18871379330/mydexhand/图片/yesplus.jpg

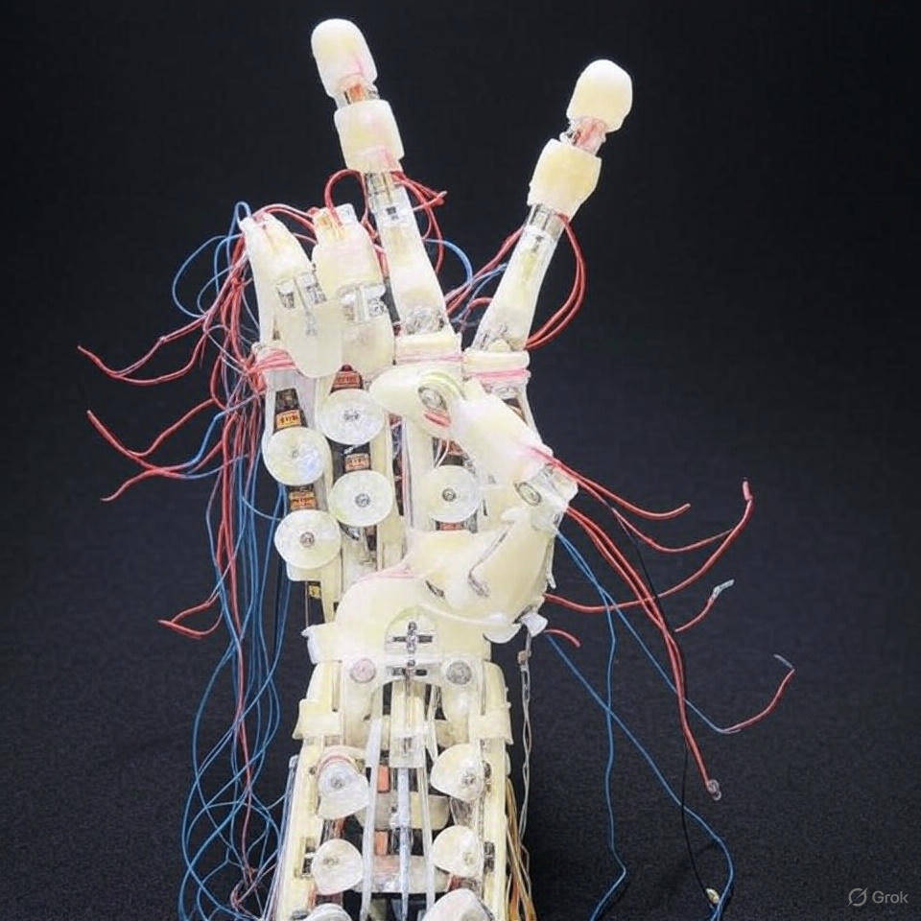
图片/yesplus.jpg
