18871379330/mydexhand/报销/毕设/1.24_螺母.pdf

# 电子发票（普通发票） 发票号码： 开票日期：

购
买
方
信
息

统一社会信用代码/纳税人识别号：

销
售
方
信
息

统一社会信用代码/纳税人识别号：

名称： | 名称：
项目名称 | 规格型号 | 单 位 | 数 量 | 单 价 | 金 额 | 税率/征收率 | 税 额
合 | 计
价税合计（大写） | 壹圆贰角肆分 ¥1.24 （小写）
备 注 | 4303056963364002740

开票人：

25322000000188732096

2025年04月26日

东南大学

12100000466006770Q

兴化市茂通金属制品有限公司

## 91321281MAE7RX1B27

¥1.23 | ¥0.01

陈怡彤

*金属制品*不锈钢螺母 M10对边
16mm【10
粒】304材质
件 | 1 | 1.23 | 1.23 | 1% | 0.01
