18871379330/mydexhand/报销/毕设/11.96_电线.pdf

# 电子发票（普通发票） 发票号码： 开票日期：

购
买
方
信
息

统一社会信用代码/纳税人识别号：

销
售
方
信
息

统一社会信用代码/纳税人识别号：

名称： | 名称：
项目名称 | 规格型号 | 单 位 | 数 量 | 单 价 | 金 额 | 税率/征收率 | 税 额
合 | 计
价税合计（大写） | 壹拾壹圆玖角陆分 ¥11.96 （小写）
备 注 | 收款人:黄晓如; 复核人:侯铠涛;

开票人：

25952000000064161759

2025年04月05日

东南大学

12100000466006770Q

深圳市福田区康威芯电子商行

## 92440300MA5ERA0T06

¥11.84 | ¥0.12

黄晓如

*电子元件*电子元件 20AWG 硅胶连
接线
件 | 2 5.9207920792079 | 11.84 | 1% | 0.12
