18871379330/mydexhand/报销/毕设/29_游标卡尺.pdf

# 电子发票（普通发票） 发票号码： 开票日期：

购
买
方
信
息

统一社会信用代码/纳税人识别号：

销
售
方
信
息

统一社会信用代码/纳税人识别号：

名称： | 名称：
项目名称 | 规格型号 | 单 位 | 数 量 | 单 价 | 金 额 | 税率/征收率 | 税 额
合 | 计
价税合计（大写） | 贰拾玖圆整 ¥29.00 （小写）

备 注

开票人：

25332000000143532861

2025年04月10日

东南大学

12100000466006770Q

义乌茂丰网络科技有限公 司

## 91330782MADURCG855

¥28.71 | ¥0.29

张静静

*金属制品 *五金工具 【省电保护
款】-不锈钢数
显卡尺0-150mm,
超速芯片）
套 | 1 28.7128712871287 | 28.71 | 1% | 0.29
