18871379330/mydexhand/报销/毕设/34.09_双面胶.pdf

# 电子发票（普通发票） 发票号码： 开票日期：

购
买
方
信
息

统一社会信用代码/纳税人识别号：

销
售
方
信
息

统一社会信用代码/纳税人识别号：

名称： | 名称：
项目名称 | 规格型号 | 单 位 | 数 量 | 单 价 | 金 额 | 税率/征收率 | 税 额
合 | 计
价税合计（大写） | 叁拾肆圆零玖分 ¥34.09 （小写）

备 注

开票人：

25312000000136466476

2025年05月06日

东南大学

12100000466006770Q

上海网涵电子科技有限公司

91310114342024109Y

¥30.17 | ¥3.92

丁敏兰

*密封用填料*双面胶 | 50MM*100MM | 片 | 10 3.016814159292 | 30.17 | 13% | 3.92
