18871379330/mydexhand/专利修改/专利图片.pptx

1-5

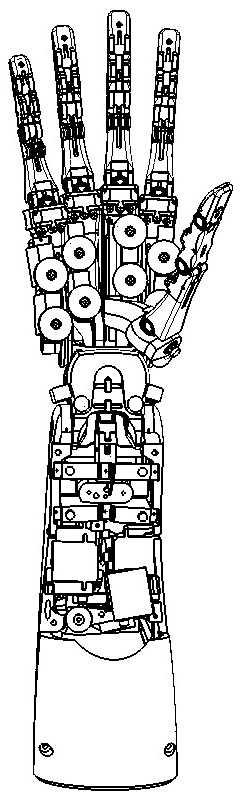
[picture p52: figure]
卡通人物 AI 生成的内容可能不正确。

1

2

3

5

4

## Slide 2

6-15

11

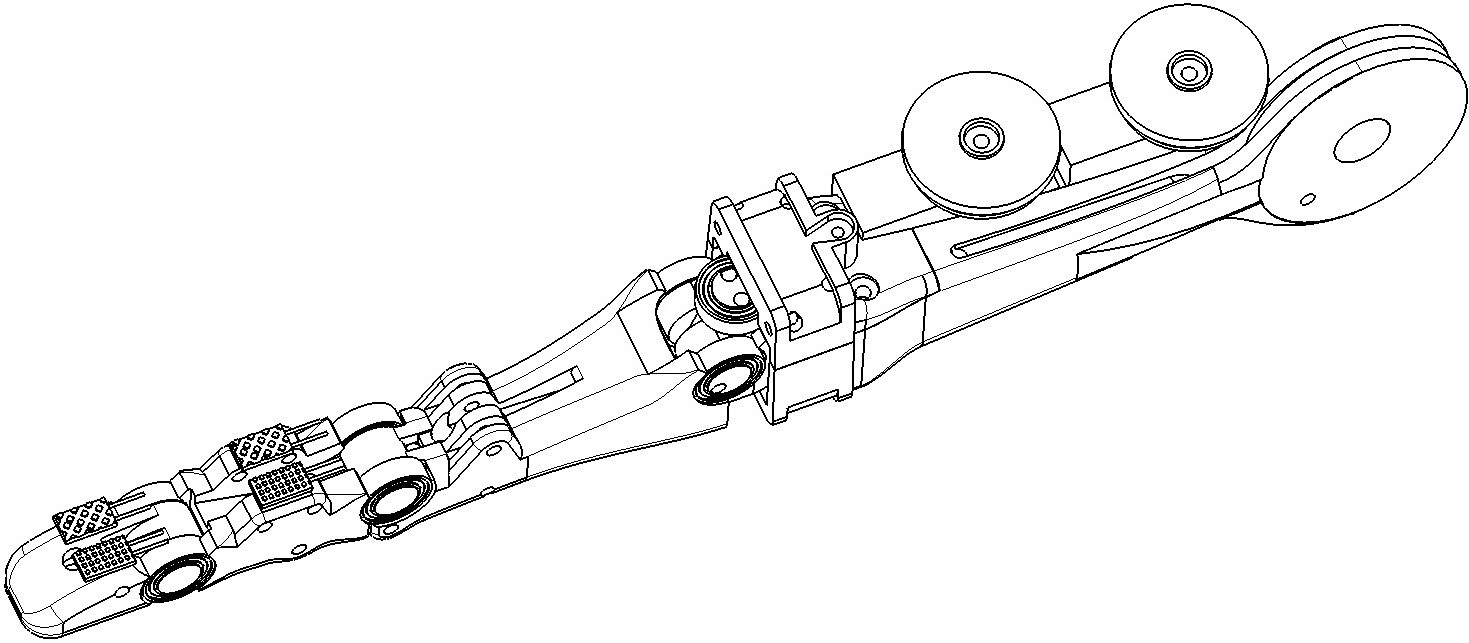
[picture p53: figure]
图示, 工程绘图 AI 生成的内容可能不正确。

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
## Slide 3

16-18

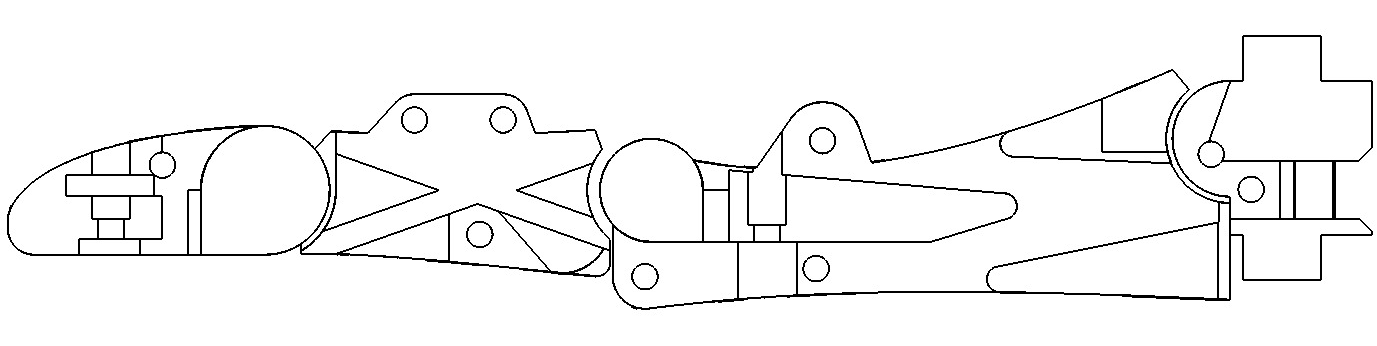
[picture p54: figure]
图示, 工程绘图 AI 生成的内容可能不正确。

16

17

18

## Slide 4

16

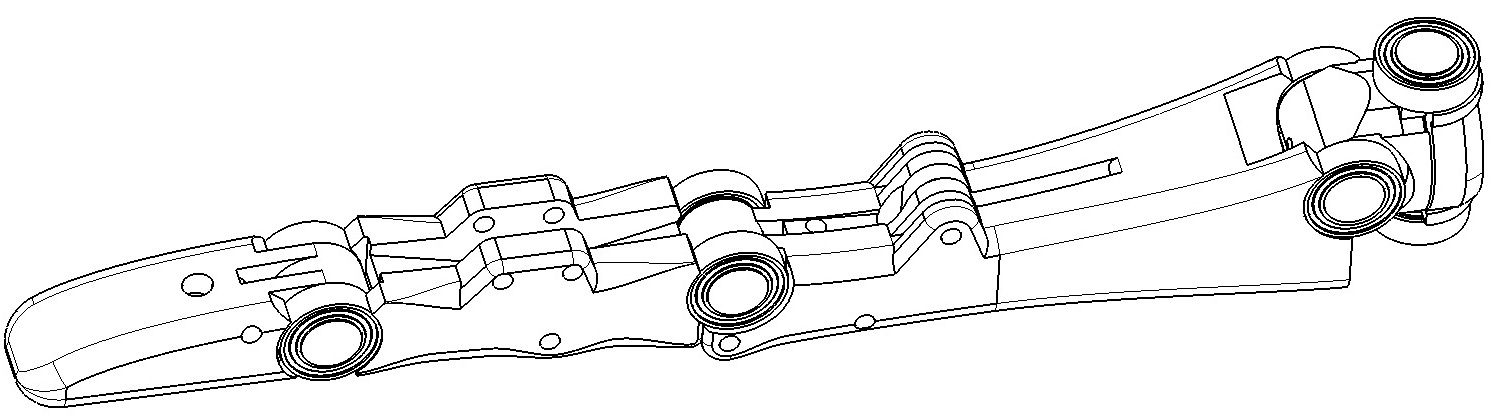
[picture p55: figure]
图示 AI 生成的内容可能不正确。

8

19

6

7

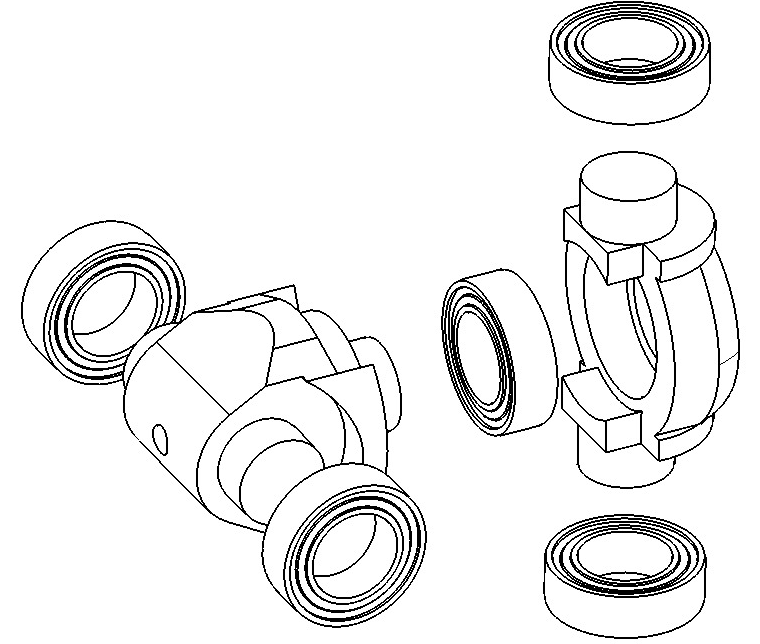
[picture p56: figure]
卡通人物 AI 生成的内容可能不正确。

20

21

## Slide 5

17

9

22

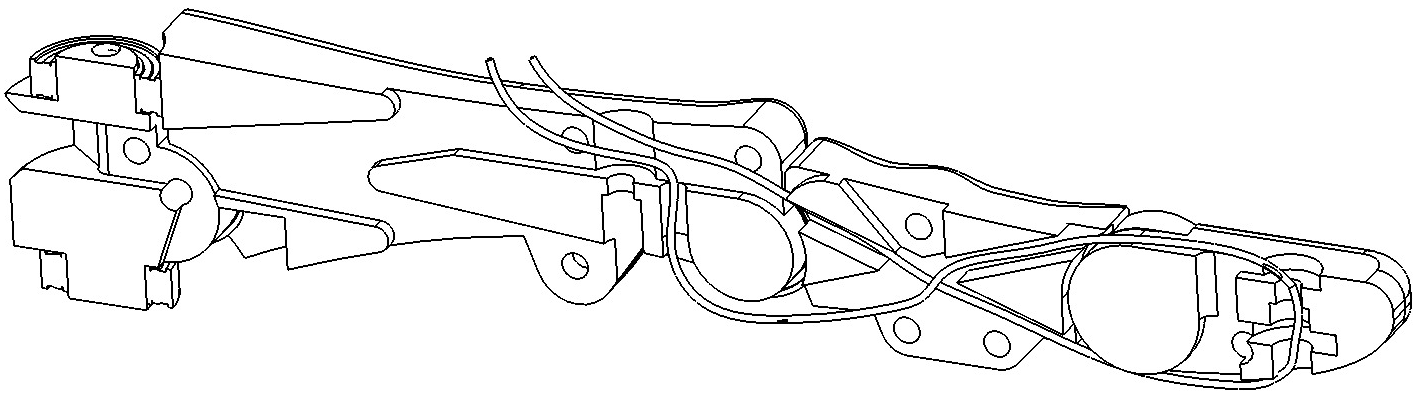
[picture p57: figure]
图示, 示意图 AI 生成的内容可能不正确。

8

7

6

八字绳固定处

## Slide 6

18-20

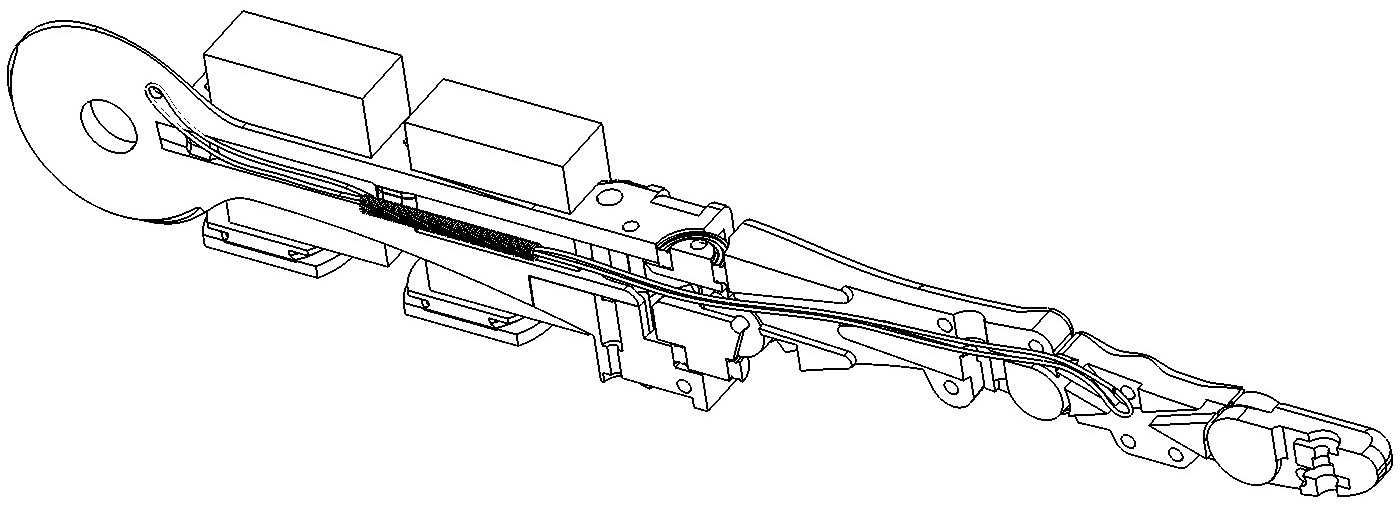
[picture p58: figure]
图示 AI 生成的内容可能不正确。

25

24

23

## Slide 7

21

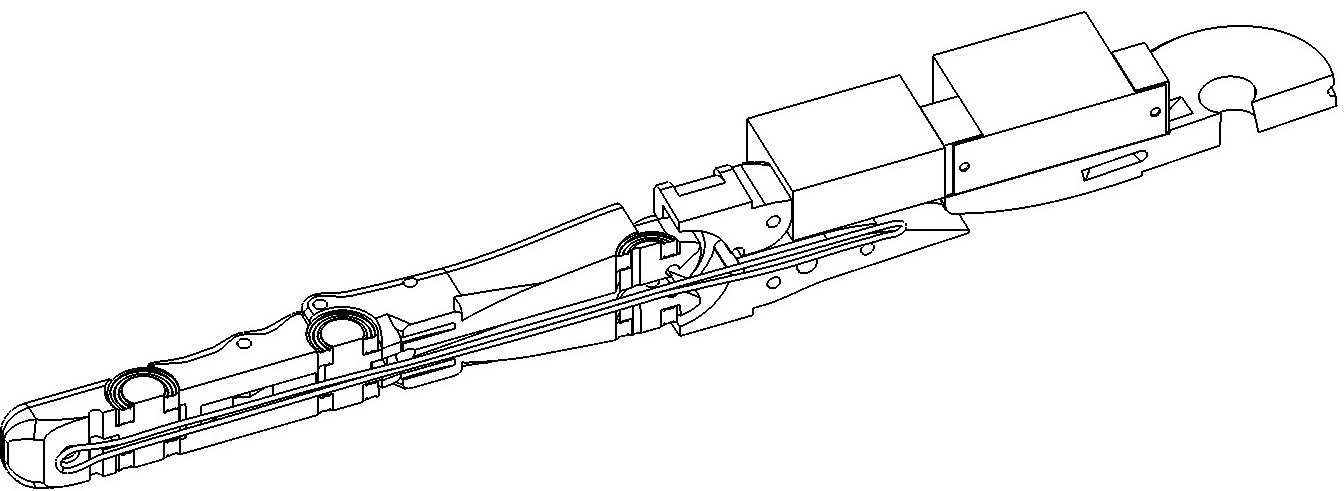
[picture p59: figure]
图示, 工程绘图 AI 生成的内容可能不正确。

26

舵机牵引

## Slide 8

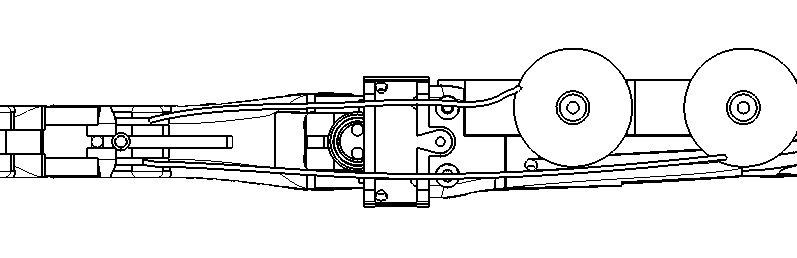
[picture p60: figure]
图示, 工程绘图 AI 生成的内容可能不正确。

27

## Slide 9

22-25

29

30

31

28

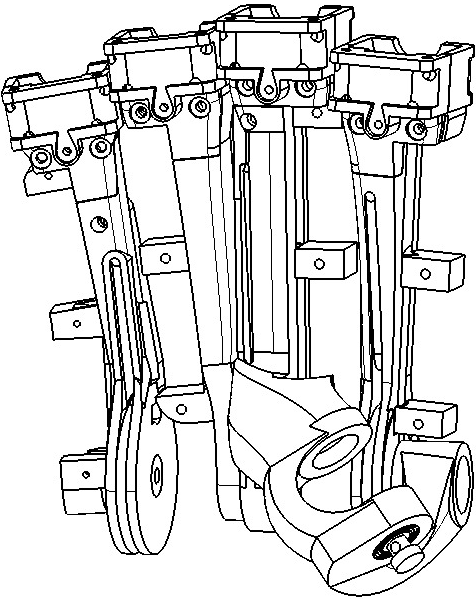
[picture p61: figure]
图示 AI 生成的内容可能不正确。

## Slide 10

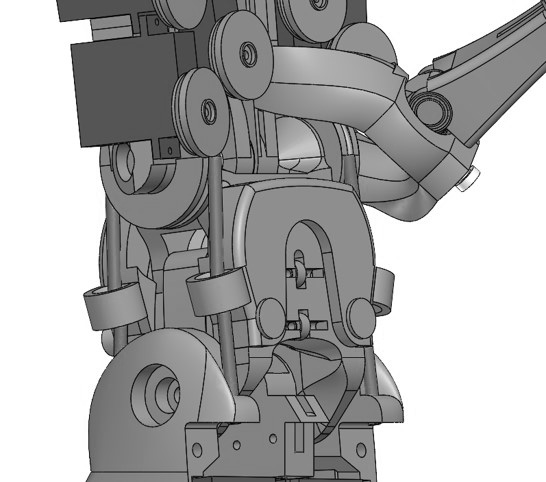
[picture p62: figure]
卡通人物 AI 生成的内容可能不正确。

32

## Slide 11

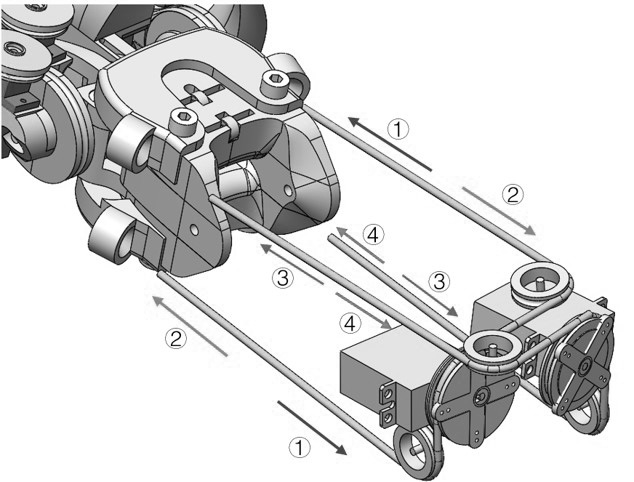
[picture p63: figure]
图示, 工程绘图 AI 生成的内容可能不正确。

32

## Slide 12

33

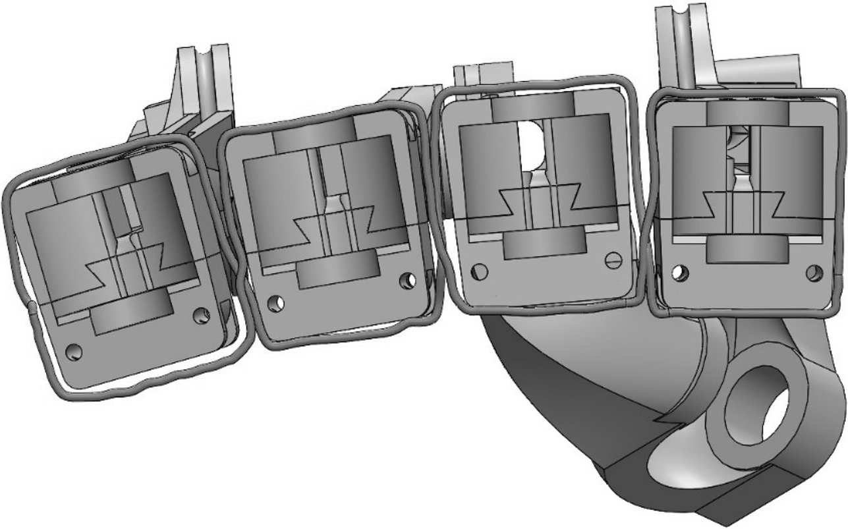
[picture p64: figure]
图片包含 游戏机, 棒球, 体育 AI 生成的内容可能不正确。

## Slide 13

26

34

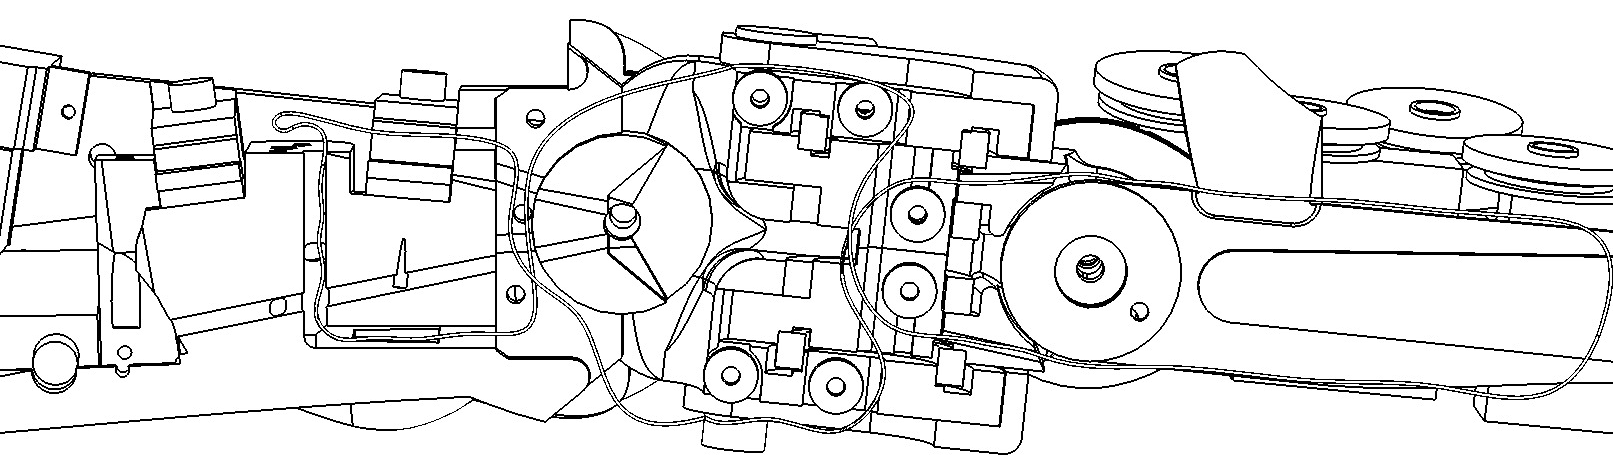
[picture p65: figure]
图示 AI 生成的内容可能不正确。

5

4

2

## Slide 14

27-29

35

35

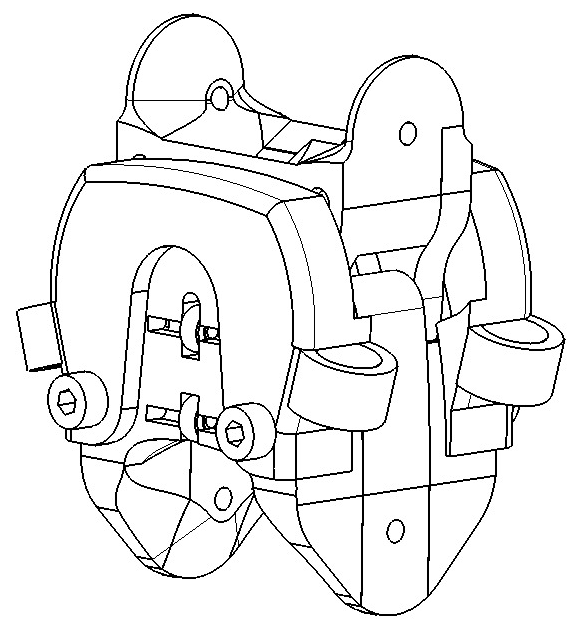
[picture p66: figure]
卡通人物 AI 生成的内容可能不正确。
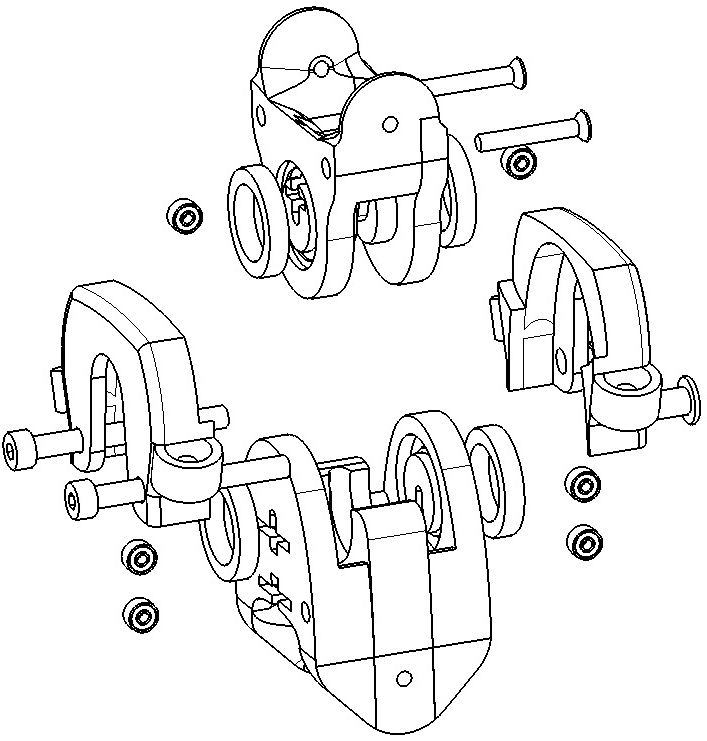
[picture p67: figure]
图示 AI 生成的内容可能不正确。

37

37

36

36

## Slide 15

30-32

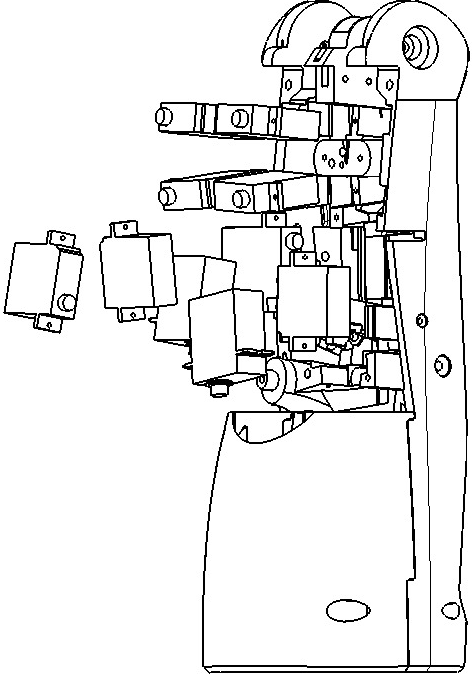
[picture p68: figure]
图示, 工程绘图 AI 生成的内容可能不正确。

38

39

40

## Slide 16

## Slide 17

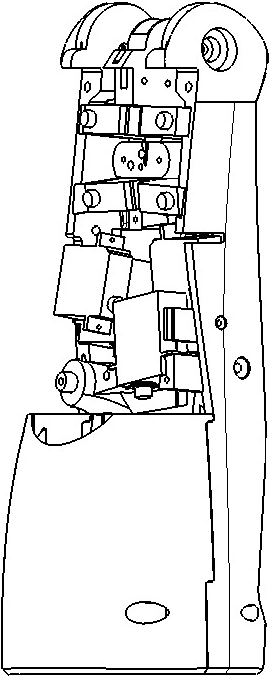
[picture p69: figure]
图示, 工程绘图 AI 生成的内容可能不正确。

## Slide 18

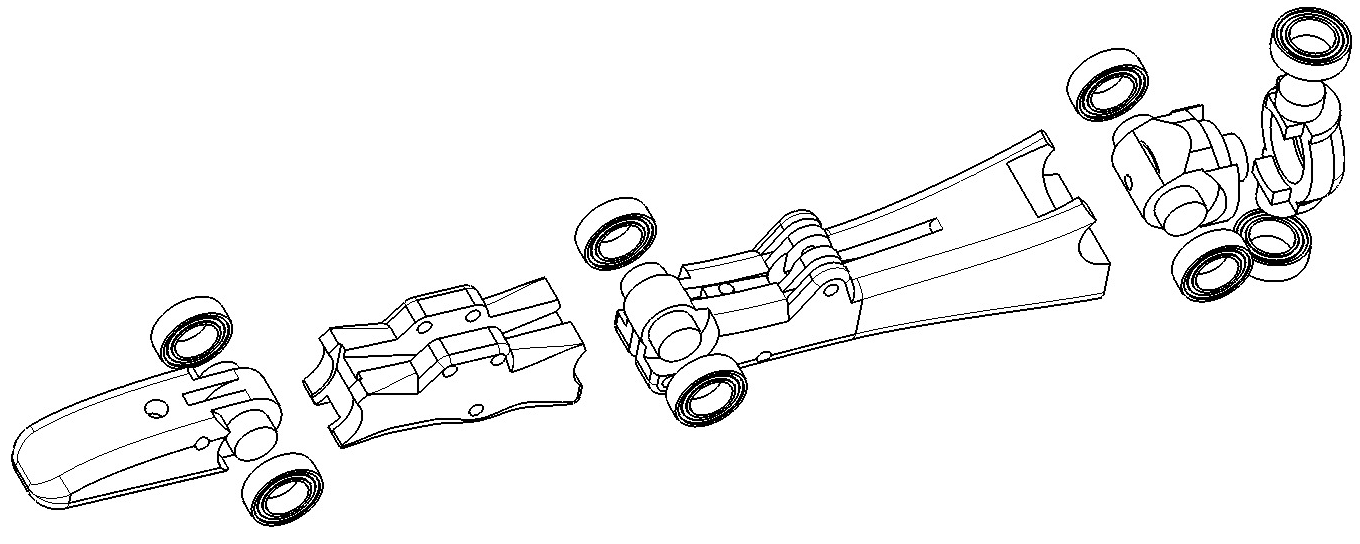
[picture p70: figure]
图示 AI 生成的内容可能不正确。

## Slide 19

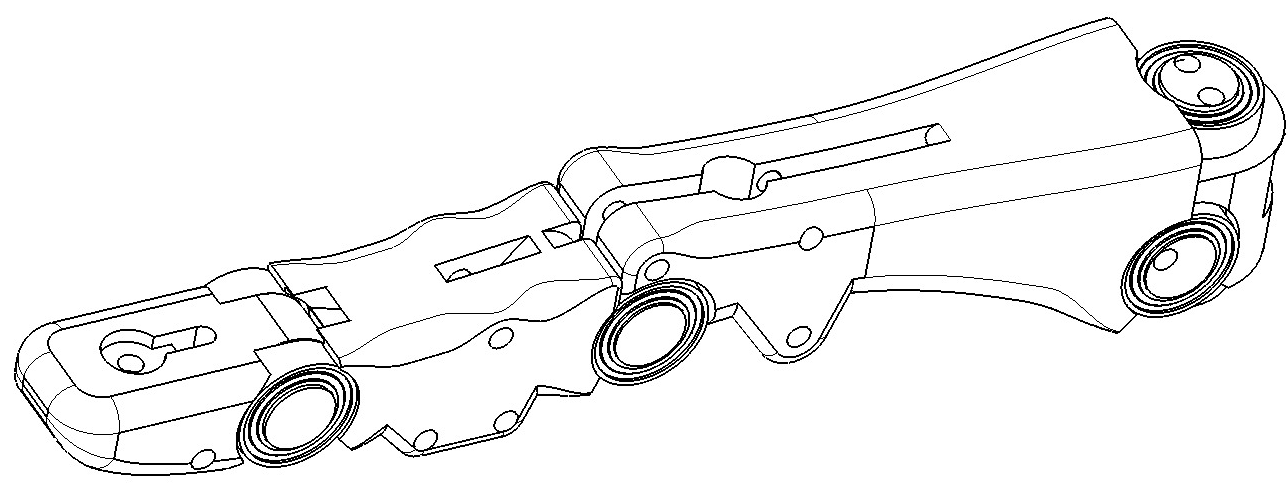
[picture p71: figure]
图片包含 链, 游戏机, 项链, 画 AI 生成的内容可能不正确。

## Slide 20

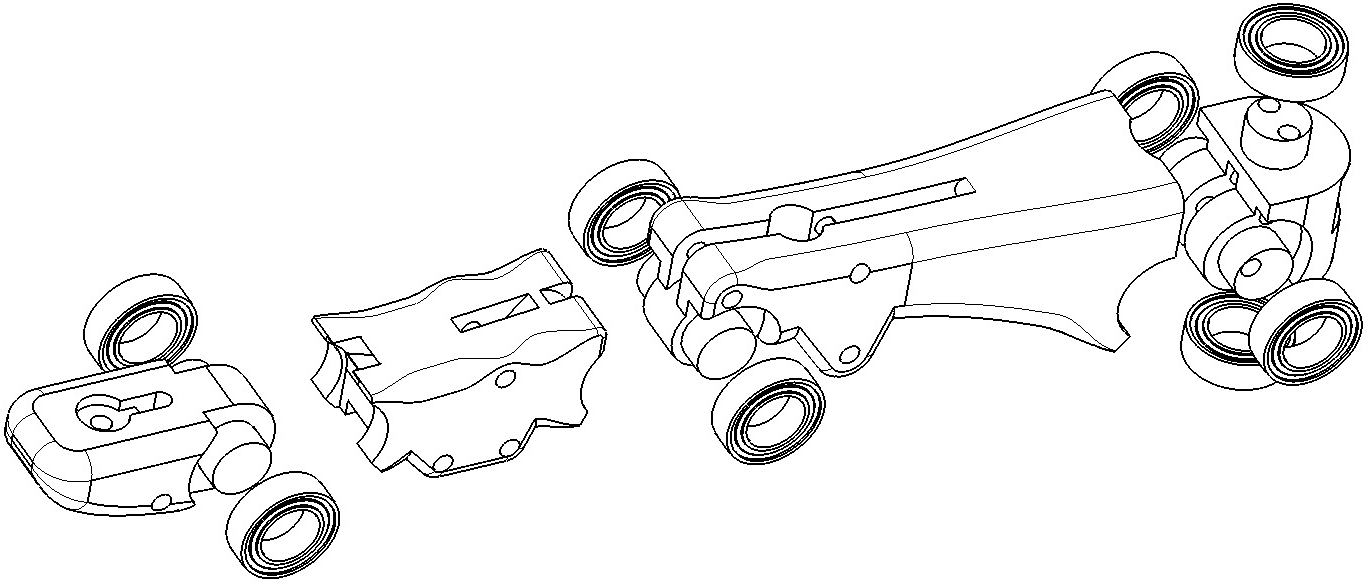
[picture p72: figure]
图示 AI 生成的内容可能不正确。

## Slide 21

## Slide 22

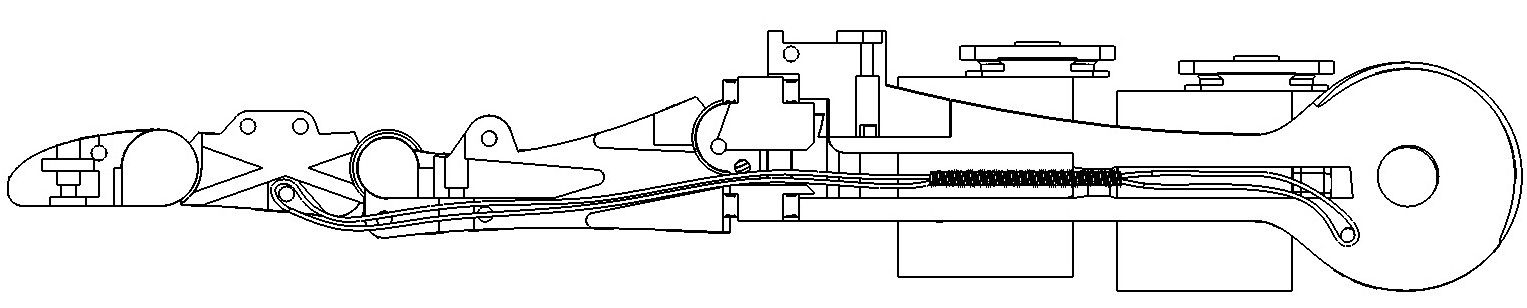
[picture p73: figure]
图示, 工程绘图 AI 生成的内容可能不正确。

18

19

20

## Slide 23

10

13

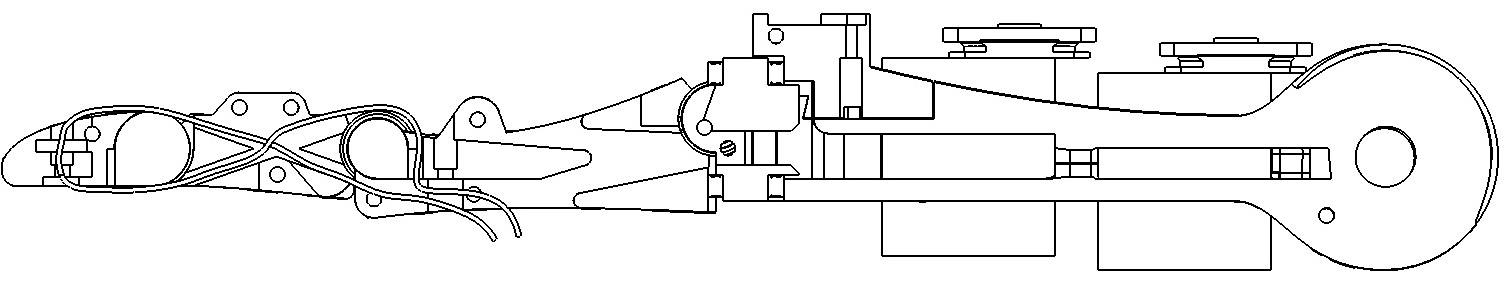
[picture p74: figure]
图示 AI 生成的内容可能不正确。

6

7

8

9

17

11
