18871379330/mydexhand/精雕杯/附件2：毕业设计案例参考格式.docx

毕业设计大赛案例参考格式

页面设置标准A4纸，页边距上下各4cm，左右各3cm，所有数字及英文用Times New Roman字体。文中表题用小5号黑体居中排列，表格内容用小5号宋体，图题用小5号体居中排列，其它标注小5号宋体。其余格式参照下页模板。

作品名称 （段前空1行，左对齐，3号方正小标宋_GBK，字符间距加宽1磅）

作者姓名 （小5号方正仿宋_GBK，段前空1行）

单位 专业 （小5号方正仿宋_GBK）

1. 设计目的 （首行缩进2个字符，段前段后0.25行，13号方正黑体_GBK）

正文*****（首行空2个字符 ，5号宋体）

2. 基本原理及方法

正文****

3. 主要设计过程或试验过程

正文****

1）分层注射模具的设计与分析 （首行缩进2个字符，5号方正楷体_GBK加粗）

4. 结论

5. 创新点

6. 设计图或作品实物图

高校指导教师： 企业指导教师：*** （段前空2行，5号方正楷体_GBK）

参考案例：

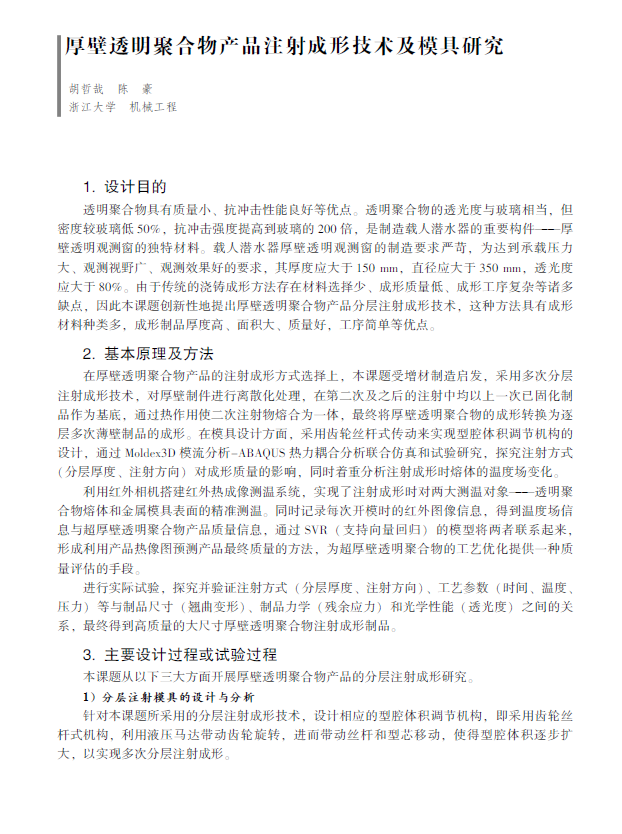
[picture p76: figure]
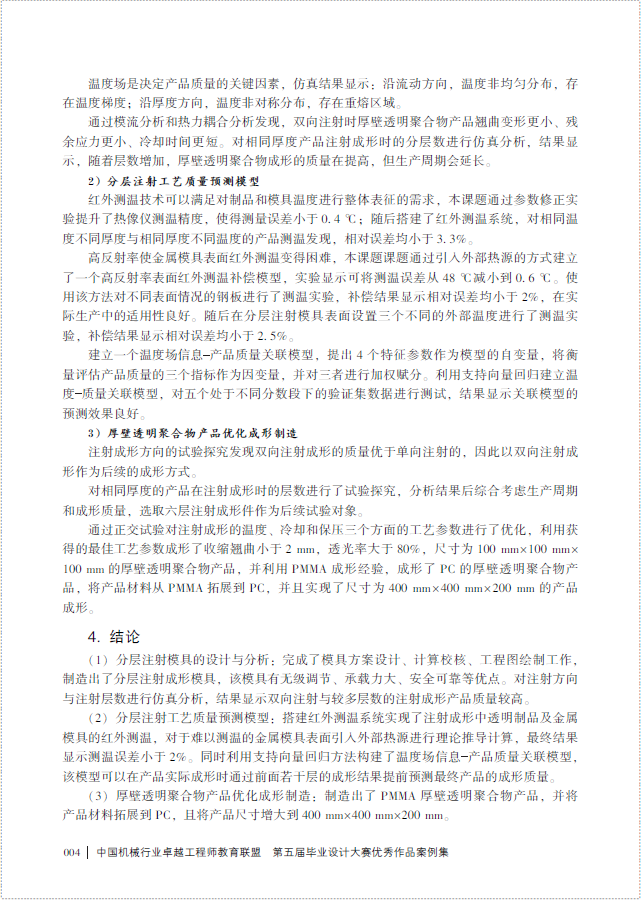
[picture p77: figure]
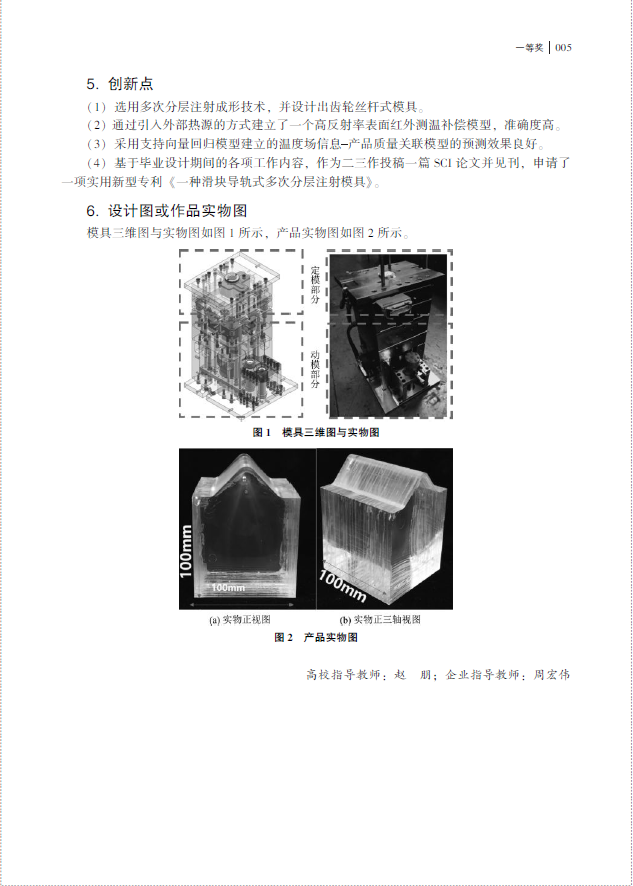
[picture p78: figure]
