18871379330/mydexhand/图片/PPT图片/PPT图片.pptx

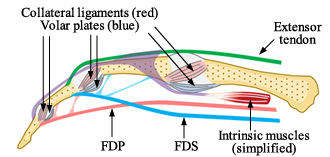
[picture p79: figure]
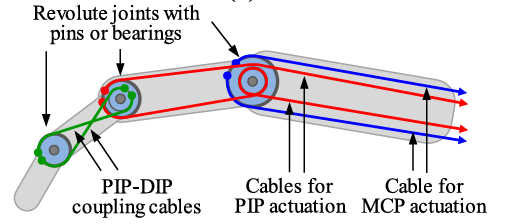
[picture p80: figure]

## Slide 2

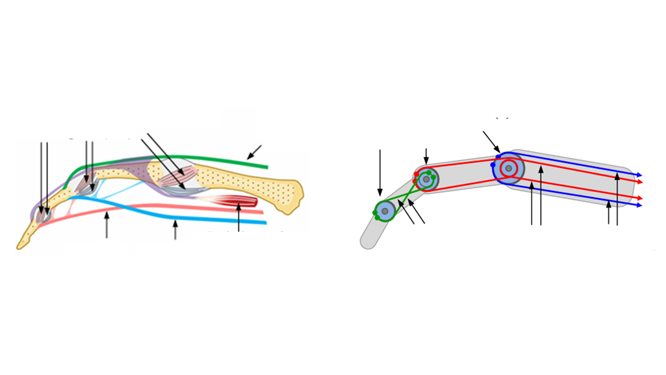
[picture p81: figure]
图示 AI 生成的内容可能不正确。

副韧带（红色）
掌板（蓝色）

深指屈肌腱

浅指屈肌腱

内在肌

## Slide 3

紧固处

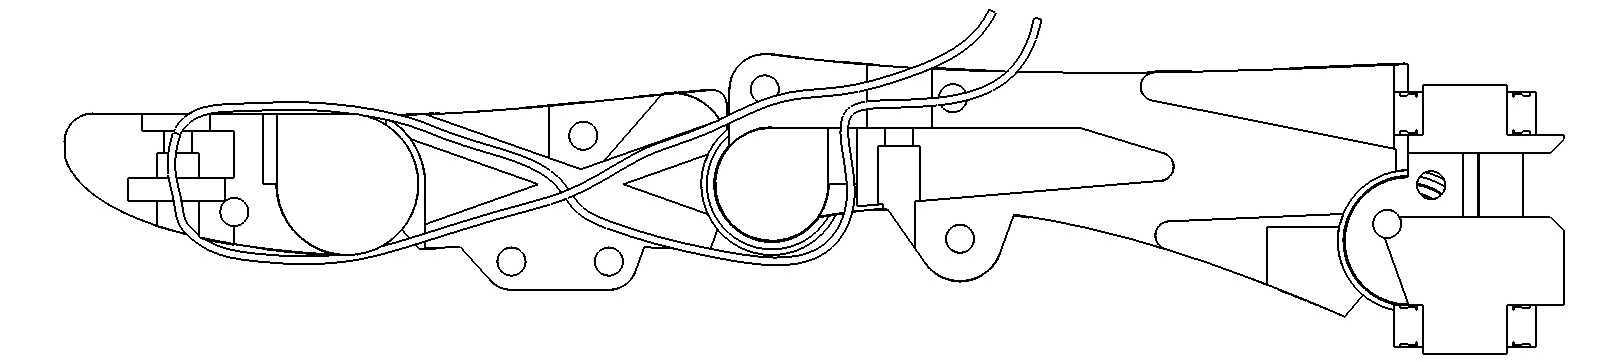
[picture p82: figure]
图示, 示意图 AI 生成的内容可能不正确。

八字绳结构

## Slide 4

回弹牵引绳

回复弹簧

弹簧固定绳

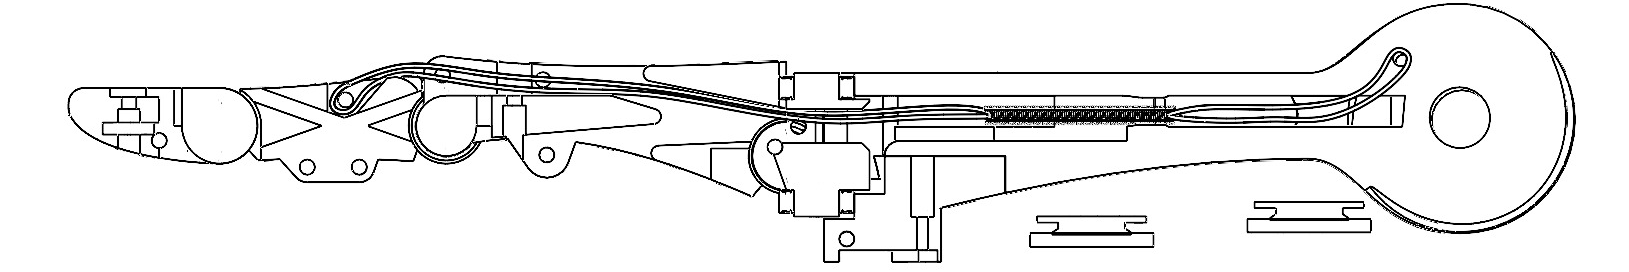
[picture p83: figure]
图示 AI 生成的内容可能不正确。

## Slide 5

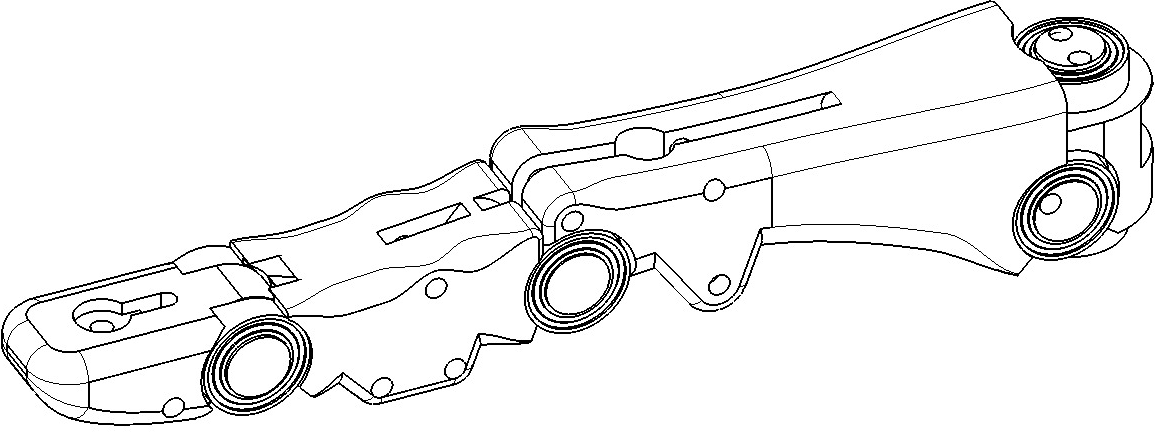
[picture p84: figure]
地图上有字 AI 生成的内容可能不正确。
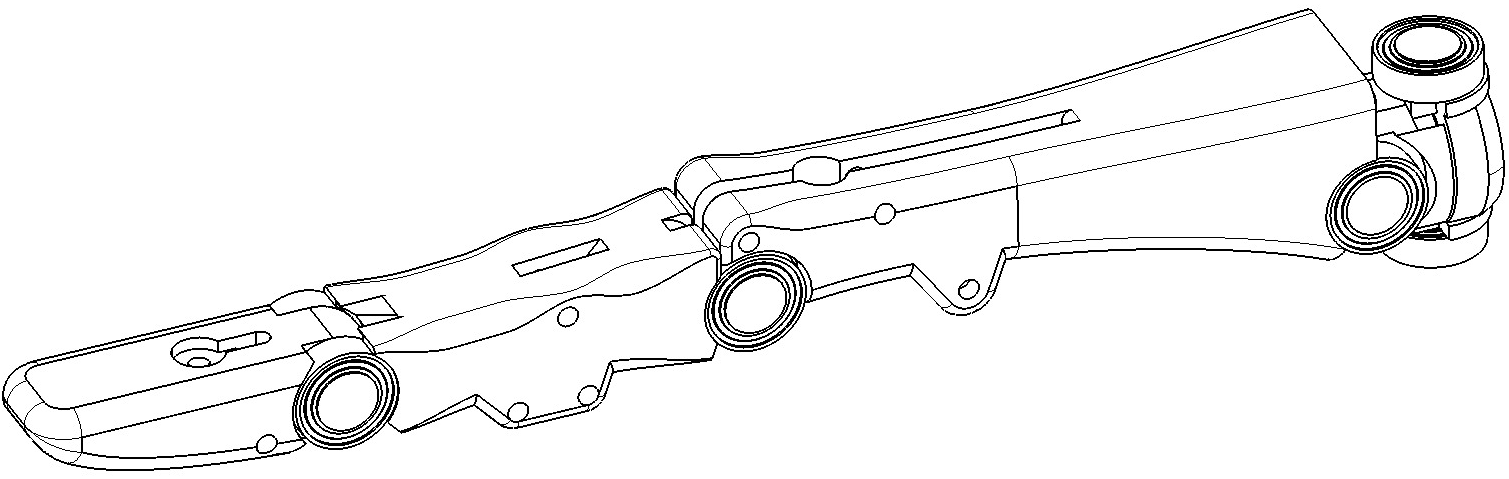
[picture p85: figure]
图片包含 游戏机, 画, 项链 AI 生成的内容可能不正确。
