18871379330/mydexhand/报销/毕设/23_控制板.pdf

# 电子发票（普通发票） 发票号码： 开票日期：

购
买
方
信
息

统一社会信用代码/纳税人识别号：

销
售
方
信
息

统一社会信用代码/纳税人识别号：

名称： | 名称：
项目名称 | 规格型号 | 单 位 | 数 量 | 单 价 | 金 额 | 税率/征收率 | 税 额
合 | 计
价税合计（大写） | 贰拾叁圆整 ¥23.00 （小写）

备 注

开票人：

25332000000243384010

2025年06月09日

东南大学

12100000466006770Q

杭州海灵智电科技有限公司

91330108341871453L

¥22.77 | ¥0.23

王彬

*电子元件*转接板 | ZJB | 个 | 1 22.7722772277228 | 22.77 | 1% | 0.23
