18871379330/mydexhand/报销/毕设/39.93_u盘.pdf

# 电子发票（普通发票） 发票号码： 开票日期：

购
买
方
信
息

统一社会信用代码/纳税人识别号：

销
售
方
信
息

统一社会信用代码/纳税人识别号：

名称： | 名称：
项目名称 | 规格型号 | 单 位 | 数 量 | 单 价 | 金 额 | 税率/征收率 | 税 额
合 | 计
价税合计（大写） | 叁拾玖圆玖角叁分 ¥39.93 （小写）

备 注

开票人：

25952000000113492015

2025年06月07日

东南大学

12100000466006770Q

深圳市诚品源电子科技有限公司

91440300311865044G

¥35.34 | ¥4.59

彭鸿旋

*计算机外部设备*U盘 | 个 | 1 35.3362831858407 | 35.34 | 13% | 4.59
