18871379330/mydexhand/报销/毕设/78_舵机控制.pdf

# 电子发票（普通发票） 发票号码： 开票日期：

购
买
方
信
息

统一社会信用代码/纳税人识别号：

销
售
方
信
息

统一社会信用代码/纳税人识别号：

名称： | 名称：
项目名称 | 规格型号 | 单 位 | 数 量 | 单 价 | 金 额 | 税率/征收率 | 税 额
合 | 计
价税合计（大写） | 柒拾捌圆整 ¥78.00 （小写）
备 注 | 销售方地址:杭州市余杭区荆长路100号西溪玫瑰园庄诺丁苑3-3号; 电话:18668125390; 销方开户银行:杭州联合农村商业银行股份有限公司长河支行; 银行账号:201000138156963;

开票人：

25332000000237649868

2025年06月05日

东南大学

12100000466006770Q

杭州众灵科技有限公司

91330108341826521E

¥77.23 | ¥0.77

邹立伟

*其他机械设备*机器人控
制器
16路舵机控制器 | 件 | 1 77.2277227722772 | 77.23 | 1% | 0.77
