18871379330/mydexhand/毕业材料/自查文件/答辩小组意见表.pdf

## 东南大学本科毕业设计（论文）答辩小组意见表

学号 | 02021105 | 姓名 | 陈化扬 | 学院 | 机械工 程学院 | 专业 | 机 械 工 程
课题 | 电机驱动的多自由度五指灵巧手设计与开发

1、 总体评价

陈化扬同学的“电机驱动的多自由度五指灵巧手设计与开发”毕设论文，较好地完成了

任务书规定的要求，论文与软硬件的质量良好，论文内容的讲述较清晰，回答问题较

正确。

2、主要创新点（如无创新点，本项可不填）

3、答辩小组教师评分

84

4、是否通过答辩 √ 通过 | □未通过
答辩小组负责人签名： | , | ,

,

2025 年 6 月 5 日
