18871379330/mydexhand/毕业材料/自查文件/陈化扬_02021105_毕业论文（设计）开题报告.pdf

# 本科毕业设计（论文）开题报告

指导教师意见：
该毕业设计课题背景调研充分，研究内容和方案详实，逻辑合理，切实可行。同意开题。
签名： | 2025 年 2 月 23 日
开题审查小组意见：
针对五指灵巧手开展研究，报告结构基本完整，文献综述全面，框架合理，目标明确，具 备可行性。
签名： | , | , | 2025 年 3 月 3 日
