18871379330/mydexhand/报销/毕设/1.66_铆钉螺丝.pdf

# 电子发票（普通发票） 发票号码： 开票日期：

购
买
方
信
息

统一社会信用代码/纳税人识别号：

销
售
方
信
息

统一社会信用代码/纳税人识别号：

名称： | 名称：
项目名称 | 规格型号 | 单 位 | 数 量 | 单 价 | 金 额 | 税率/征收率 | 税 额
合 | 计
价税合计（大写） | 壹圆陆角陆分 ¥1.66 （小写）
备 注 | 4254452245846002740

开票人：

25322000000114858443

2025年03月16日

东南大学

12100000466006770Q

东台贝永金属制品经营部（个体工商户）

## 92320981MAD8GCC041

¥1.64 | ¥0.02

陈怡彤

*金属制品*螺丝 | Φ5*4-20套 | 件 | 1 | 1.64 | 1.64 | 1% | 0.02
