18871379330/mydexhand/报销/毕设/108.48_应变片.pdf

# 电子发票（普通发票） 发票号码： 开票日期：

购
买
方
信
息

统一社会信用代码/纳税人识别号：

销
售
方
信
息

统一社会信用代码/纳税人识别号：

名称： | 名称：
项目名称 | 规格型号 | 单 位 | 数 量 | 单 价 | 金 额 | 税率/征收率 | 税 额
合 | 计
价税合计（大写） | 壹佰零捌圆肆角捌分 ¥108.48 （小写）

备 注

开票人：

25952000000083296380

2025年04月29日

东南大学

12100000466006770Q

深圳市零度电子科技有限 公司

914403003598372375

¥107.41 | ¥1.07

苏东洪

*电子元 件*传感器 | 120-3AA-D100带
引线应变片
个 | 20 5.370297029703 | 107.41 | 1% | 1.07
