18871379330/mydexhand/报销/毕设/10_管子.pdf

# 电子发票（普通发票） 发票号码： 开票日期：

购
买
方
信
息

统一社会信用代码/纳税人识别号：

销
售
方
信
息

统一社会信用代码/纳税人识别号：

名称： | 名称：
项目名称 | 规格型号 | 单 位 | 数 量 | 单 价 | 金 额 | 税率/征收率 | 税 额
合 | 计
价税合计（大写） | 壹拾圆整 ¥10.00 （小写）

备 注

开票人：

25322000000163580520

2025年04月12日

东南大学

12100000466006770Q

兴化市上减减压阀经营部

## 92321281MACB7YGCXP

¥9.90 | ¥0.10

陈明忠

*塑料制品*管子 | 米 | 5 1.980198019802 | 9.90 | 1% | 0.10
