18871379330/mydexhand/报销/毕设/11_弹簧.pdf

# 电子发票（普通发票） 发票号码： 开票日期：

购
买
方
信
息

统一社会信用代码/纳税人识别号：

销
售
方
信
息

统一社会信用代码/纳税人识别号：

名称： | 名称：
项目名称 | 规格型号 | 单 位 | 数 量 | 单 价 | 金 额 | 税率/征收率 | 税 额
合 | 计
价税合计（大写） | 壹 拾壹 圆整 ¥11.00 （小写）

备 注

开票人：

25952000000068024767

2025年04月 10日

东南大学

12100000466006770Q

深圳市宝安区沙井鼎力泰五金经营部

92440300L49380473B

¥10.89 | ¥0.11

张曼勇

*金属制品*小 弹簧现货拉
簧带钩定制强 力拉伸平板
车不锈钢烤 箱拖把镀锌拉
簧簧
0.4*2*300钢2个 | 个 | 2 | 5.44554455 | 10.89 | 1% | 0.11
