18871379330/mydexhand/报销/毕设/11_轴承.pdf

# 电子发票（普通发票） 发票号码： 开票日期：

购
买
方
信
息

统一社会信用代码/纳税人识别号：

销
售
方
信
息

统一社会信用代码/纳税人识别号：

名称： | 名称：
项目名称 | 规格型号 | 单 位 | 数 量 | 单 价 | 金 额 | 税率/征收率 | 税 额
合 | 计
价税合计（大写） | 壹拾壹圆整 ¥11.00 （小写）

备 注

开票人：

25312000000070194433

2025年03月08日

东南大学

12100000466006770Q

上海琰轴精工轴承有限公司

## 91310120MADWXYPF4K

¥10.89 | ¥0.11

闫诗多

*轴承*轴承 | 6*10*3=10只 | 件 | 1 | 10.89 | 10.89 | 1% | 0.11
