18871379330/mydexhand/报销/毕设/13.5_打胶器.pdf

销
售
方
信
息

统一社会信用代码/纳税人识别号：

购 名称：
买
方
信
息

统一社会信用代码/纳税人识别号：

名称：

25322000000207497516

2025年05月08日

东南大学

12100000466006770Q

苏州市领跑者新材料科技有限公司

## 91320508MA1NP9KQ07

项目名称 | 规格型号 | 单 位 | 数 量 | 单 价 | 金 额 | 税率/征收率 | 税 | 额
*密封用填料*胶水 | 玻璃胶枪 | 支 | 1 11.9469026548673 | 11.95 | 13% | 1.55
价税合计（大写） | 壹拾叁圆伍角整 （小写） ¥13.50
备 注 | 4318701878861002740
合 | 计

开票人：

常佳雯

¥11.95 | ¥1.55
