18871379330/mydexhand/报销/毕设/133.0_3D打印.pdf

# 电⼦发票（普通发票）

项目名称 | 规格型号 | 单 位 | 数 量 | 单 价 | 金 额 | 税率/征收率 | 税 额

发票号码：

开票日期：

购
买
方
信
息 | 统一社会信用代码/纳税人识别号：
名称： | 销
售
方
信
息 统一社会信用代码/纳税人识别号：

名称：

下载次数：1

合 | 计
价税合计（大写） | 壹佰叁拾叁圆整 ¥ 133.00 （小写）
备 注 | 94541781

开票人：

国家税务总局 全 国 统一发 票 监 制章

深 圳市税务局

¥117.70 | ¥15.30

王佳楠

25952000000043704409

2025年03月10日

东南大学 | 深圳市未来工场科技有限公司
12100000466006770Q | 914403003194126805 共1页 第1页
*塑料制品*3D打印产品 | 件 | 15 7.8466076725664 | 117.70 | 13% | 15.30
