18871379330/mydexhand/报销/毕设/15.5_镊子.pdf

# 电子发票（普通发票） 发票号码： 开票日期：

购
买
方
信
息

统一社会信用代码/纳税人识别号：

销
售
方
信
息

统一社会信用代码/纳税人识别号：

名称： | 名称：
项目名称 | 规格型号 | 单 位 | 数 量 | 单 价 | 金 额 | 税率/征收率 | 税 额
合 | 计
价税合计（大写） | 壹拾伍圆伍角整 ¥15.50 （小写）

备 注

开票人：

25932000000030958531

2025年04月13日

东南大学

12100000466006770Q

宁波市定业电子商务有限公司

## 91330205MA2AGLG22F

¥13.72 | ¥1.78

黄娜

*金属制品*镊子 | 个 | 1 | 13.72 | 13.72 | 13% | 1.78
