18871379330/mydexhand/报销/毕设/15.84_保鲜膜.pdf

# 电子发票（普通发票） 发票号码： 开票日期：

购
买
方
信
息

统一社会信用代码/纳税人识别号：

销
售
方
信
息

统一社会信用代码/纳税人识别号：

名称： | 名称：
项目名称 | 规格型号 | 单 位 | 数 量 | 单 价 | 金 额 | 税率/征收率 | 税 额
合 | 计
价税合计（大写） | 壹拾伍圆捌角肆分 ¥15.84 （小写）

备 注

开票人：

25442000000248300263

2025年04月30日

东南大学

12100000466006770Q

东莞市大岭山九久贸易商行（个体工商户）

## 92441900MAE94BDQ8H

¥15.68 | ¥0.16

谭保凯

*塑料制品*保鲜膜 | 10*10 | 卷 | 1 15.6831683168317 | 15.68 | 1% | 0.16
