18871379330/mydexhand/报销/毕设/16.5_手捻钻.pdf

# 电子发票（普通发票） 发票号码： 开票日期：

购
买
方
信
息

统一社会信用代码/纳税人识别号：

销
售
方
信
息

统一社会信用代码/纳税人识别号：

名称： | 名称：
项目名称 | 规格型号 | 单 位 | 数 量 | 单 价 | 金 额 | 税率/征收率 | 税 额
合 | 计
价税合计（大写） | 壹拾陆圆伍角整 ¥16.50 （小写）

备 注

开票人：

25232000000025012716

2025年05月04日

东南大学

12100000466006770Q

尚志市龙晟百货网店

## 92230183MA7BTJY65W

¥16.34 | ¥0.16

杨鹏坤

*日用杂品*其他日用杂
品 | 手捻钻
件 | 1 16.3366336633663 | 16.34 | 1% | 0.16
