18871379330/mydexhand/报销/毕设/16_.pdf

# 电子发票（普通发票） 发票号码： 开票日期：

购
买
方
信
息

统一社会信用代码/纳税人识别号：

销
售
方
信
息

统一社会信用代码/纳税人识别号：

名称： | 名称：
项目名称 | 规格型号 | 单 位 | 数 量 | 单 价 | 金 额 | 税率/征收率 | 税 额
合 | 计
价税合计（大写） | 壹拾陆圆整 ¥16.00 （小写）
备 注 | 收款人:杜方超; 复核人:何杰;

开票人：

25422000000063632646

2025年04月10日

东南大学

12100000466006770Q

利川市鑫溢五金工具店

## 92422802MA7MDA075T

¥15.84 | ¥0.16

唐铭泽

*金属制品*批头 | 4mm六角 | 卷 | 8 1.980198019802 | 15.84 | 1% | 0.16
