18871379330/mydexhand/报销/毕设/188_电脑系统安装.pdf

销
售
方
信
息

统一社会信用代码/纳税人识别号：

购 名称：
买
方
信
息

统一社会信用代码/纳税人识别号：

名称：

25442000000080043788

2025年02月14日

东南大学

12100000466006770Q

广州羽佳文化传媒有限公司

## 91440112MAE9JW3270

项目名称 | 规格型号 | 单 位 | 数 量 | 单 价 | 金 额 | 税率/征收率 | 税 | 额
*软件*windos | 1 186.138613861386 | 186.14 | 1% | 1.86
价税合计（大写） | 壹佰捌拾捌圆整 （小写） ¥188.00

备 注

合 | 计

开票人：

郭晨杰

¥186.14 | ¥1.86
