18871379330/mydexhand/报销/毕设/20.3_labview书.pdf

# 电子发票（普通发票） 发票号码： 开票日期：

购
买
方
信
息

统一社会信用代码/纳税人识别号：

销
售
方
信
息

统一社会信用代码/纳税人识别号：

名称： | 名称：
项目名称 | 规格型号 | 单 位 | 数 量 | 单 价 | 金 额 | 税率/征收率 | 税 额
合 | 计
价税合计（大写） | 贰拾圆叁角整 ¥20.30 （小写）

备 注

开票人：

25432000000058645419

2025年05月07日

东南大学

12100000466006770Q

湖南小谷吖科技有限公司

## 91430104MA4Q4Q8X1E

¥20.30 | ***

邓秀佩

*印刷品*图书 | 中文版
LabVIEW2020从
入门到精通(实
战案例版
本 | 1 | 20.3 | 20.30 | 免税 | ***
