18871379330/mydexhand/报销/毕设/20.6_工具包.pdf

购
买
方
信
息

统一社会信用代码/纳税人识别号：

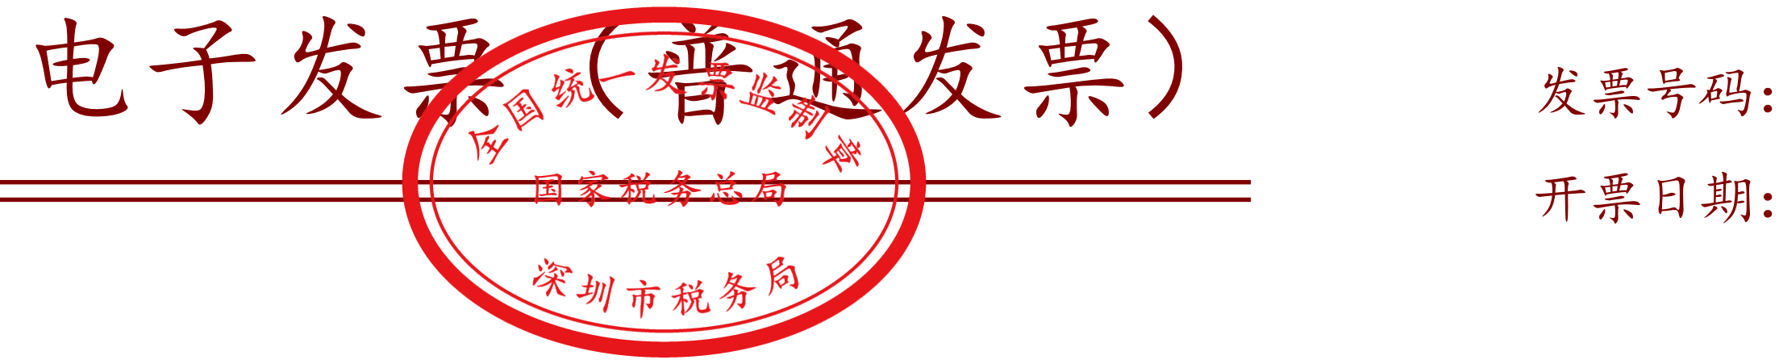
[picture p88: figure]
电子发票（普通发票）; 发票号码：; 开票日期：

销
售
方
信
息

统一社会信用代码/纳税人识别号：

名称： | 名称：
项目名称 | 规格型号 | 单 位 | 数 量 | 单 价 | 金 额 | 税率/征收率 | 税 额
合 | 计
价税合计（大写） | 贰拾圆陆角整 （小写） ¥20.60
备 注 | 订单：4285255538731002740

开票人：

下
载
次
数：1

25952000000068326723

2025年04月11日

东南大学

12100000466006770Q

深圳市光正五金总汇有限公司

91440300334930064G

*金属制品*工具包 | 18寸 | 个 | 1 | 18.23 | 18.23 | 13% | 2.37
¥18.23 | ¥2.37

吴思祯
