18871379330/mydexhand/报销/毕设/230_3D打印.pdf

# 电⼦发票（普通发票）

项目名称 | 规格型号 | 单 位 | 数 量 | 单 价 | 金 额 | 税率/征收率 | 税 额

发票号码：

开票日期：

购
买
方
信
息 | 统一社会信用代码/纳税人识别号：
名称： | 销
售
方
信
息 统一社会信用代码/纳税人识别号：

名称：

下载次数：1

合 | 计
价税合计（大写） | 贰佰叁拾圆整 ¥ 230.00 （小写）
备 注 | 94703656

开票人：

国家税务总局 全 国 统一发 票 监 制章

深 圳市税务局

¥203.54 | ¥26.46

王佳楠

25952000000079011143

2025年04月24日

东南大学 | 深圳市未来工场科技有限公司
12100000466006770Q | 914403003194126805
*塑料制品*3D打印产品 | 件 | 101.769911504425 | 203.54 | 13% | 26.46
