18871379330/mydexhand/报销/毕设/266_手腕PWM舵机.pdf

# 电子发票（普通发票） 发票号码： 开票日期：

购
买
方
信
息

统一社会信用代码/纳税人识别号：

销
售
方
信
息

统一社会信用代码/纳税人识别号：

名称： | 名称：
项目名称 | 规格型号 | 单 位 | 数 量 | 单 价 | 金 额 | 税率/征收率 | 税 额
合 | 计
价税合计（大写） | 贰佰陆拾陆圆整 ¥266.00 （小写）

备 注

开票人：

25442000000281512193

2025年05月16日

东南大学

12100000466006770Q

佛山市云驱者科技有限公司

## 91440606MACDM4AA7U

¥263.37 | ¥2.63

凡忠华

*发动机*舵机 | FT2331 | 个 | 2 131.683168316832 | 263.37 | 1% | 2.63
