18871379330/mydexhand/报销/毕设/27.10_运动球.pdf

# 电子发票（普通发票） 发票号码： 开票日期：

购
买
方
信
息

统一社会信用代码/纳税人识别号：

销
售
方
信
息

统一社会信用代码/纳税人识别号：

名称： | 名称：
项目名称 | 规格型号 | 单 位 | 数 量 | 单 价 | 金 额 | 税率/征收率 | 税 额
合 | 计
价税合计（大写） | 贰拾柒圆壹角整 ¥27.10 （小写）

备 注

开票人：

25132000000094803000

2025年06月04日

东南大学

12100000466006770Q

河北太初体育用品有限公司

## 91131028MA0F74HN6C

¥26.83 | ¥0.27

杨少全

*体育用品*保健球 | 对 | 1 26.8316831683168 | 26.83 | 1% | 0.27
