18871379330/mydexhand/报销/毕设/27_硅胶.pdf

# 电子发票（普通发票） 发票号码： 开票日期：

购
买
方
信
息

统一社会信用代码/纳税人识别号：

销
售
方
信
息

统一社会信用代码/纳税人识别号：

名称： | 名称：
项目名称 | 规格型号 | 单 位 | 数 量 | 单 价 | 金 额 | 税率/征收率 | 税 额
合 | 计
价税合计（大写） | 贰拾柒圆整 ¥27.00 （小写）

备 注

开票人：

25444000000003133262

2025年05月07日

东南大学

12100000466006770Q

东莞市大朗华创化工材料贸易行

## 92441900MA52F1AD2M

¥26.73 | ¥0.27

肖福隆

*化学合成材料*硅胶 | 千克(公 | 1%
斤)
0.2 133.663366336634 | 26.73 | 0.27
