18871379330/mydexhand/报销/毕设/29.00_答辩正装腰带.pdf

# 电子发票（普通发票） 发票号码： 开票日期：

购
买
方
信
息

统一社会信用代码/纳税人识别号：

销
售
方
信
息

统一社会信用代码/纳税人识别号：

名称： | 名称：
项目名称 | 规格型号 | 单 位 | 数 量 | 单 价 | 金 额 | 税率/征收率 | 税 额
合 | 计
价税合计（大写） | 贰拾玖圆整 ¥29.00 （小写）

备 注

开票人：

25322000000254317873

2025年06月03日

东南大学

12100000466006770Q

南京东伦电子商务有限公司

## 91320115MA1X94N72X

¥25.66 | ¥3.34

卢水红

*皮革毛皮制品*皮带 | 个 | 1 | 25.66 | 25.66 | 13% | 3.34
