18871379330/mydexhand/报销/毕设/29.6_胶枪.pdf

# 电子发票（普通发票） 发票号码： 开票日期：

购
买
方
信
息

统一社会信用代码/纳税人识别号：

销
售
方
信
息

统一社会信用代码/纳税人识别号：

名称： | 名称：
项目名称 | 规格型号 | 单 位 | 数 量 | 单 价 | 金 额 | 税率/征收率 | 税 额
合 | 计
价税合计（大写） | 贰拾玖圆陆角整 ¥29.60 （小写）
备 注 | 收款人:胡雨睿; 复核人:惠紫薇;

开票人：

25322000000246397279

2025年05月29日

东南大学

12100000466006770Q

高新区狮山春满林贸易商行

## 92320505MA1P6MG65A

¥29.31 | ¥0.29

朱嘉

*塑料制品*胶枪 | 个 | 1 29.3069306930693 | 29.31 | 1% | 0.29
