18871379330/mydexhand/报销/毕设/29.9_耳机.pdf

# 电子发票（普通发票） 发票号码： 开票日期：

购
买
方
信
息

统一社会信用代码/纳税人识别号：

销
售
方
信
息

统一社会信用代码/纳税人识别号：

名称： | 名称：
项目名称 | 规格型号 | 单 位 | 数 量 | 单 价 | 金 额 | 税率/征收率 | 税 额
合 | 计
价税合计（大写） | 贰拾玖圆玖角整 ¥29.90 （小写）

备 注

开票人：

25442000000324964910

2025年06月04日

东南大学

12100000466006770Q

广州荣联电子有限公司

## 91440113MAC8UNUX3H

¥26.46 | ¥3.44

曾波祥

*电子元件*蓝牙耳机 | 个 | 1 26.4601769911504 | 26.46 | 13% | 3.44
