18871379330/mydexhand/报销/毕设/30_剥线钳.pdf

# 电子发票（普通发票） 发票号码： 开票日期：

购
买
方
信
息

统一社会信用代码/纳税人识别号：

销
售
方
信
息

统一社会信用代码/纳税人识别号：

名称： | 名称：
项目名称 | 规格型号 | 单 位 | 数 量 | 单 价 | 金 额 | 税率/征收率 | 税 额
合 | 计
价税合计（大写） | 叁拾圆整 ¥30.00 （小写）

备 注

开票人：

25322000000256527866

2025年06月05日

东南大学

12100000466006770Q

昆山市木稳电子科技有限公司

## 91320583MACULGU64E

¥29.70 | ¥0.30

杨稳君

*金属制品*专用手工具 | 把 | 1 29.7029702970297 | 29.70 | 1% | 0.30
