18871379330/mydexhand/报销/毕设/32.4_固化硅胶.pdf

# 电子发票（普通发票） 发票号码： 开票日期：

购
买
方
信
息

统一社会信用代码/纳税人识别号：

销
售
方
信
息

统一社会信用代码/纳税人识别号：

名称： | 名称：
项目名称 | 规格型号 | 单 位 | 数 量 | 单 价 | 金 额 | 税率/征收率 | 税 额
合 | 计
价税合计（大写） | 叁拾贰圆肆角整 ¥32.40 （小写）
备 注 | 收款人:俞小妹; 复核人:李菊英;

开票人：

25312000000131184404

2025年04月29日

东南大学

1 2 1 0 0 0 0 0 4 6 6 0 0 6 7 7 0 Q

上海青汰新材料科技有限公司

## 9131 0 1 2 0 MA1HW3TJ7F

¥32.08 | ¥0.32

李宁

*化学合成材料*粘合剂 | PT-799 | 支 | 1 32.0792079207921 | 32.08 | 1% | 0.32
