18871379330/mydexhand/报销/毕设/344.8_PWM舵机.pdf

# 电子发票（普通发票） 发票号码： 开票日期：

购
买
方
信
息

统一社会信用代码/纳税人识别号：

销
售
方
信
息

统一社会信用代码/纳税人识别号：

名称： | 名称：
项目名称 | 规格型号 | 单 位 | 数 量 | 单 价 | 金 额 | 税率/征收率 | 税 额
合 | 计
价税合计（大写） | 叁佰肆拾肆圆捌角整 ¥344.80 （小写）

备 注

开票人：

25942000000023755851

2025年06月04日

东南大学

12100000466006770Q

厦门市陆空科技有限公司

91350206303003938N

¥305.13 | ¥39.67

杨珊芳

*电动机*舵机 | 个 | 6 50.8554572271387 | 305.13 | 13% | 39.67
