18871379330/mydexhand/报销/毕设/39.62_金士顿u盘.pdf

# 电子发票（普通发票） 发票号码： 开票日期：

购
买
方
信
息

统一社会信用代码/纳税人识别号：

销
售
方
信
息

统一社会信用代码/纳税人识别号：

名称： | 名称：
项目名称 | 规格型号 | 单 位 | 数 量 | 单 价 | 金 额 | 税率/征收率 | 税 额
合 | 计
价税合计（大写） | 叁拾玖圆玖角整 ¥39.90 （小写）
备 注 | 收款人:王国全; 复核人:赵梓涛;

开票人：

25952000000042865435

2025年03月08日

东南大学

12100000466006770Q

深圳市弘鑫达数码有限公司

## 91440300MA5G43Q30R

¥35.31 | ¥4.59

周晓鹏

*计算机外部设备*存储U
盘
个 | 1 35.3097345132743 | 35.31 | 13% | 4.59
