18871379330/mydexhand/报销/毕设/4.32_螺丝.pdf

# 电子发票（普通发票） 发票号码： 开票日期：

购
买
方
信
息

统一社会信用代码/纳税人识别号：

销
售
方
信
息

统一社会信用代码/纳税人识别号：

名称： | 名称：
项目名称 | 规格型号 | 单 位 | 数 量 | 单 价 | 金 额 | 税率/征收率 | 税 额
合 | 计
价税合计（大写） | 肆圆叁角贰分 ¥4.32 （小写）
备 注 | 4303056963365002740

开票人：

25322000000254573032

2025年06月04日

东南大学

12100000466006770Q

兴化市兴卓金属制品有限公司

## 91321281MACRCRKBXH

¥4.28 | ¥0.04

范苏云

*金属制品*不锈钢螺丝 | M10*35【5个】 | 件 | 1 | 4.28 | 4.28 | 1% | 0.04
