18871379330/mydexhand/报销/毕设/4.39_老虎钳.pdf

# 电子发票（普通发票） 发票号码： 开票日期：

购
买
方
信
息

统一社会信用代码/纳税人识别号：

销
售
方
信
息

统一社会信用代码/纳税人识别号：

名称： | 名称：
项目名称 | 规格型号 | 单 位 | 数 量 | 单 价 | 金 额 | 税率/征收率 | 税 额
合 | 计
价税合计（大写） | 肆圆叁角玖分 ¥4.39 （小写）

备 注

开票人：

25922000000019911066

2025年04月05日

东南大学

12100000466006770Q

城阳区强茂购五金店

## 92370214MA3R2A9P7K

¥4.35 | ¥0.04

曲菲菲

*金属制品*尖嘴钳 | 件 | 1 | 4.35 | 4.35 | 1% | 0.04
