18871379330/mydexhand/报销/毕设/4.5_平头十字螺钉.pdf

# 电子发票（普通发票） 发票号码： 开票日期：

购
买
方
信
息

统一社会信用代码/纳税人识别号：

销
售
方
信
息

统一社会信用代码/纳税人识别号：

名称： | 名称：
项目名称 | 规格型号 | 单 位 | 数 量 | 单 价 | 金 额 | 税率/征收率 | 税 额
合 | 计
价税合计（大写） | 肆圆伍角整 ¥4.50 （小写）
备 注 | 订单:4244700060927002740 店铺:固万基旗舰店-天猫; 收款人:杨娜各; 复核人:姜绪坤;

开票人：

25342000000038171741

2025年03月08日

东南大学

12100000466006770Q

安庆市固基五金有限公司

## 91340803MA8QXG3D4E

¥3.98 | ¥0.52

廖思维

*金属制品*304十字沉头
机丝 KM3x12 头5.2
M4*22[50只] | 份 | 1 3.9823008849558 | 3.98 | 13% | 0.52
