18871379330/mydexhand/报销/毕设/4.6_静电袋子.pdf

# 电子发票（普通发票） 发票号码： 开票日期：

购
买
方
信
息

统一社会信用代码/纳税人识别号：

销
售
方
信
息

统一社会信用代码/纳税人识别号：

名称： | 名称：
项目名称 | 规格型号 | 单 位 | 数 量 | 单 价 | 金 额 | 税率/征收率 | 税 额
合 | 计
价税合计（大写） | 肆圆陆角整 ¥4.60 （小写）

备 注

开票人：

25442000000201742318

2025年04月11日

东南大学

12100000466006770Q

东莞市金禾田新材料有限公司

## 91441900MABTRN5809

¥4.55 | ¥0.05

刘倩

*塑料制品*包装袋*防静
电袋
批 | 1 4.5544554455446 | 4.55 | 1% | 0.05
