18871379330/mydexhand/专利修改/a.JPG

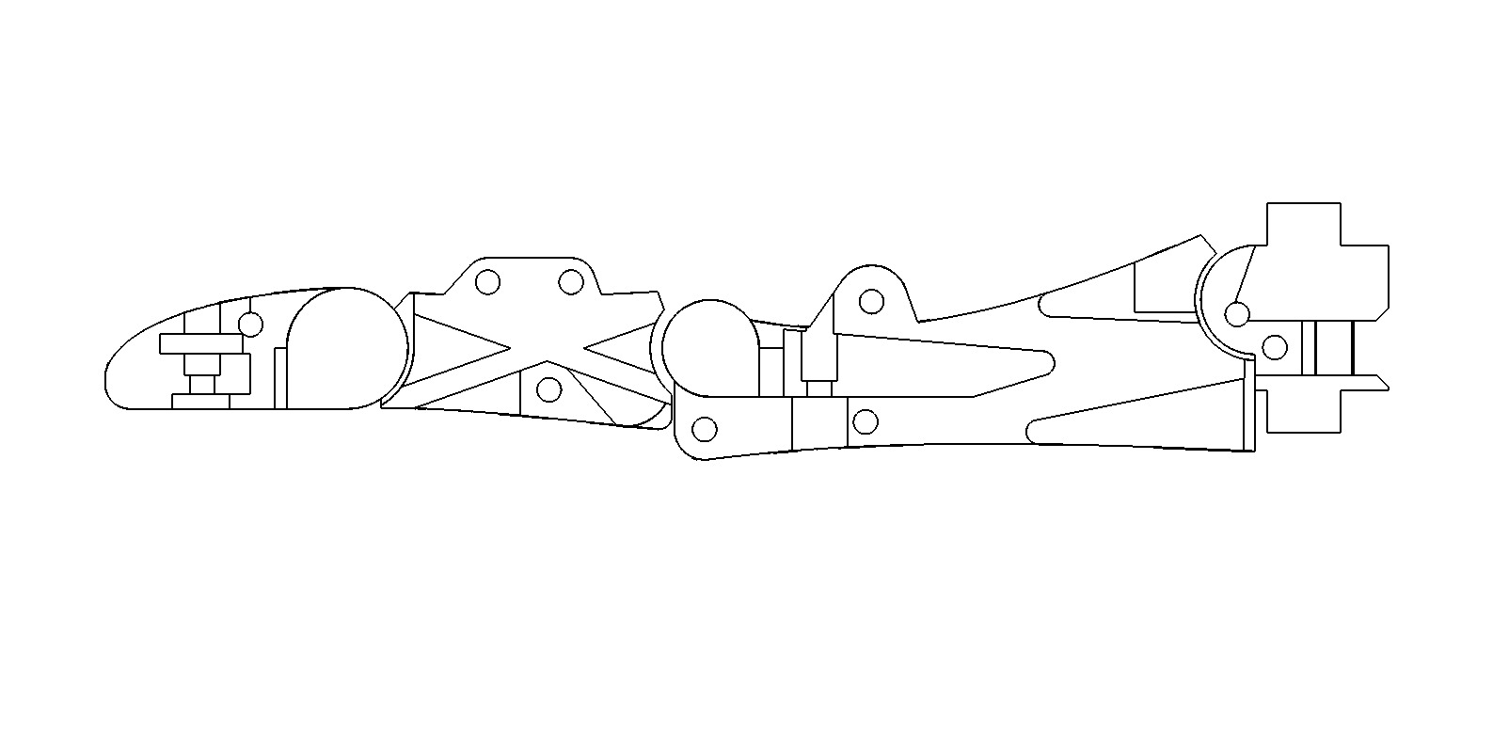
专利修改/a.JPG
