18871379330/mydexhand/专利修改/专利图片/幻灯片12.PNG

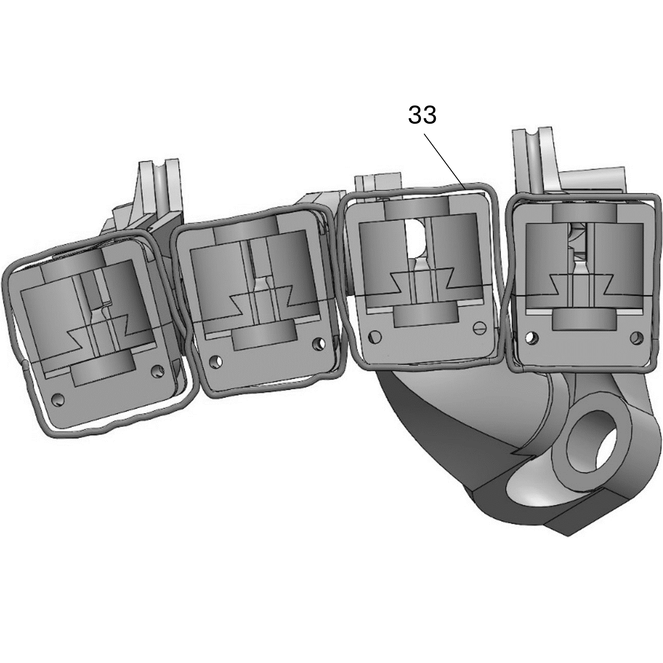
专利修改/专利图片/幻灯片12.PNG
