18871379330/mydexhand/专利修改/专利图片/幻灯片18.PNG

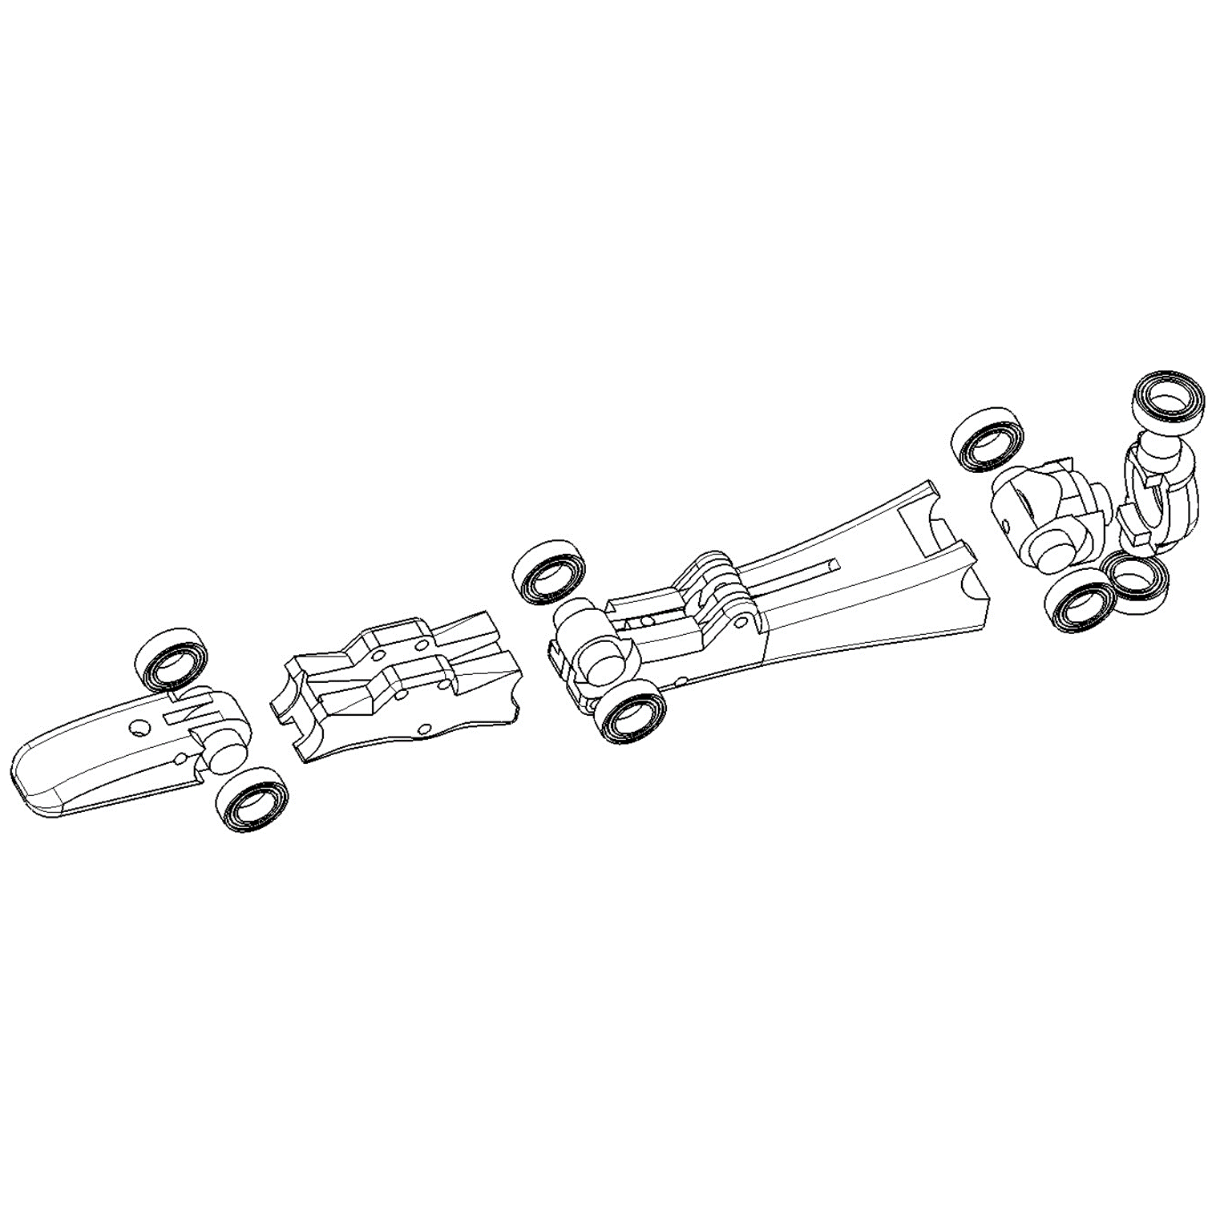
专利修改/专利图片/幻灯片18.PNG
