18871379330/mydexhand/专利修改/大拇指万向节.JPG

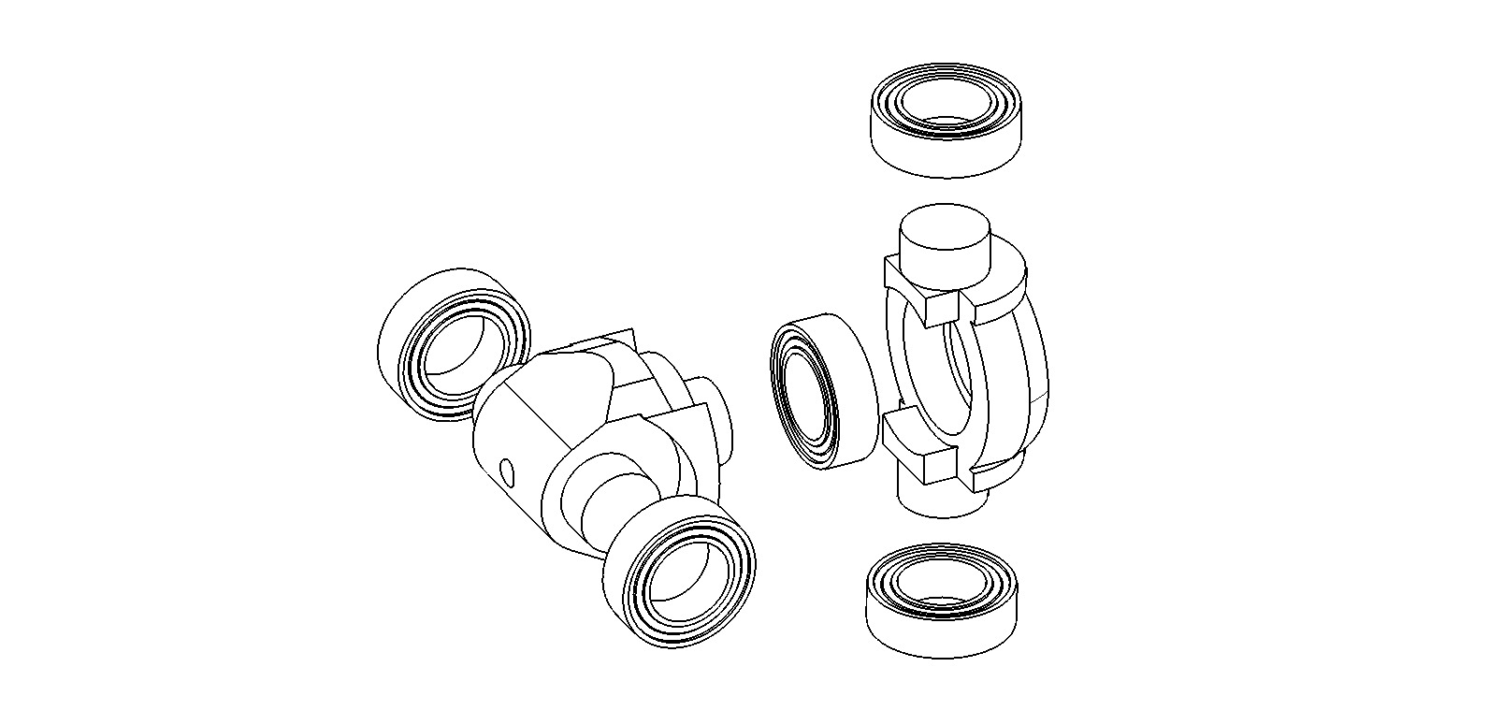
专利修改/大拇指万向节.JPG
