18871379330/mydexhand/专利修改/大拇指爆炸.JPG

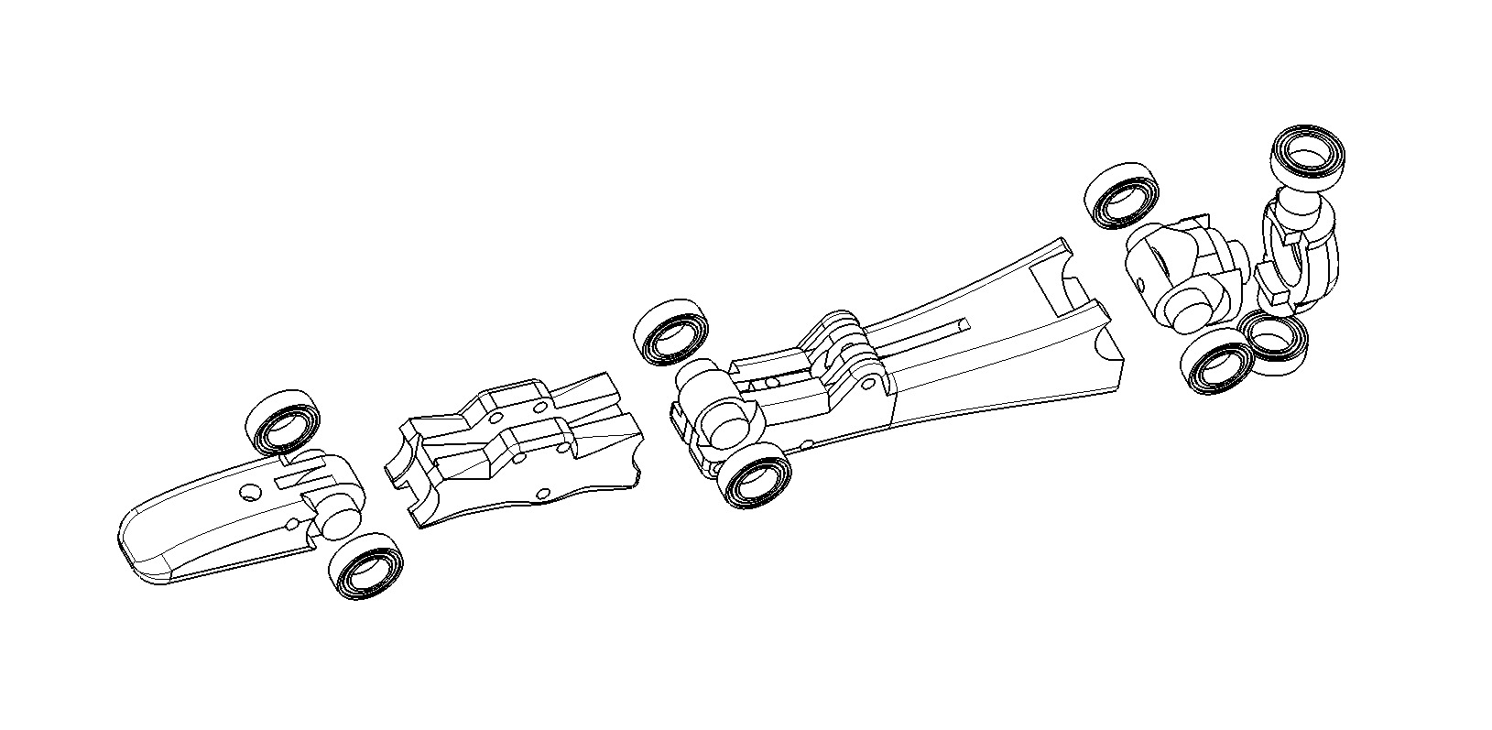
专利修改/大拇指爆炸.JPG
