18871379330/mydexhand/专利修改/手.JPG

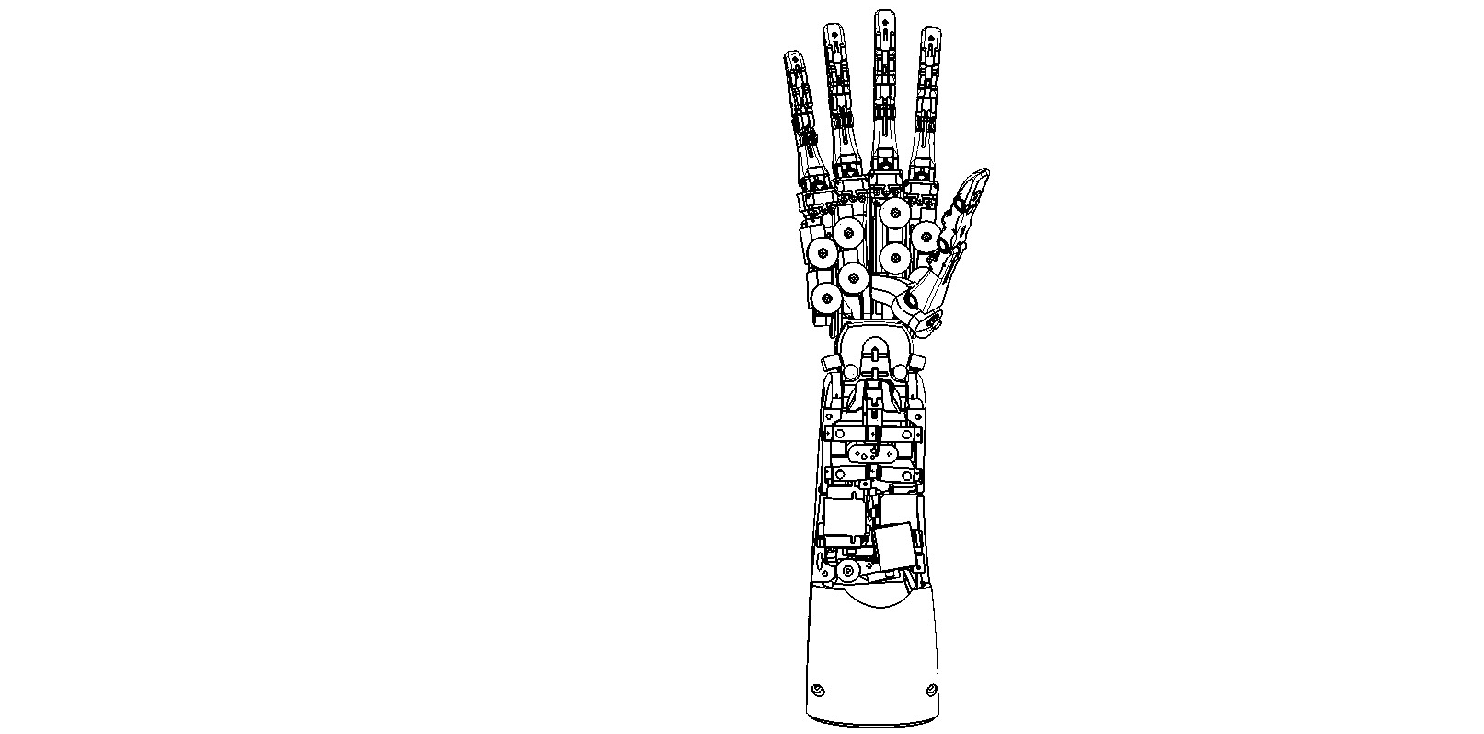
专利修改/手.JPG
