18871379330/mydexhand/专利修改/手腕.JPG

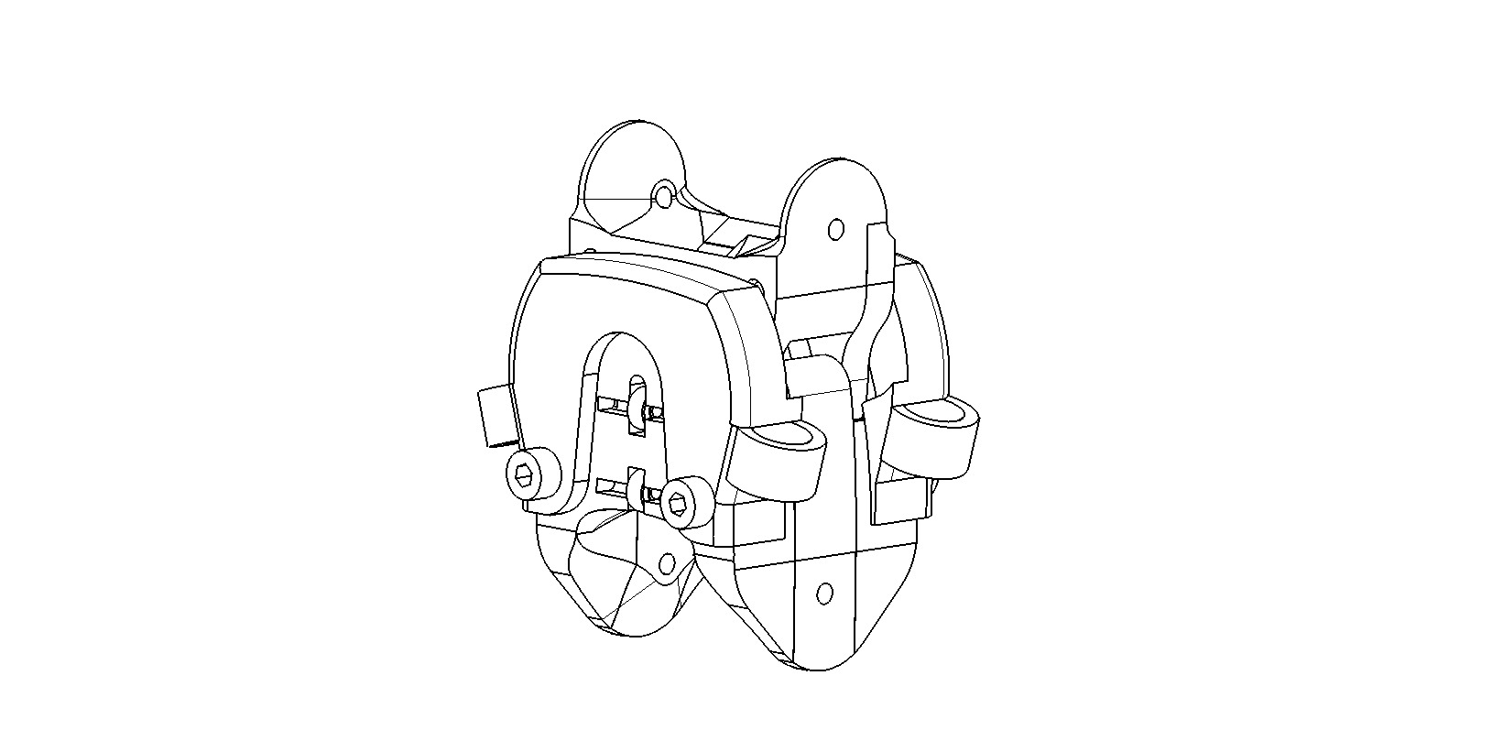
专利修改/手腕.JPG
