18871379330/mydexhand/专利修改/手腕双八绳.JPG

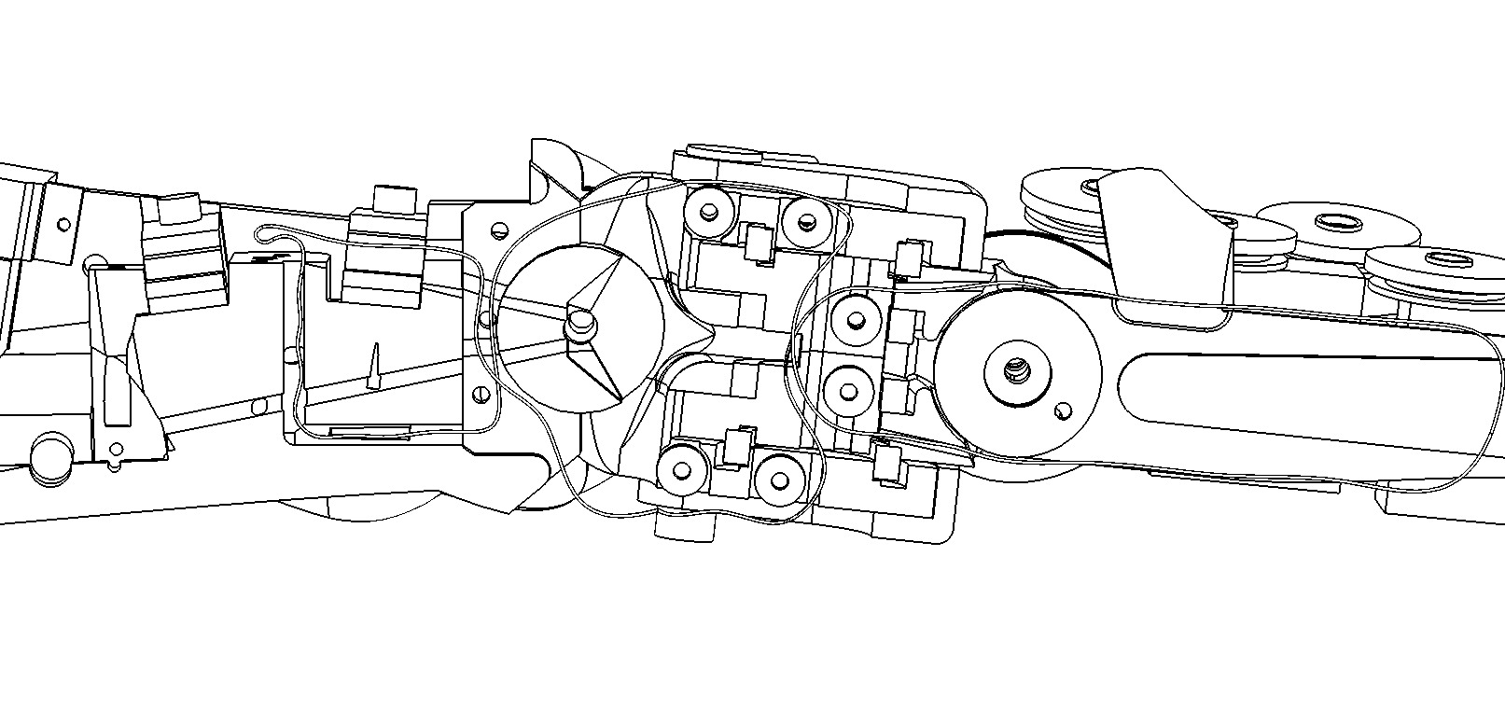
专利修改/手腕双八绳.JPG
