18871379330/mydexhand/专利修改/手腕爆炸图.JPG

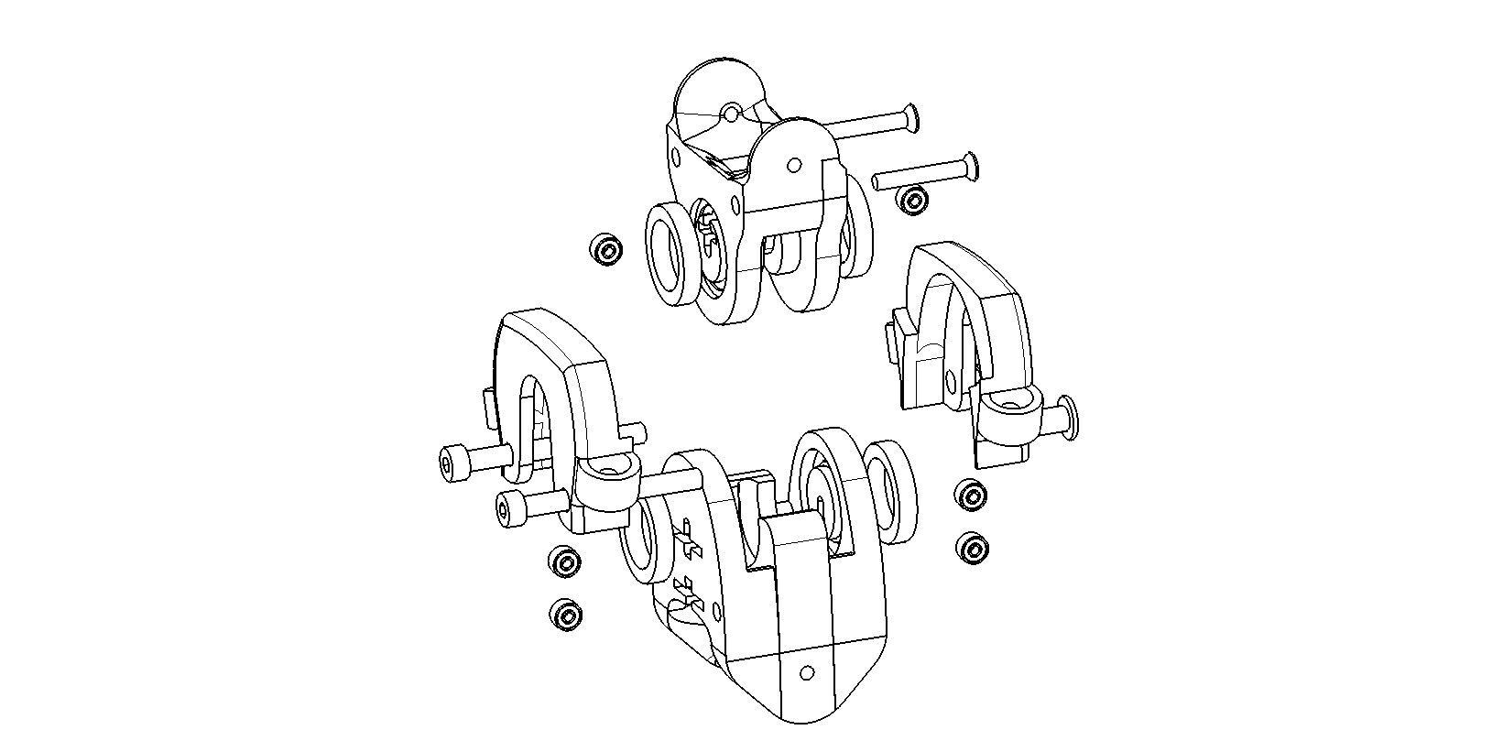
专利修改/手腕爆炸图.JPG
