18871379330/mydexhand/专利修改/掌骨.JPG

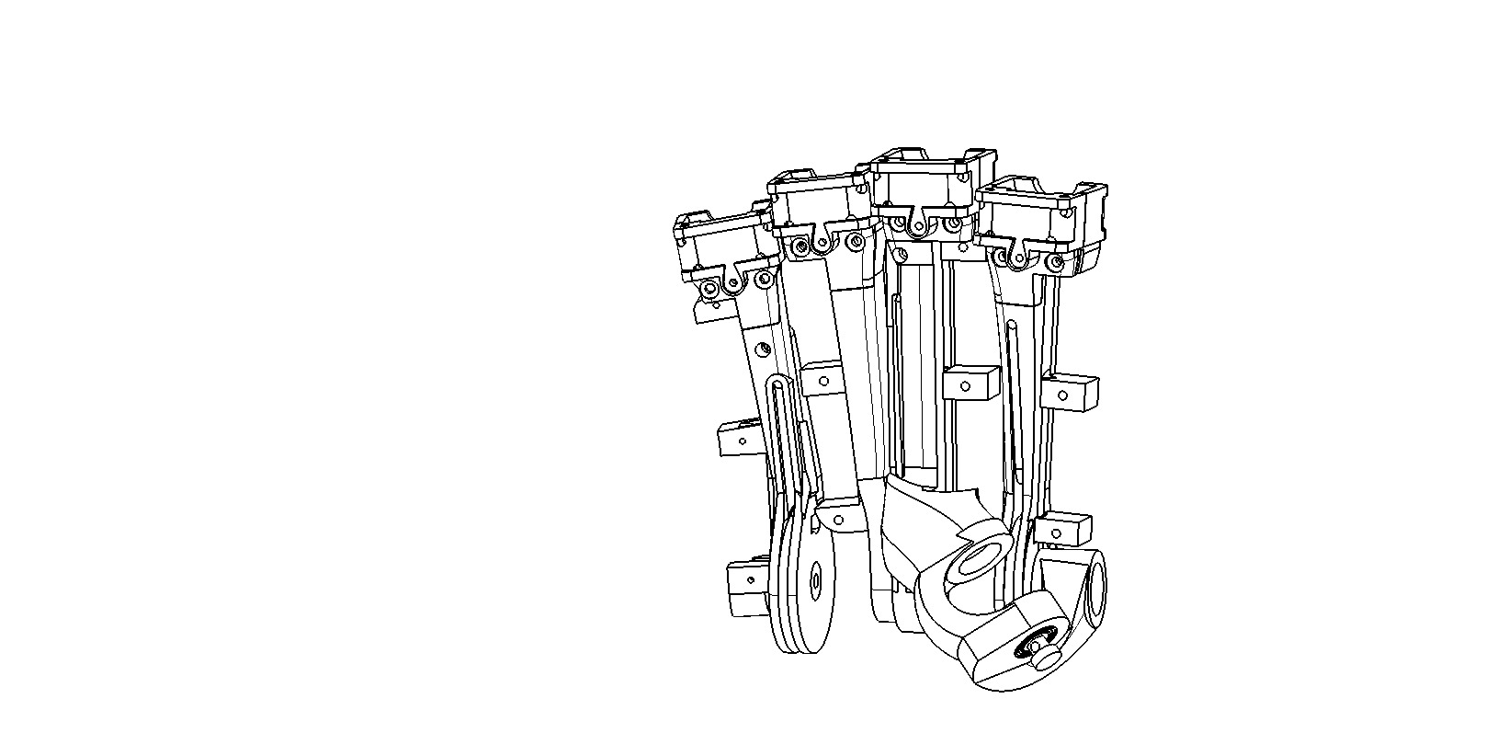
专利修改/掌骨.JPG
