18871379330/mydexhand/专利修改/掌骨限位绳.jpg

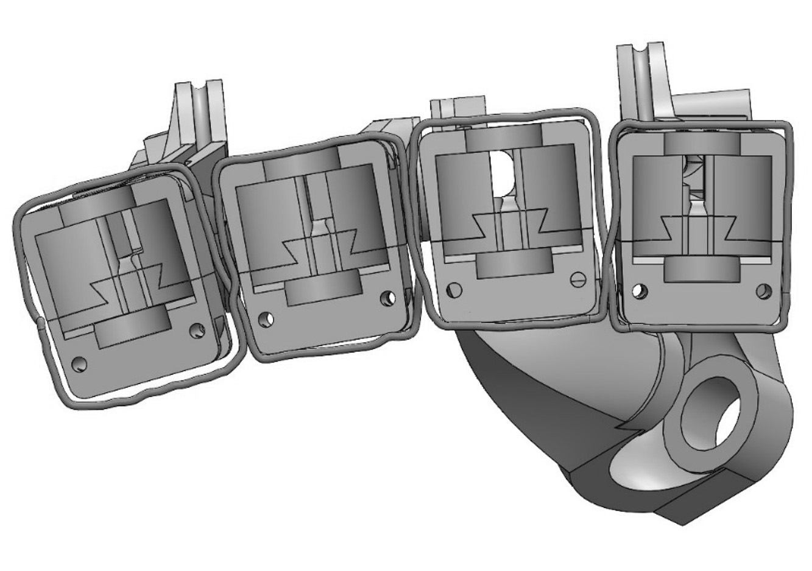
专利修改/掌骨限位绳.jpg
