18871379330/mydexhand/专利修改/食指八字绳侧视图.JPG

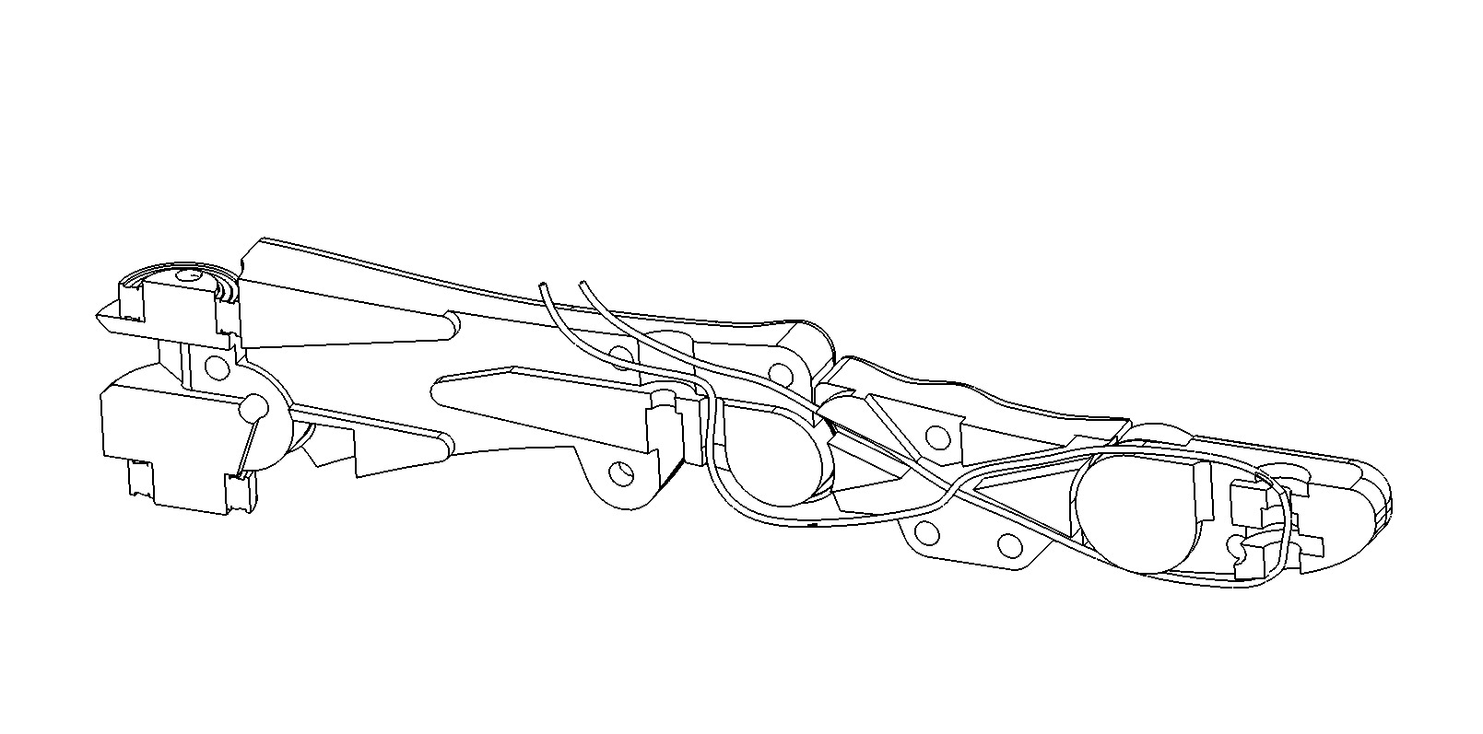
专利修改/食指八字绳侧视图.JPG
