18871379330/mydexhand/专利修改/食指回弹机构侧视图.JPG

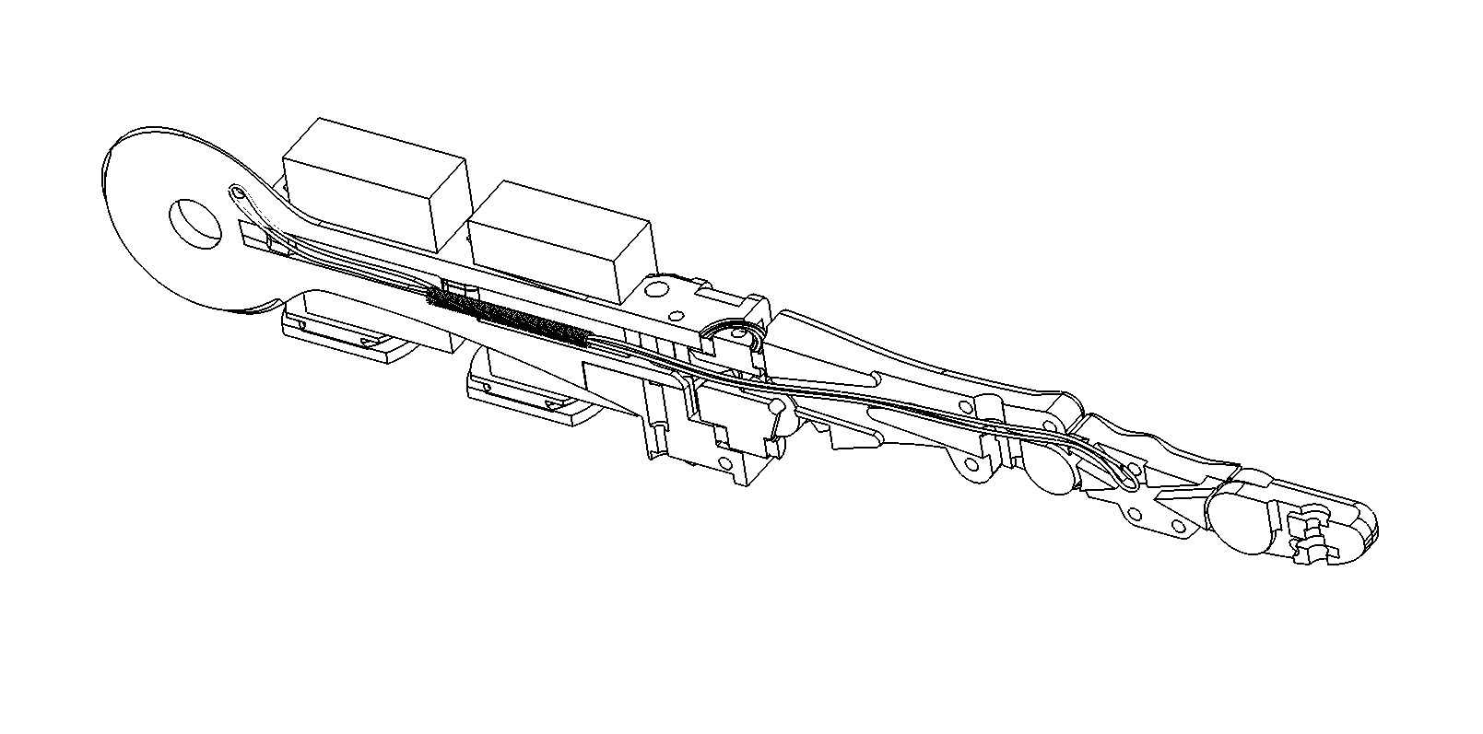
专利修改/食指回弹机构侧视图.JPG
