18871379330/mydexhand/专利修改/食指摇摆机构.JPG

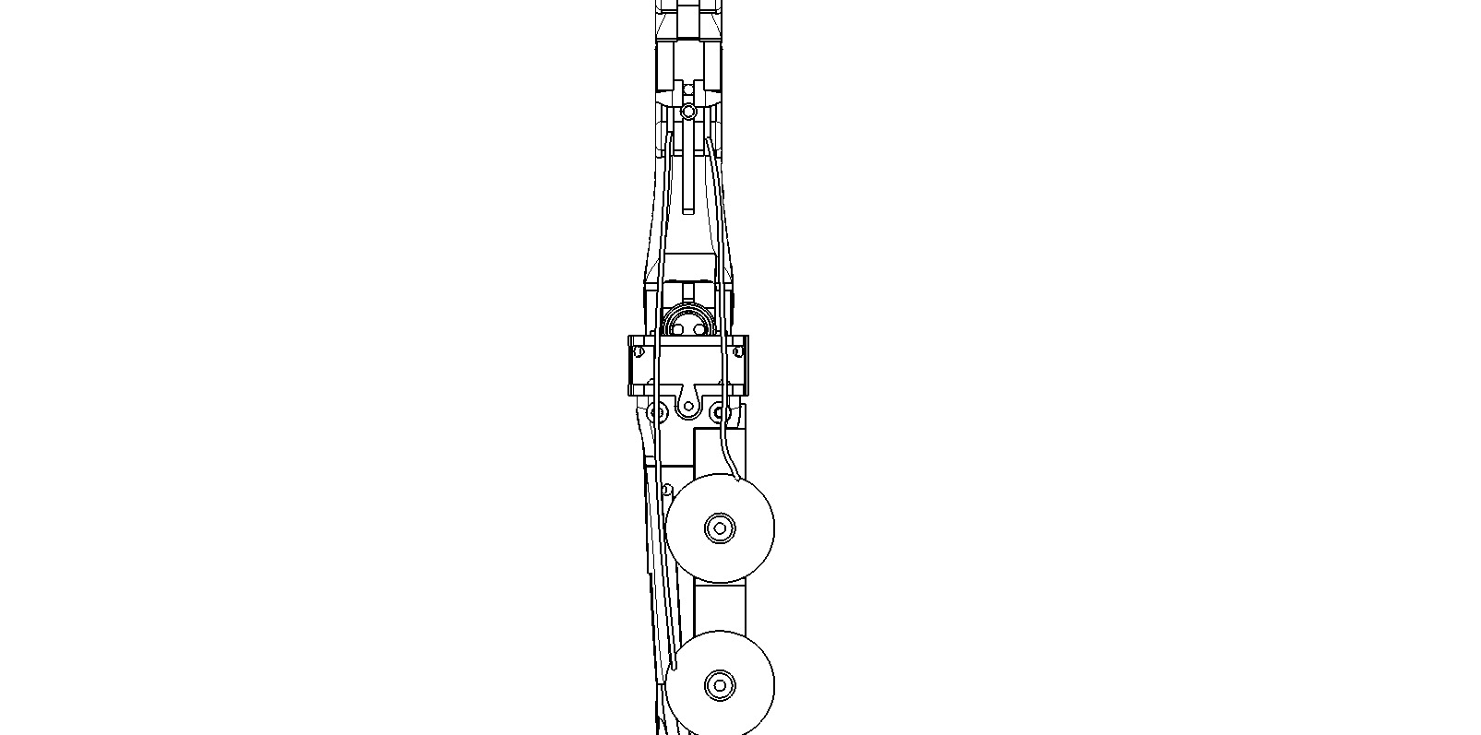
专利修改/食指摇摆机构.JPG
