18871379330/mydexhand/专利修改/食指爆炸图.JPG

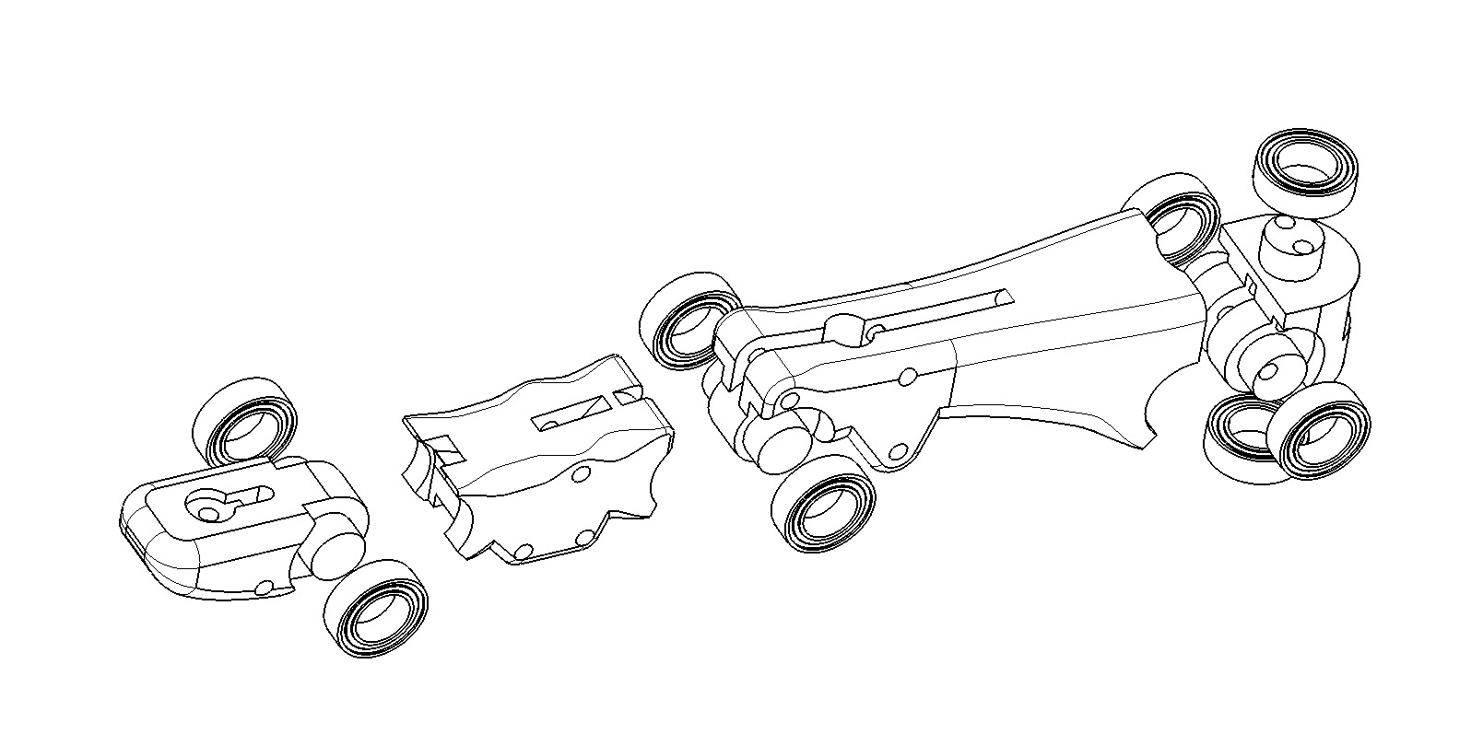
专利修改/食指爆炸图.JPG
