18871379330/mydexhand/专利修改/食指牵引3D图.JPG

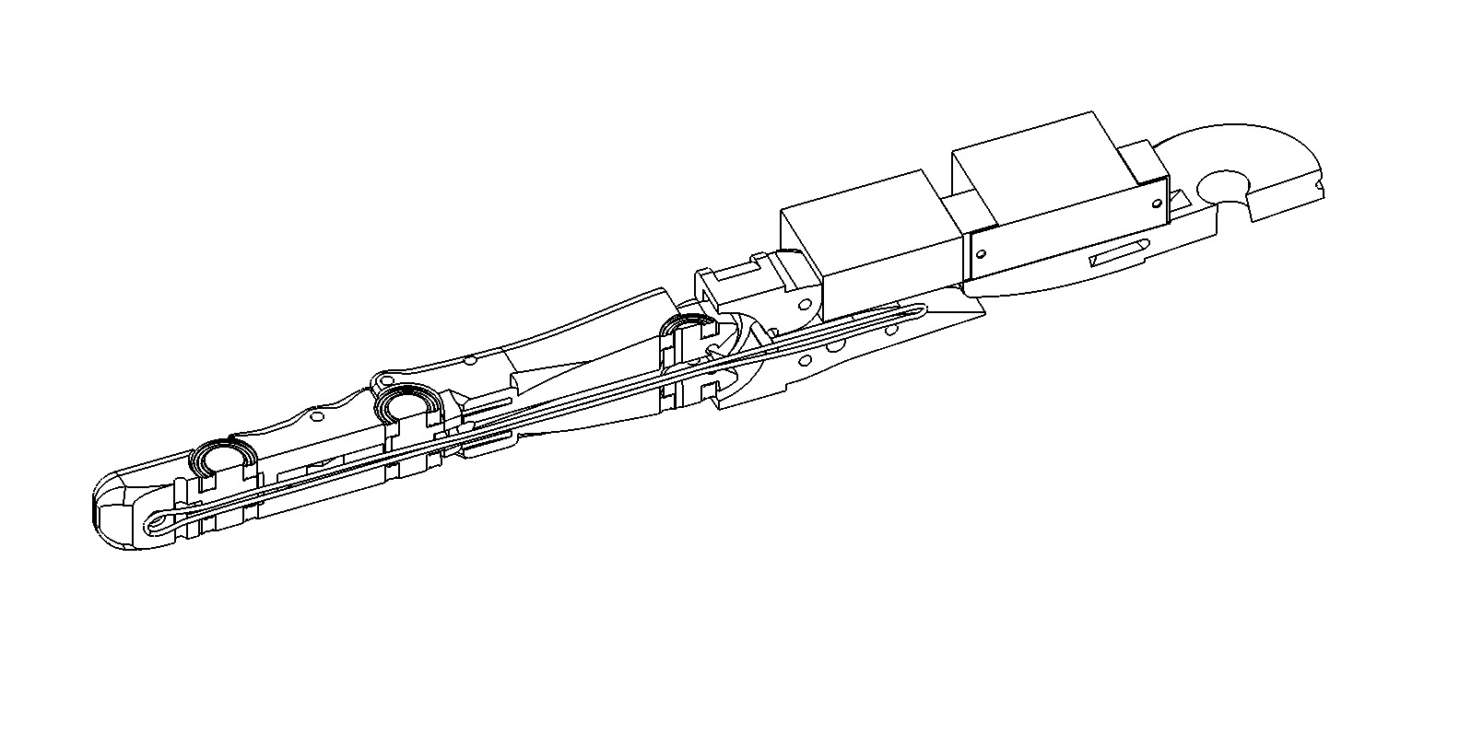
专利修改/食指牵引3D图.JPG
