18871379330/mydexhand/图片/content.png

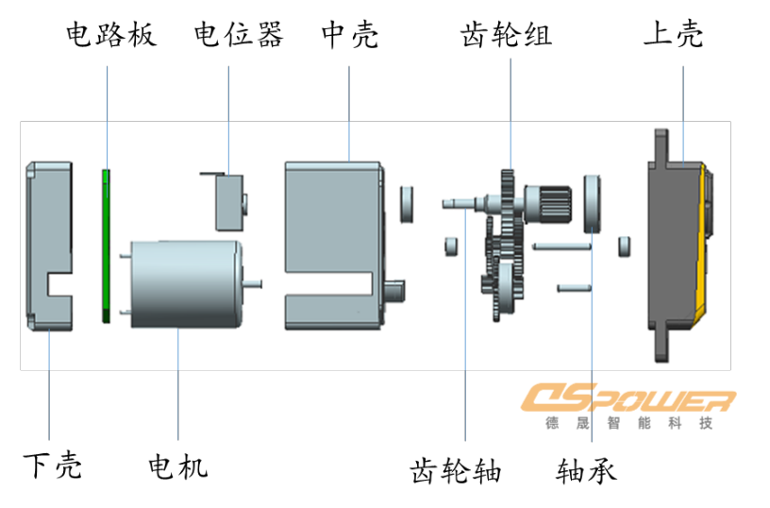
图片/content.png
