18871379330/mydexhand/图片/Figure1c.png

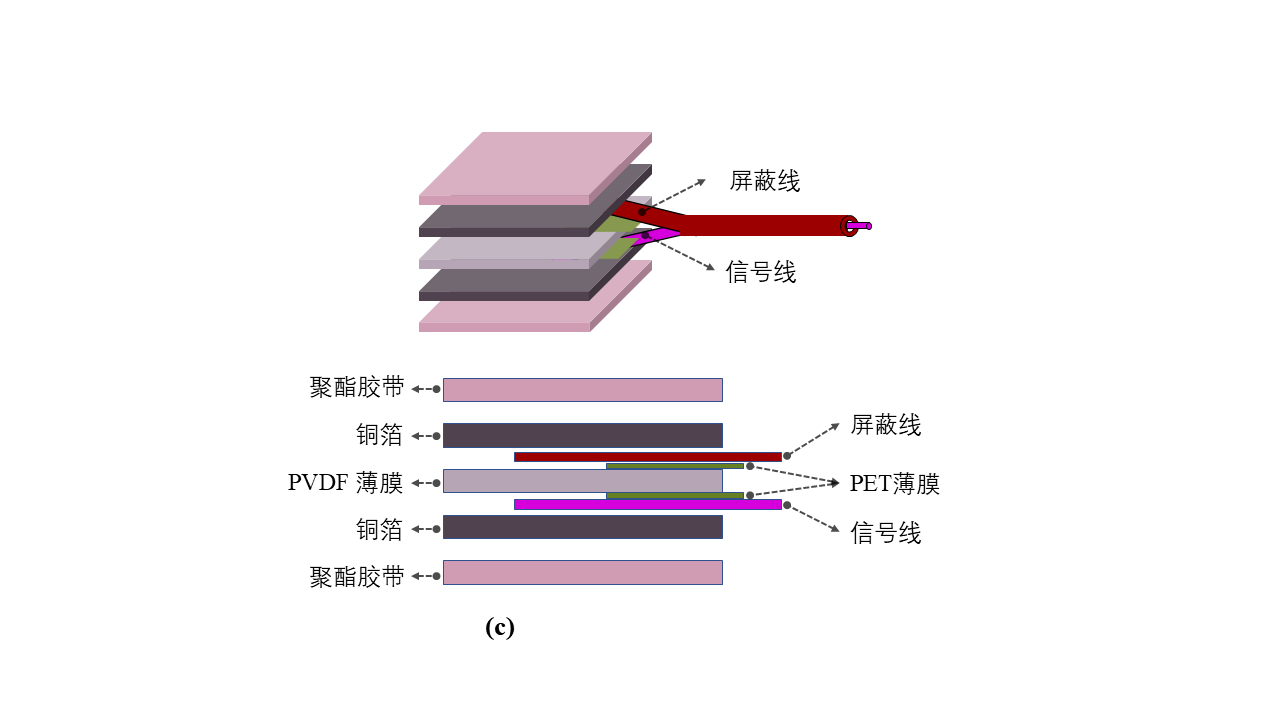
图片/Figure1c.png
