18871379330/mydexhand/图片/PPT图片/2.png

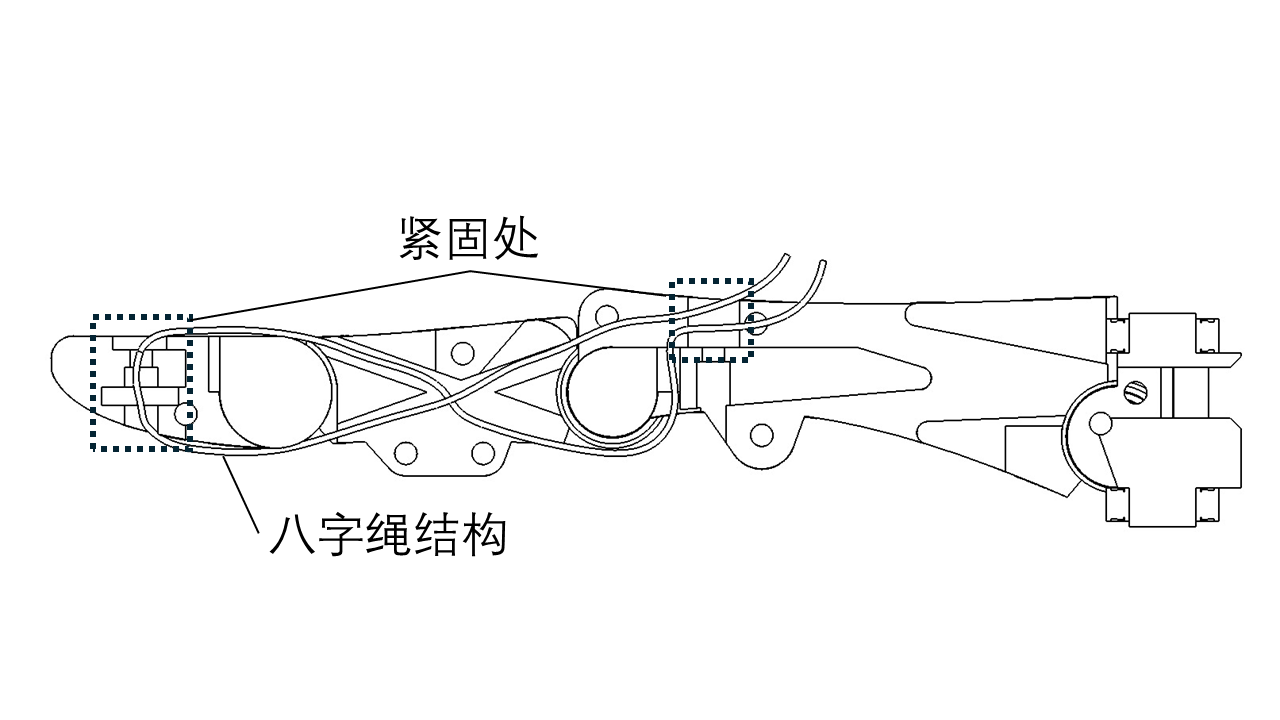
图片/PPT图片/2.png
