18871379330/mydexhand/图片/PPT图片/6.JPG

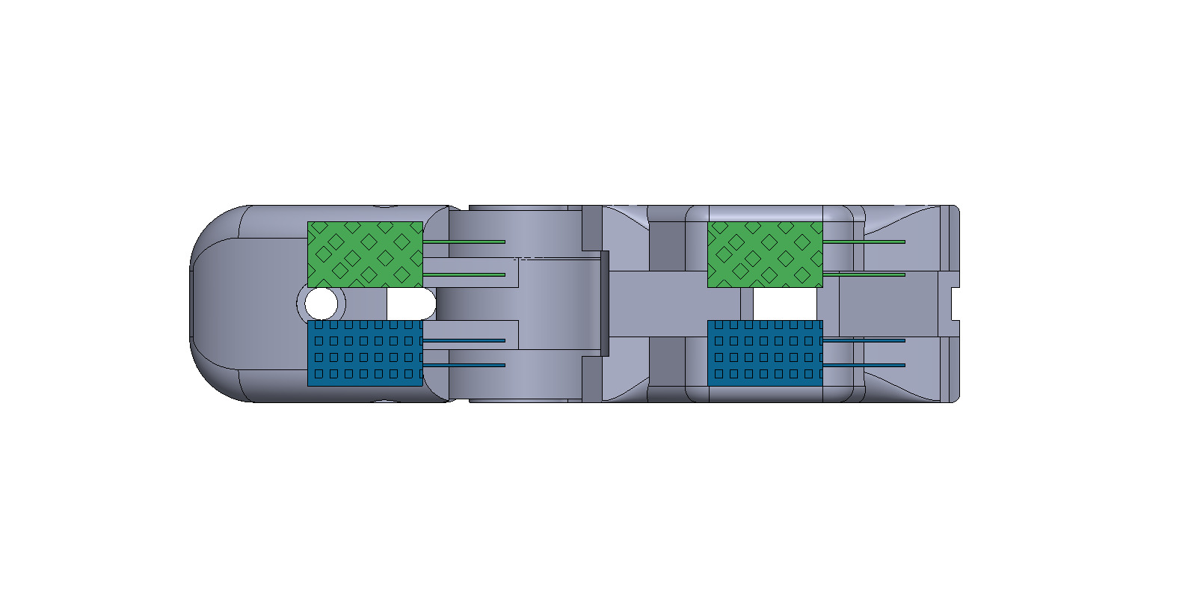
图片/PPT图片/6.JPG
