18871379330/mydexhand/图片/PPT图片/7.png

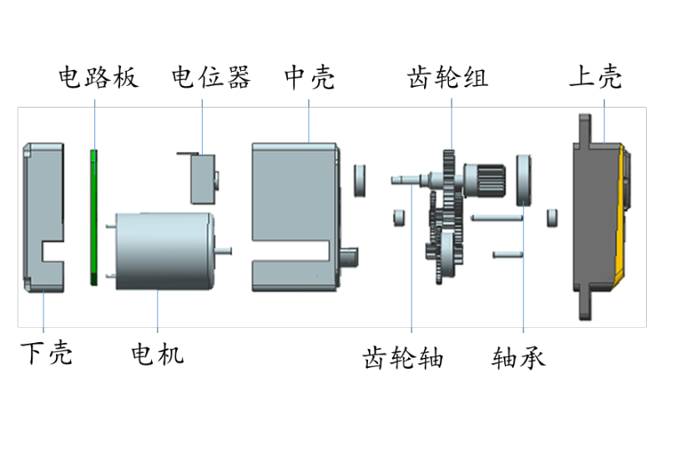
图片/PPT图片/7.png
