18871379330/mydexhand/图片/PPT图片/电机驱动的多自由度五指灵巧手2.png

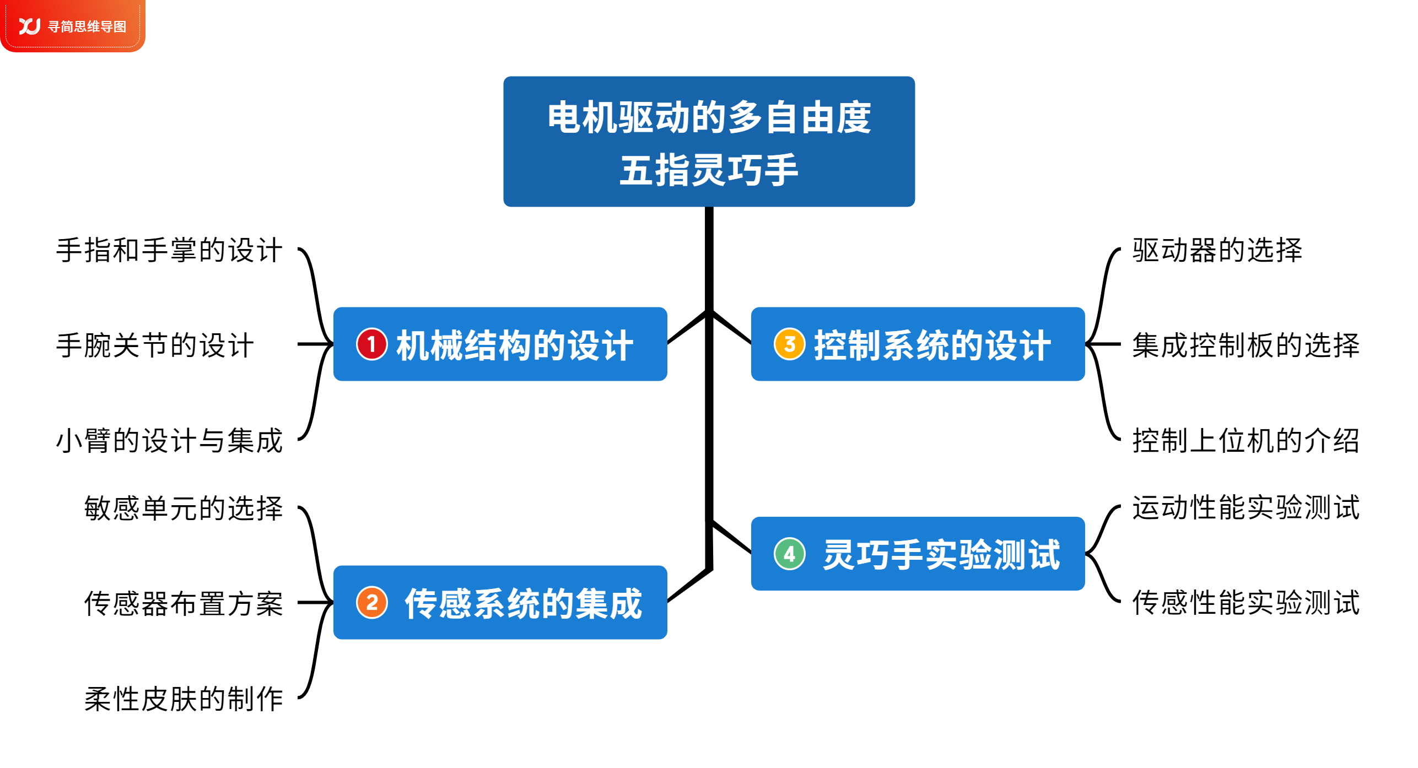
图片/PPT图片/电机驱动的多自由度五指灵巧手2.png
