18871379330/mydexhand/图片/robotic_hand_black_background_improved.jpg

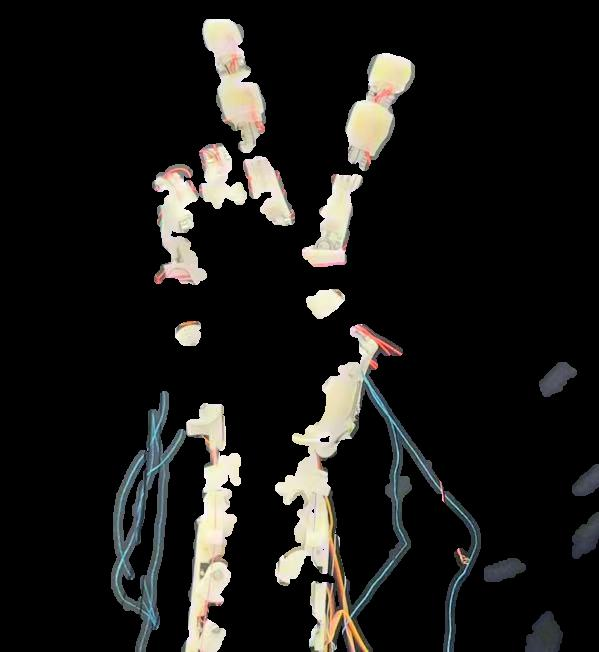
图片/robotic_hand_black_background_improved.jpg
