18871379330/mydexhand/图片/slady.jpg

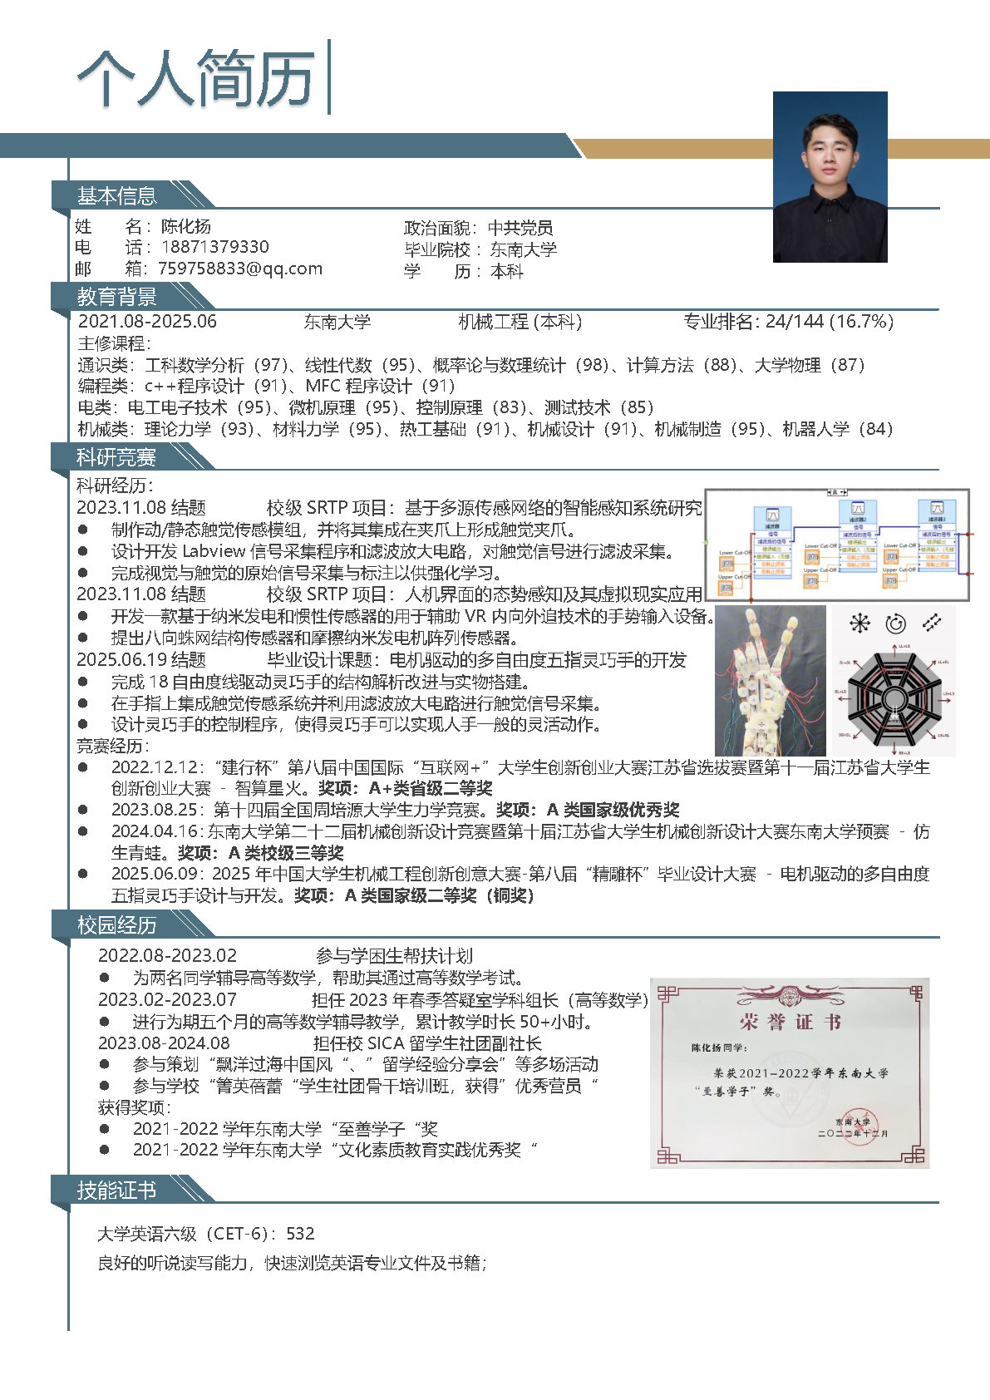
图片/slady.jpg
