18871379330/mydexhand/图片/zhaohaoran.png

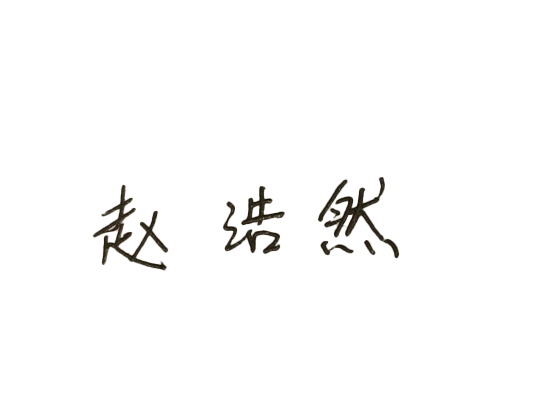
图片/zhaohaoran.png
