18871379330/mydexhand/图片/作图/作图.png

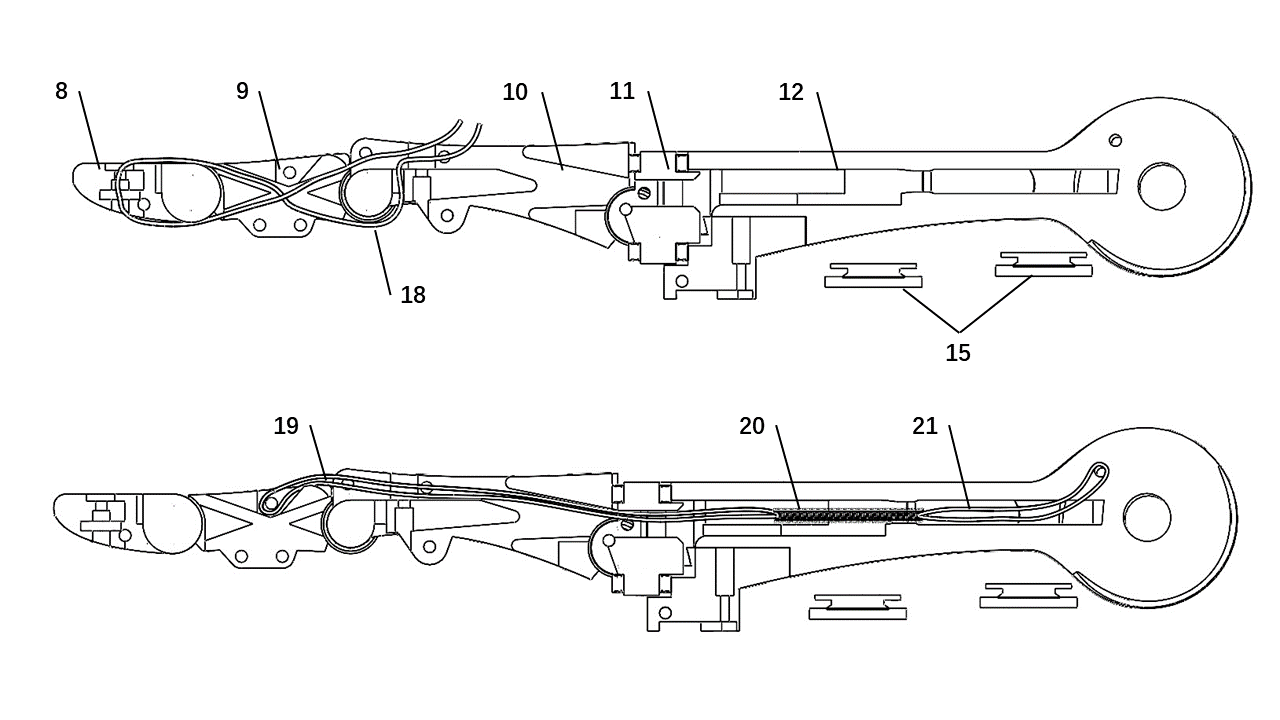
图片/作图/作图.png
