18871379330/mydexhand/图片/作图/幻灯片18.PNG

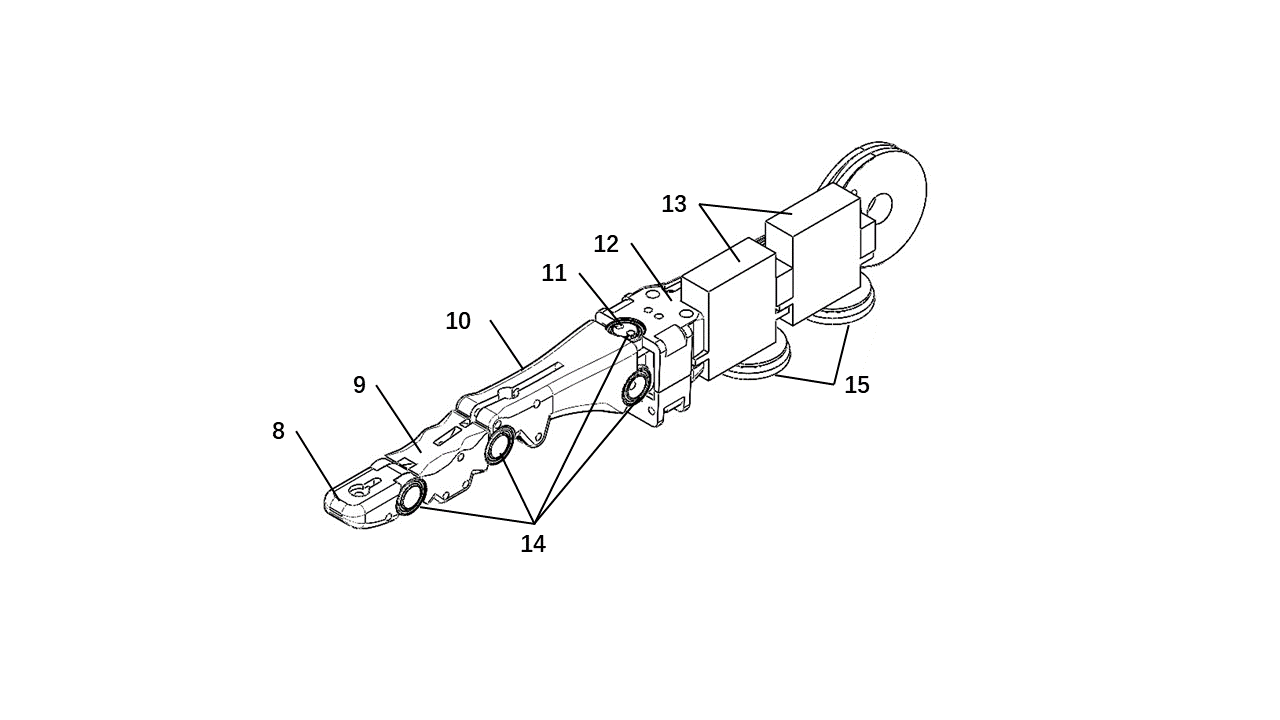
图片/作图/幻灯片18.PNG
