18871379330/mydexhand/图片/创新点1.png

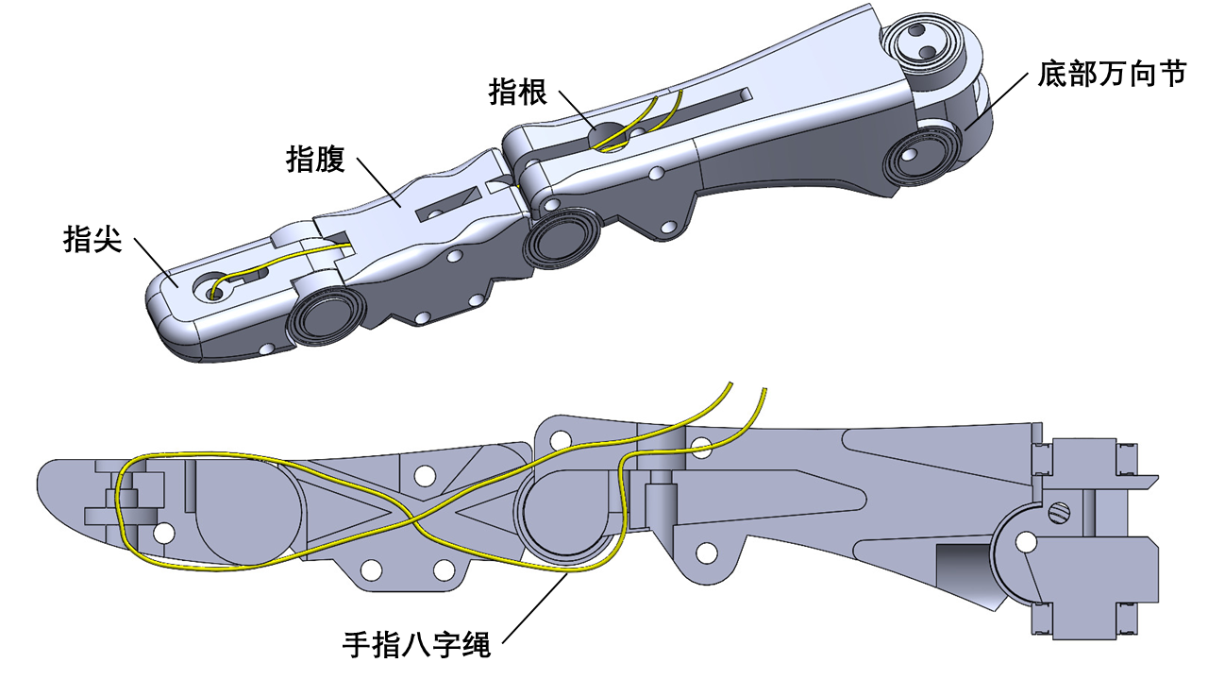
图片/创新点1.png
