18871379330/mydexhand/图片/创新点2.png

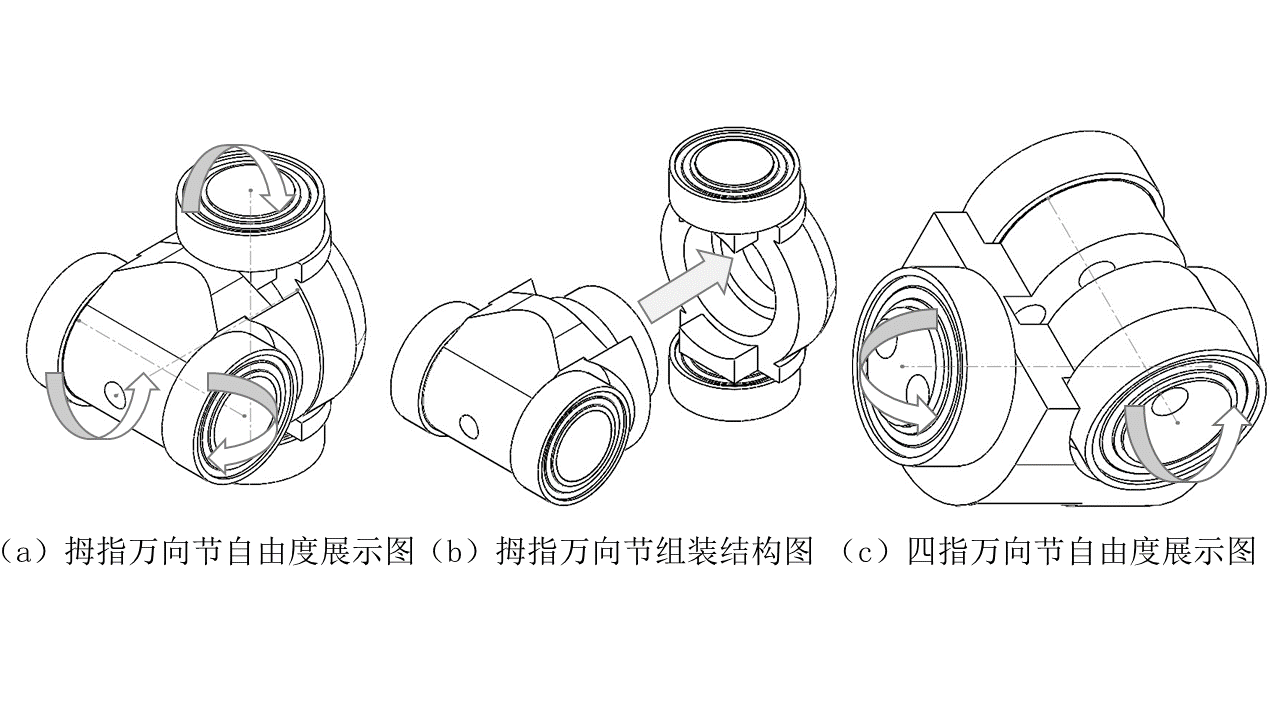
图片/创新点2.png
