18871379330/mydexhand/图片/创新点3.png

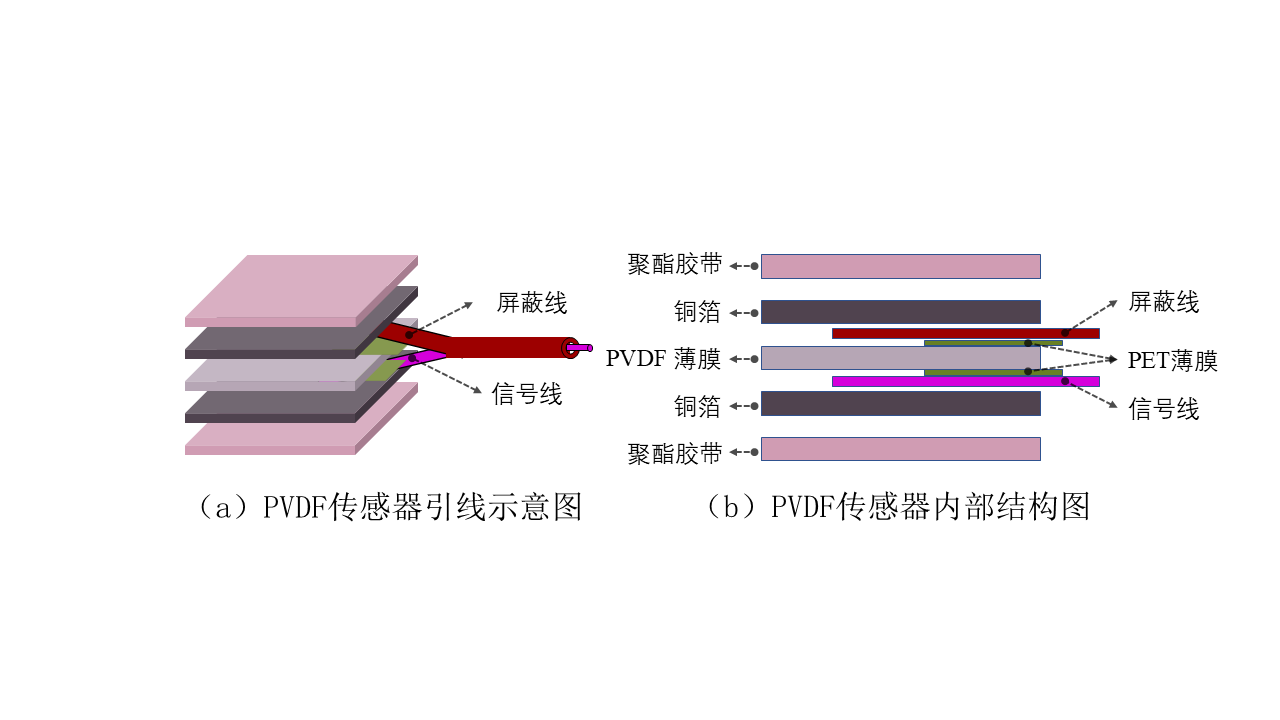
图片/创新点3.png
