18871379330/mydexhand/图片/改/1.JPG

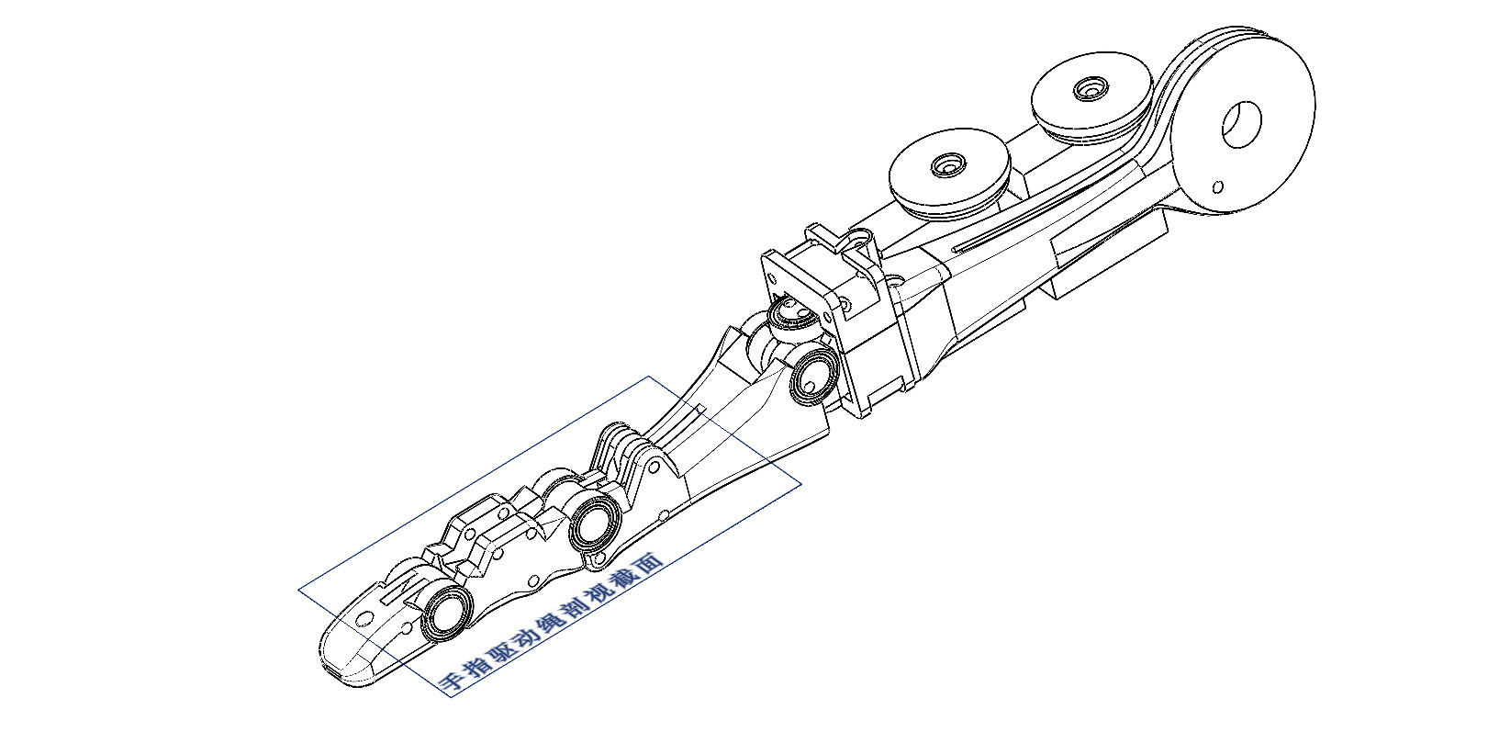
图片/改/1.JPG
