18871379330/mydexhand/图片/改/1.PNG

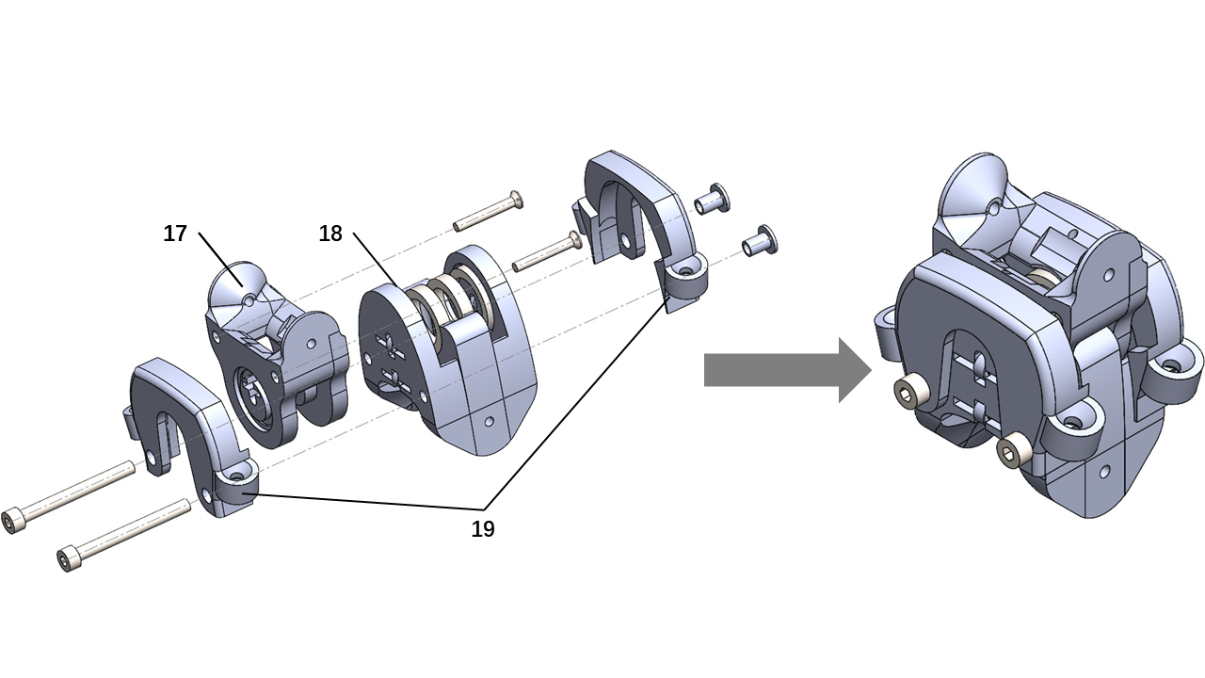
图片/改/1.PNG
