18871379330/mydexhand/图片/改/2.png

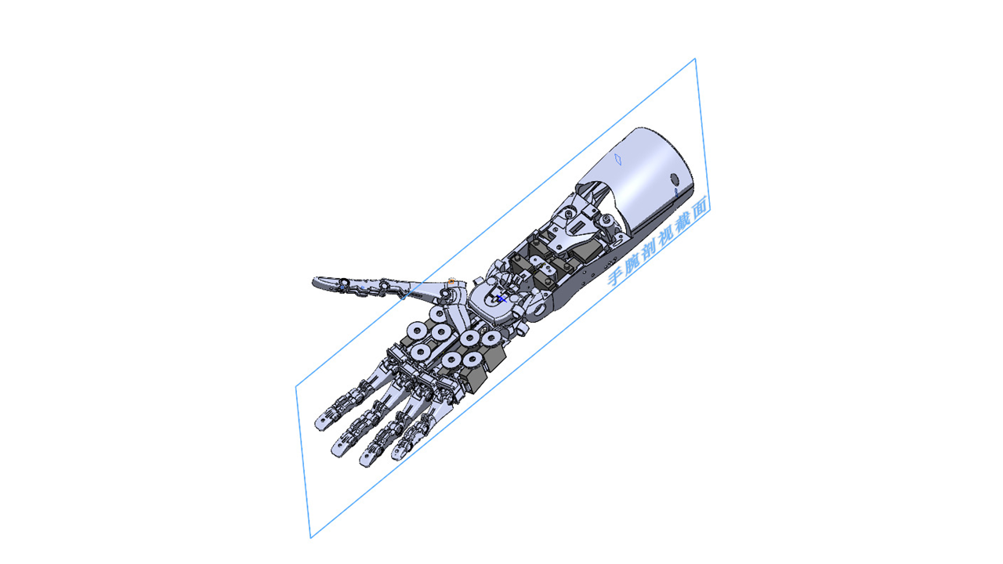
图片/改/2.png
