18871379330/mydexhand/图片/改/3.JPG

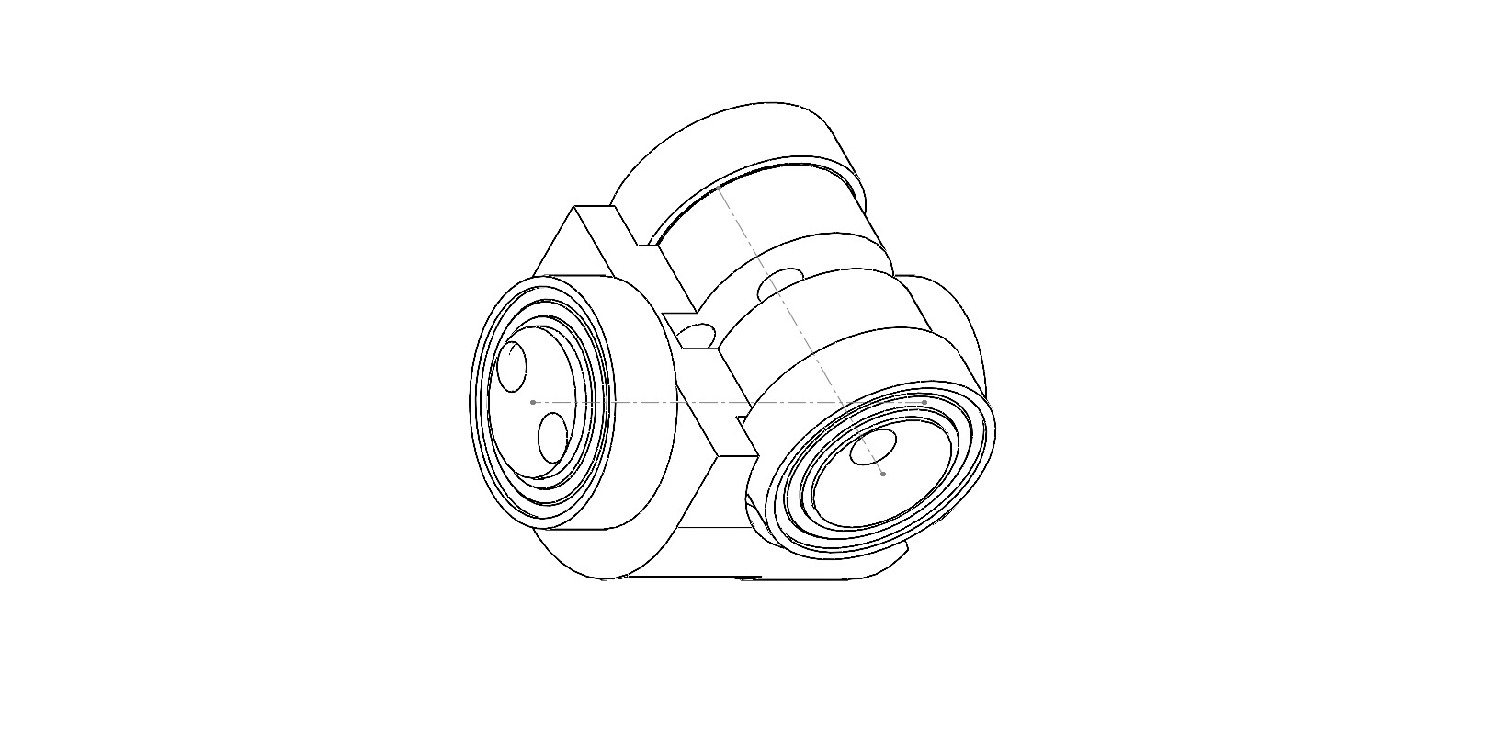
图片/改/3.JPG
