18871379330/mydexhand/图片/改/3.png

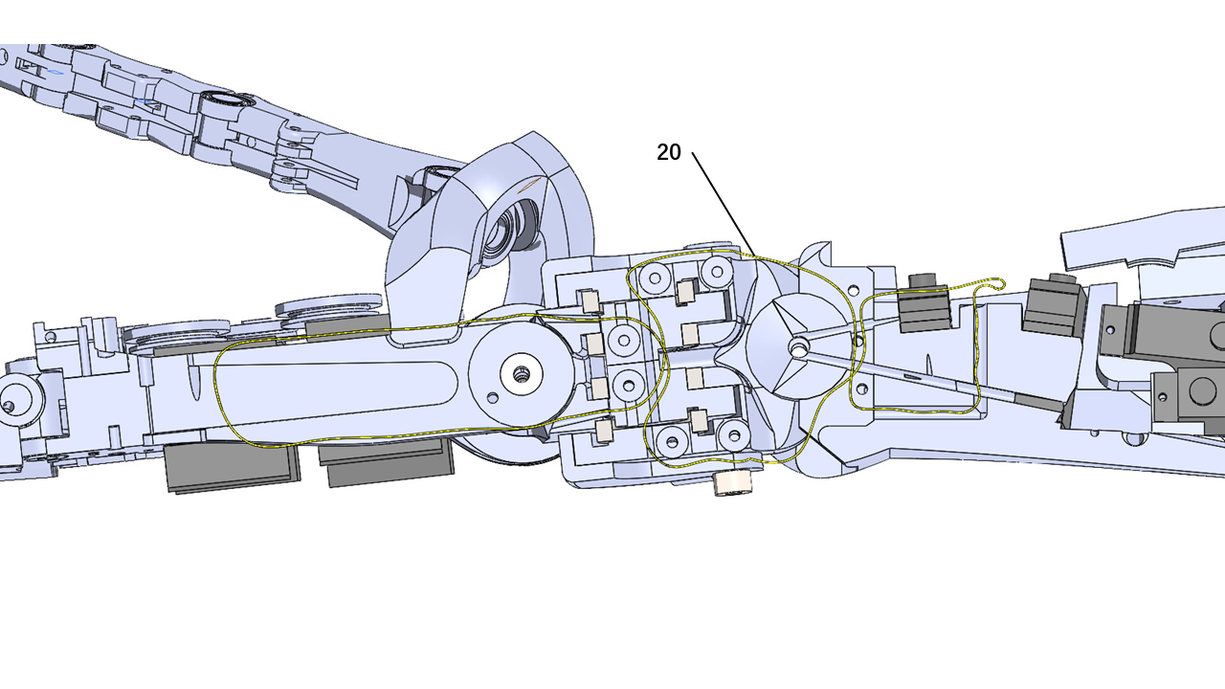
图片/改/3.png
