18871379330/mydexhand/图片/改/4.JPG

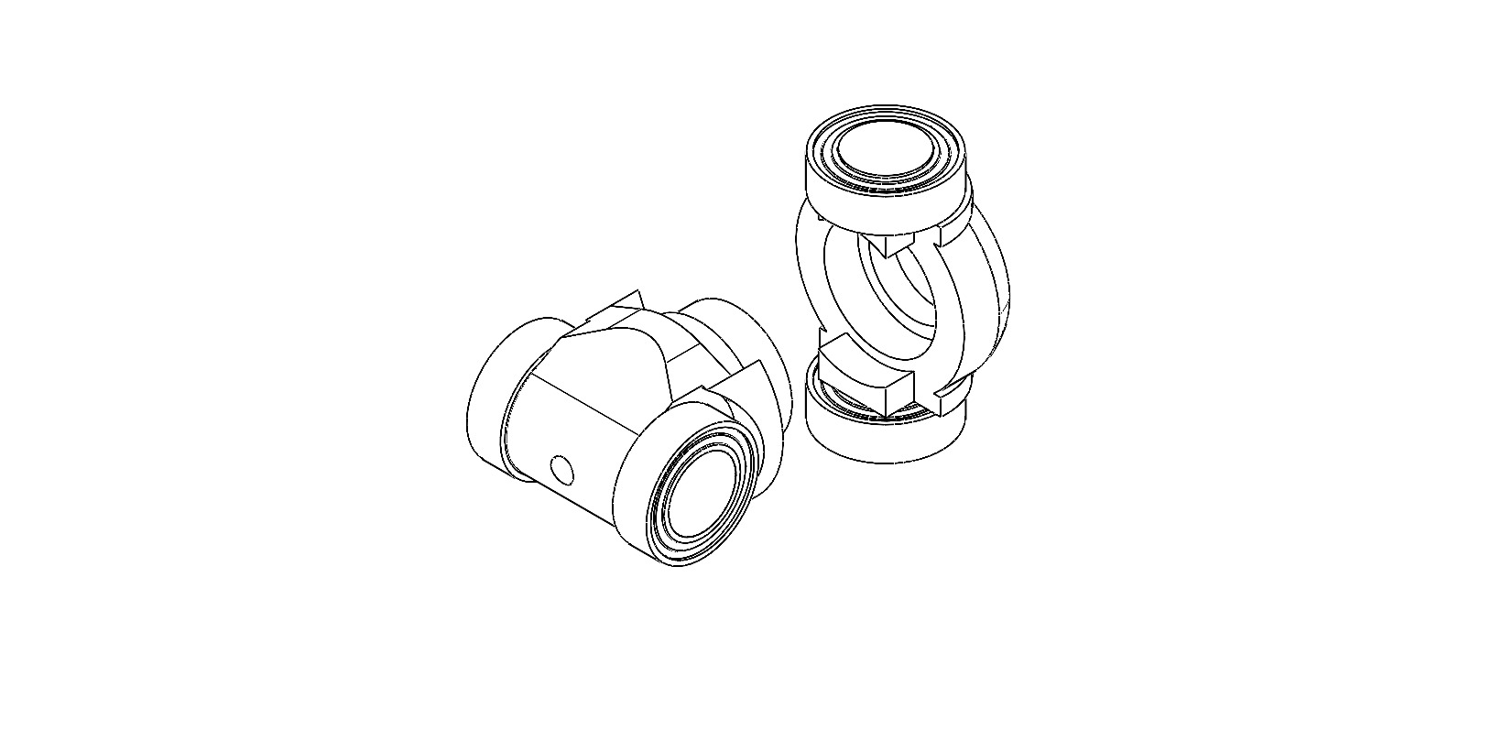
图片/改/4.JPG
