18871379330/mydexhand/图片/改/4.png

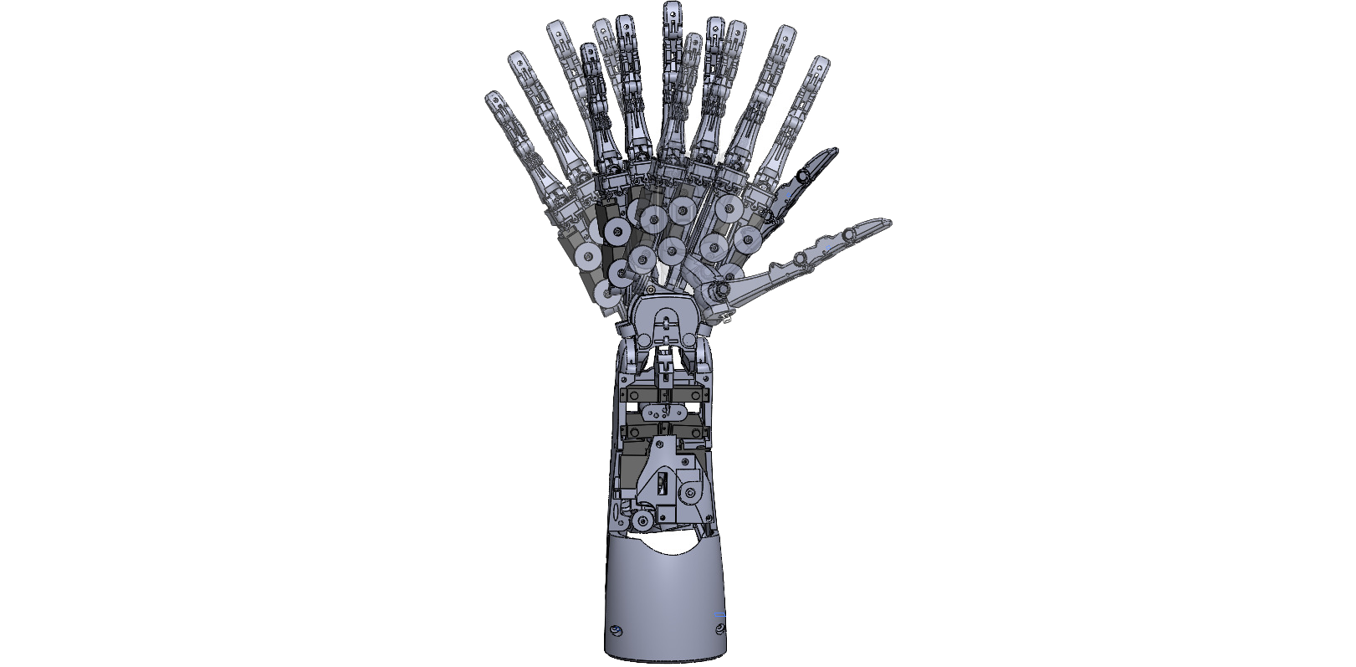
图片/改/4.png
