18871379330/mydexhand/图片/改/5.JPG

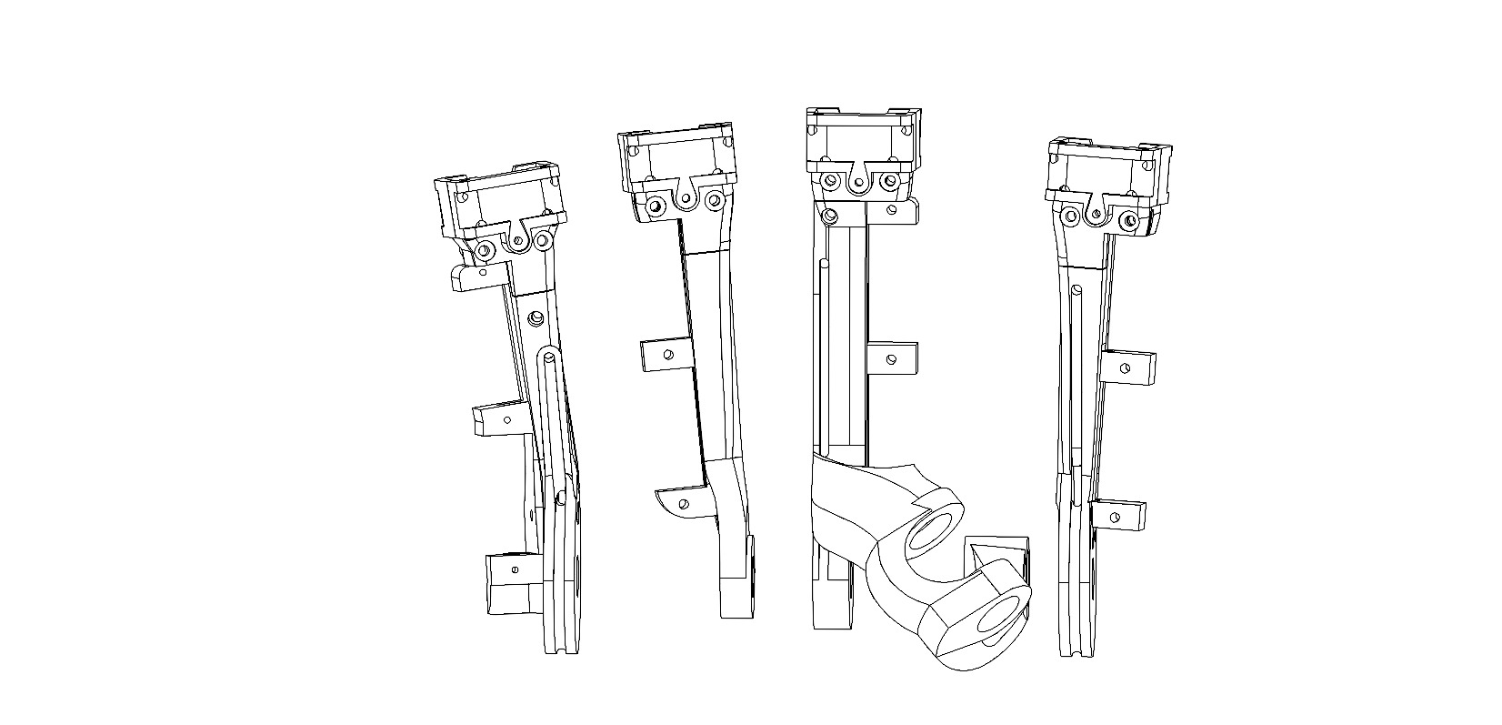
图片/改/5.JPG
