18871379330/mydexhand/图片/改/6.JPG

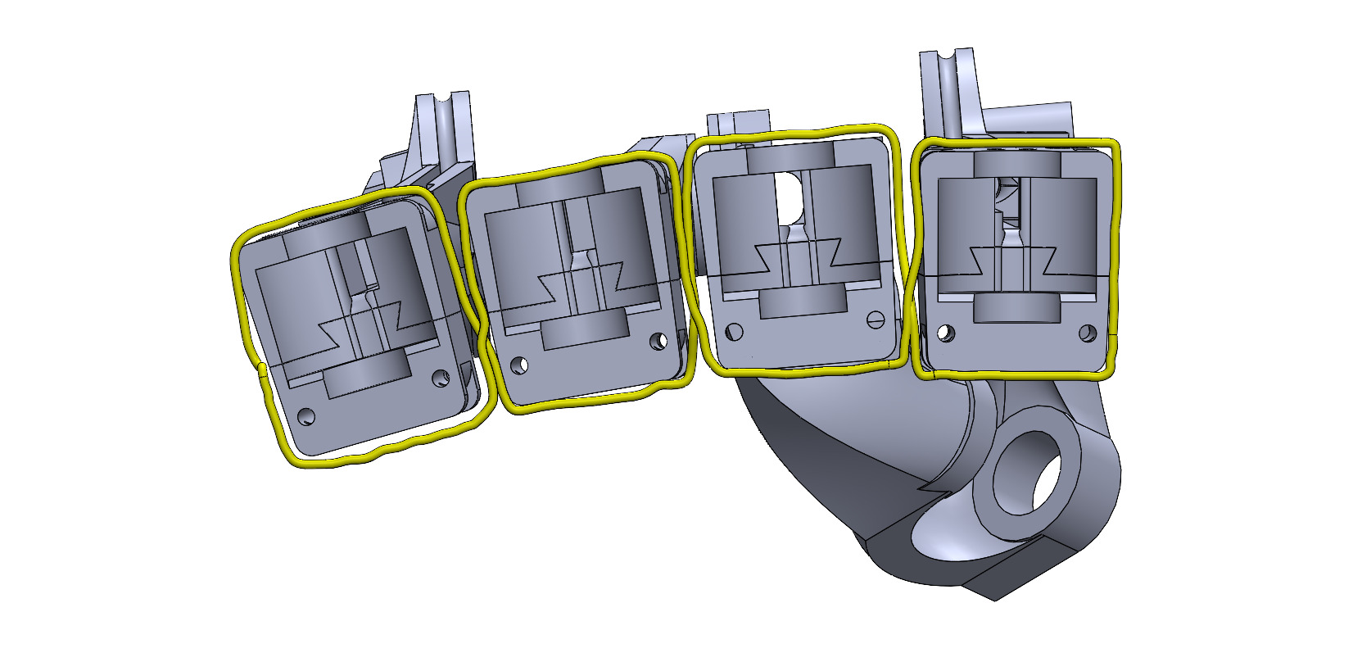
图片/改/6.JPG
