18871379330/mydexhand/图片/改/6dda69a8b73a3b55598555b6ed9f582.jpg

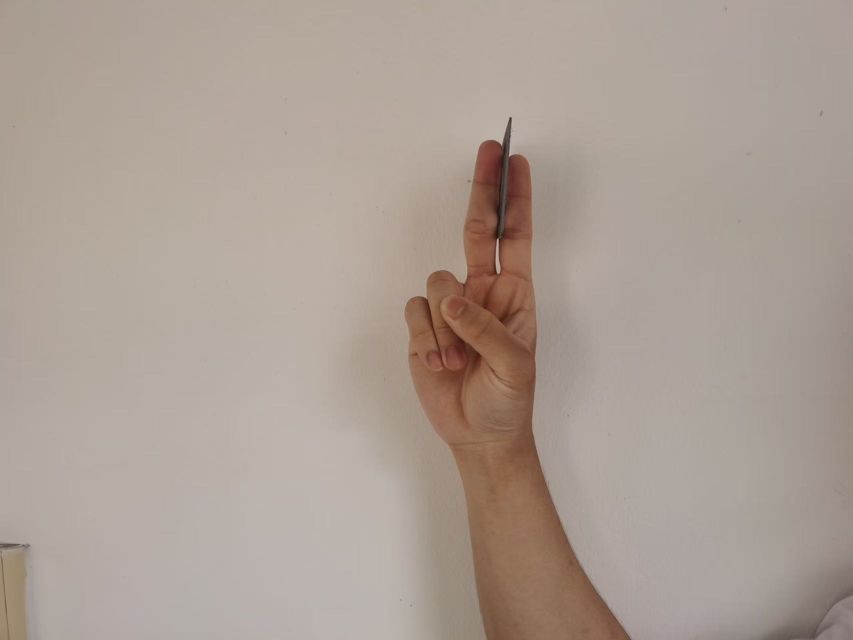
图片/改/6dda69a8b73a3b55598555b6ed9f582.jpg
