18871379330/mydexhand/图片/改/7.JPG

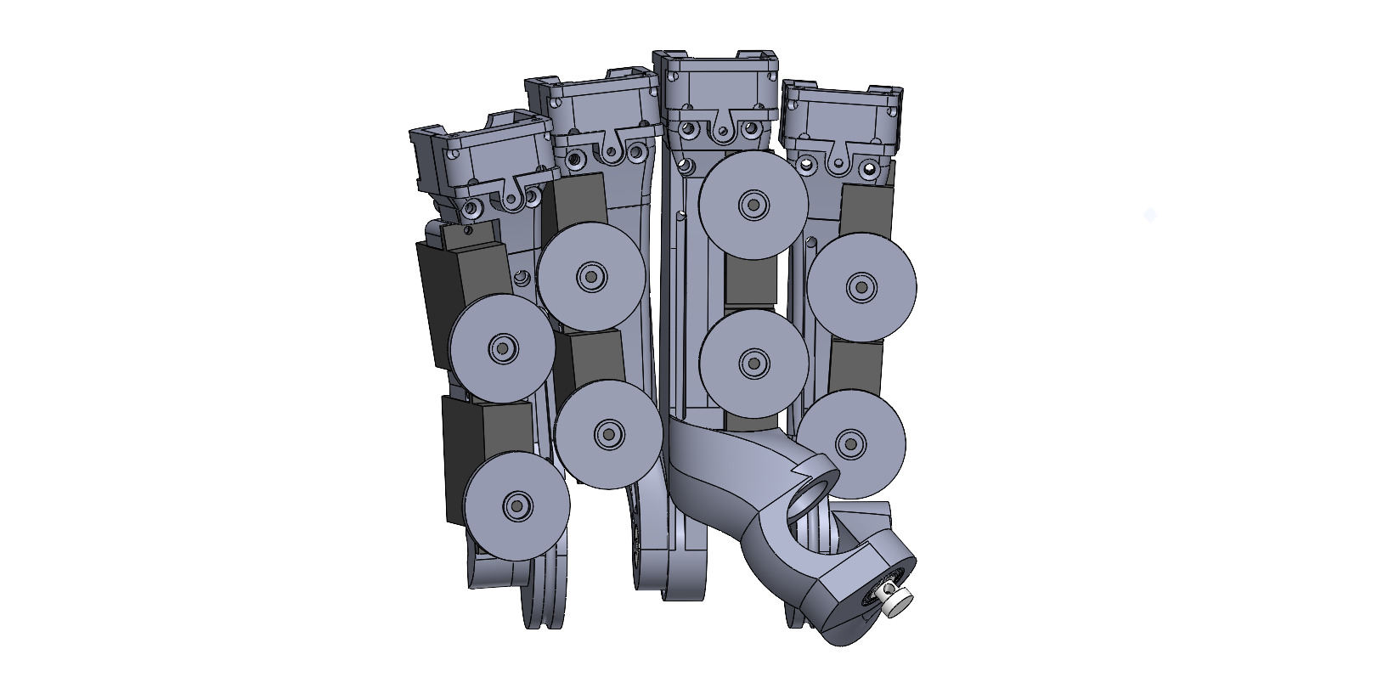
图片/改/7.JPG
