18871379330/mydexhand/图片/改/7.png

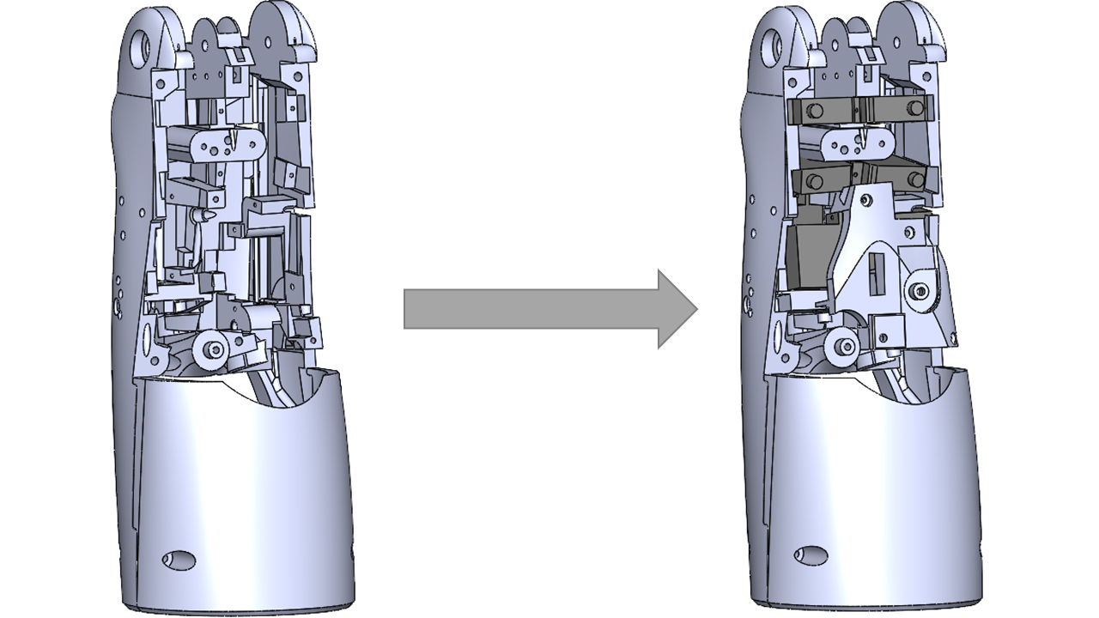
图片/改/7.png
