18871379330/mydexhand/图片/改/8.JPG

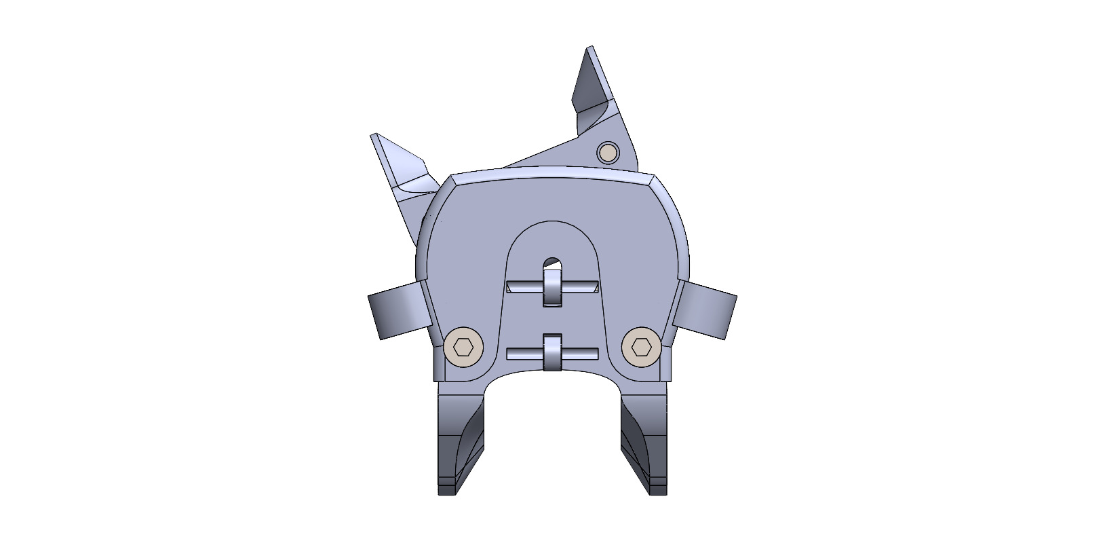
图片/改/8.JPG
