18871379330/mydexhand/图片/改/8.png

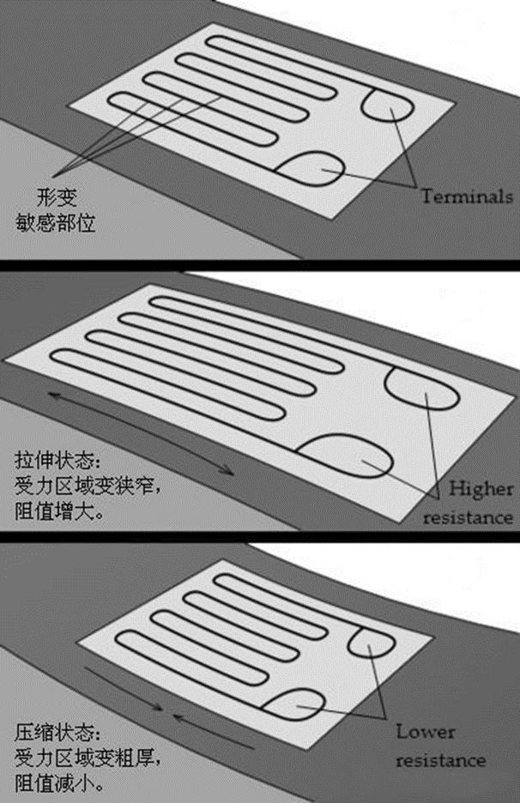
图片/改/8.png
