18871379330/mydexhand/图片/改/9.png

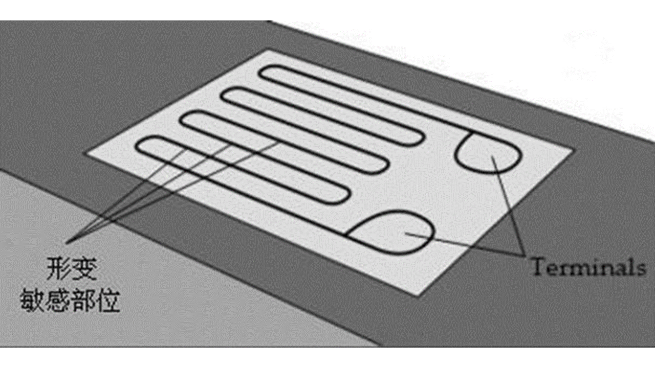
图片/改/9.png
