18871379330/mydexhand/图片/改/10.png

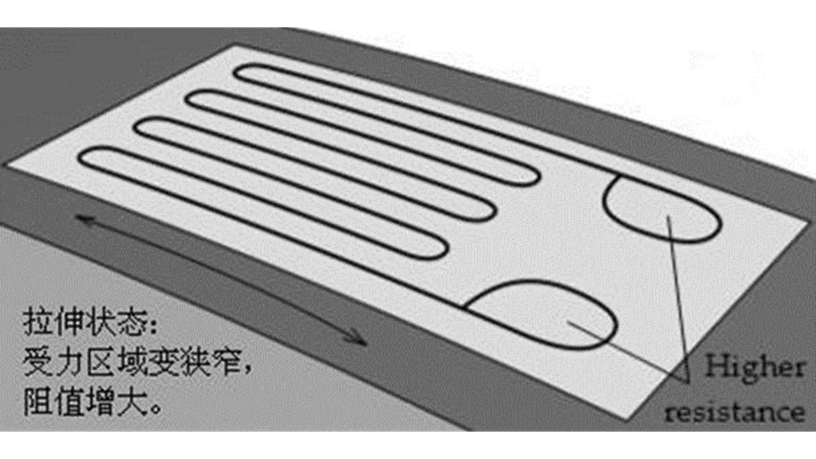
图片/改/10.png
