18871379330/mydexhand/图片/改/11.png

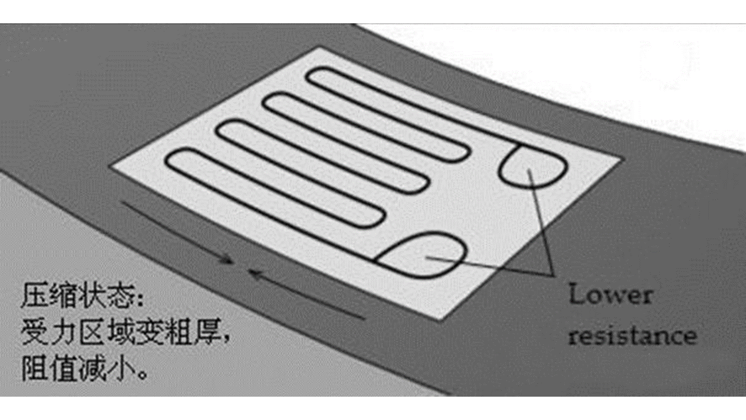
图片/改/11.png
