18871379330/mydexhand/图片/改/12.png

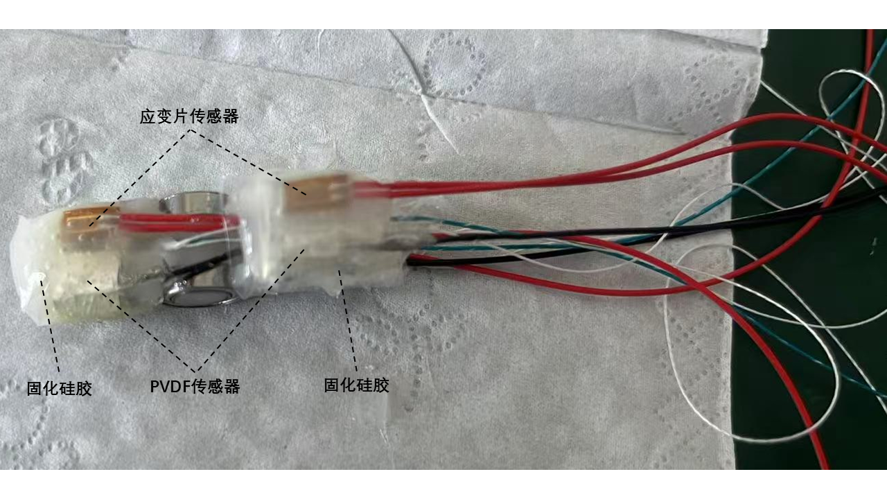
图片/改/12.png
