18871379330/mydexhand/图片/改/13.png

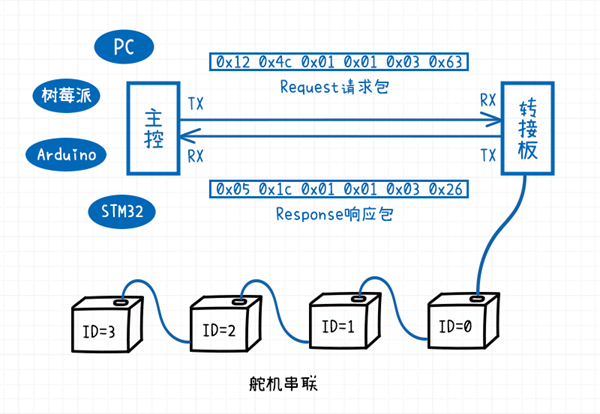
图片/改/13.png
