18871379330/mydexhand/图片/改/14.JPG

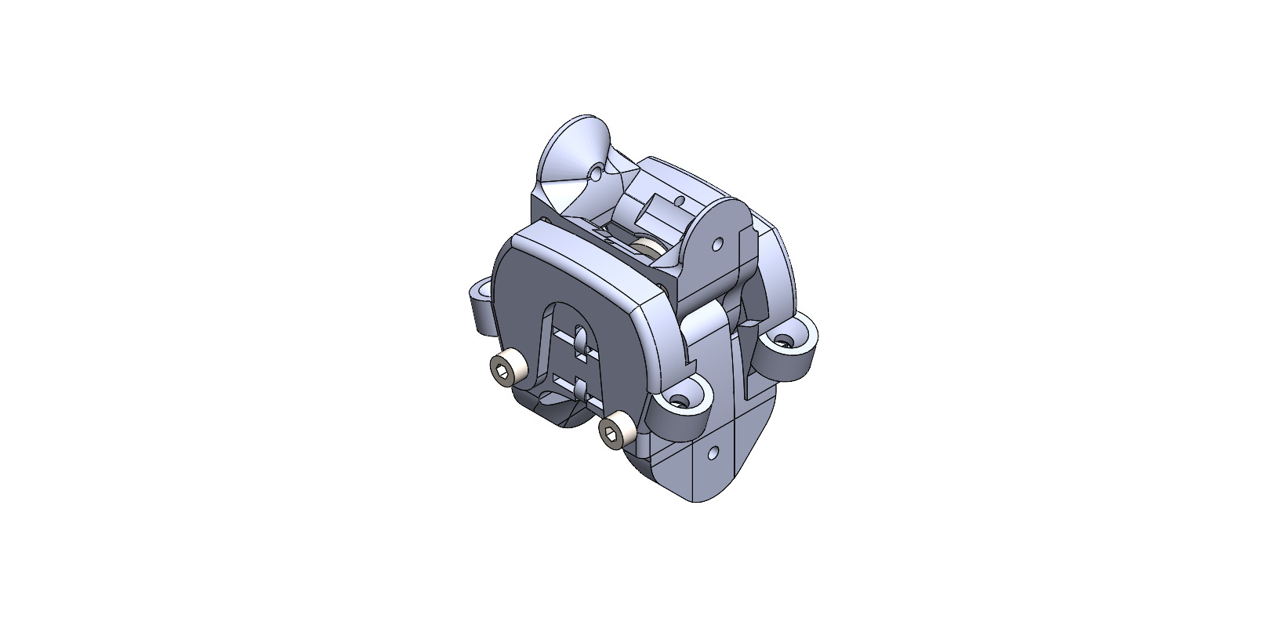
图片/改/14.JPG
