18871379330/mydexhand/图片/改/14.png

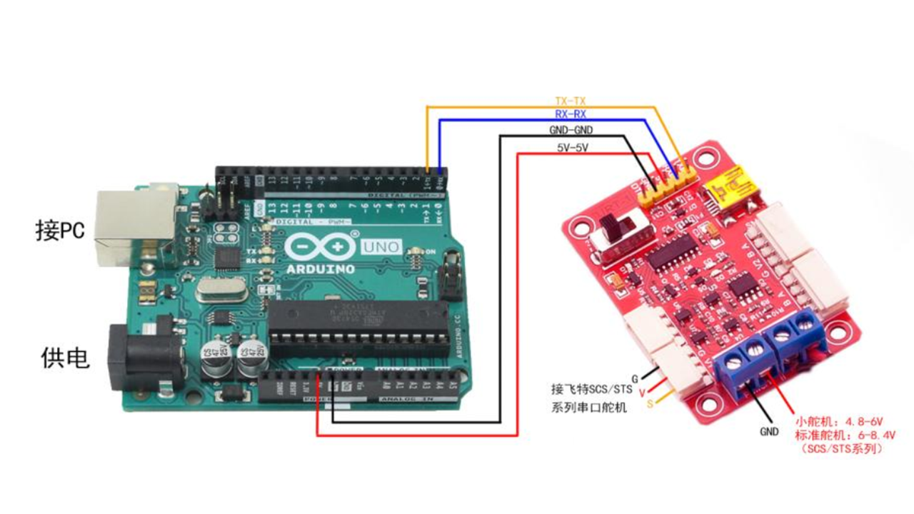
图片/改/14.png
