18871379330/mydexhand/图片/改/15.JPG

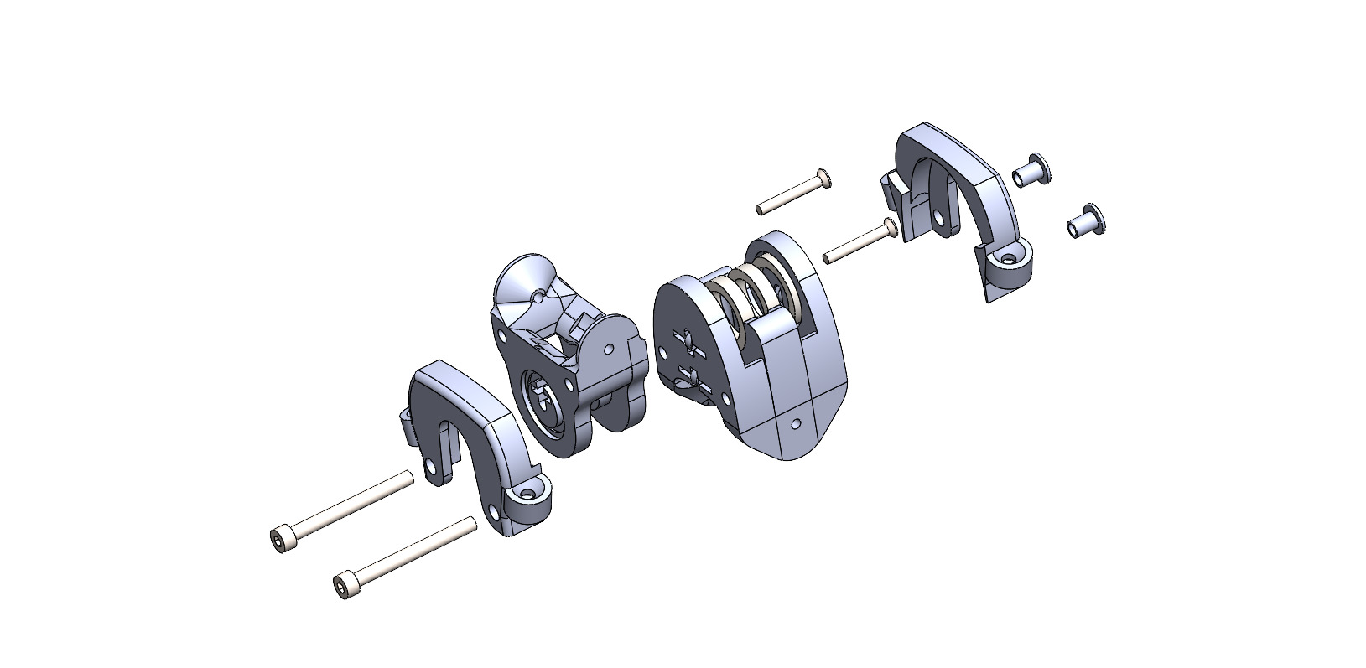
图片/改/15.JPG
