18871379330/mydexhand/图片/改/15.png

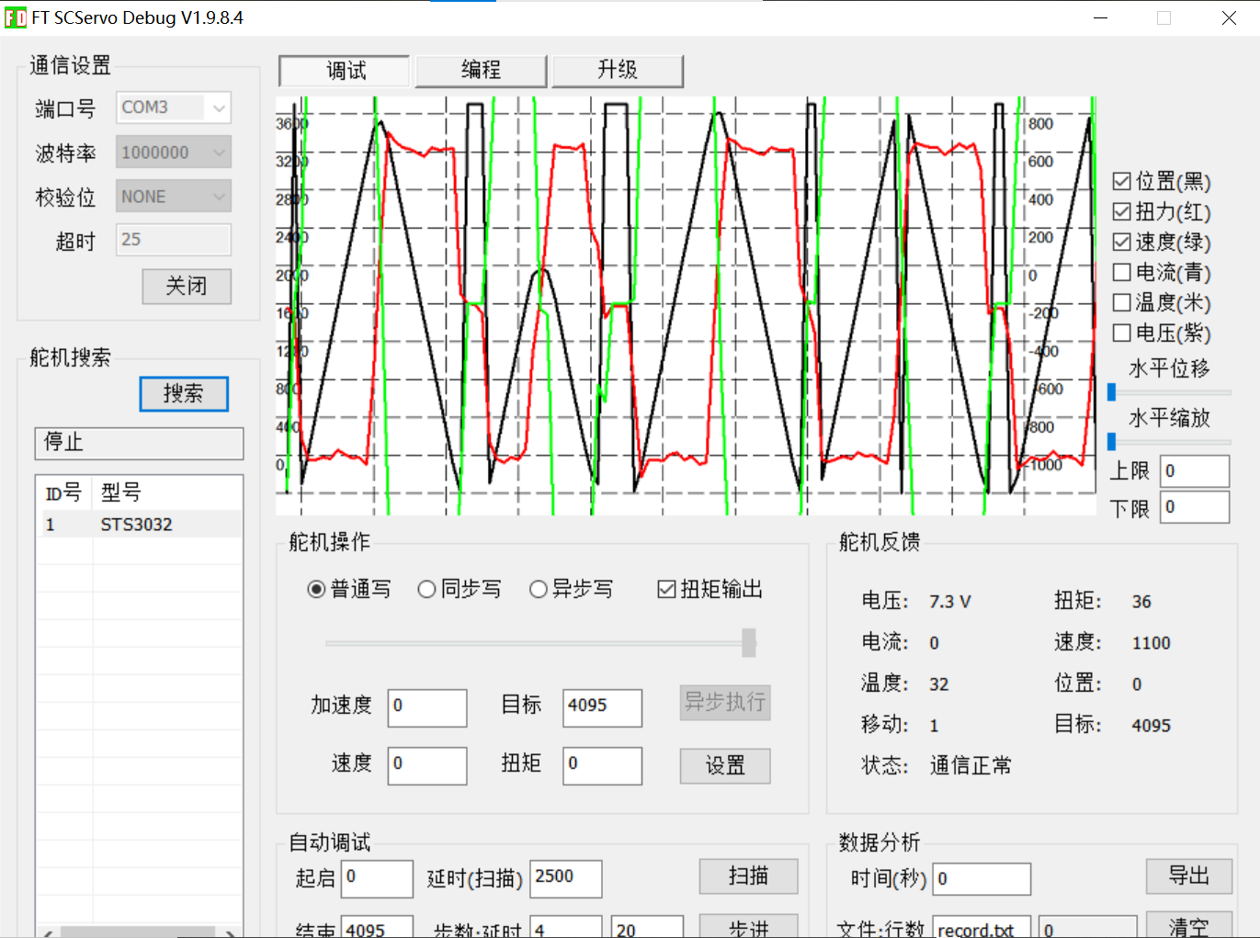
图片/改/15.png
