18871379330/mydexhand/图片/改/16.JPG

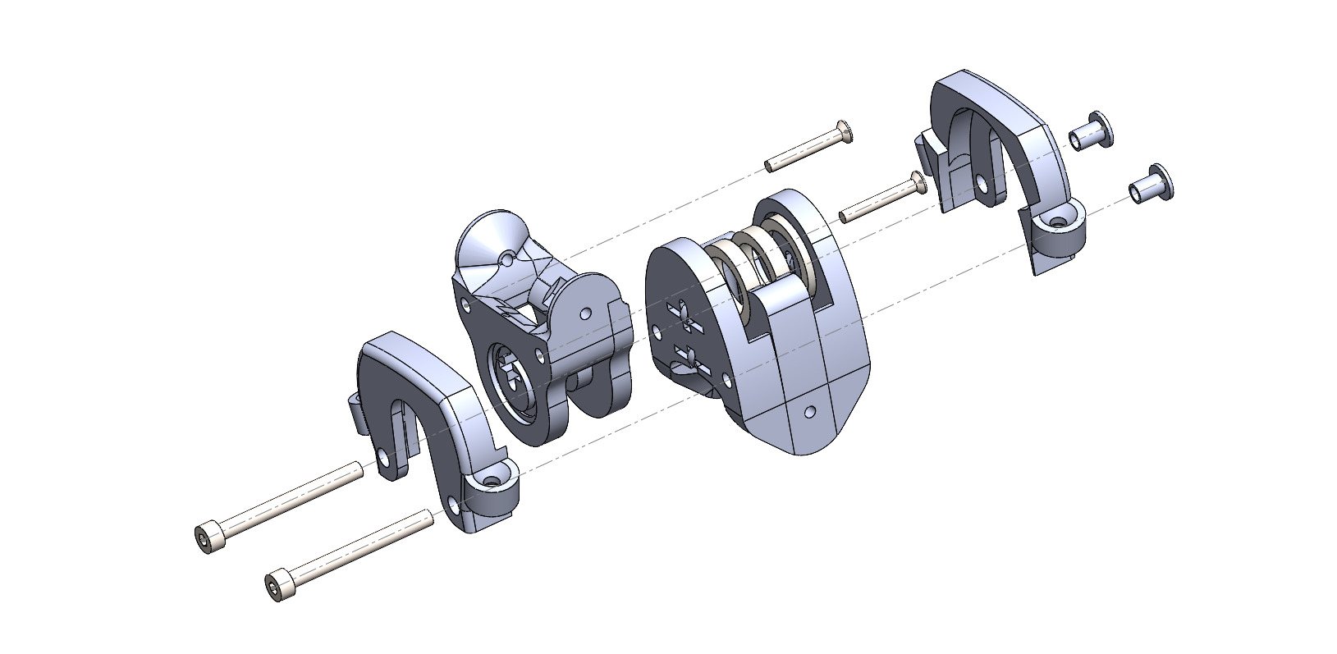
图片/改/16.JPG
