18871379330/mydexhand/图片/改/16.png

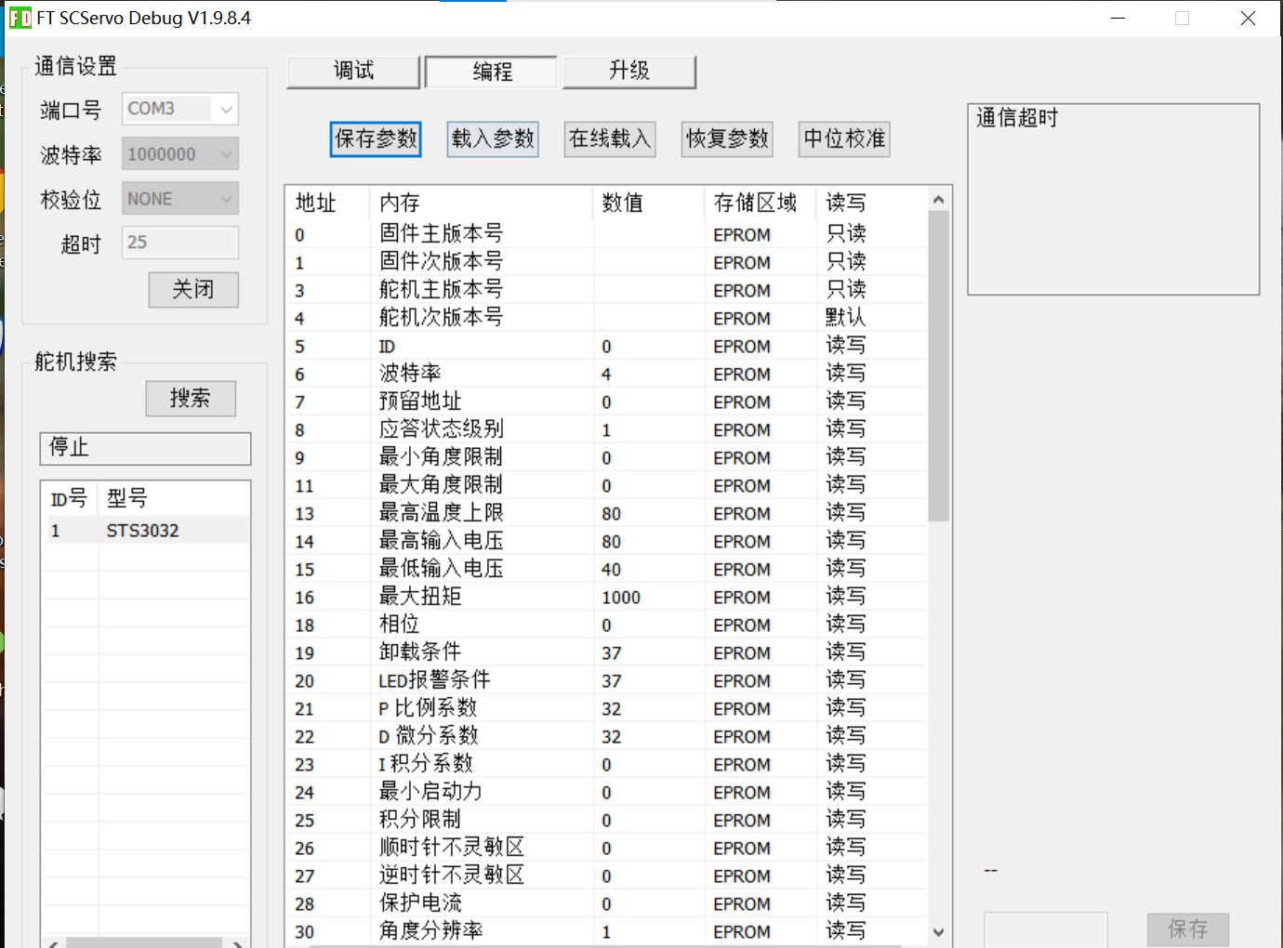
图片/改/16.png
