18871379330/mydexhand/图片/改/17.JPG

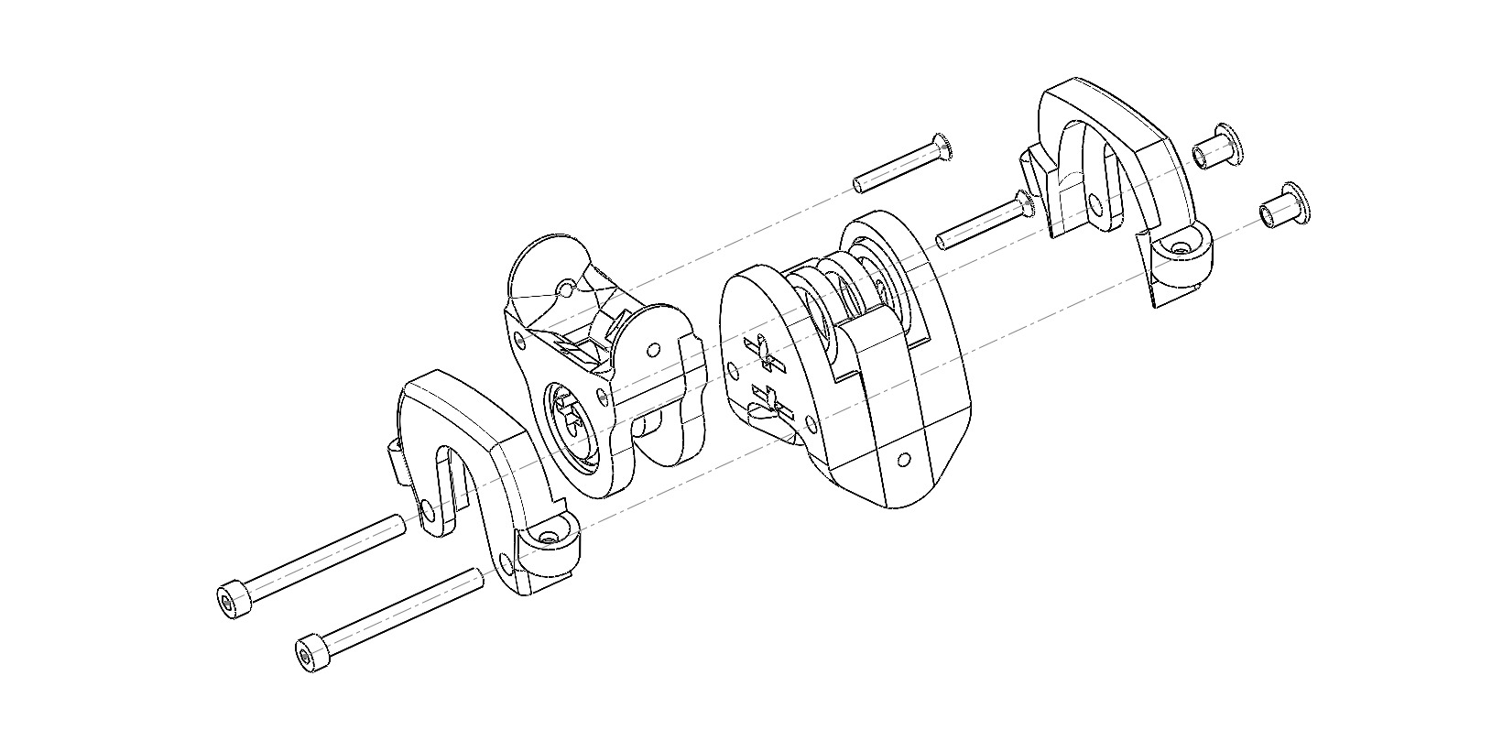
图片/改/17.JPG
