18871379330/mydexhand/图片/改/17.png

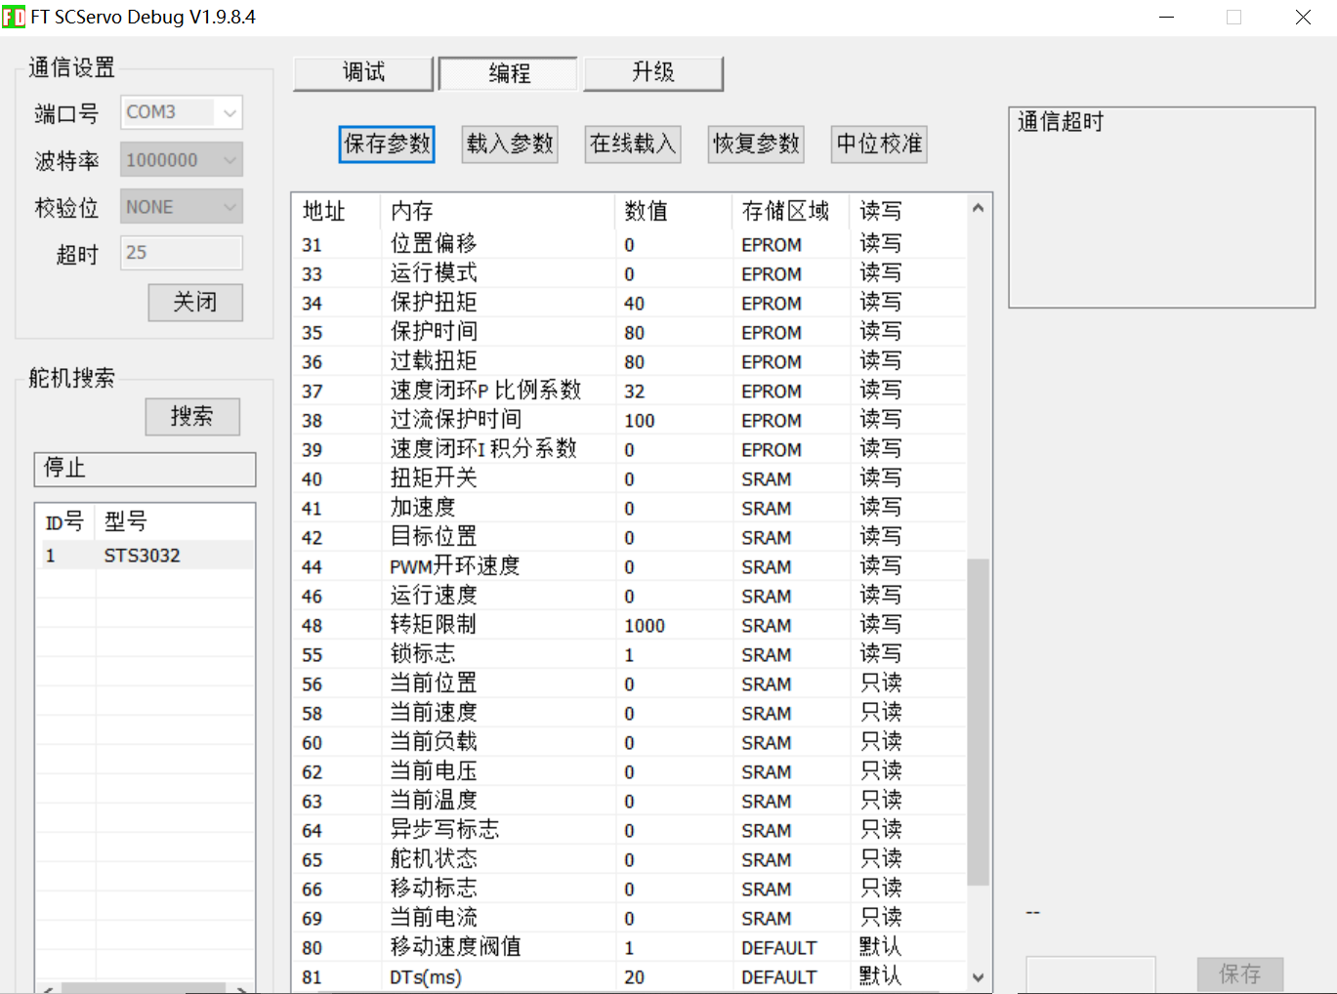
图片/改/17.png
