18871379330/mydexhand/图片/改/18.png

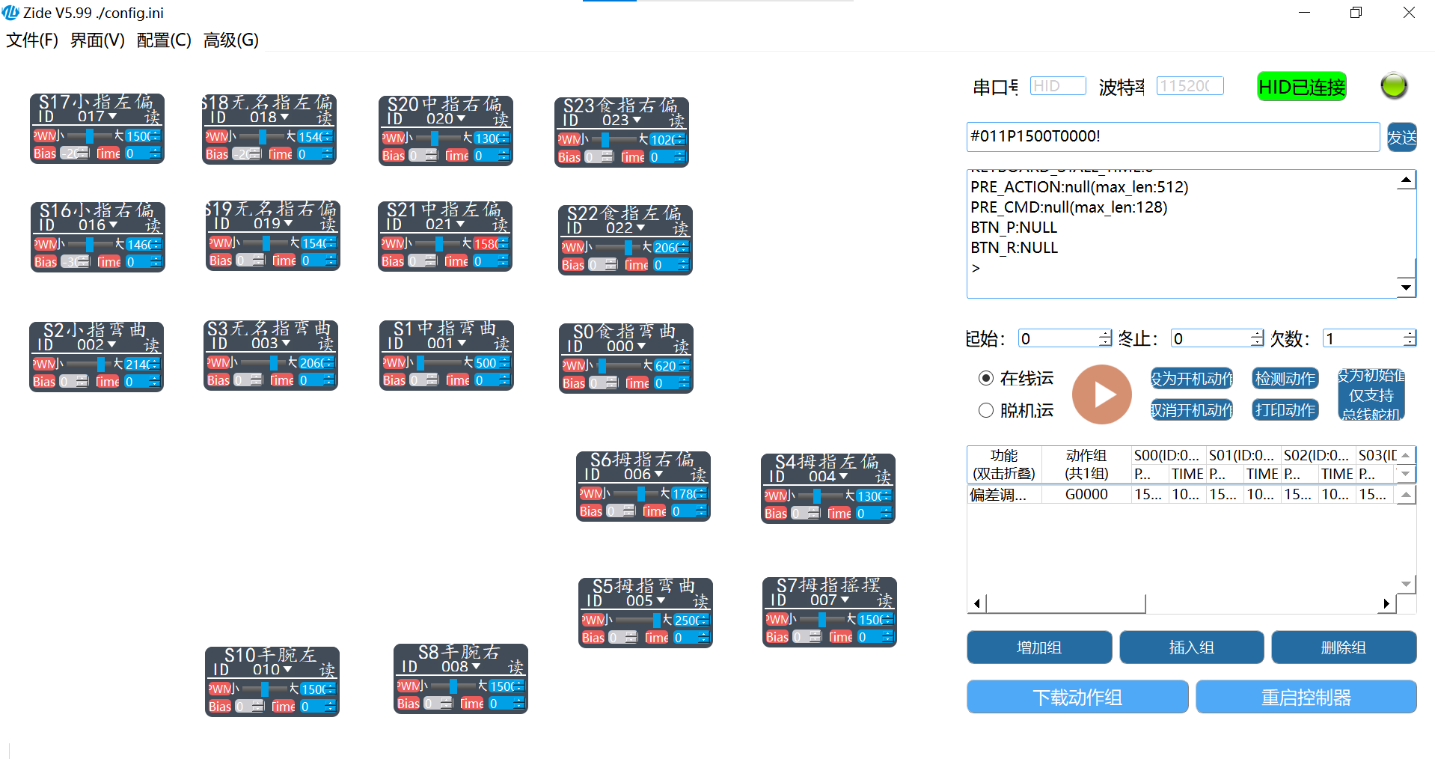
图片/改/18.png
