18871379330/mydexhand/图片/改/19.png

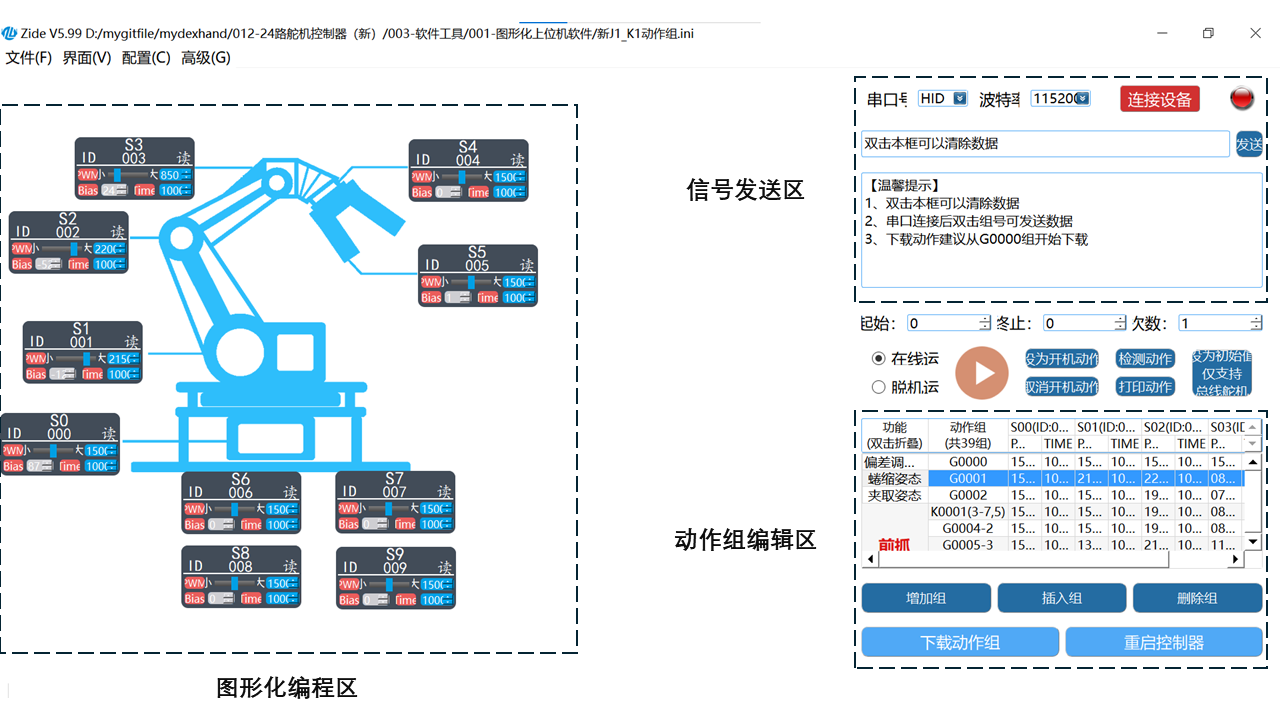
图片/改/19.png
