18871379330/mydexhand/图片/改/20.JPG

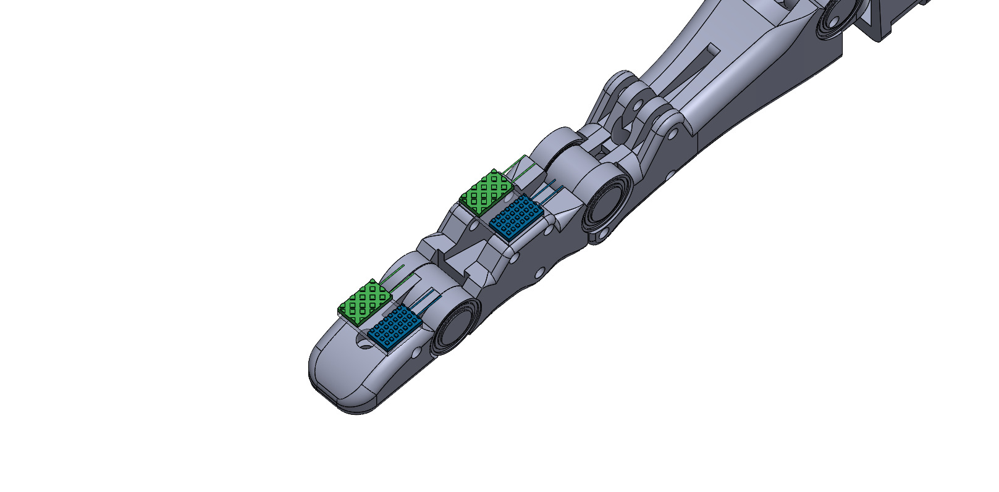
图片/改/20.JPG
