18871379330/mydexhand/图片/改/20.png

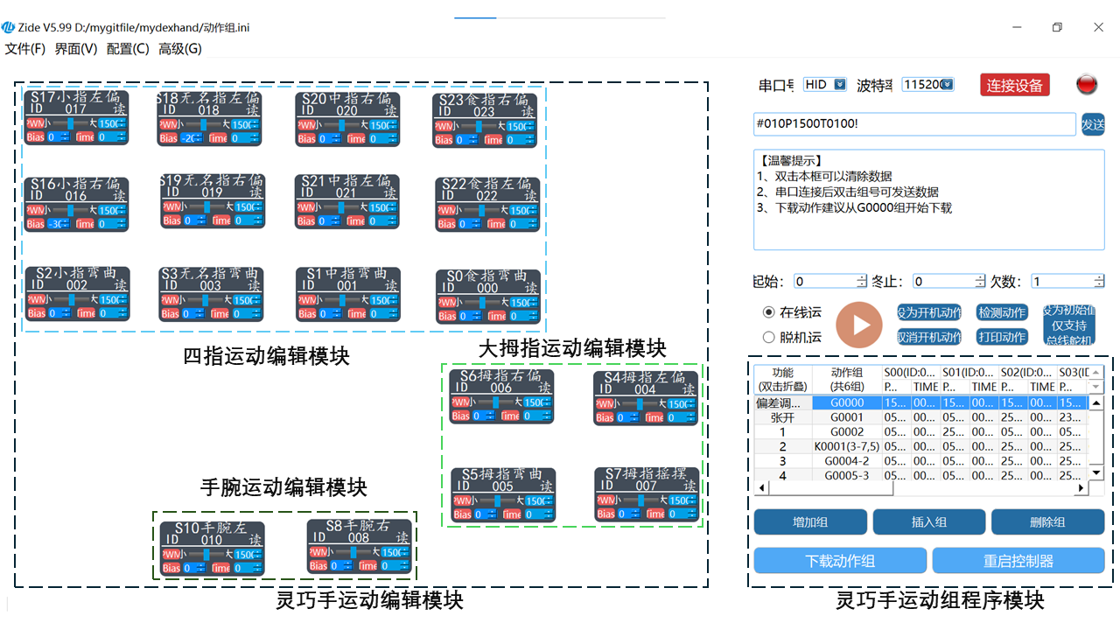
图片/改/20.png
