18871379330/mydexhand/图片/改/21.JPG

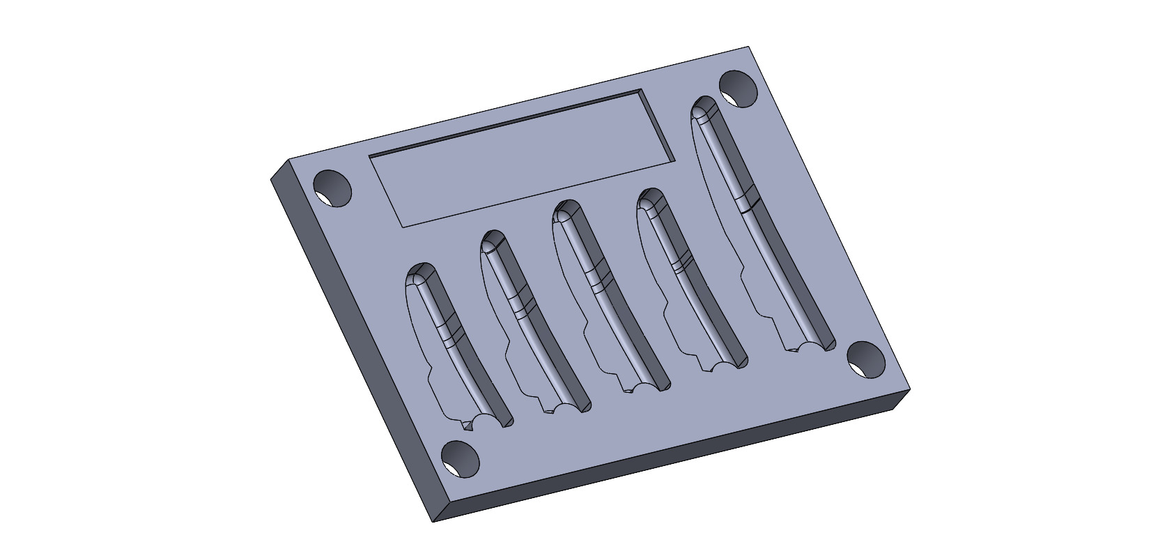
图片/改/21.JPG
