18871379330/mydexhand/图片/改/21.png

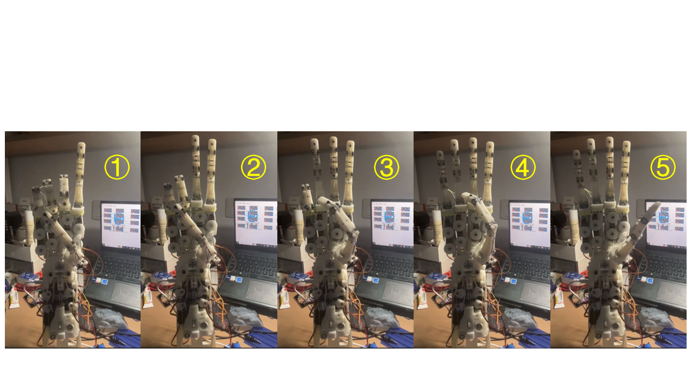
图片/改/21.png
