18871379330/mydexhand/图片/改/22.png

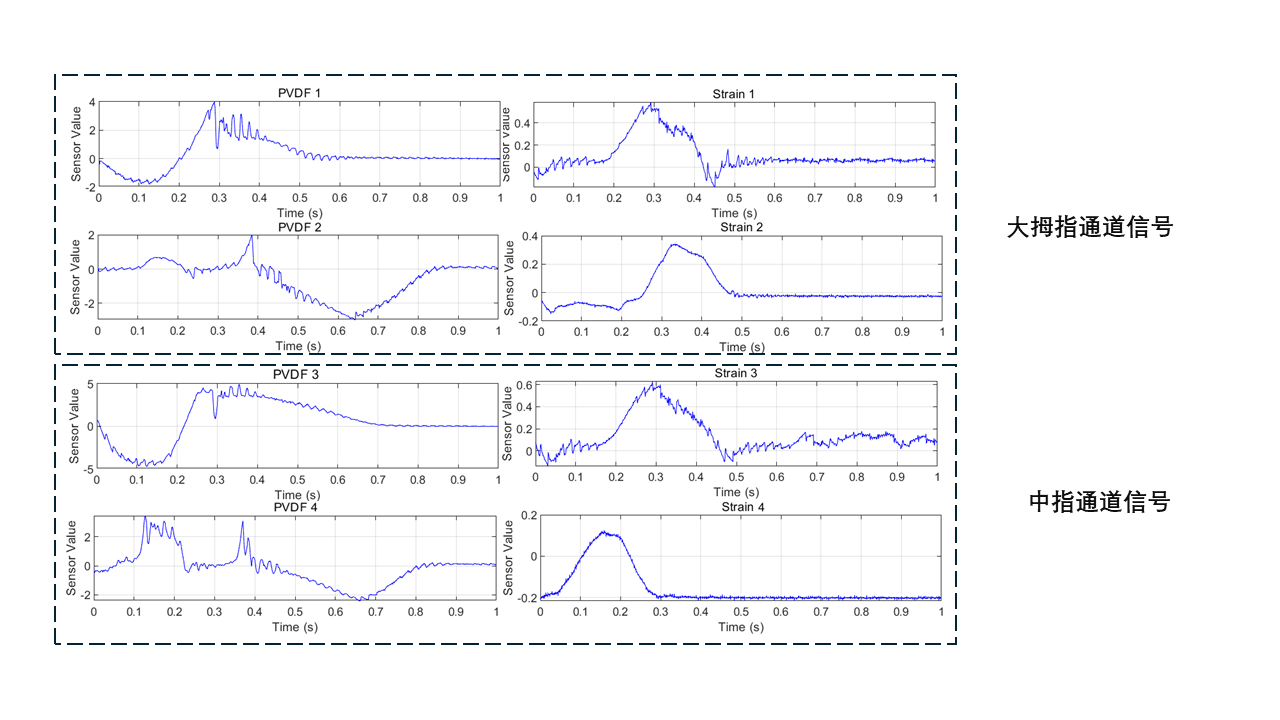
图片/改/22.png
