18871379330/mydexhand/图片/改/23.JPG

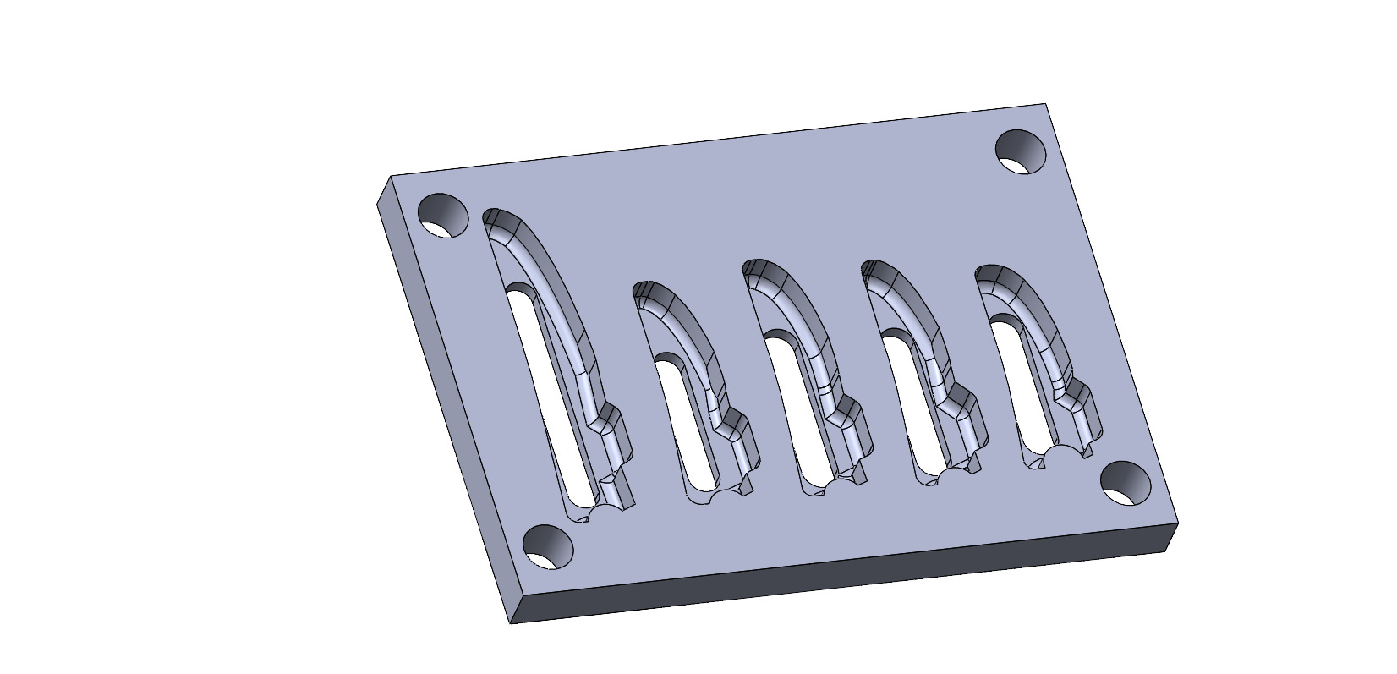
图片/改/23.JPG
