18871379330/mydexhand/图片/改/23.png

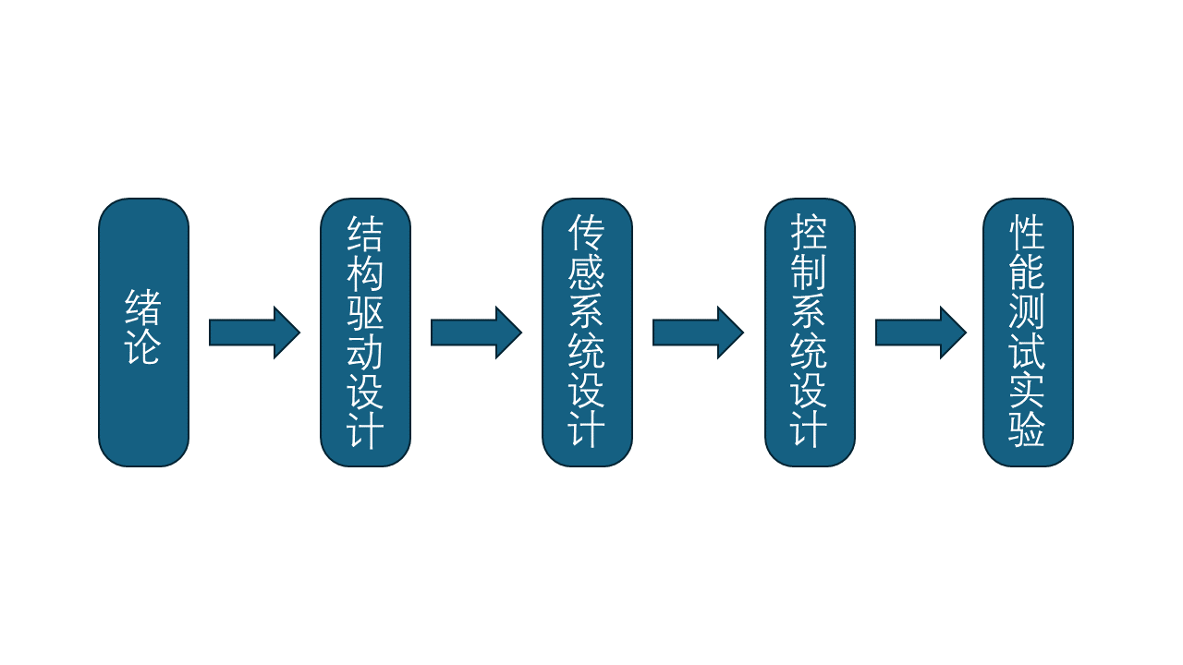
图片/改/23.png
