18871379330/mydexhand/图片/改/24.png

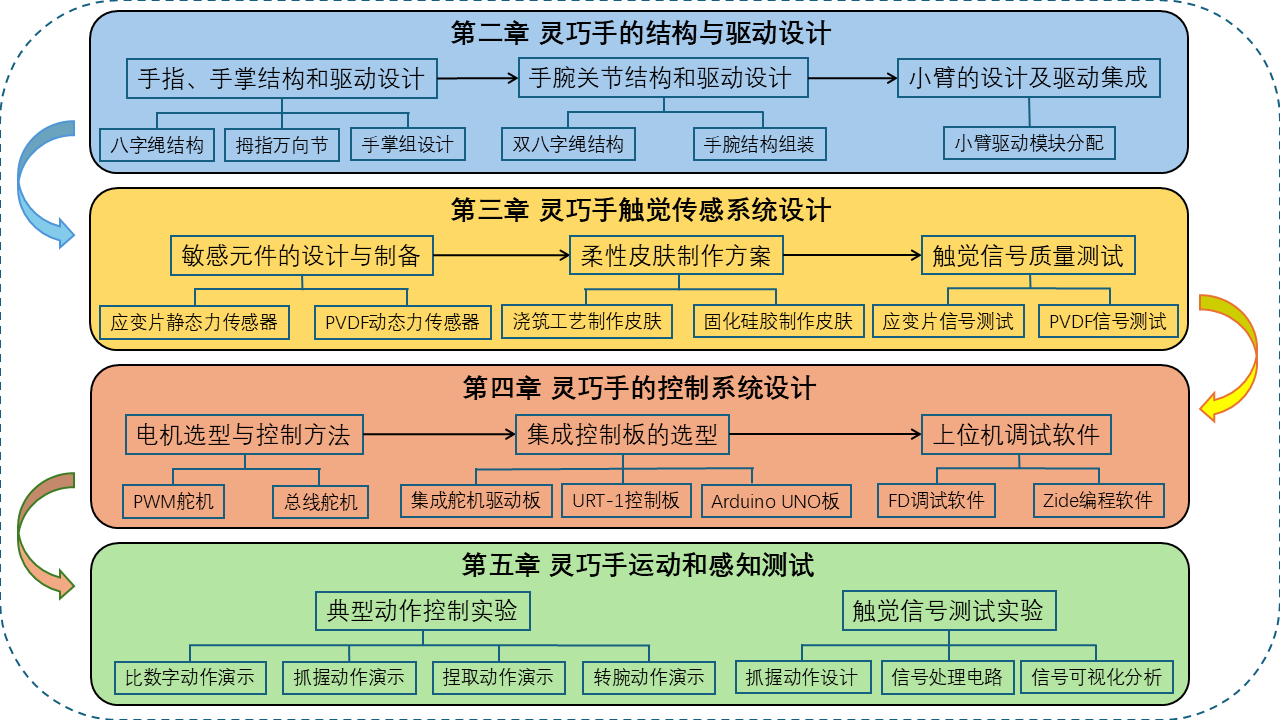
图片/改/24.png
