18871379330/mydexhand/图片/改/c2ba5e500e54790c811ce73297c8e16.jpg

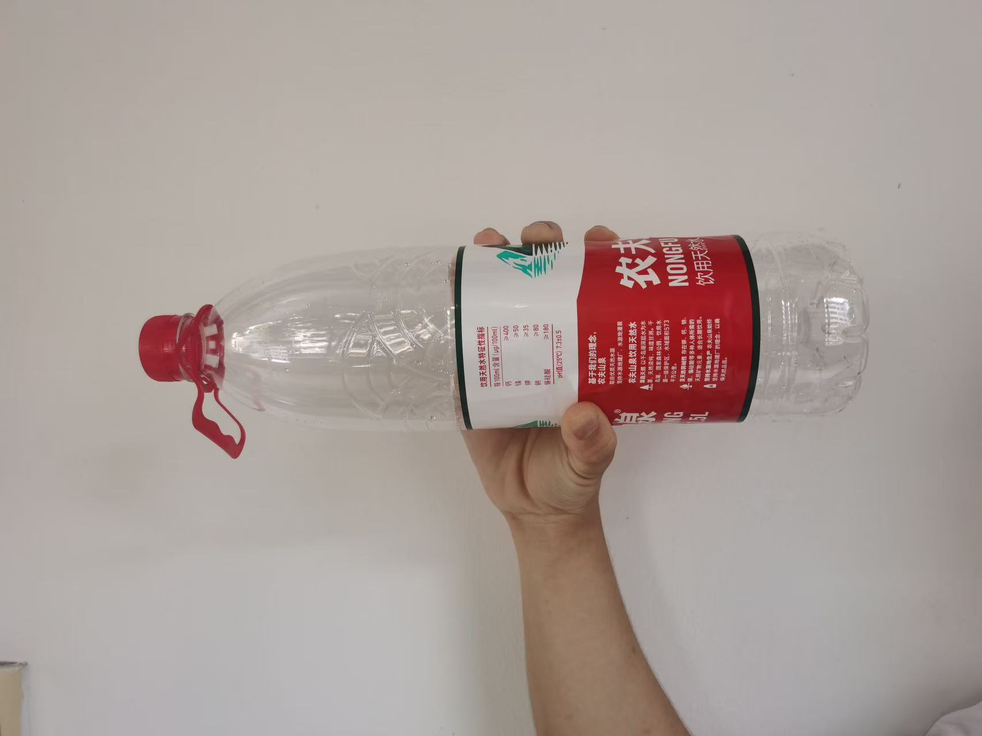
图片/改/c2ba5e500e54790c811ce73297c8e16.jpg
