18871379330/mydexhand/图片/改/c2fc1fa153cf6ef75d1d3a8559ed708.jpg

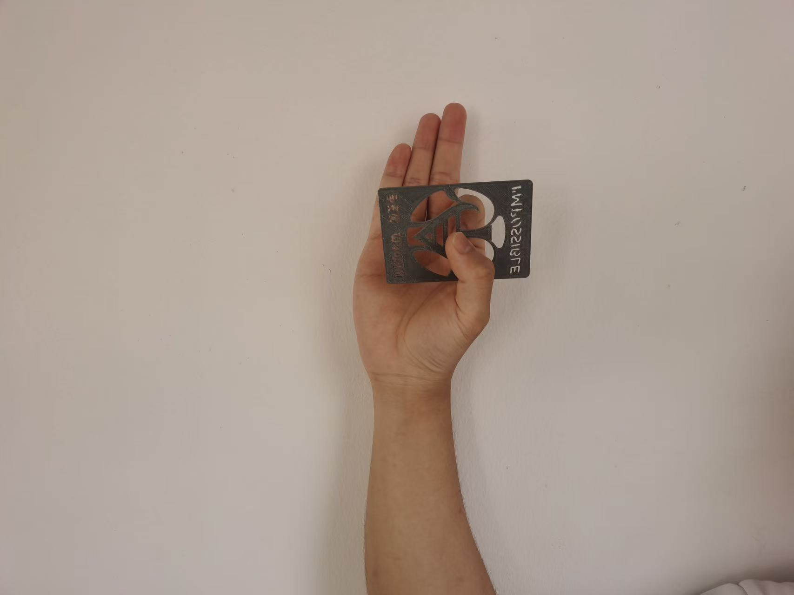
图片/改/c2fc1fa153cf6ef75d1d3a8559ed708.jpg
