18871379330/mydexhand/图片/改/e540b4355033a3e2ad2546f39fca562c.jpeg

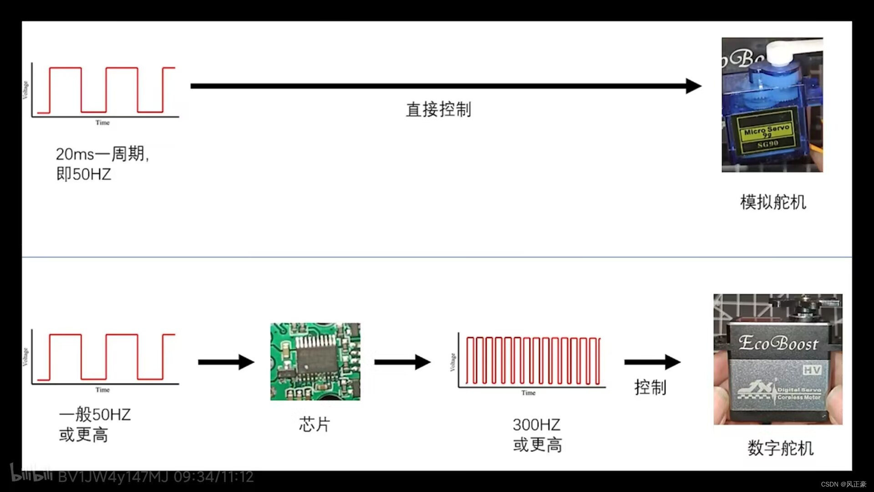
图片/改/e540b4355033a3e2ad2546f39fca562c.jpeg
