18871379330/mydexhand/图片/改/上手.JPG

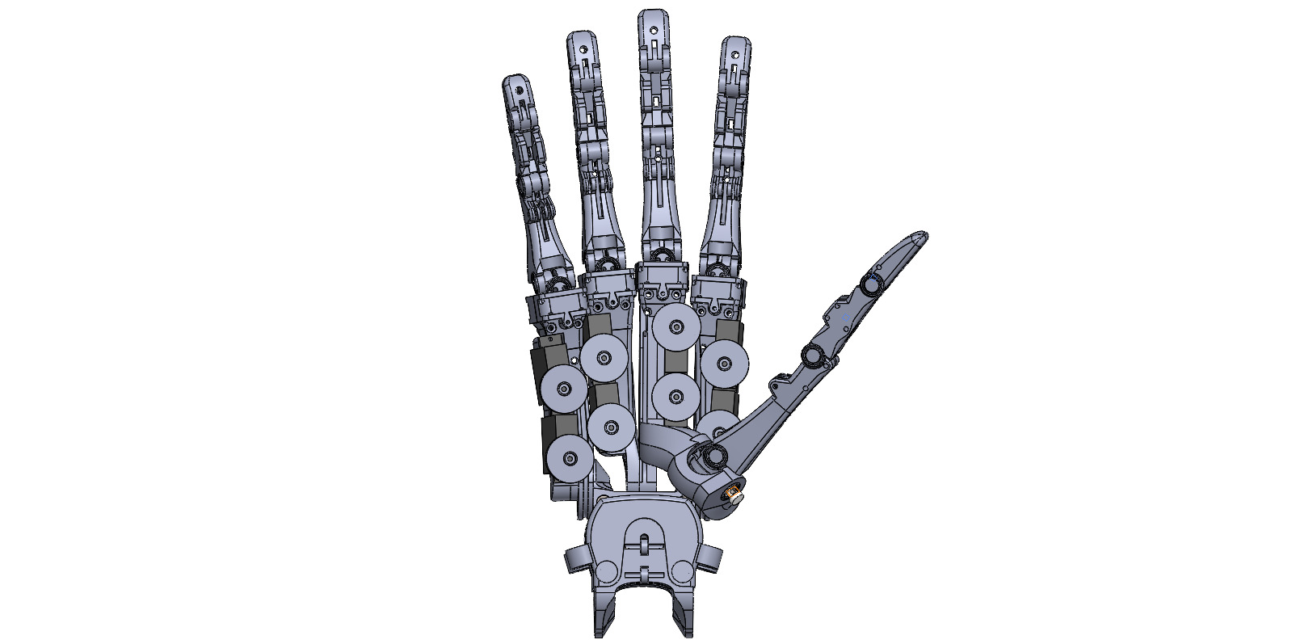
图片/改/上手.JPG
