18871379330/mydexhand/图片/改/八字绳.JPG

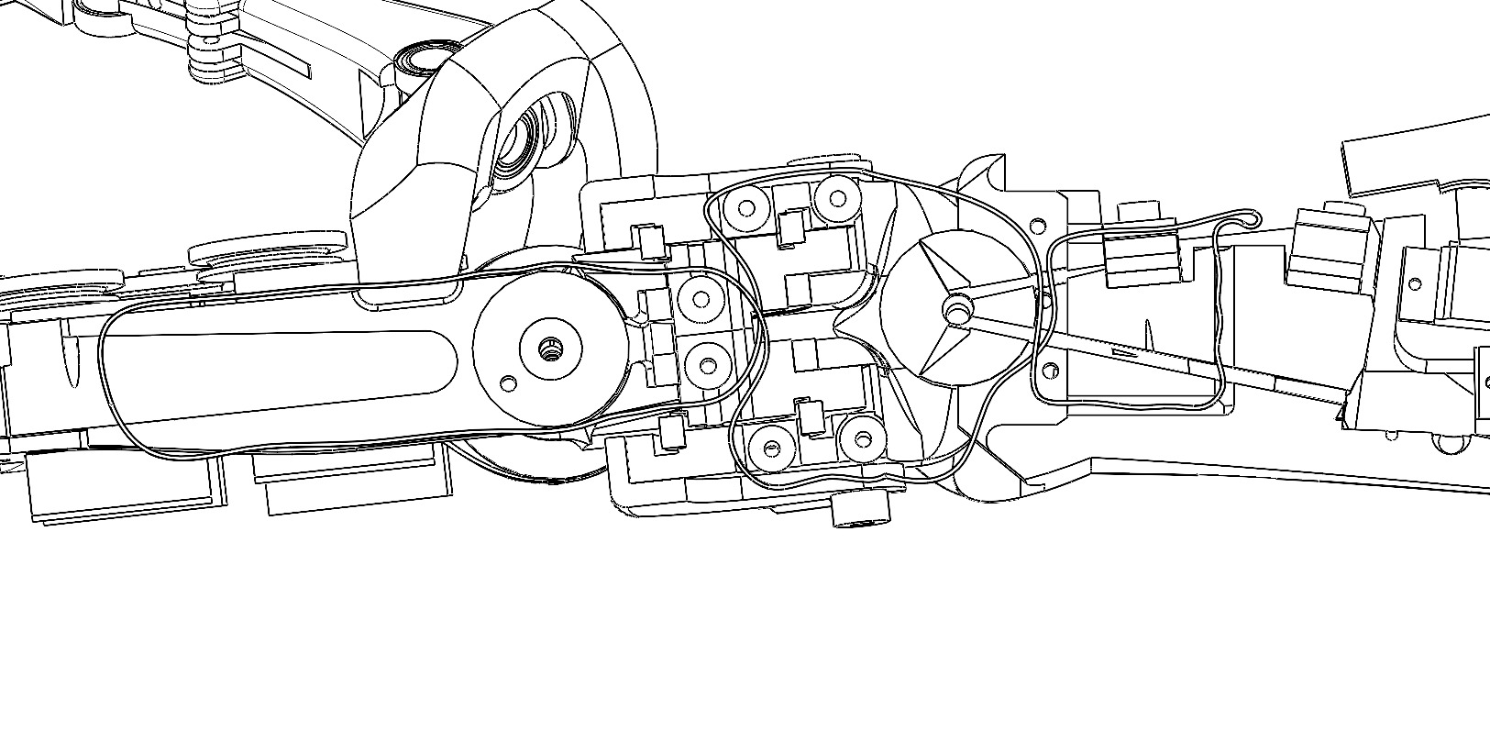
图片/改/八字绳.JPG
