18871379330/mydexhand/图片/改/大拇指.JPG

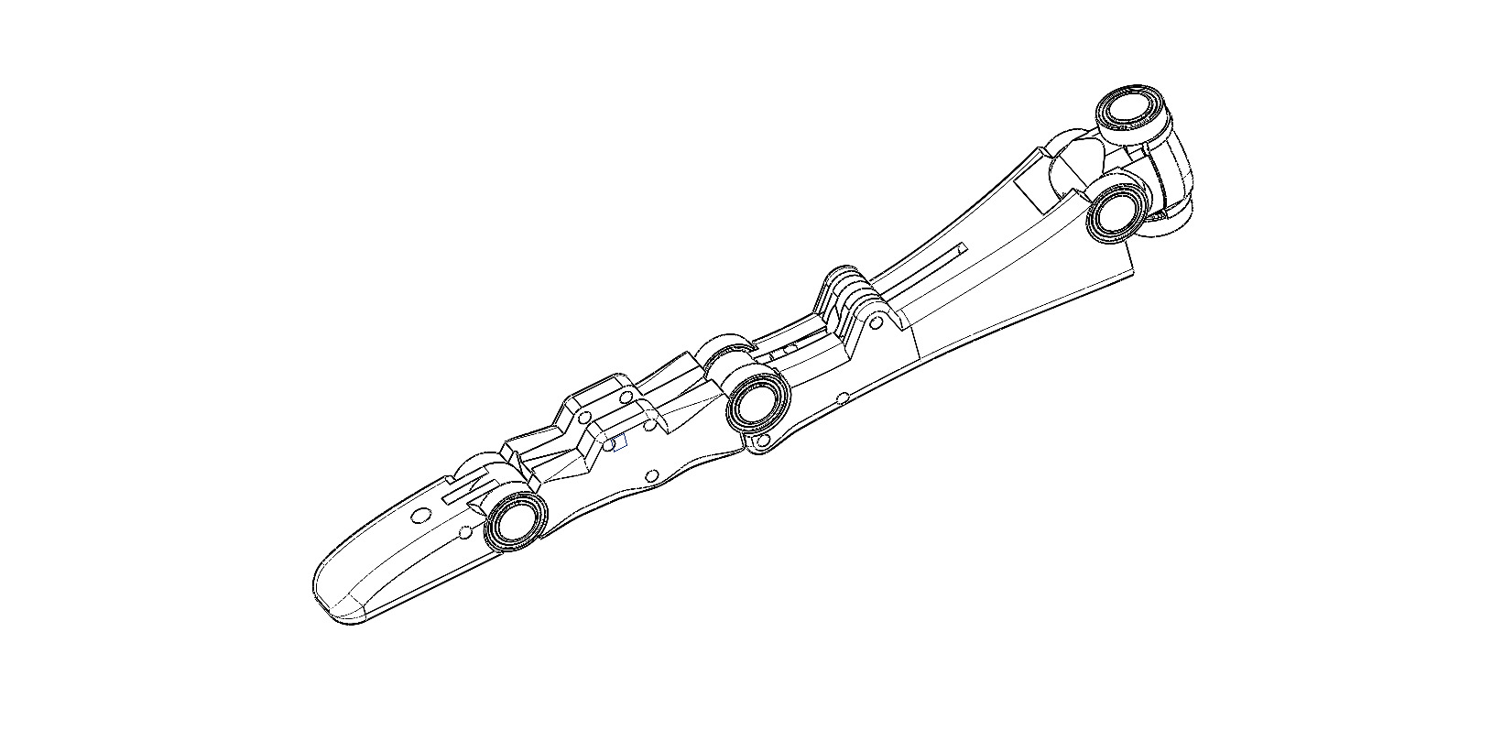
图片/改/大拇指.JPG
