18871379330/mydexhand/图片/改/夹取.png

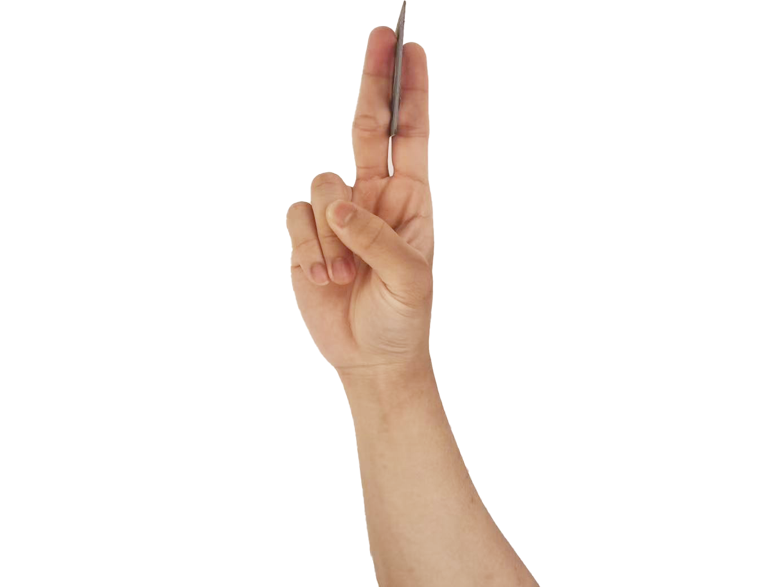
图片/改/夹取.png
