18871379330/mydexhand/图片/改/小臂.JPG

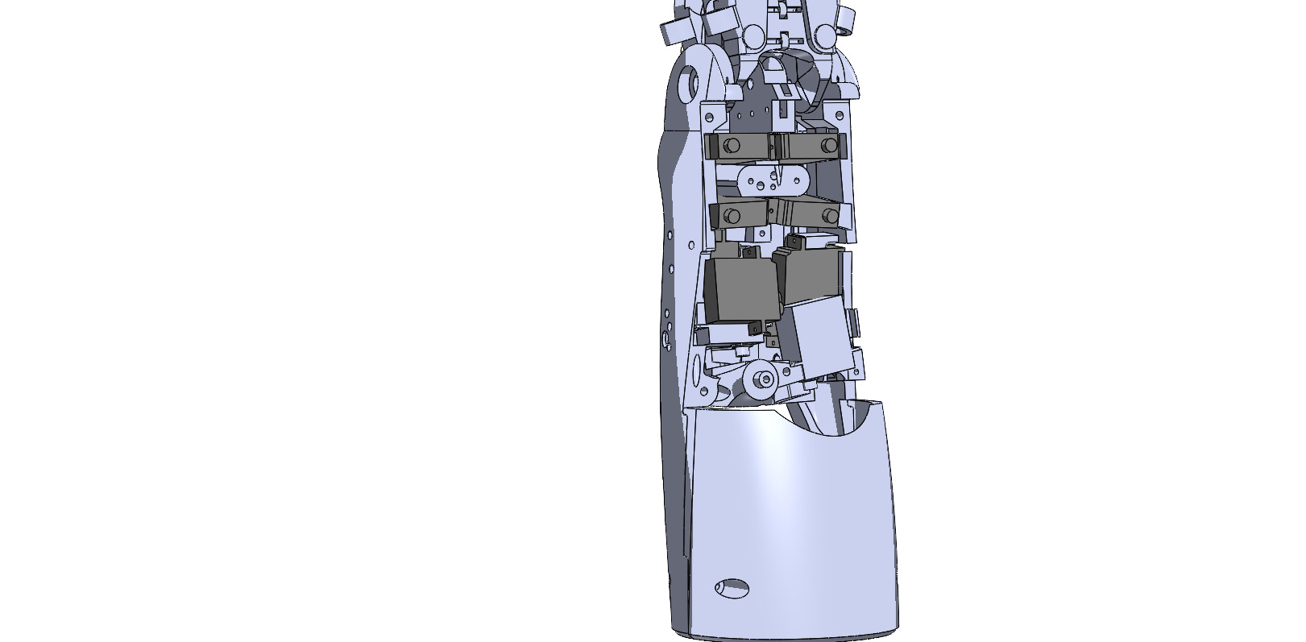
图片/改/小臂.JPG
