18871379330/mydexhand/图片/改/幻灯片28.PNG

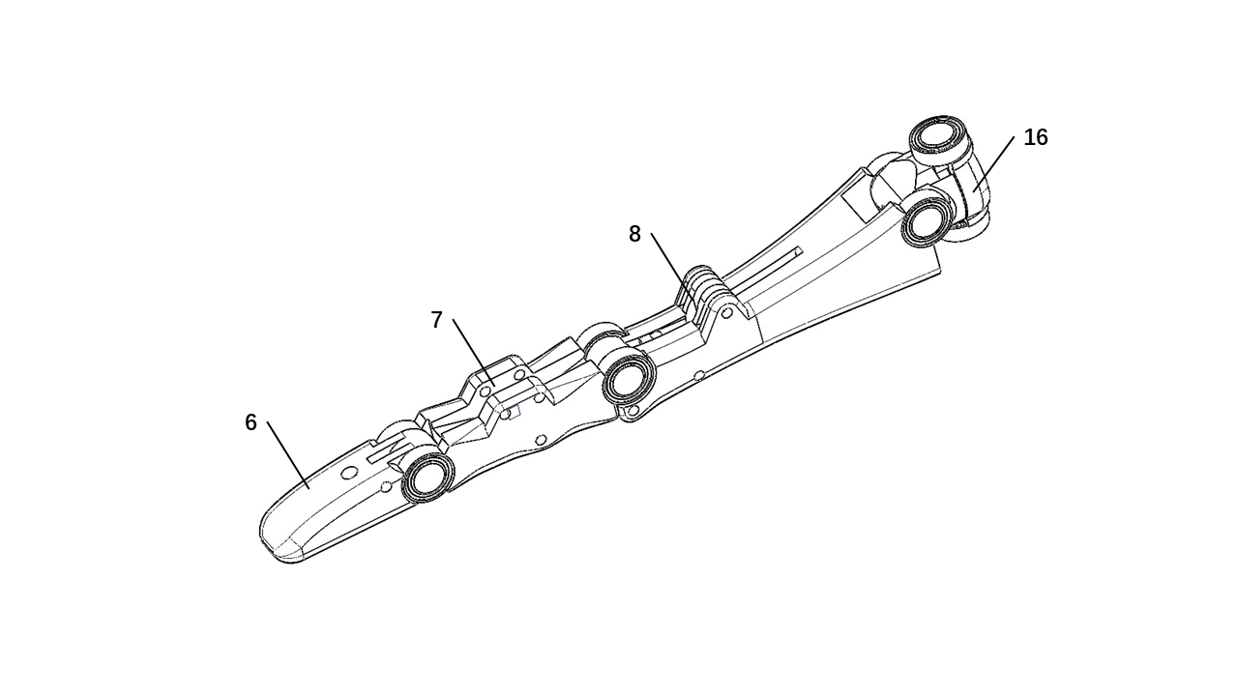
图片/改/幻灯片28.PNG
