18871379330/mydexhand/图片/改/手势.png

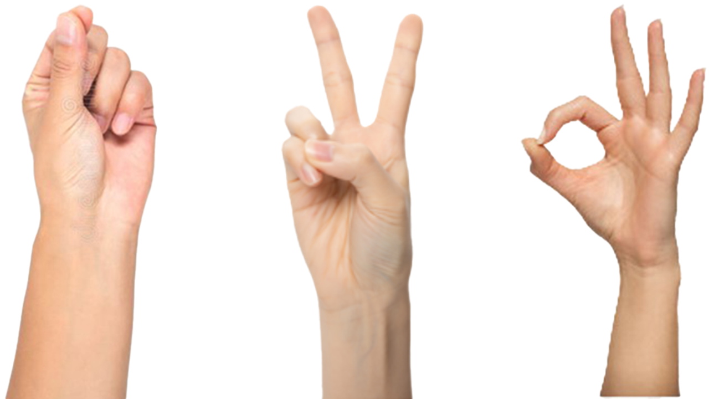
图片/改/手势.png
