18871379330/mydexhand/图片/改/手腕八字结剖视图.JPG

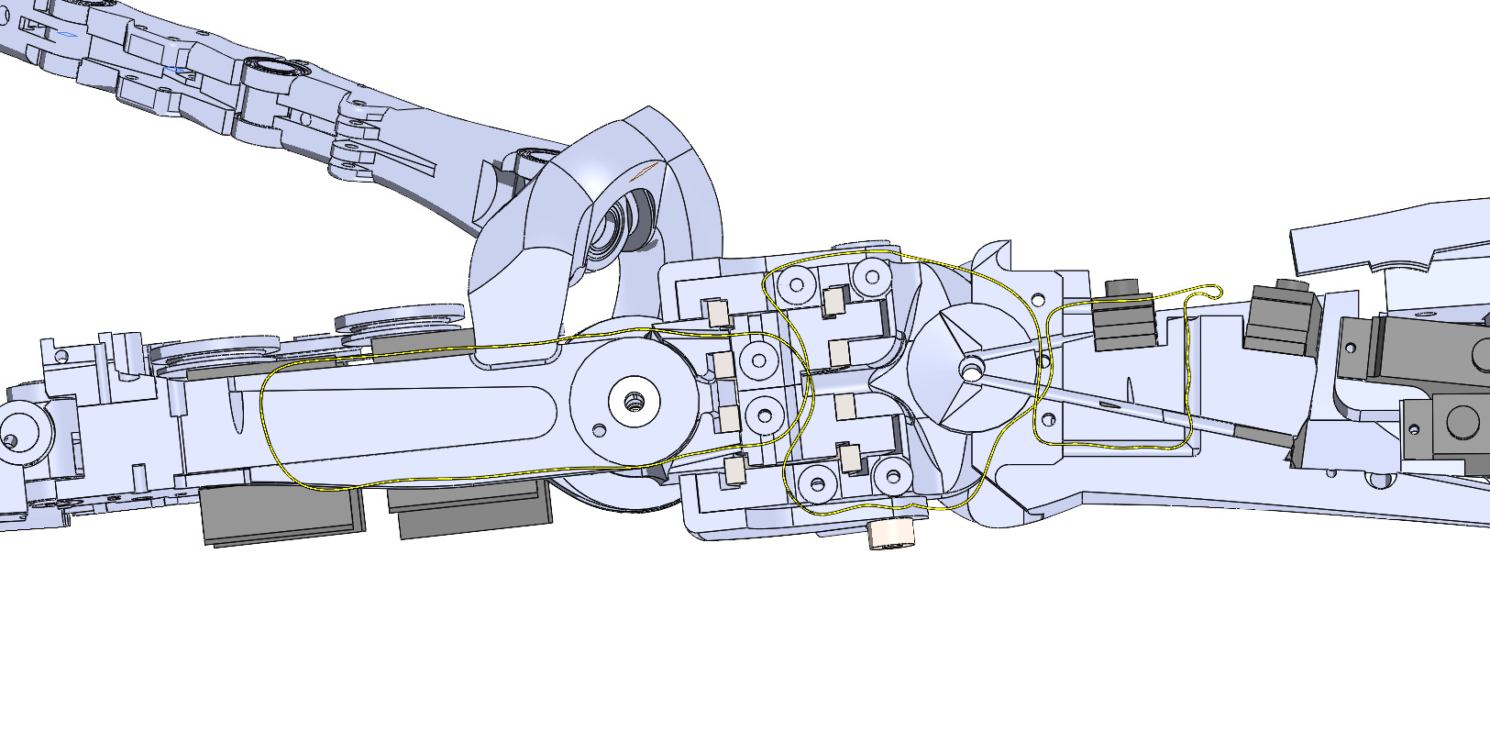
图片/改/手腕八字结剖视图.JPG
