18871379330/mydexhand/图片/改/抓握.jpg

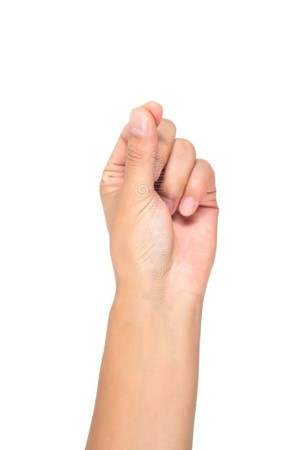
图片/改/抓握.jpg
