18871379330/mydexhand/图片/改/捏取.jpg

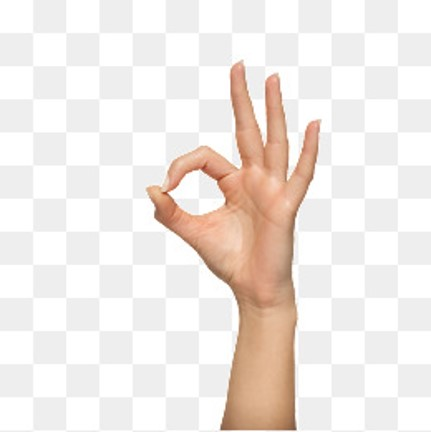
图片/改/捏取.jpg
