18871379330/mydexhand/图片/改/握取.png

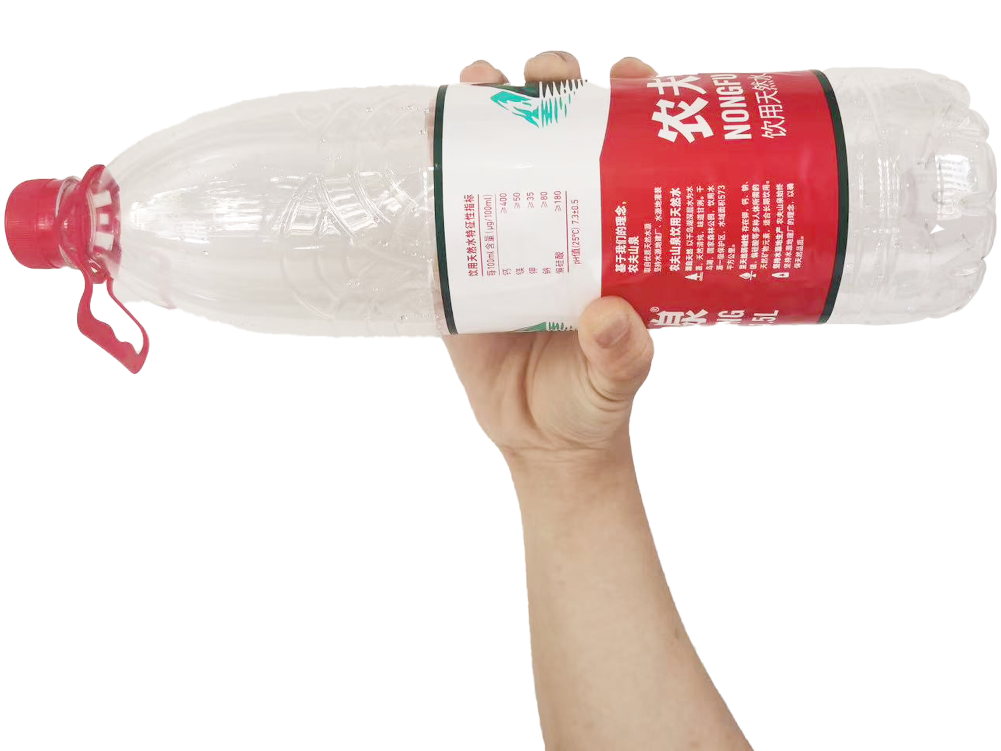
图片/改/握取.png
