18871379330/mydexhand/图片/改/比数字手势.png

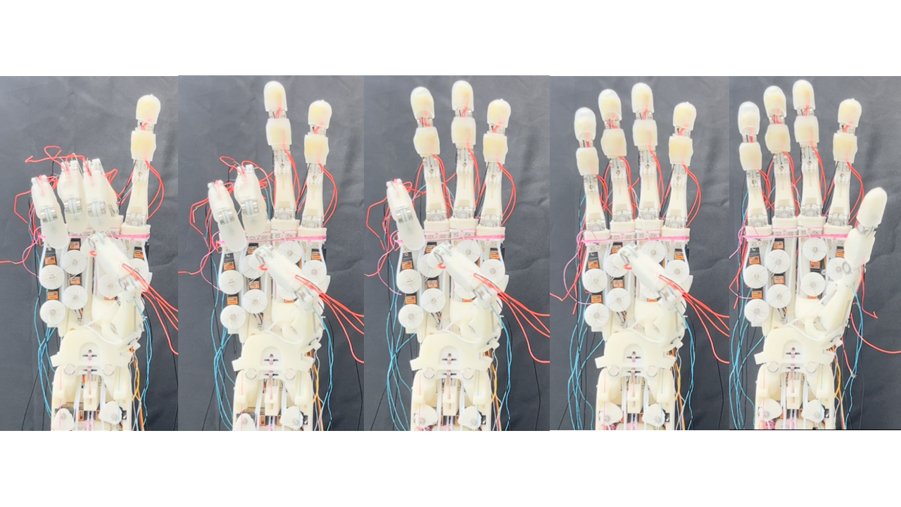
图片/改/比数字手势.png
