18871379330/mydexhand/图片/改/食指8字绳剖视图.JPG

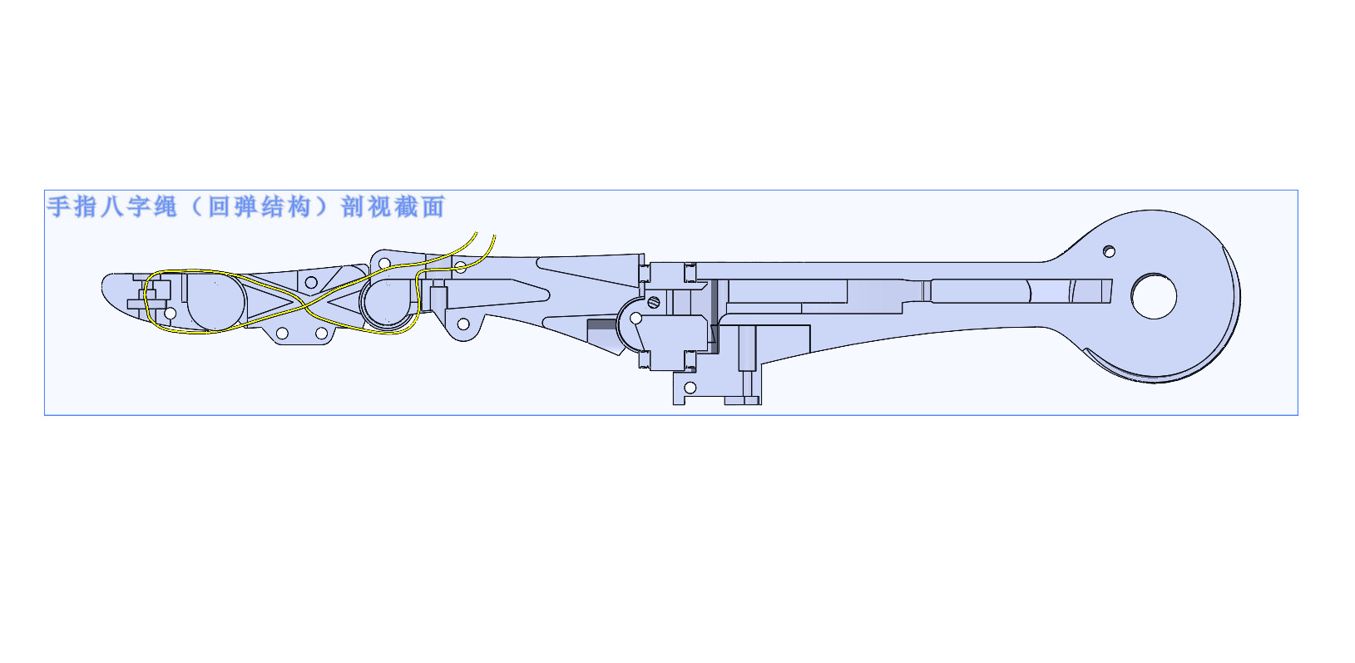
图片/改/食指8字绳剖视图.JPG
