18871379330/mydexhand/图片/改/食指八字绳与回弹机构剖视截面侧面.JPG

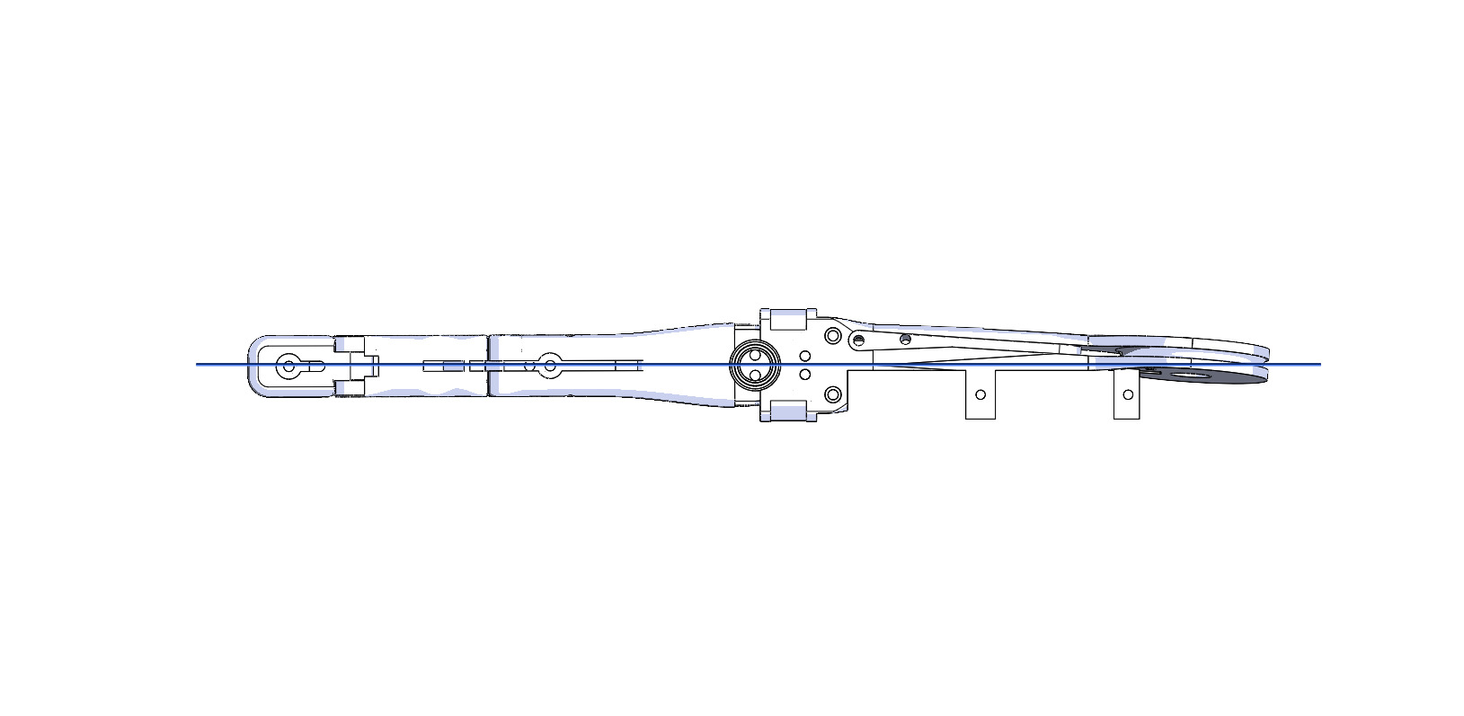
图片/改/食指八字绳与回弹机构剖视截面侧面.JPG
