18871379330/mydexhand/图片/改/食指驱动绳剖视截面侧面.JPG

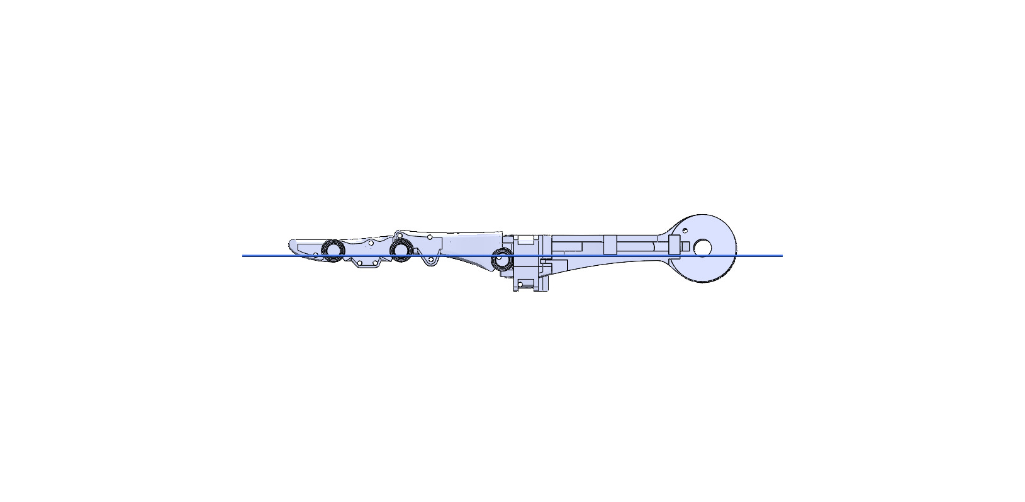
图片/改/食指驱动绳剖视截面侧面.JPG
