18871379330/mydexhand/图片/改/食指驱动绳剖面示意图.JPG

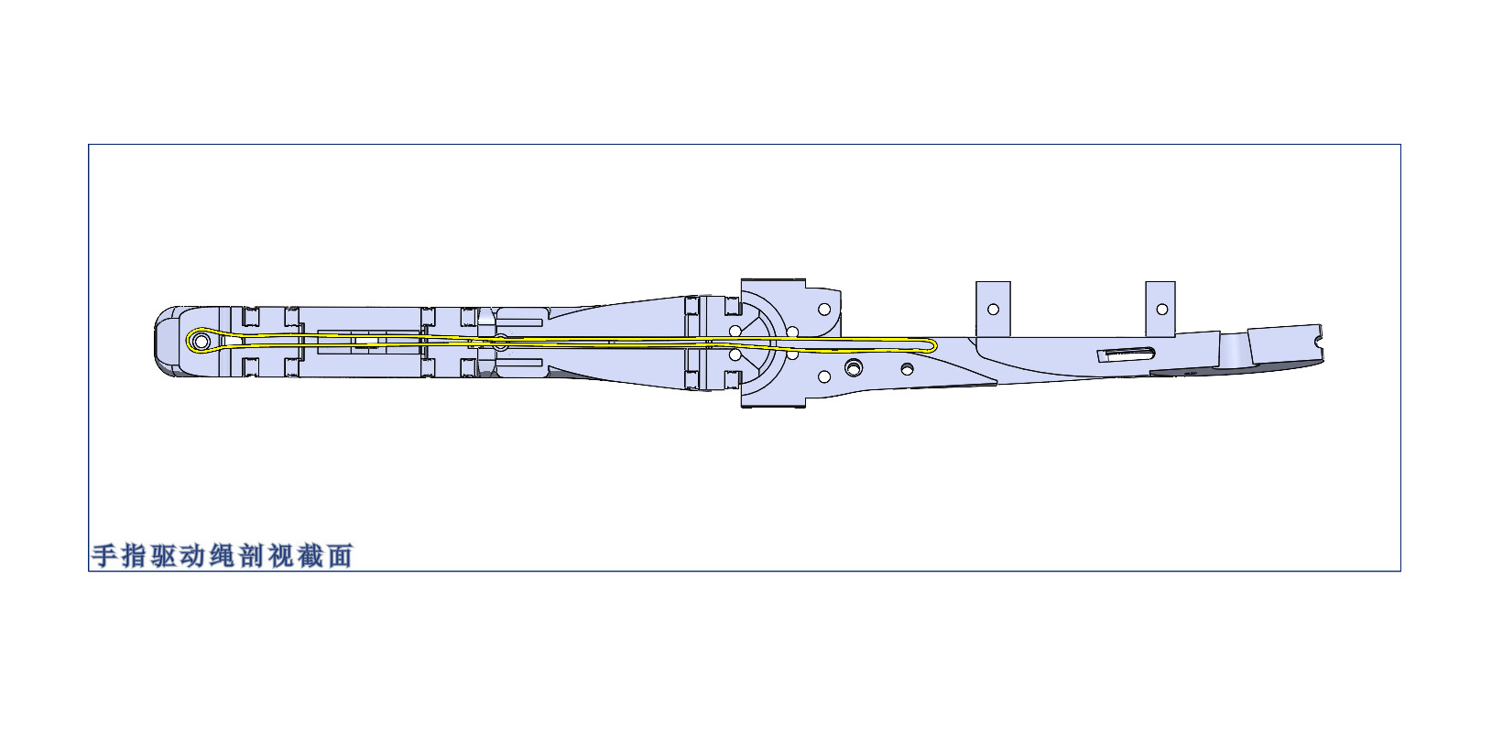
图片/改/食指驱动绳剖面示意图.JPG
