18871379330/mydexhand/图片/新建文件夹/enhanced_servo_drawing.jpg

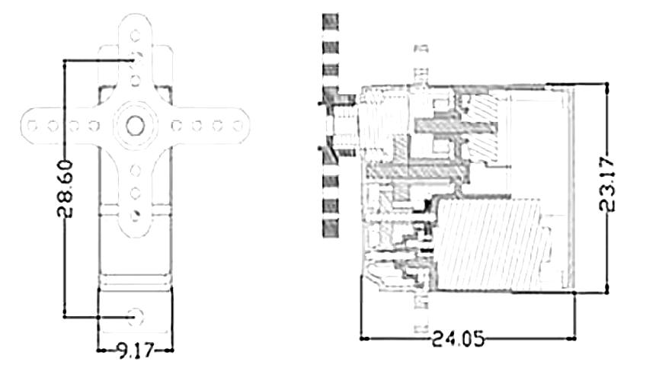
图片/新建文件夹/enhanced_servo_drawing.jpg
