18871379330/mydexhand/图片/新建文件夹/ES3352清晰.png

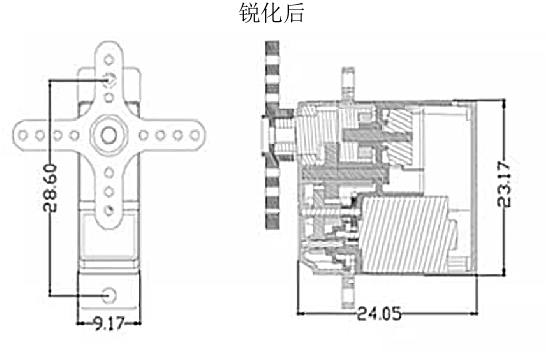
图片/新建文件夹/ES3352清晰.png
