18871379330/mydexhand/图片/新建文件夹/STS清晰.png

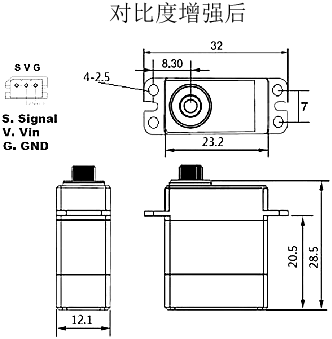
图片/新建文件夹/STS清晰.png
