18871379330/mydexhand/图片/签名.png

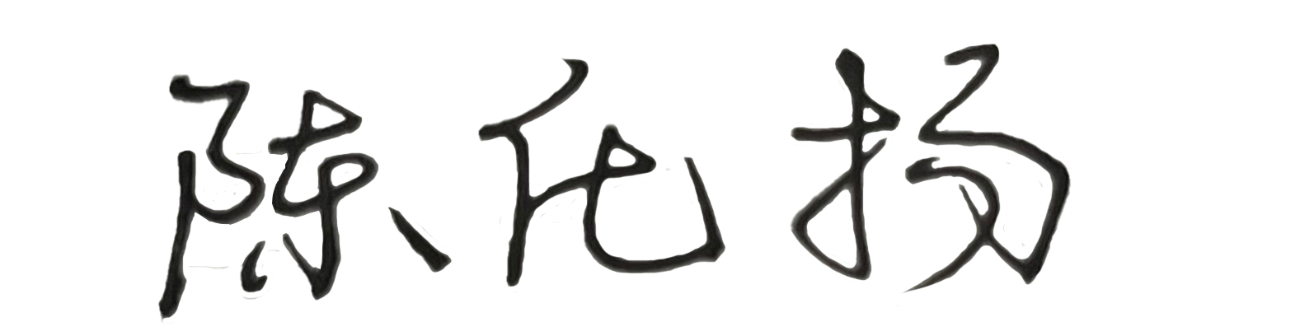
图片/签名.png
