18871379330/mydexhand/图片/论文图片/5-5.png

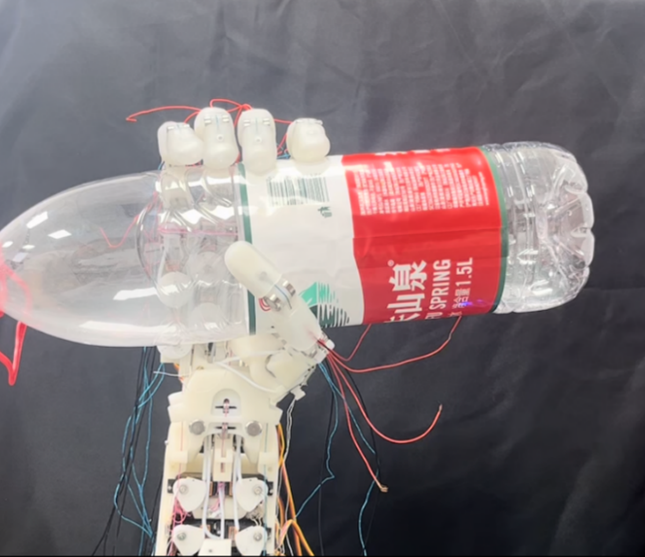
图片/论文图片/5-5.png
