18871379330/mydexhand/图片/论文图片/5-6.png

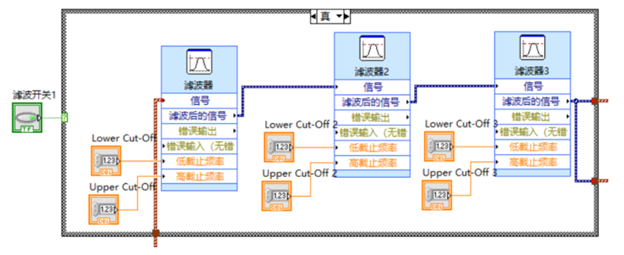
图片/论文图片/5-6.png
