18871379330/mydexhand/图片/食指.JPG

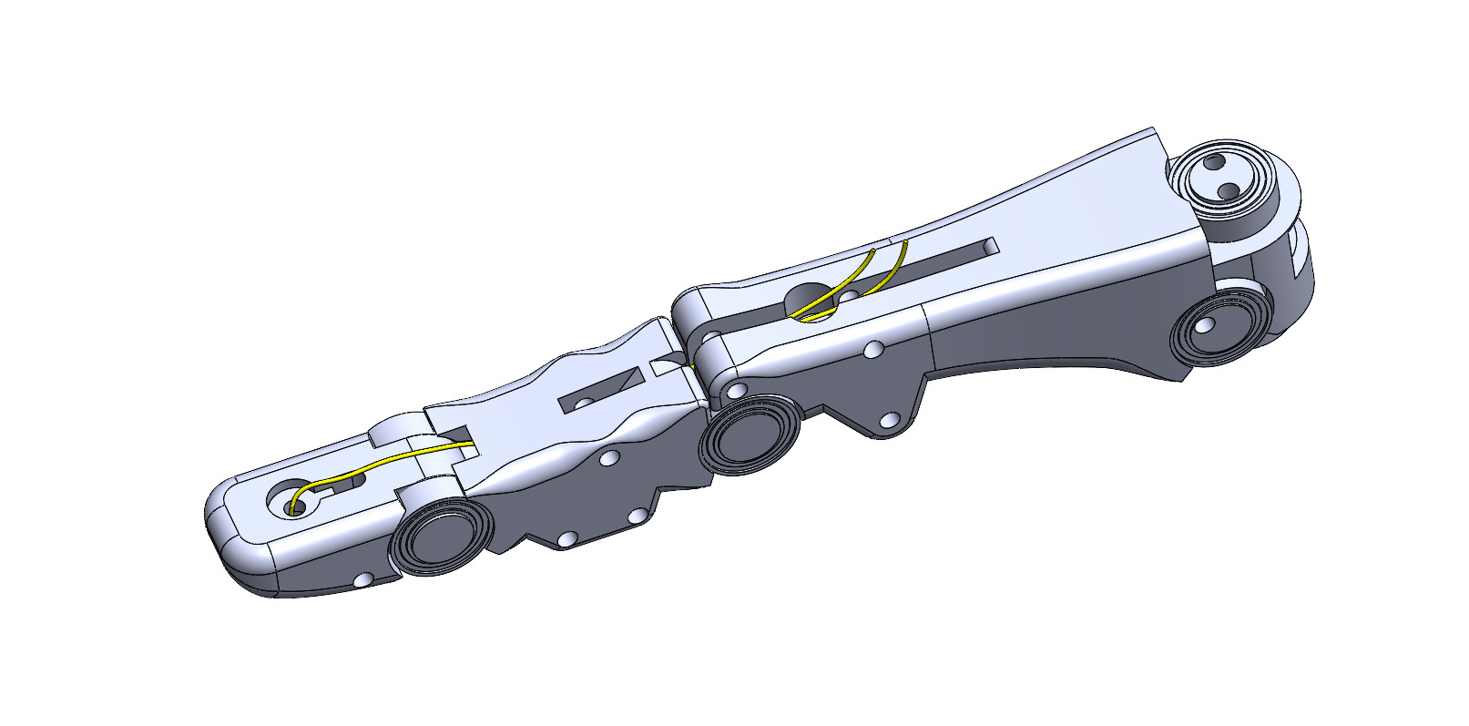
图片/食指.JPG
