18871379330/mydexhand/提交附件/论文图片/1-3.png

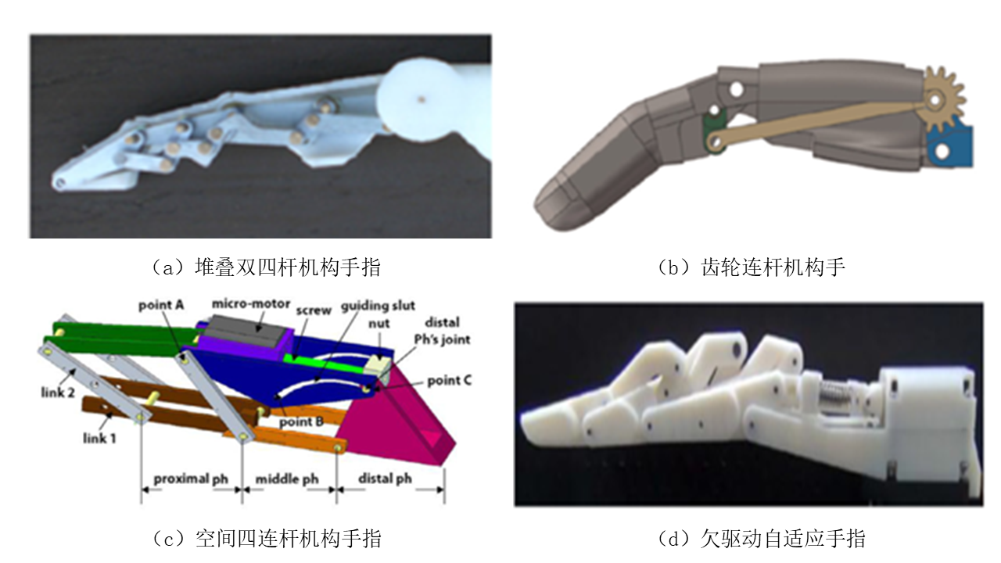
提交附件/论文图片/1-3.png
