18871379330/mydexhand/提交附件/论文图片/2-5.png

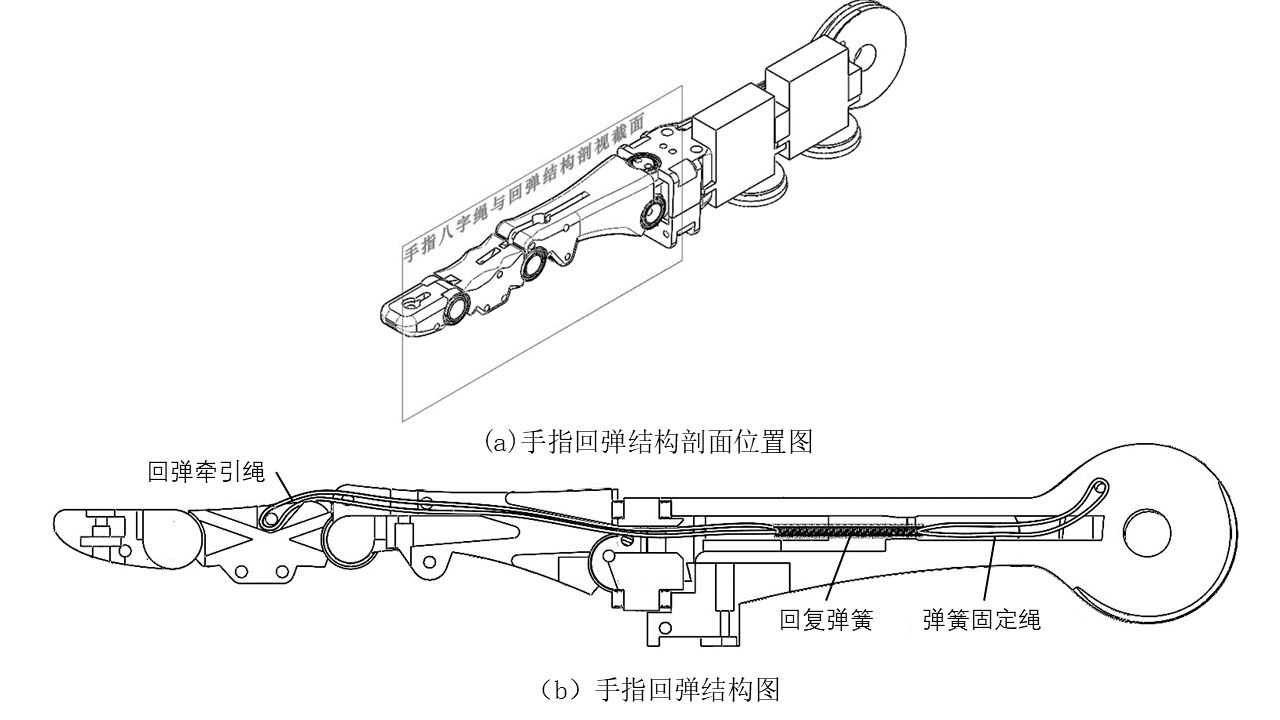
提交附件/论文图片/2-5.png
