18871379330/mydexhand/提交附件/论文图片/2-8.png

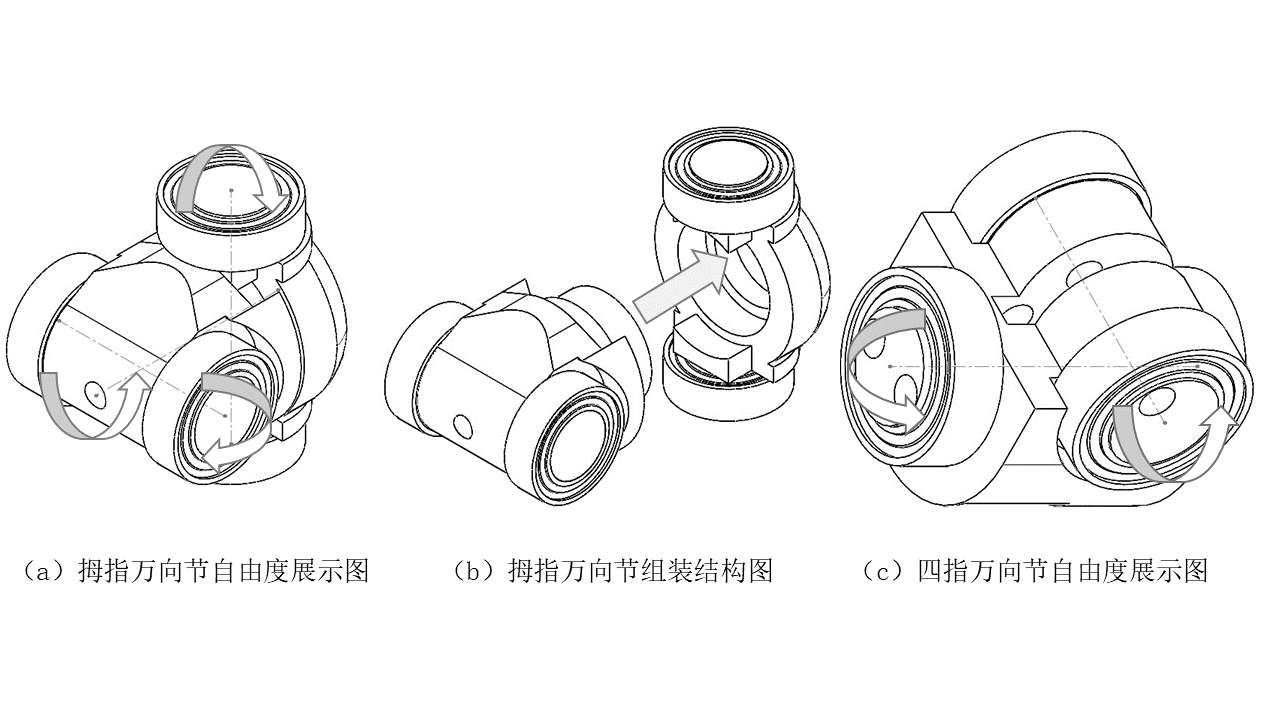
提交附件/论文图片/2-8.png
