18871379330/mydexhand/提交附件/论文图片/2-14.png

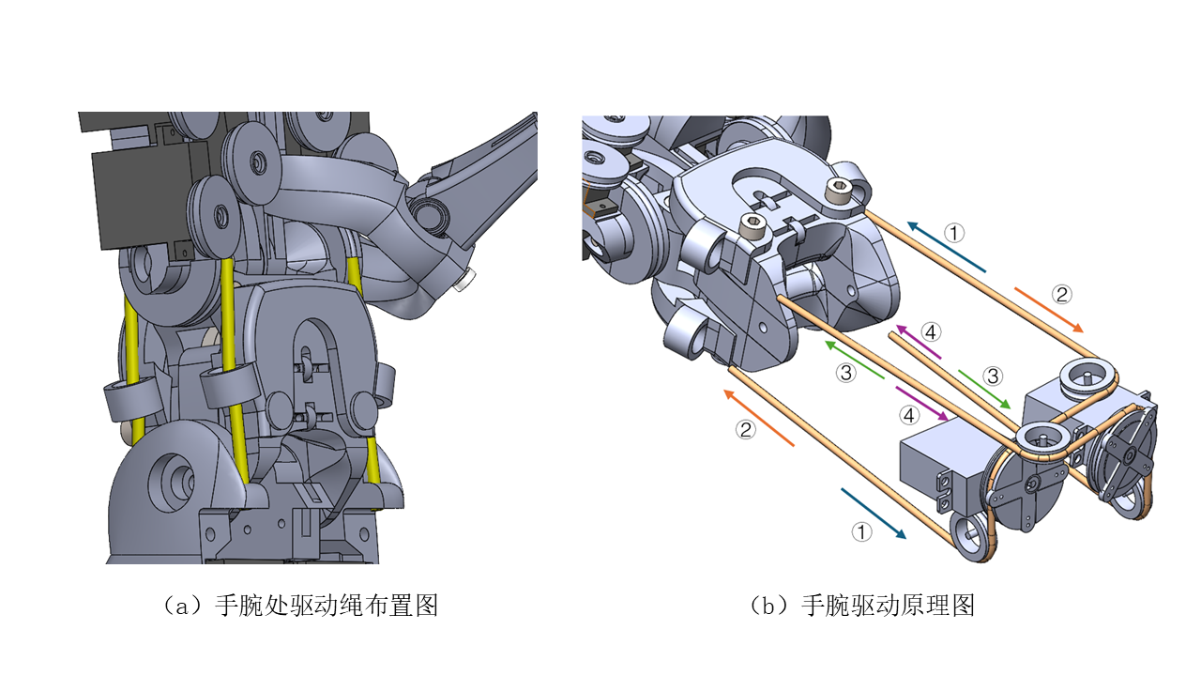
提交附件/论文图片/2-14.png
