18871379330/mydexhand/提交附件/论文图片/3-3.png

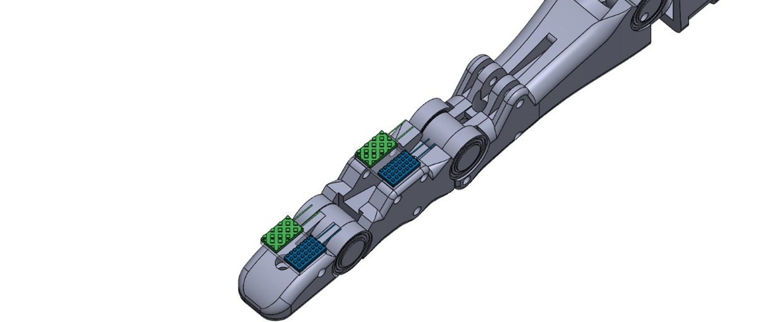
提交附件/论文图片/3-3.png
