18871379330/mydexhand/提交附件/论文图片/4-1.png

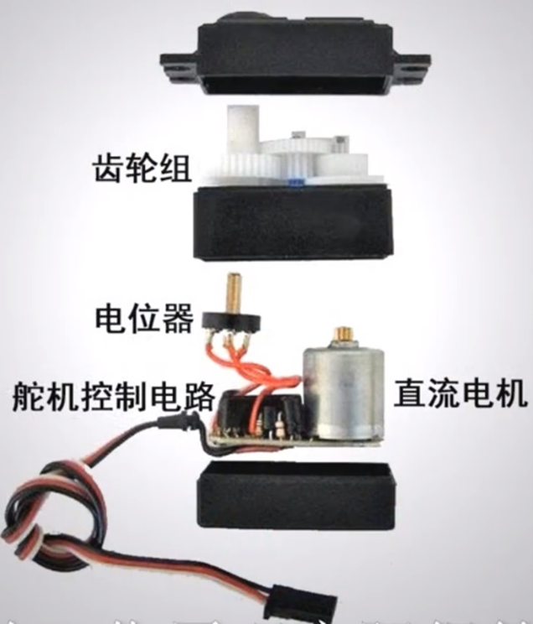
提交附件/论文图片/4-1.png
