18871379330/mydexhand/提交附件/论文图片/4-7.png

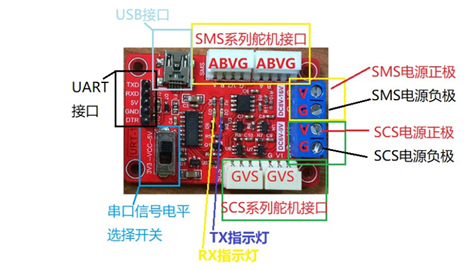
提交附件/论文图片/4-7.png
