18871379330/mydexhand/提交附件/论文图片/4-8.png

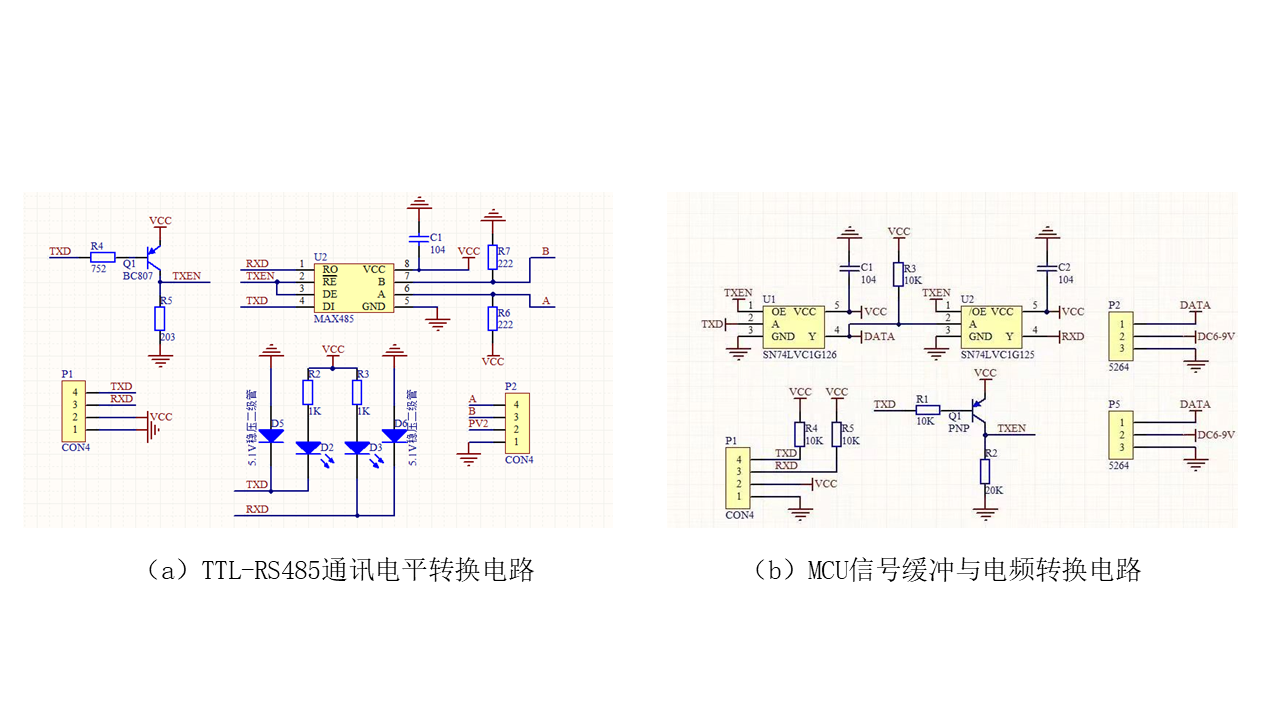
提交附件/论文图片/4-8.png
