18871379330/mydexhand/精雕杯/提交材料/8ffe27722bd92a7201ec09de9a658f3.jpg

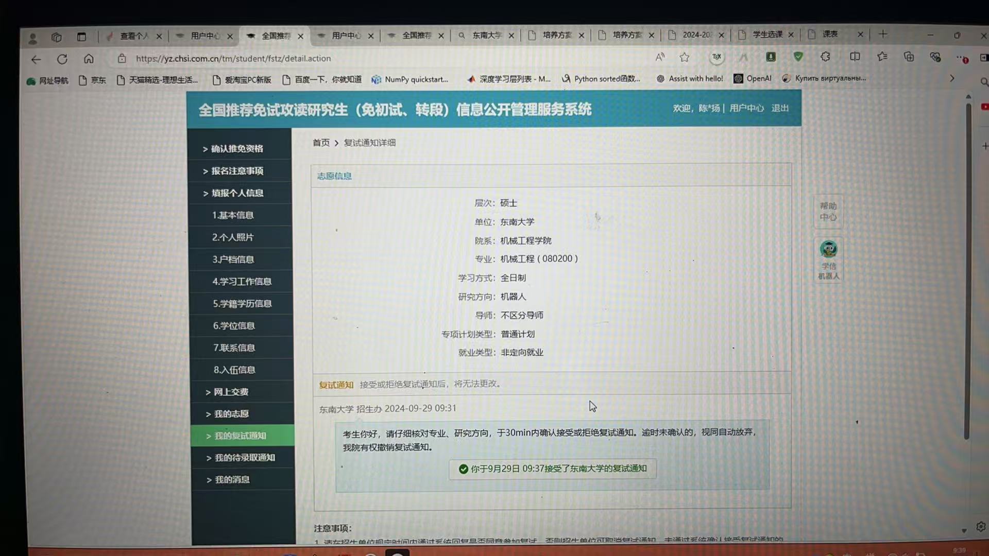
精雕杯/提交材料/8ffe27722bd92a7201ec09de9a658f3.jpg
