18871379330/mydexhand/精雕杯/提交材料/提交版本.jpg

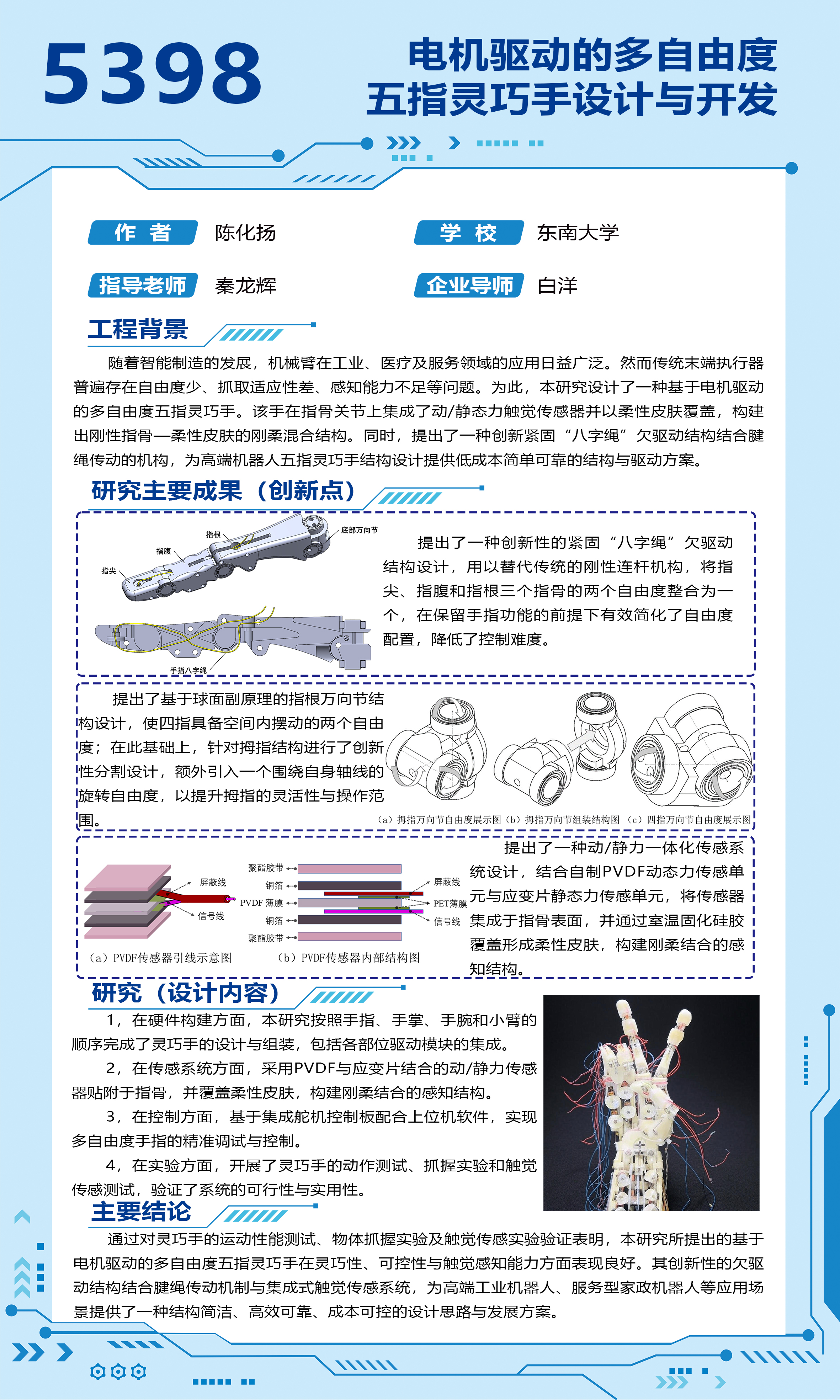
精雕杯/提交材料/提交版本.jpg
