18871379330/mydexhand/精雕杯/毕业设计大赛材料提交链接-填写凭证.png

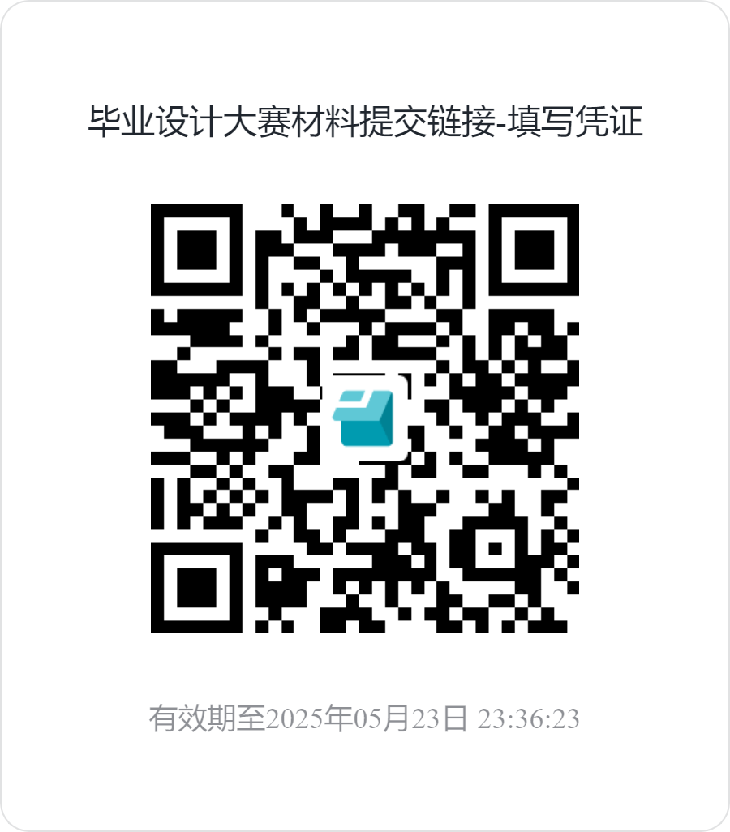
精雕杯/毕业设计大赛材料提交链接-填写凭证.png
