18871379330/mydexhand/精雕杯/附件1海报模板/展板样式排版原文件/展板排版参考.jpg

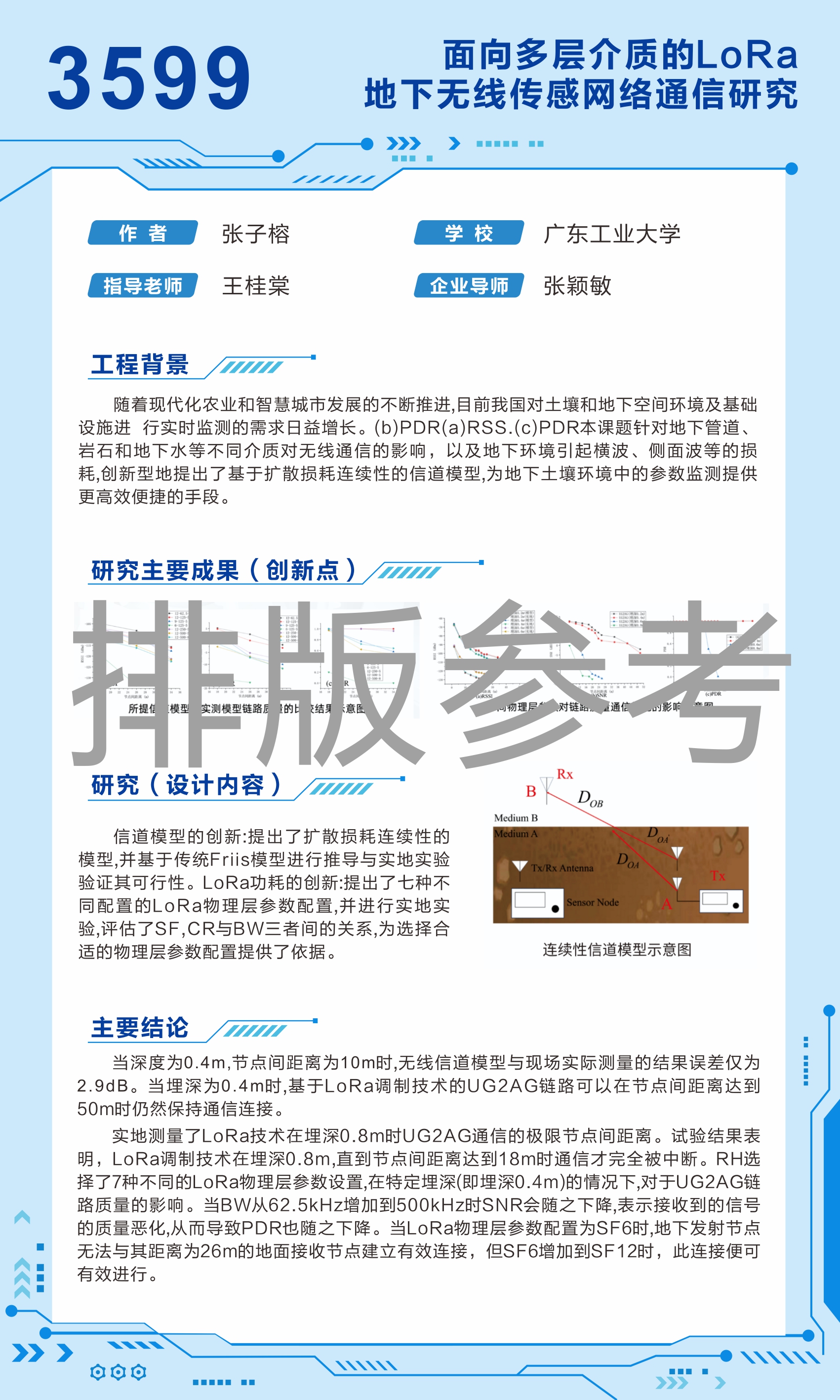
精雕杯/附件1海报模板/展板样式排版原文件/展板排版参考.jpg
