18871379330/mydexhand/触觉数据/PVDF2.png

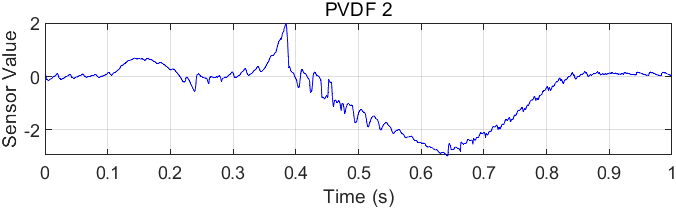
触觉数据/PVDF2.png
