18871379330/mydexhand/触觉数据/PVDF4.png

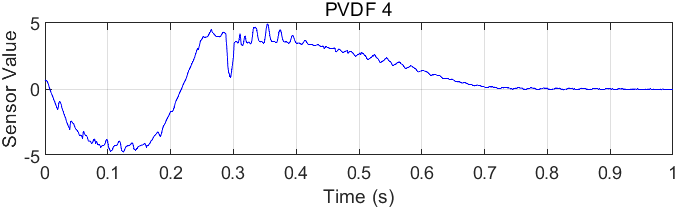
触觉数据/PVDF4.png
