18871379330/mydexhand/触觉数据/strain gague1.png

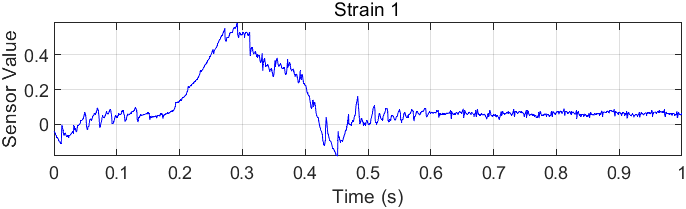
触觉数据/strain gague1.png
