18871379330/mydexhand/触觉数据/strain gague2.png

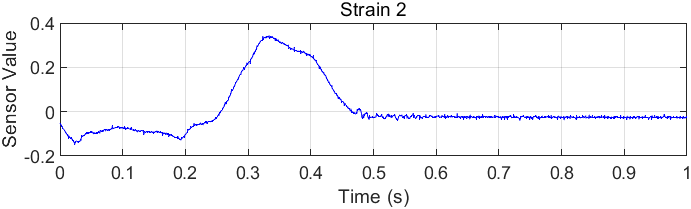
触觉数据/strain gague2.png
