18871379330/mydexhand/触觉数据/strain gague3.png

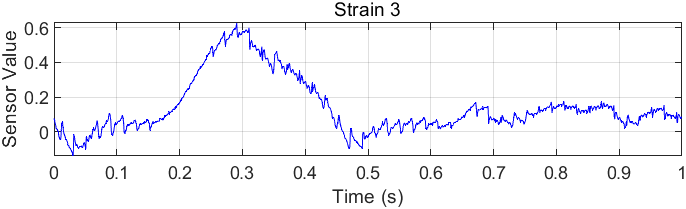
触觉数据/strain gague3.png
