18871379330/mydexhand/食指/固体工程中的拉伸弹簧/sp.jpg

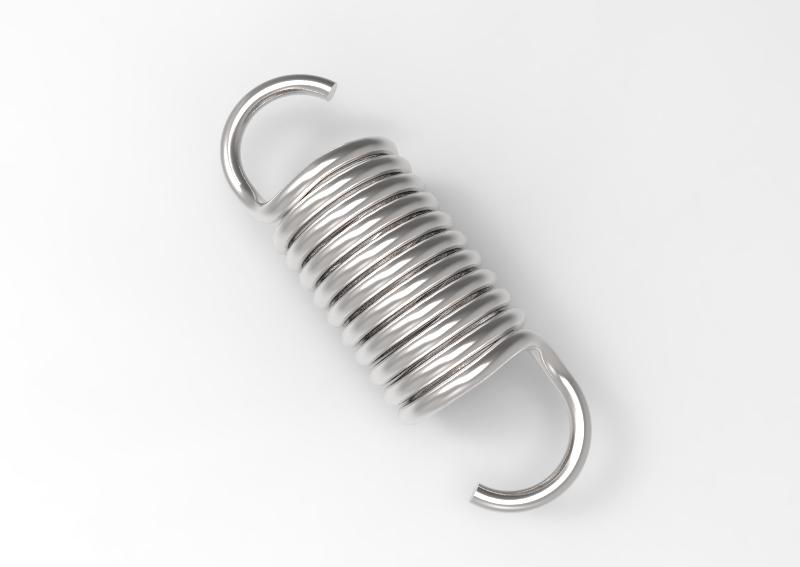
食指/固体工程中的拉伸弹簧/sp.jpg
