18871379330/mydexhand/食指/固体工程中的拉伸弹簧/spring.JPG

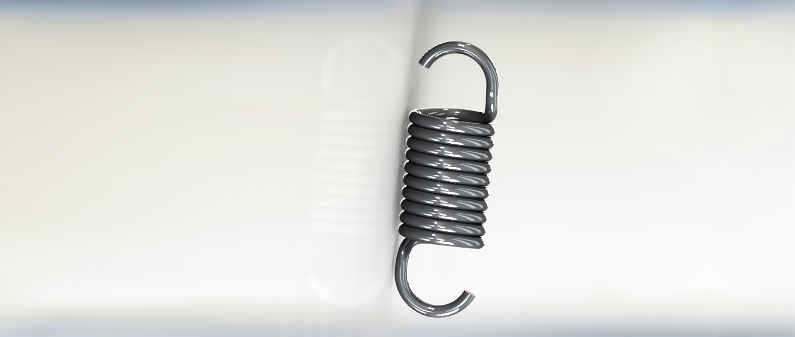
食指/固体工程中的拉伸弹簧/spring.JPG
