18871379330/mydexhand/中指/中指.SLDASM

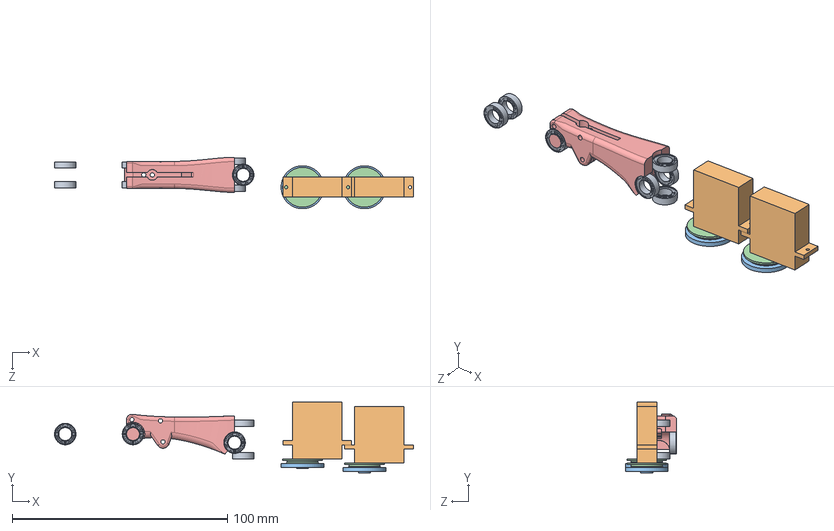
[picture p280: CAD file, 2025-05-09]
中指/中指.SLDASM
166.9 x 32.8 x 23.9 mm
中指腹
输出近端 x 2
输出远端 x 2
Emax舵机 x 2
6x10x3轴承 x 8
