18871379330/mydexhand/小指/小指.SLDASM

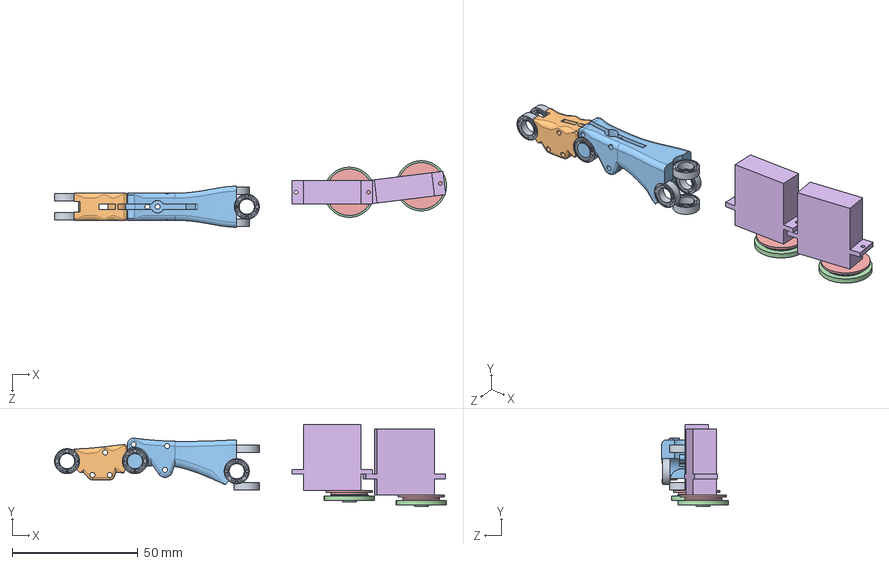
[picture p281: CAD file, 2025-05-09]
小指/小指.SLDASM
155.9 x 32.8 x 26.5 mm
Emax舵机 x 2
输出近端 x 2
输出远端 x 2
小指腹
小指中
6x10x3轴承 x 8
