18871379330/mydexhand/手臂/手臂装配体.SLDASM

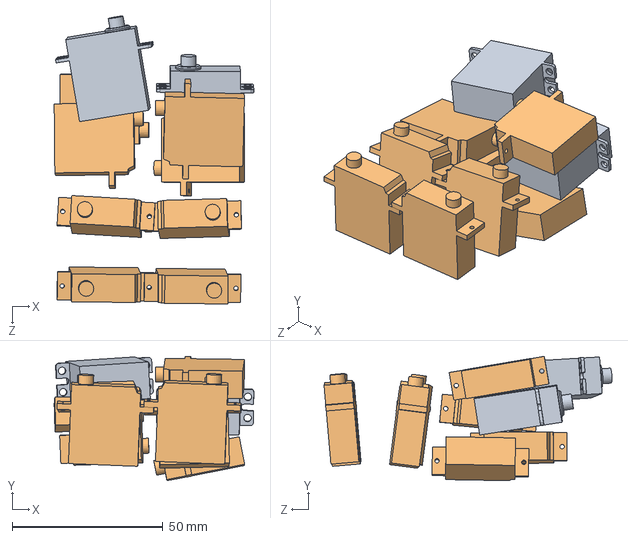
[picture p282: CAD file, 2025-06-29]
手臂/手臂装配体.SLDASM
66.2 x 41.3 x 95.5 mm
Emax_23mm_03舵机 x 8
SCS2332舵机 x 2
