18871379330/mydexhand/提交附件/打印文件/fingers-thumb/middle/Middle-Finger-Assembly v10.step

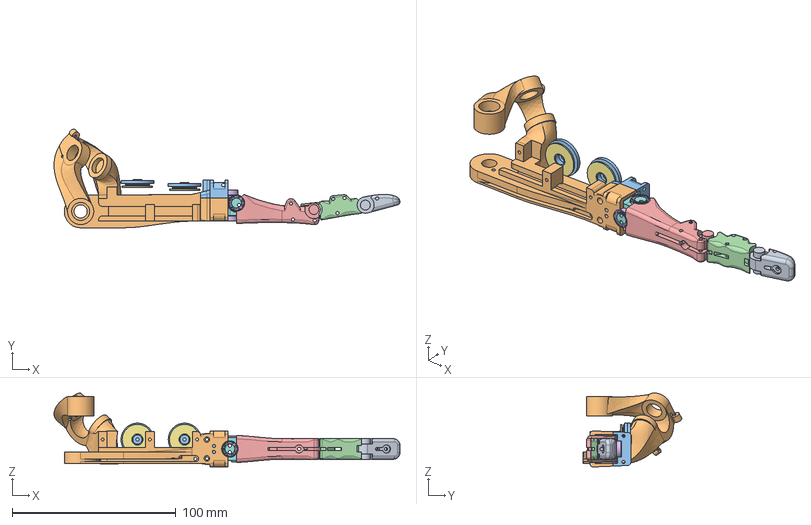
[picture p283: CAD file, 2025-05-09]
提交附件/打印文件/fingers-thumb/middle/Middle-Finger-Assembly v10.step
211.0 x 60.2 x 45.1 mm
Test_2mm_01 x 3
ES3302_Servo_Horn_Round_01 (1) x 2
MLP_BEARING_15
PLP_BEARING_15
6x10x3 x 3
Tendon_Spool_01 x 2
Knuckle_BEARING_15
Tip_BEARING_15
Palm_BEARING_15
