18871379330/mydexhand/提交附件/打印文件/wrist/Wrist-Assembly v13.step

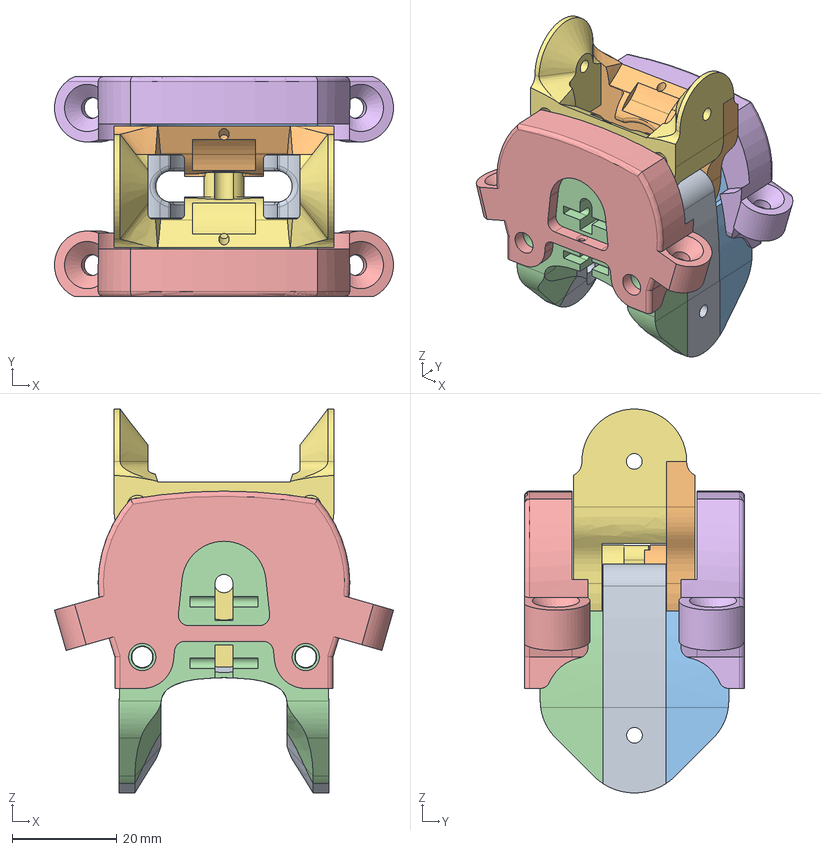
[picture p284: CAD file, 2025-05-09]
提交附件/打印文件/wrist/Wrist-Assembly v13.step
64.7 x 42.0 x 73.3 mm
Wrist_Proximal_Tunnel
Wrist_Proximal_Upper
Distal_Wrist_top
Distal_Wrist_Bot
Distal-Wrist-Clip-Bot
Distal-Wrist-Clip-Top
Wrist_Proximal_Lower
