18871379330/mydexhand/无名指/无名指.SLDASM

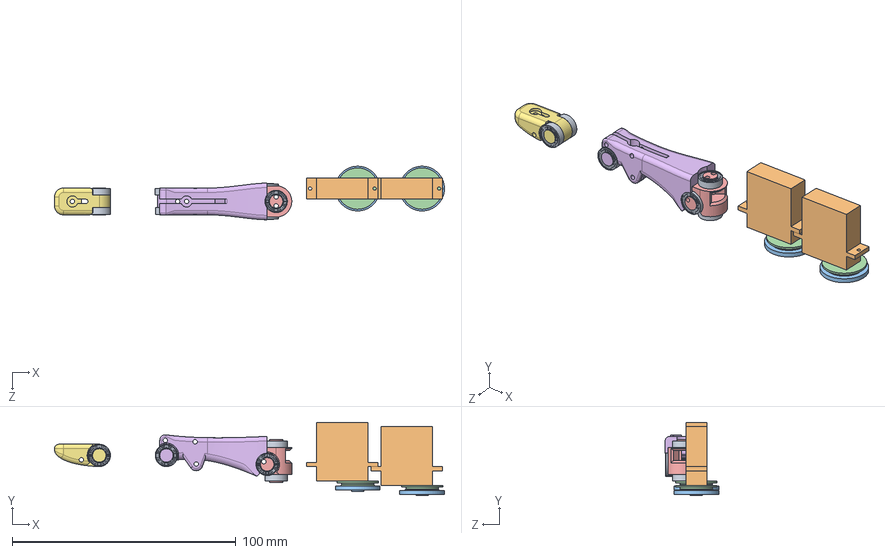
[picture p285: CAD file, 2025-05-09]
无名指/无名指.SLDASM
174.2 x 32.8 x 23.9 mm
无名指尖
无名指腹
无名指底
输出近端 x 2
输出远端 x 2
Emax舵机 x 2
6x10x3轴承 x 8
