18871379330/mydexhand/打印文件/fingers-thumb/pinky/Pinky-Finger-Assembly v4.step

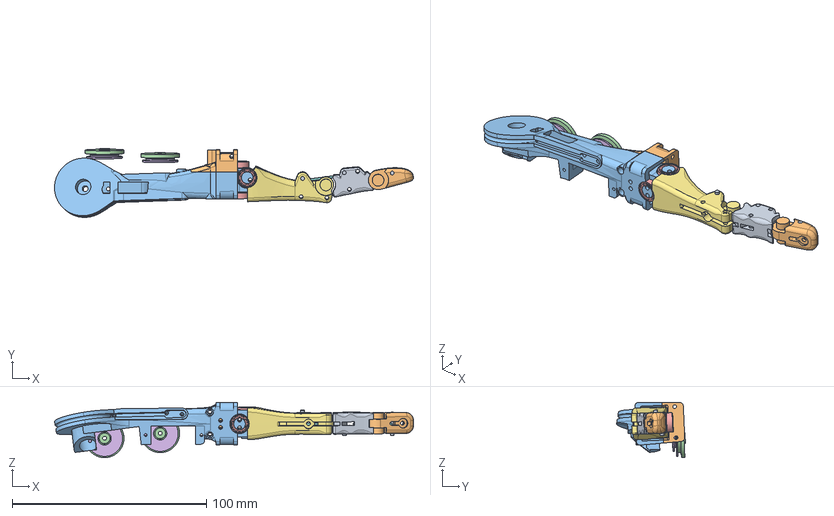
[picture p286: CAD file, 2025-05-09]
打印文件/fingers-thumb/pinky/Pinky-Finger-Assembly v4.step
184.9 x 35.5 x 28.4 mm
MLP_BEARING_15 (1)
Palm_BEARING_15 (1)
ES3302_Servo_Horn_Round_01 (1) x 2
6x10x3 x 3
Tendon_Spool_01 x 2
PLP_BEARING_15 (1)
Test_2mm_01 x 3
Tip_BEARING_15 (1)
Knuckle_BEARING_15
