18871379330/mydexhand/打印文件/fingers-thumb/ring/Ring-Finger-Assembly v4.step

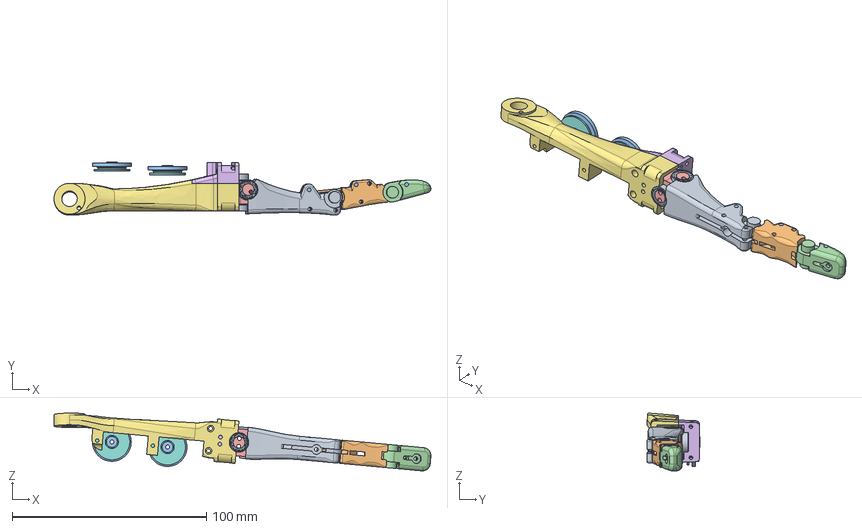
[picture p287: CAD file, 2025-05-09]
打印文件/fingers-thumb/ring/Ring-Finger-Assembly v4.step
194.1 x 27.5 x 29.8 mm
6x10x3 x 3
Test_2mm_01 x 3
Tip_BEARING_15 (2)
Knuckle_BEARING_15
Palm_BEARING_15 (3)
Tendon_Spool_01 x 2
PLP_BEARING_15 (2)
MLP_BEARING_15 (2)
ES3302_Servo_Horn_Round_01 (1) x 2
