18871379330/mydexhand/打印文件/fingers-thumb/index/Index-Finger-Assembly v21.step

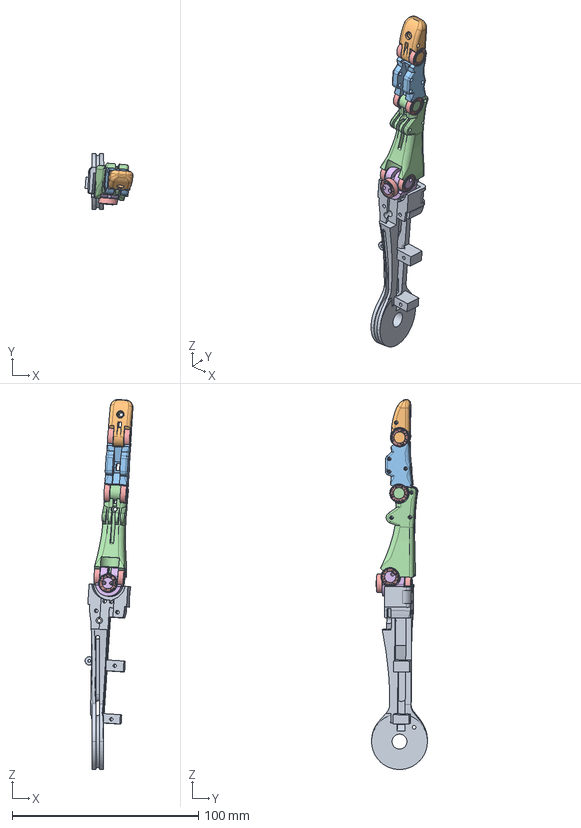
[picture p288: CAD file, 2025-05-09]
打印文件/fingers-thumb/index/Index-Finger-Assembly v21.step
25.8 x 30.0 x 198.8 mm
Tip_BEARING_15 (2)
MLP_BEARING_15 (2)
PLP_BEARING_15 (2)
Bearing-6x10x3 x 8
