18871379330/mydexhand/手/手.SLDASM

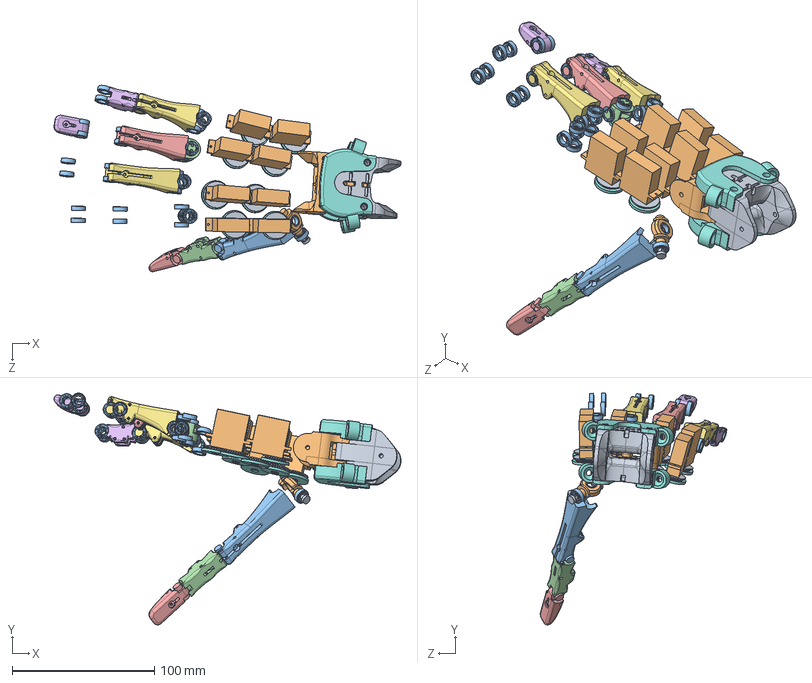
[picture p289: CAD file, 2025-03-30]
手/手.SLDASM
243.8 x 162.8 x 131.0 mm
6x10x3轴承 x 34
Emax舵机 x 8
输出近端 x 8
输出远端 x 8
中指腹
无名指尖
无名指腹
无名指底
M3螺丝 x 2
手上腕
手下腕
手腕壳 x 2
小指腹
小指中
大拇指尖
大拇指中
大拇指腹
大拇指下底
大拇指弹簧件
