18871379330/mydexhand/食指/食指.SLDASM

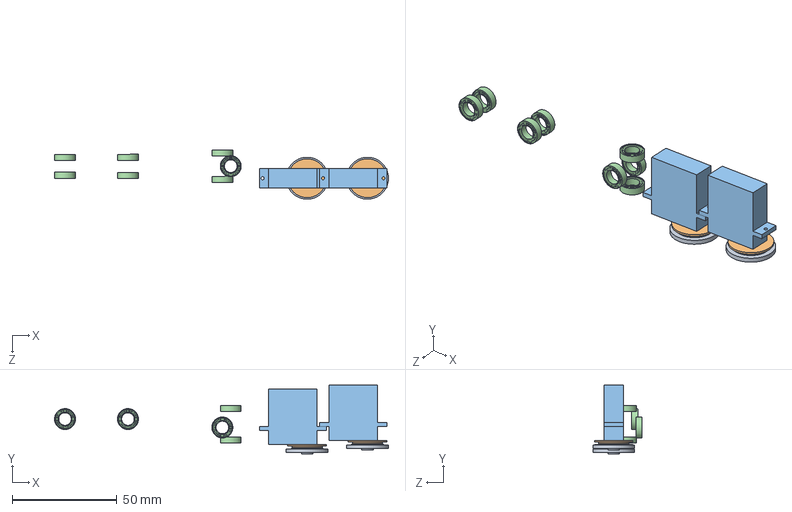
[picture p290: CAD file, 2025-02-20]
食指/食指.SLDASM
159.2 x 32.8 x 23.6 mm
6x10x3轴承 x 8
Emax舵机 x 2
输出近端 x 2
输出远端 x 2
