18871379330/mydexhand/手/串联销轴.SLDPRT

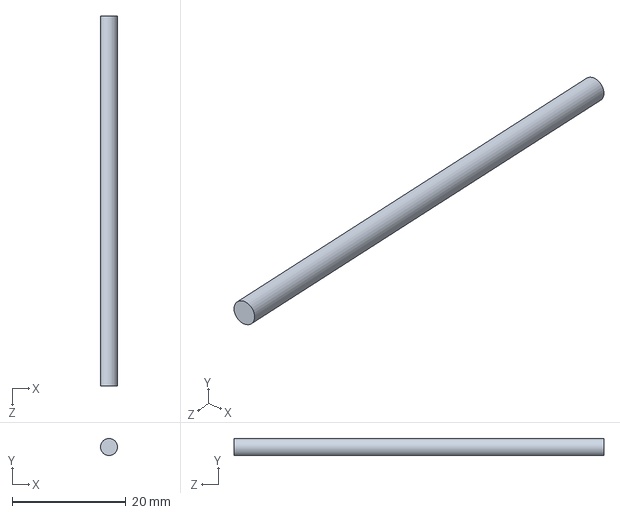
[picture p291: CAD file, 2025-06-08]
手/串联销轴.SLDPRT
3.00 x 3.00 x 65.0 mm
