18871379330/mydexhand/打印文件/fingers-thumb/Back_of_Hand_23a（带）.STL

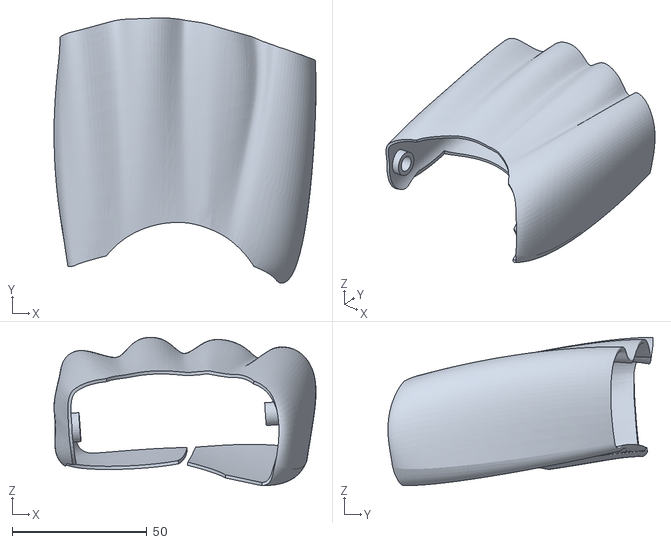
[picture p292: CAD file, 2025-05-09]
打印文件/fingers-thumb/Back_of_Hand_23a（带）.STL
97.1 x 98.3 x 55.0
