18871379330/mydexhand/打印文件/fingers-thumb/index/INDEX_Tip.stl

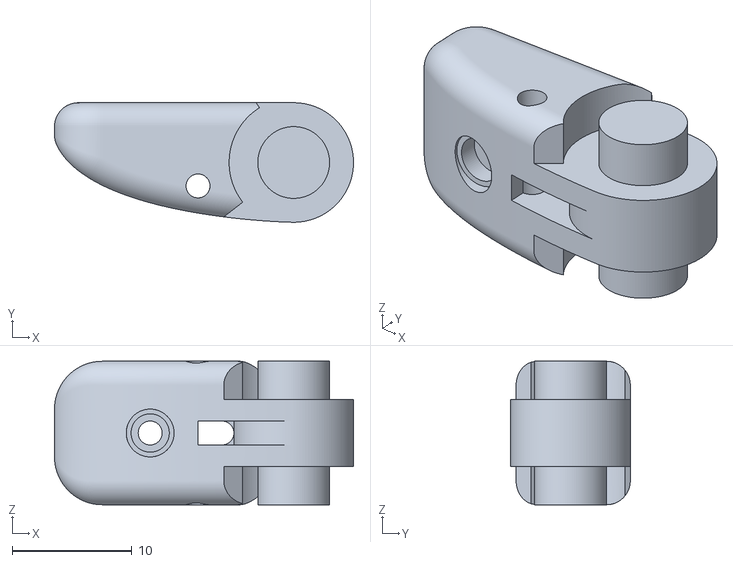
[picture p293: CAD file, 2025-05-09]
打印文件/fingers-thumb/index/INDEX_Tip.stl
25.0 x 10.0 x 12.0
