18871379330/mydexhand/打印文件/fingers-thumb/middle/MIDDLE_Tip.stl

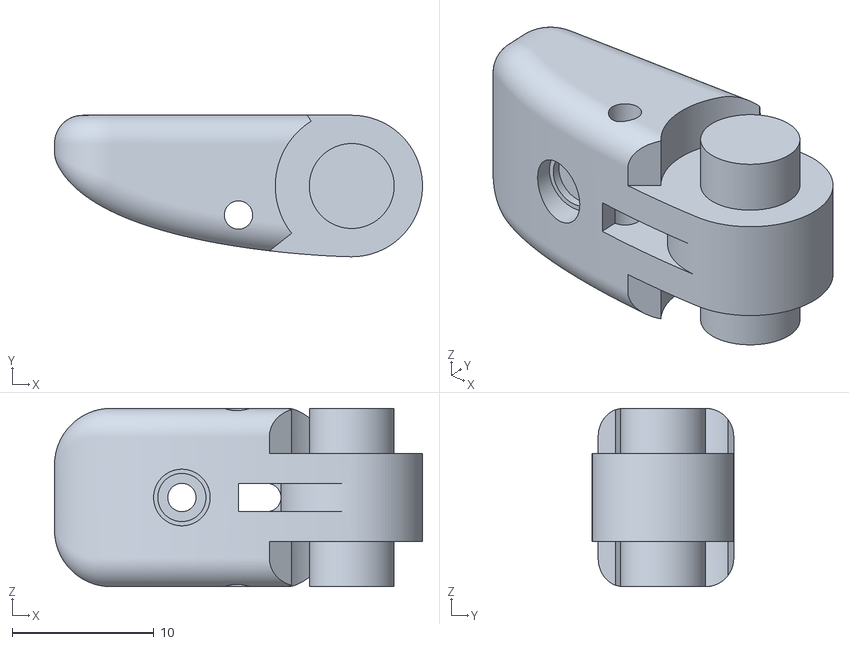
[picture p294: CAD file, 2025-05-09]
打印文件/fingers-thumb/middle/MIDDLE_Tip.stl
26.0 x 10.0 x 12.6
