18871379330/mydexhand/打印文件/fingers-thumb/pinky/PINKY_Bulk_Cover.stl

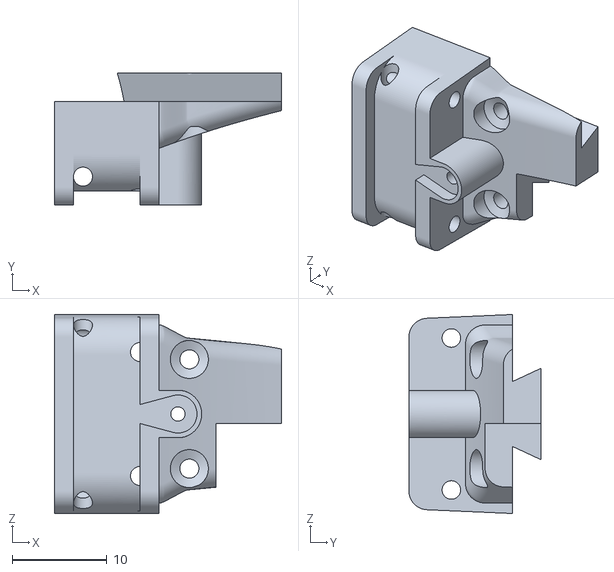
[picture p295: CAD file, 2025-05-09]
打印文件/fingers-thumb/pinky/PINKY_Bulk_Cover.stl
23.9 x 13.9 x 21.0
