18871379330/mydexhand/打印文件/fingers-thumb/ring/RING_Knuckle.stl

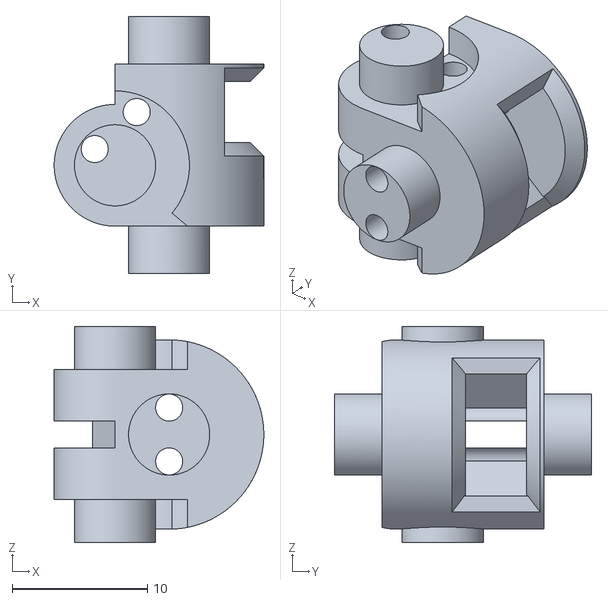
[picture p296: CAD file, 2025-05-09]
打印文件/fingers-thumb/ring/RING_Knuckle.stl
15.5 x 19.0 x 16.0
