18871379330/mydexhand/打印文件/fingers-thumb/thumb/THUMB_Tip.stl

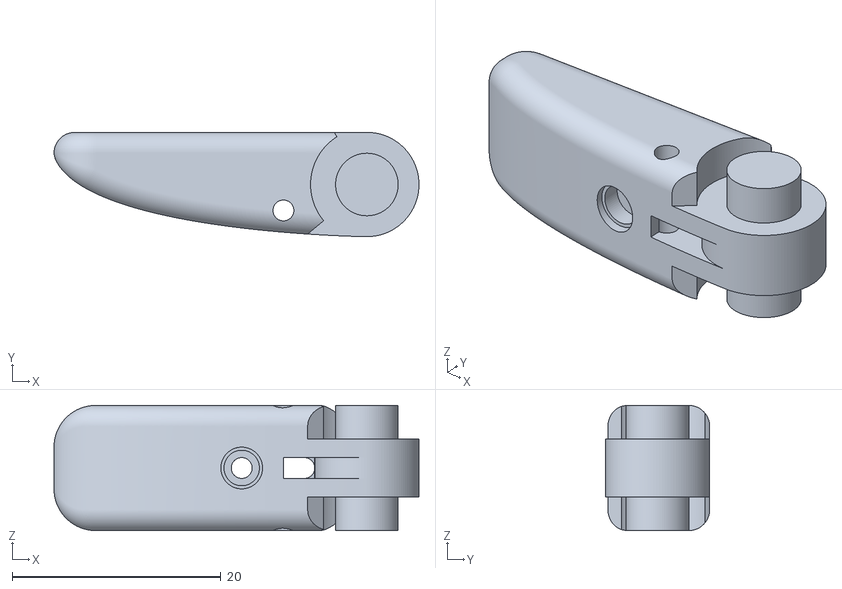
[picture p297: CAD file, 2025-05-09]
打印文件/fingers-thumb/thumb/THUMB_Tip.stl
35.0 x 10.0 x 12.0
