18871379330/mydexhand/打印文件/forearm/手臂.STL

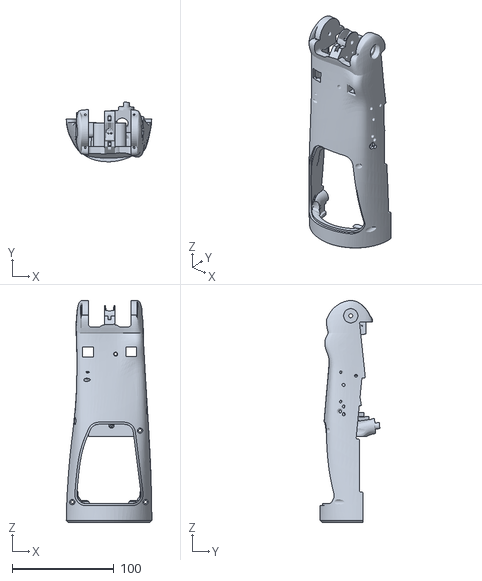
[picture p298: CAD file, 2025-05-09]
打印文件/forearm/手臂.STL
84.0 x 58.5 x 218.0
