18871379330/mydexhand/打印文件/tendon-spools/Tendon_Spool_01（带）_8个.STL

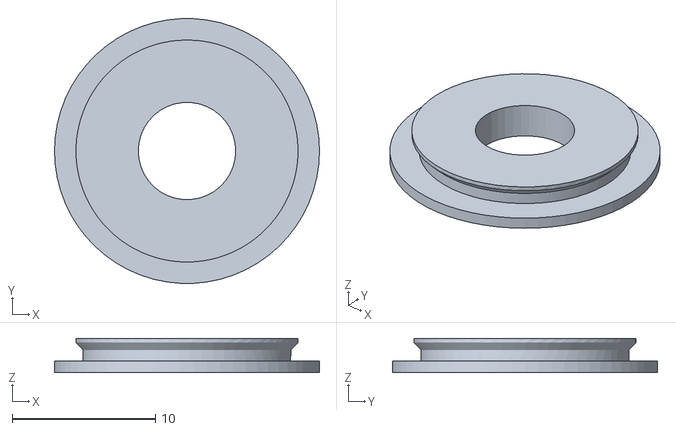
[picture p299: CAD file, 2025-05-09]
打印文件/tendon-spools/Tendon_Spool_01（带）_8个.STL
18.5 x 18.5 x 2.40
