18871379330/mydexhand/打印文件/wrist/Distal-Wrist-Clip-Bot.stl

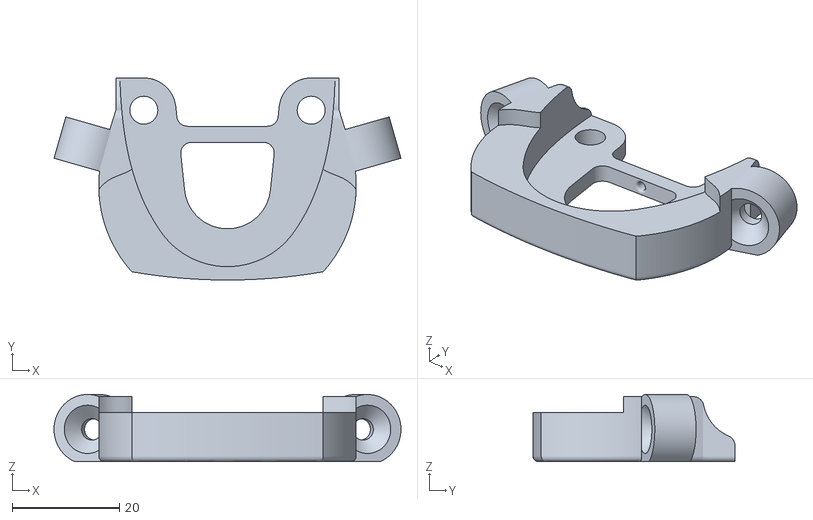
[picture p300: CAD file, 2025-05-09]
打印文件/wrist/Distal-Wrist-Clip-Bot.stl
64.7 x 37.7 x 12.5
