18871379330/mydexhand/打印文件/模具/模具1.STL

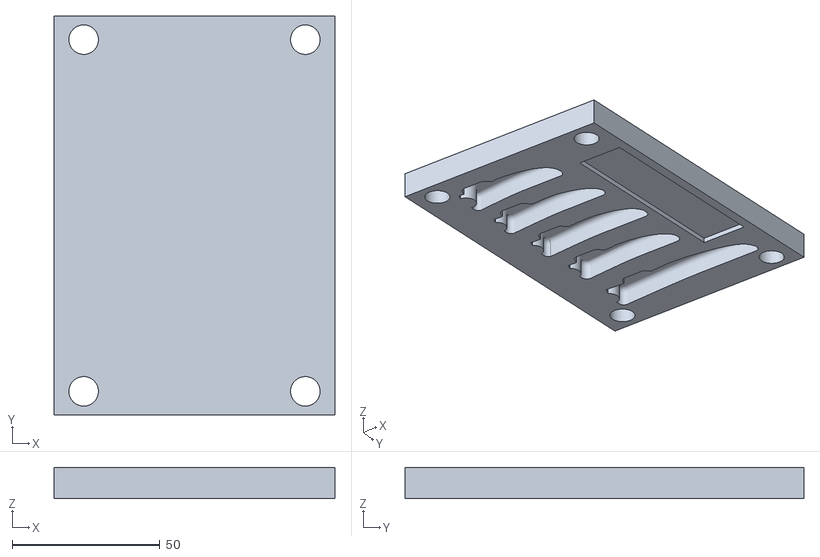
[picture p301: CAD file, 2025-05-09]
打印文件/模具/模具1.STL
95.0 x 135.0 x 10.5
