18871379330/mydexhand/提交附件/打印文件/fingers-thumb/index/INDEX_PLP.stl

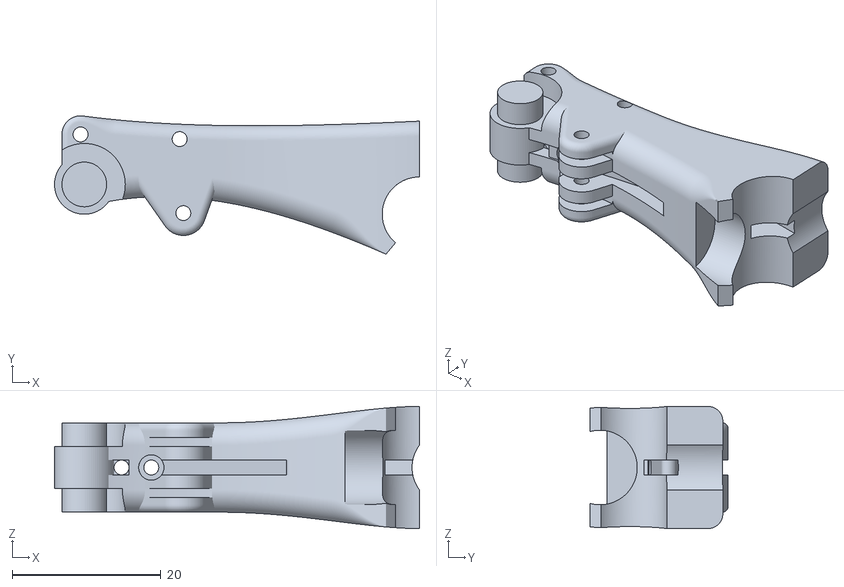
[picture p302: CAD file, 2025-05-09]
提交附件/打印文件/fingers-thumb/index/INDEX_PLP.stl
49.0 x 18.6 x 16.4
