18871379330/mydexhand/提交附件/打印文件/fingers-thumb/ring/RING_Bulk.stl

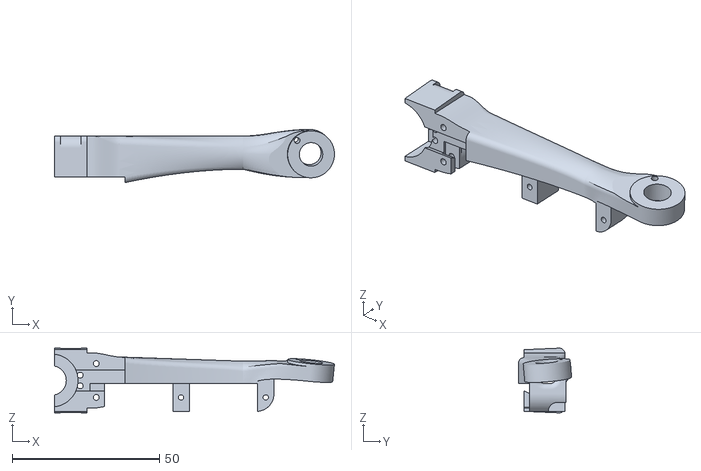
[picture p303: CAD file, 2025-05-09]
提交附件/打印文件/fingers-thumb/ring/RING_Bulk.stl
95.2 x 18.1 x 22.0
