18871379330/mydexhand/提交附件/打印文件/fingers-thumb/thumb/THUMB_Knuckle_A.stl

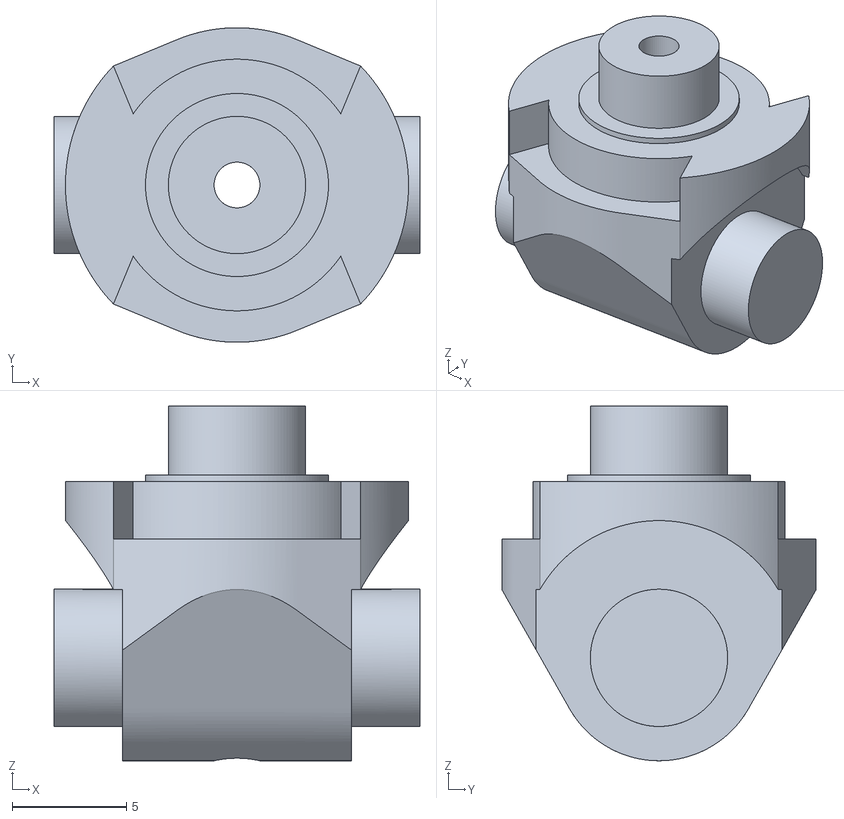
[picture p304: CAD file, 2025-05-09]
提交附件/打印文件/fingers-thumb/thumb/THUMB_Knuckle_A.stl
16.0 x 13.7 x 15.5
