18871379330/mydexhand/提交附件/打印文件/fingers-thumb/Thumb_Tendon_Hanger_03a（带）.STL

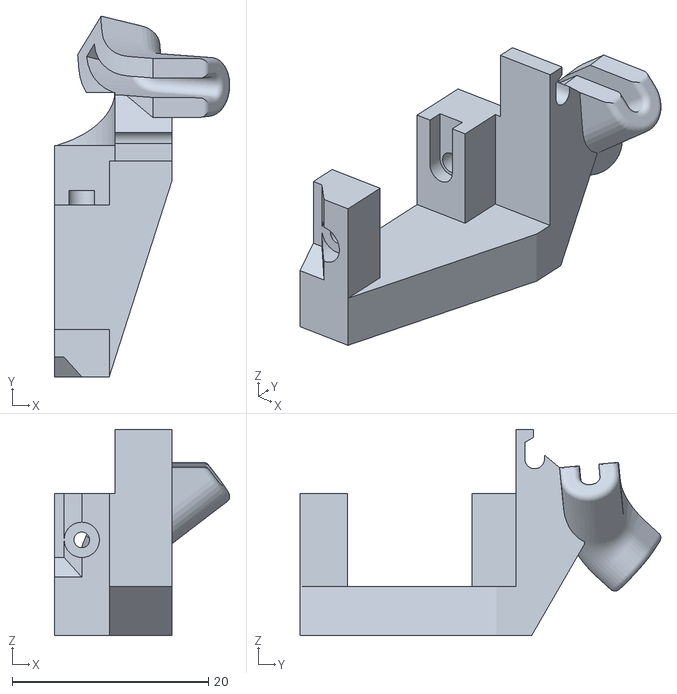
[picture p305: CAD file, 2025-05-09]
提交附件/打印文件/fingers-thumb/Thumb_Tendon_Hanger_03a（带）.STL
17.9 x 36.8 x 21.0
