18871379330/mydexhand/提交附件/打印文件/forearm/FOREARM_Wrist_Spool_Cover_2.stl

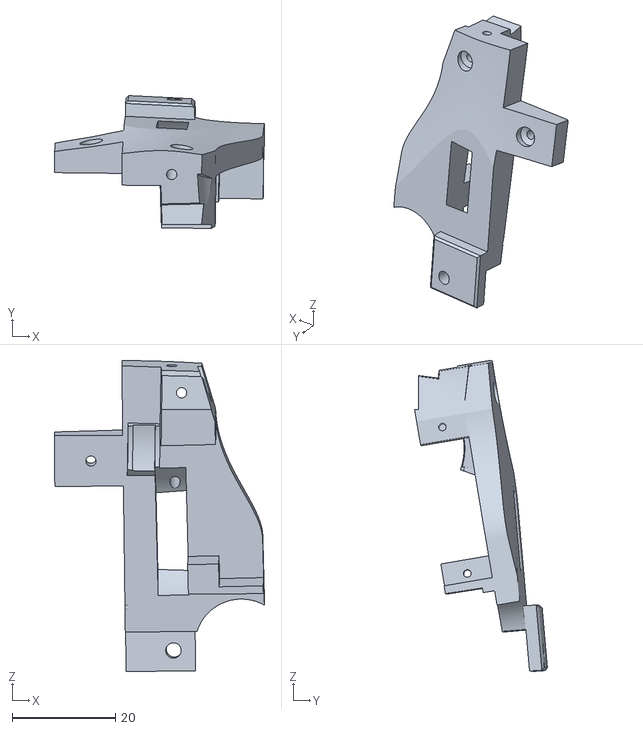
[picture p306: CAD file, 2025-05-09]
提交附件/打印文件/forearm/FOREARM_Wrist_Spool_Cover_2.stl
40.7 x 25.8 x 60.3
