18871379330/mydexhand/模具/模具1.SLDPRT

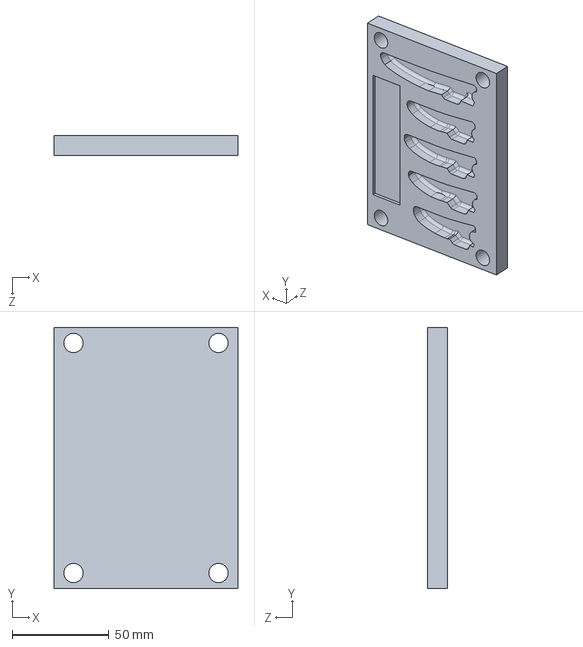
[picture p307: CAD file, 2025-05-09]
模具/模具1.SLDPRT
95.0 x 135.0 x 10.5 mm
