18871379330/mydexhand/食指/固体工程中的拉伸弹簧/spring.SLDPRT

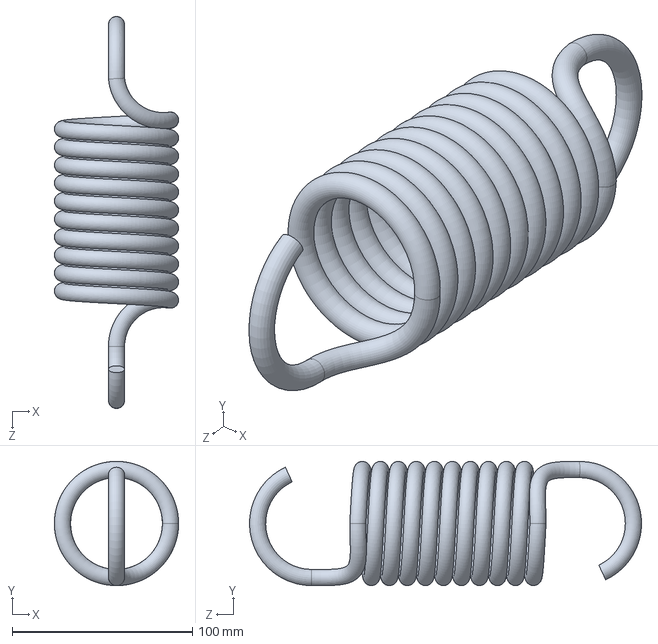
[picture p308: CAD file, 2025-05-09]
食指/固体工程中的拉伸弹簧/spring.SLDPRT
69.0 x 69.0 x 217.7 mm
