18871379330/mydexhand/食指/硅胶垫片.SLDPRT

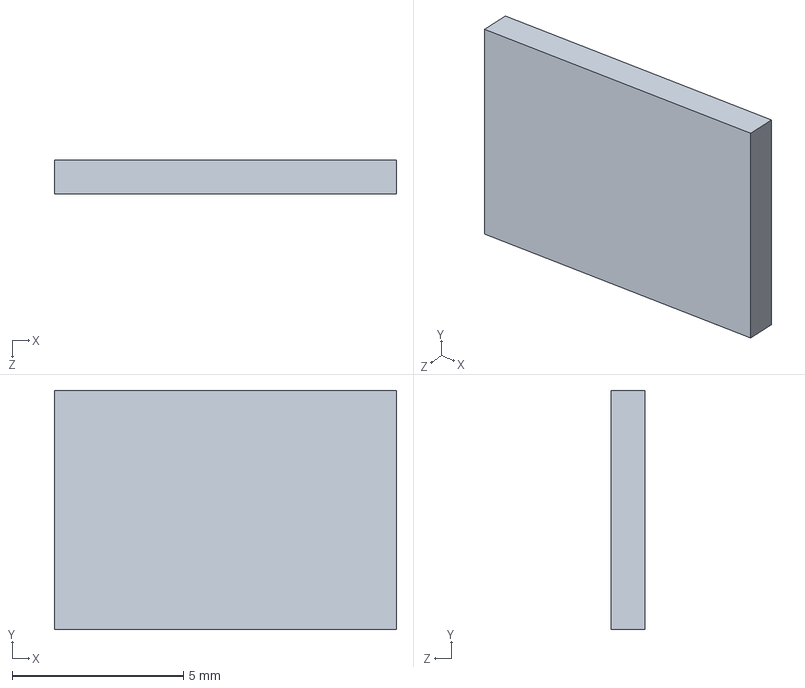
[picture p309: CAD file, 2025-05-09]
食指/硅胶垫片.SLDPRT
10.0 x 7.00 x 1.00 mm
