18871379330/mydexhand/中指/输出远端.SLDPRT

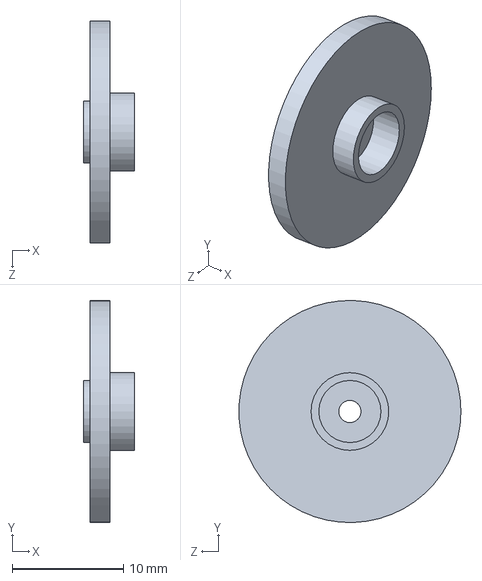
[picture p310: CAD file, 2025-02-11]
中指/输出远端.SLDPRT
4.60 x 20.0 x 20.0 mm
