18871379330/mydexhand/小指/小指腹.SLDPRT

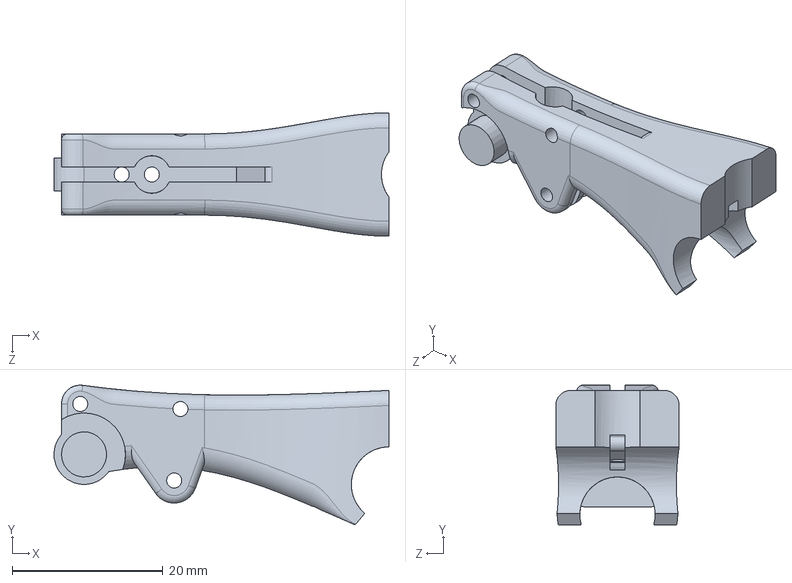
[picture p311: CAD file, 2025-02-11]
小指/小指腹.SLDPRT
44.5 x 18.6 x 16.4 mm
