18871379330/mydexhand/手腕/手下腕.SLDPRT

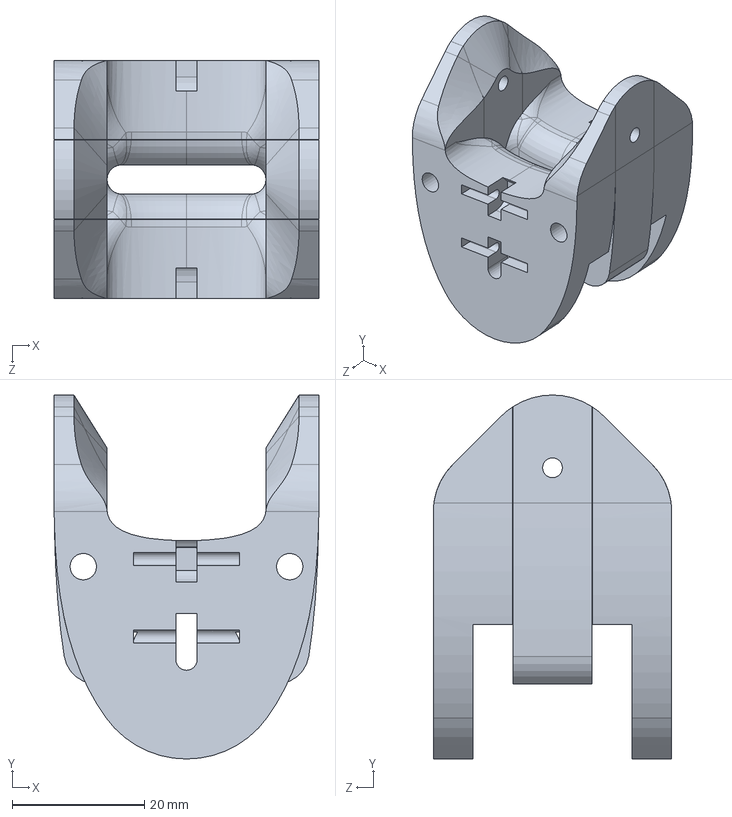
[picture p312: CAD file, 2025-02-11]
手腕/手下腕.SLDPRT
40.0 x 55.0 x 36.0 mm
