18871379330/mydexhand/手臂/Emax_23mm_03舵机.SLDPRT

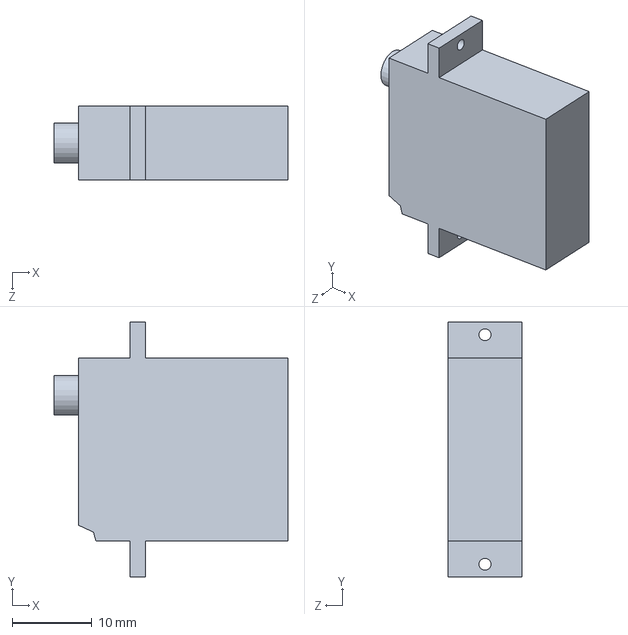
[picture p313: CAD file, 2025-05-09]
手臂/Emax_23mm_03舵机.SLDPRT
29.4 x 32.0 x 9.30 mm
