18871379330/mydexhand/打印文件/fingers-thumb/thumb/THUMB_PLP.stl

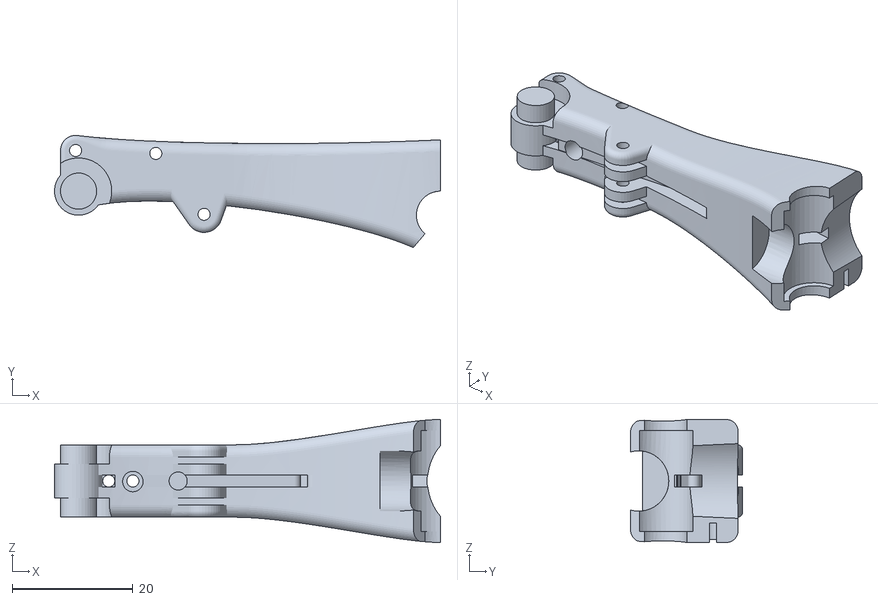
[picture p315: CAD file, 2025-05-09]
打印文件/fingers-thumb/thumb/THUMB_PLP.stl
64.0 x 18.6 x 20.4
