18871379330/mydexhand/打印文件/forearm/FOREARM_Servo_Clip_2.stl

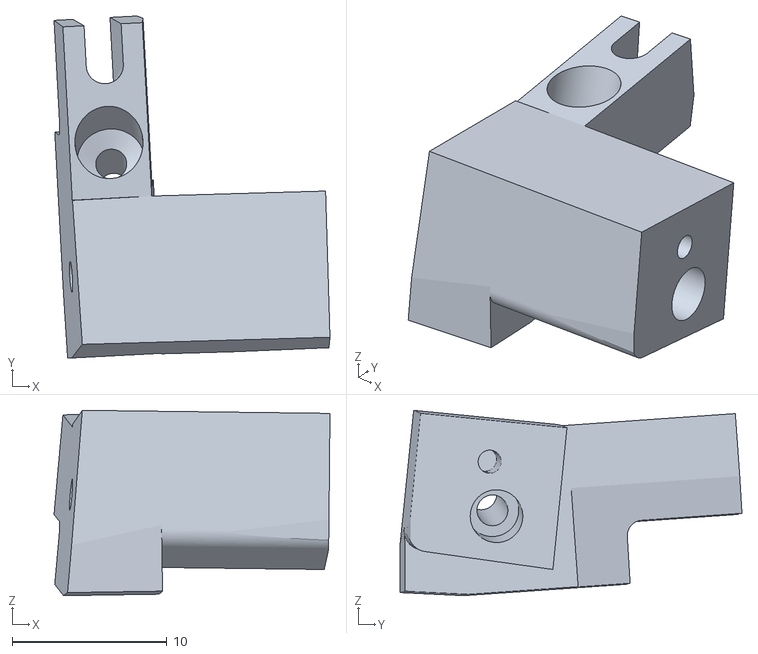
[picture p316: CAD file, 2025-05-09]
打印文件/forearm/FOREARM_Servo_Clip_2.stl
17.8 x 22.1 x 12.0
