18871379330/mydexhand/打印文件/tendon-spools/SPOOL_Large_Left_8个.stl

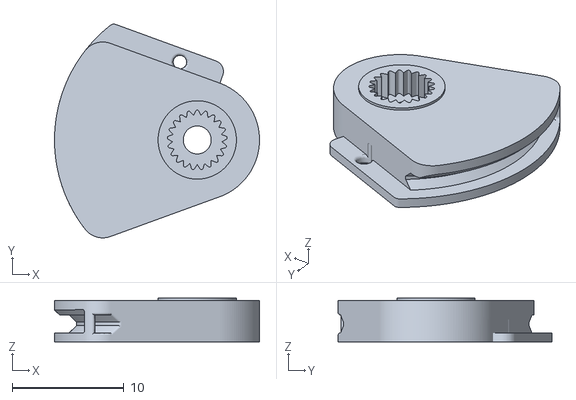
[picture p317: CAD file, 2025-05-09]
打印文件/tendon-spools/SPOOL_Large_Left_8个.stl
18.3 x 19.1 x 3.90
