18871379330/mydexhand/打印文件/模具/模具2.STL

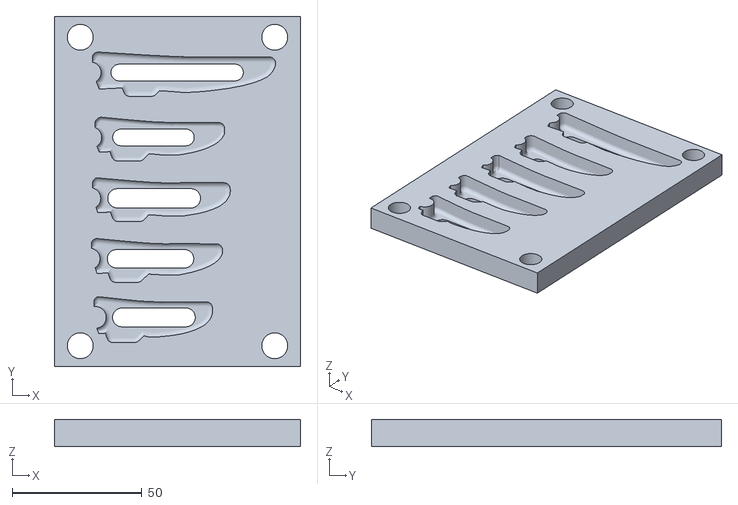
[picture p318: CAD file, 2025-05-09]
打印文件/模具/模具2.STL
95.0 x 135.0 x 10.5
