18871379330/mydexhand/提交附件/打印文件/fingers-thumb/middle/MIDDLE_PLP.stl

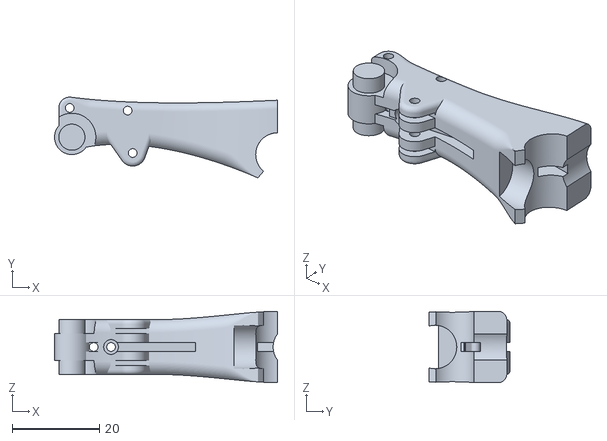
[picture p319: CAD file, 2025-05-09]
提交附件/打印文件/fingers-thumb/middle/MIDDLE_PLP.stl
51.2 x 18.6 x 16.4
