18871379330/mydexhand/提交附件/打印文件/forearm/FOREARM_Wrist_Spool_Cover_1.stl

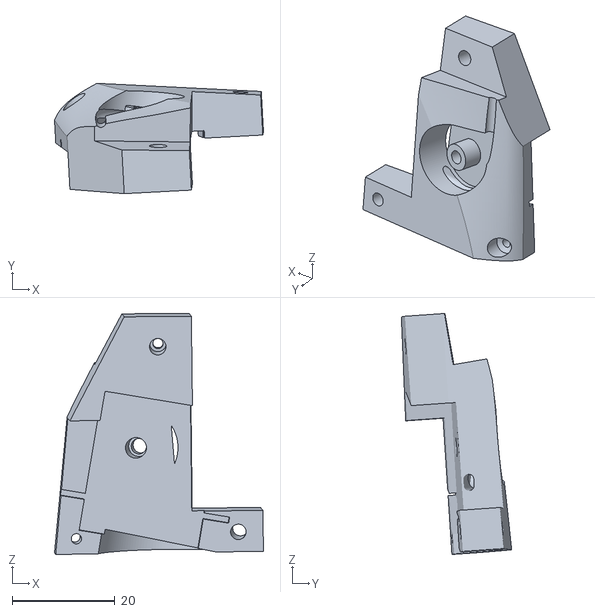
[picture p320: CAD file, 2025-05-09]
提交附件/打印文件/forearm/FOREARM_Wrist_Spool_Cover_1.stl
40.7 x 21.5 x 46.9
