18871379330/mydexhand/提交附件/打印文件/wrist/Wrist_Proximal_Tunnel.stl

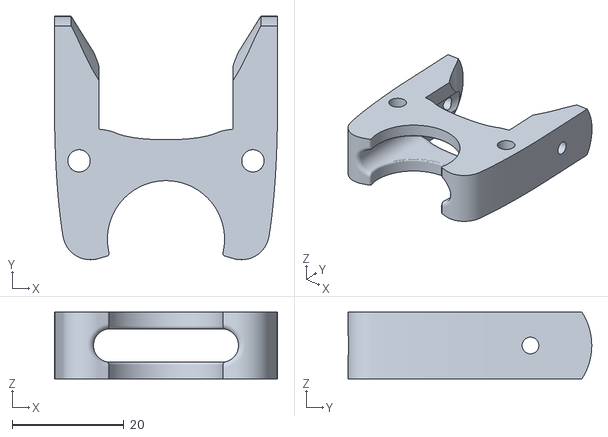
[picture p321: CAD file, 2025-05-09]
提交附件/打印文件/wrist/Wrist_Proximal_Tunnel.stl
40.0 x 43.7 x 12.0
