18871379330/mydexhand/食指/回复弹簧线.SLDPRT

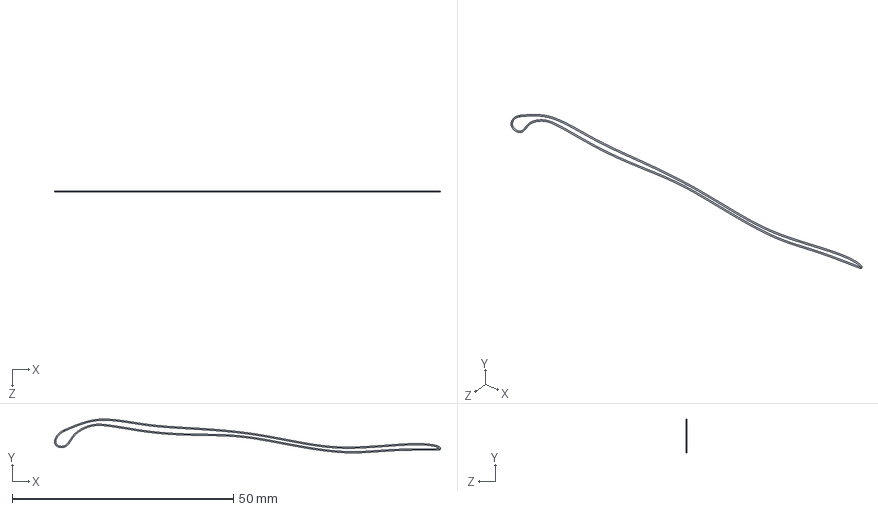
[picture p323: CAD file, 2025-05-09]
食指/回复弹簧线.SLDPRT
87.3 x 7.68 x 0.3 mm
