18871379330/mydexhand/大拇指/大拇指腹.SLDPRT

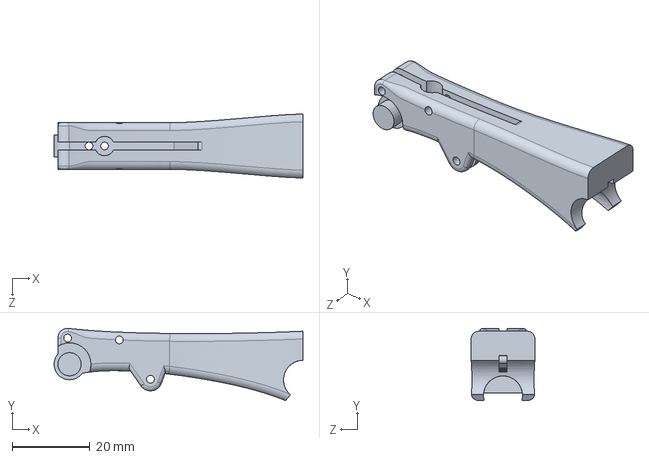
[picture p324: CAD file, 2025-02-11]
大拇指/大拇指腹.SLDPRT
64.0 x 18.6 x 16.4 mm
