18871379330/mydexhand/手/掌固定绳.SLDPRT

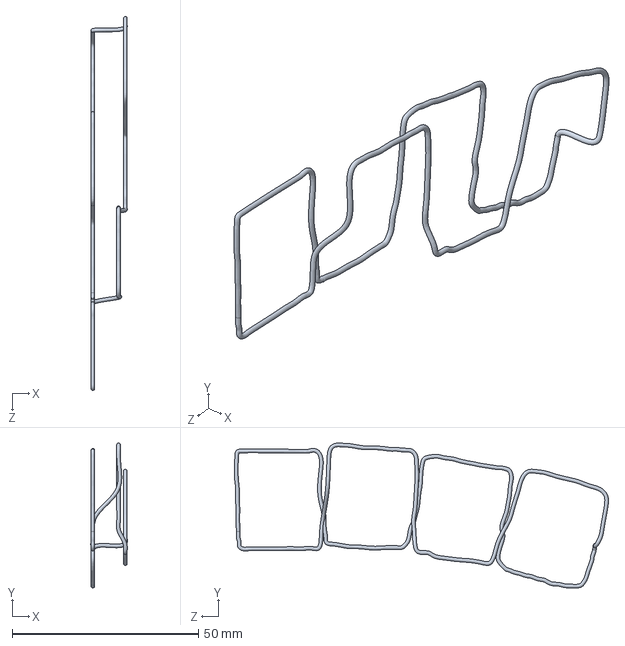
[picture p325: CAD file, 2025-05-09]
手/掌固定绳.SLDPRT
9.87 x 39.0 x 100.5 mm
