18871379330/mydexhand/手腕/手腕壳.SLDPRT

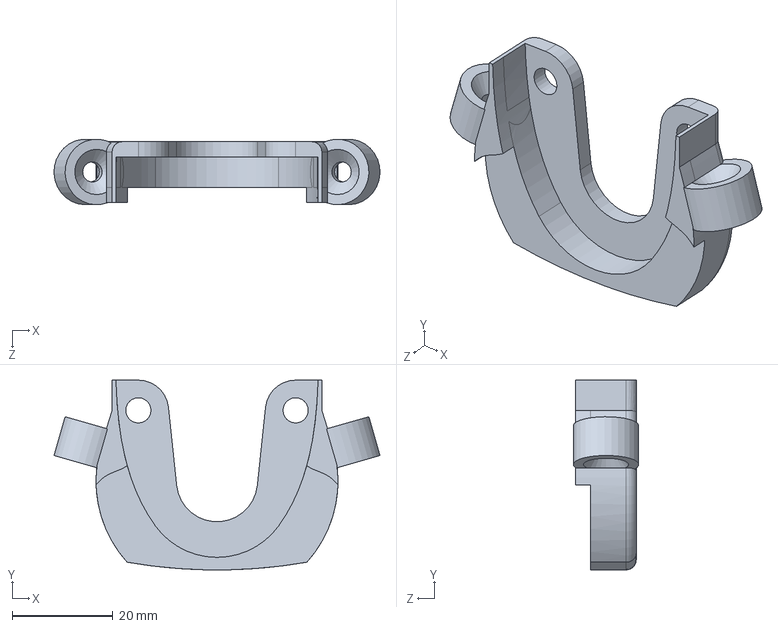
[picture p326: CAD file, 2025-02-11]
手腕/手腕壳.SLDPRT
64.7 x 37.6 x 13.0 mm
