18871379330/mydexhand/手臂/SCS2332舵机.SLDPRT

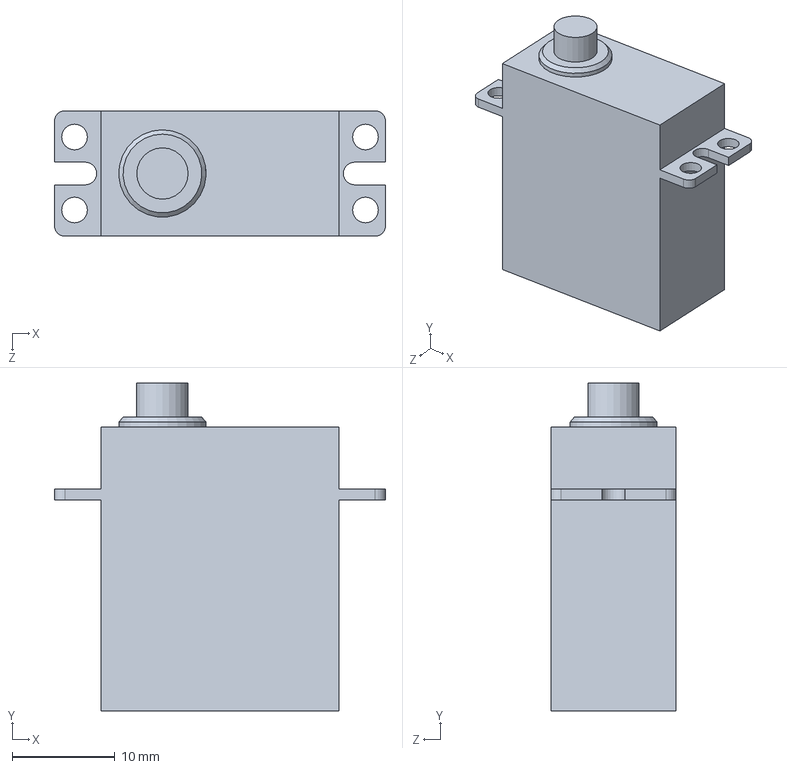
[picture p327: CAD file, 2025-05-09]
手臂/SCS2332舵机.SLDPRT
32.2 x 31.9 x 12.2 mm
