18871379330/mydexhand/打印文件/fingers-thumb/pinky/PINKY_Bulk.stl

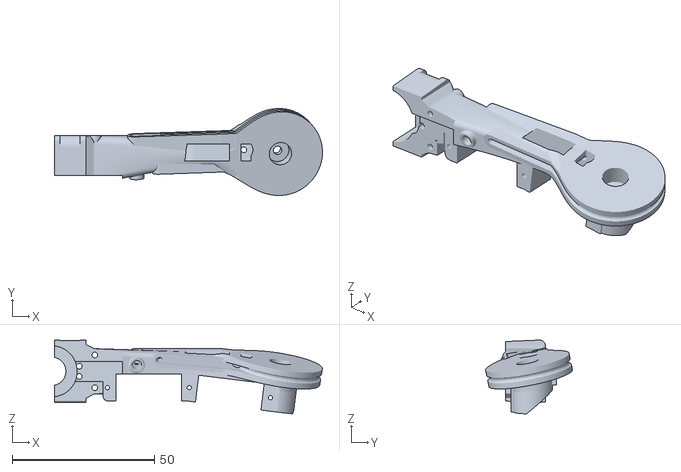
[picture p328: CAD file, 2025-05-09]
打印文件/fingers-thumb/pinky/PINKY_Bulk.stl
94.3 x 30.6 x 26.0
