18871379330/mydexhand/打印文件/fingers-thumb/thumb/THUMB_Knuckle_B.stl

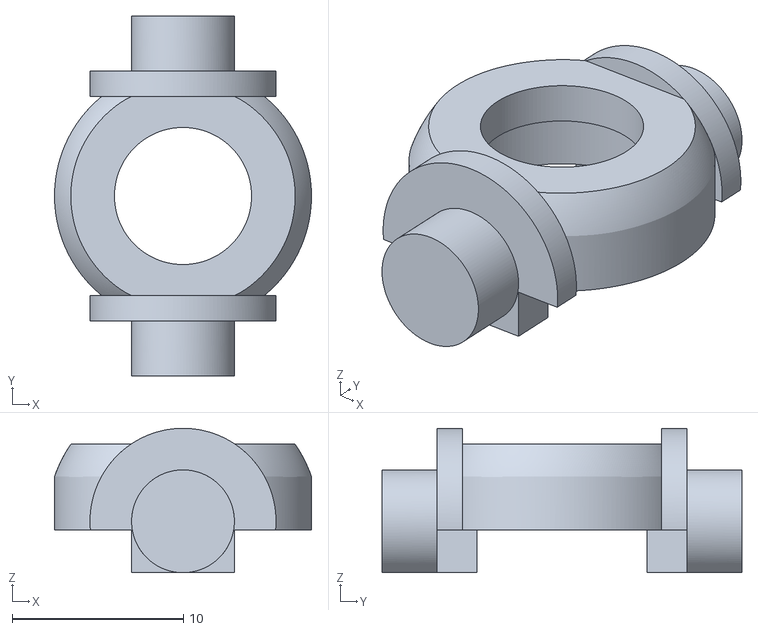
[picture p329: CAD file, 2025-05-09]
打印文件/fingers-thumb/thumb/THUMB_Knuckle_B.stl
15.0 x 21.0 x 8.43
