18871379330/mydexhand/打印文件/fingers-thumb/大拇指弹簧件.STL

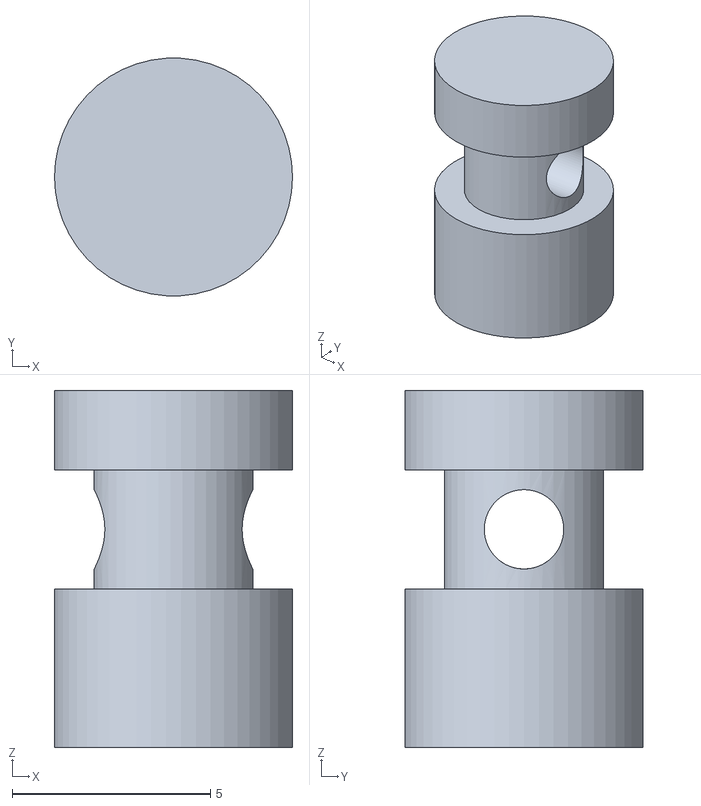
[picture p330: CAD file, 2025-03-30]
打印文件/fingers-thumb/大拇指弹簧件.STL
6.00 x 5.99 x 9.00
