18871379330/mydexhand/打印文件/tendon-spools/SPOOL_Wrist_Tendon_2个.stl

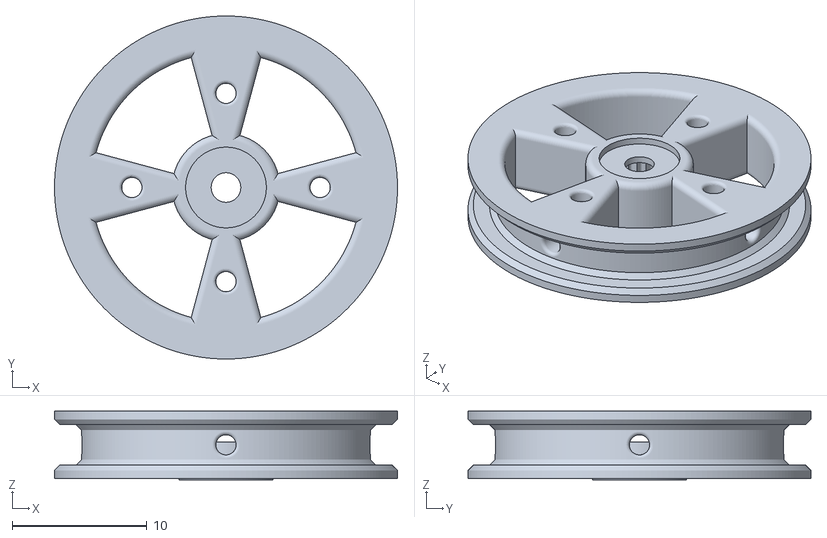
[picture p331: CAD file, 2025-05-09]
打印文件/tendon-spools/SPOOL_Wrist_Tendon_2个.stl
25.5 x 25.5 x 5.10
