18871379330/mydexhand/打印文件/wrist/Distal_Wrist_Bot.stl

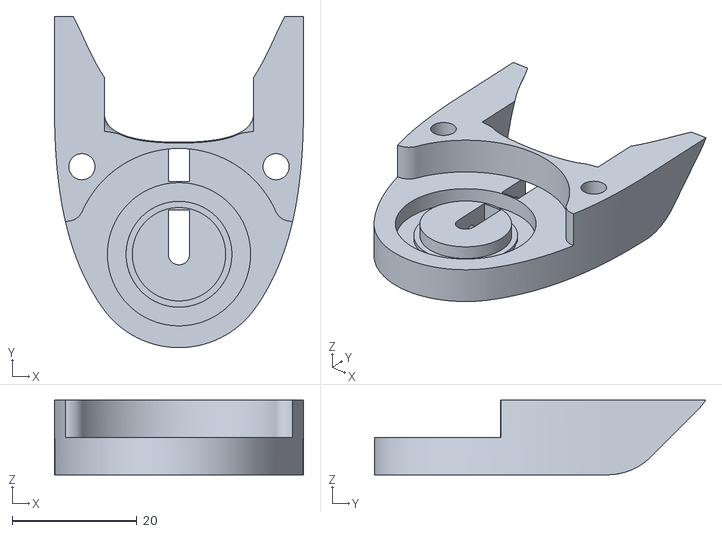
[picture p332: CAD file, 2025-05-09]
打印文件/wrist/Distal_Wrist_Bot.stl
40.0 x 53.2 x 12.0
