18871379330/mydexhand/提交附件/打印文件/tendon-spools/Wrist_Tendon_Spool_05 v5.step

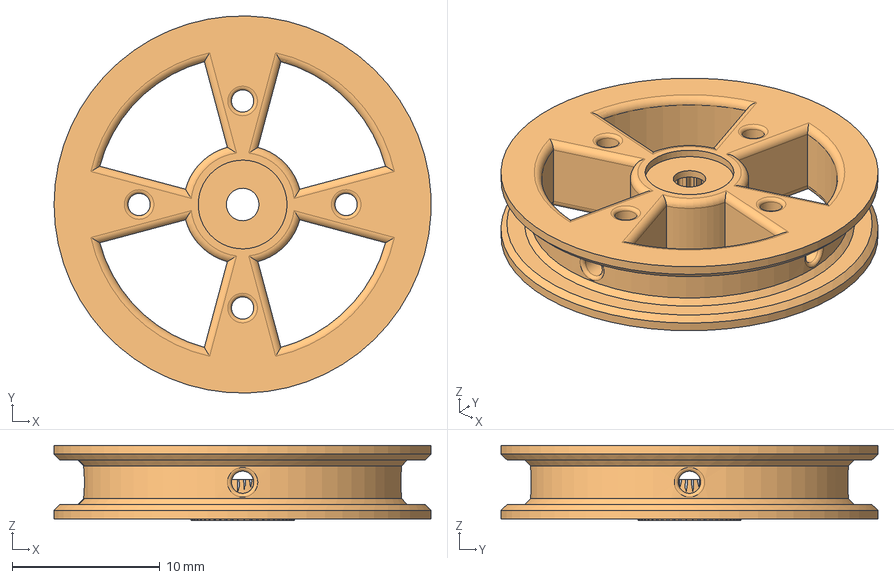
[picture p333: CAD file, 2025-05-09]
提交附件/打印文件/tendon-spools/Wrist_Tendon_Spool_05 v5.step
25.5 x 25.5 x 5.10 mm
AVE_RENDER x 8
AVE_GLOBAL
