18871379330/mydexhand/无名指/无名指底.SLDPRT

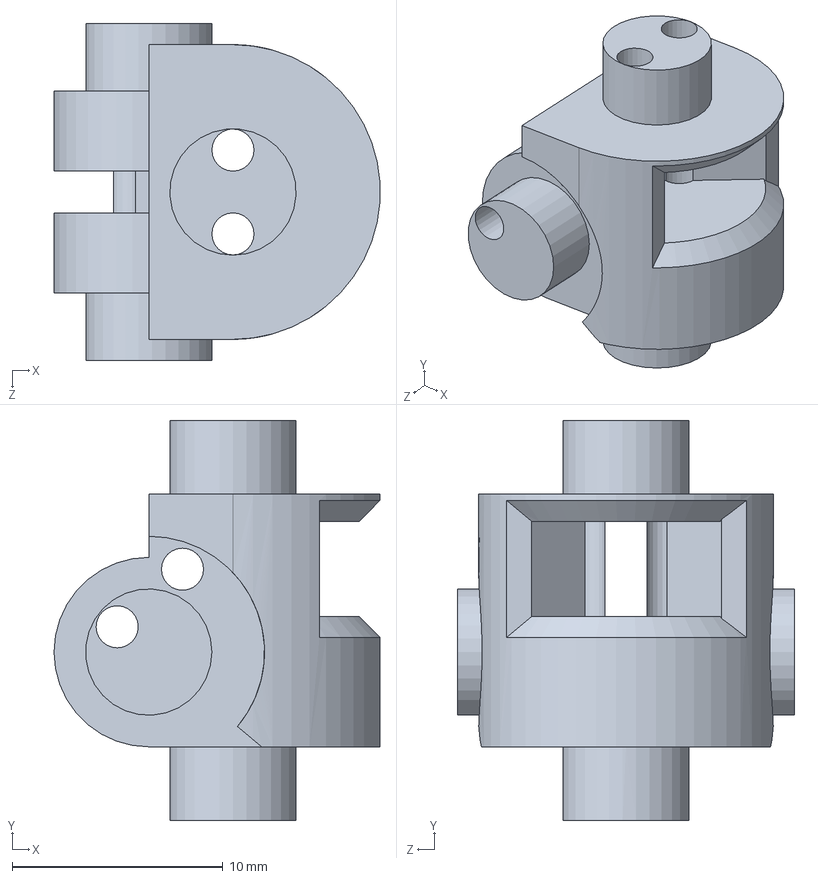
[picture p334: CAD file, 2025-02-11]
无名指/无名指底.SLDPRT
15.5 x 19.0 x 16.0 mm
