18871379330/mydexhand/食指/摆动绳左.SLDPRT

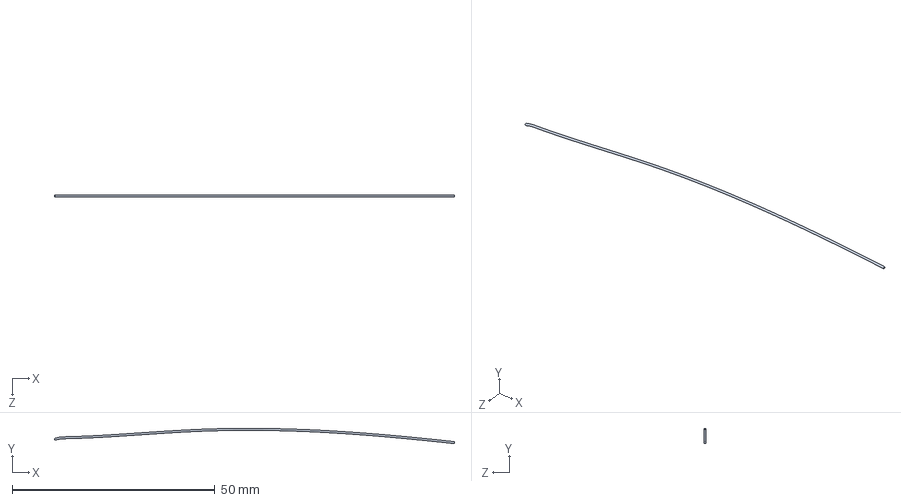
[picture p335: CAD file, 2025-05-09]
食指/摆动绳左.SLDPRT
98.7 x 3.77 x 0.498 mm
