18871379330/mydexhand/小指/小指中.SLDPRT

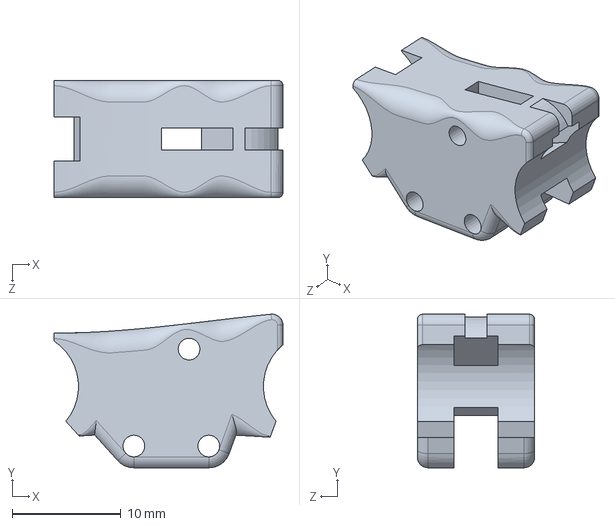
[picture p336: CAD file, 2025-02-11]
小指/小指中.SLDPRT
21.1 x 14.1 x 10.8 mm
