18871379330/mydexhand/手腕/M3螺丝.SLDPRT

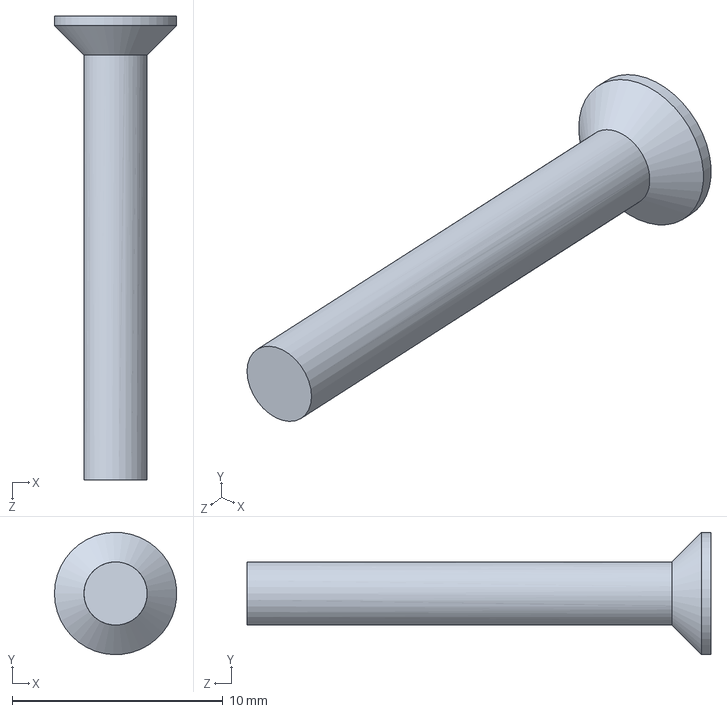
[picture p337: CAD file, 2025-02-11]
手腕/M3螺丝.SLDPRT
5.79 x 5.80 x 22.0 mm
