18871379330/mydexhand/打印文件/fingers-thumb/middle/MIDDLE_Bulk.stl

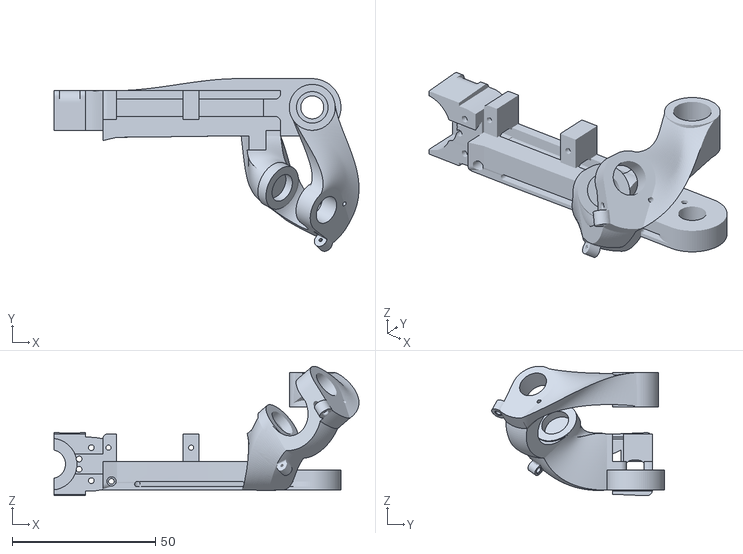
[picture p338: CAD file, 2025-05-09]
打印文件/fingers-thumb/middle/MIDDLE_Bulk.stl
106.3 x 60.2 x 45.1
