18871379330/mydexhand/打印文件/tendon-spools/Tendon_Spool_Large v12.step

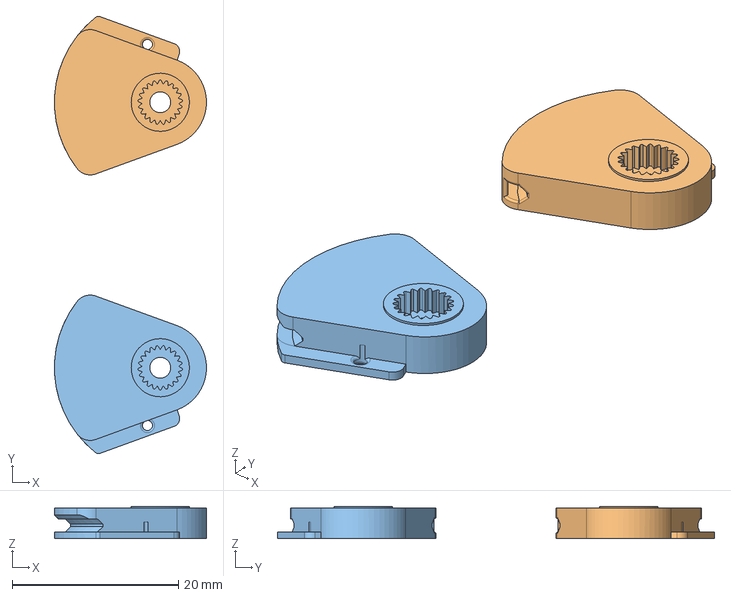
[picture p339: CAD file, 2025-05-09]
打印文件/tendon-spools/Tendon_Spool_Large v12.step
18.3 x 52.7 x 3.90 mm
AVE_RENDER x 8
AVE_GLOBAL
