18871379330/mydexhand/打印文件/wrist/Wrist_Proximal_Lower.stl

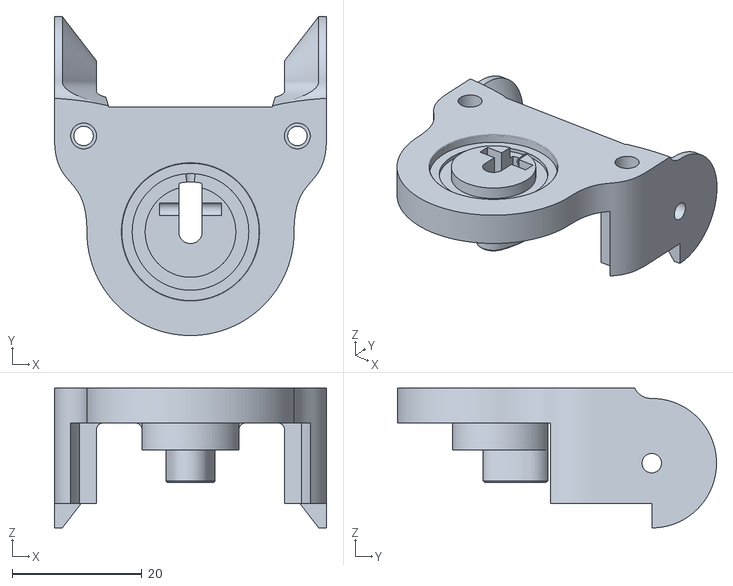
[picture p340: CAD file, 2025-05-09]
打印文件/wrist/Wrist_Proximal_Lower.stl
42.0 x 49.3 x 21.6
