18871379330/mydexhand/提交附件/打印文件/fingers-thumb/index/INDEX_Bulk_Cap.stl

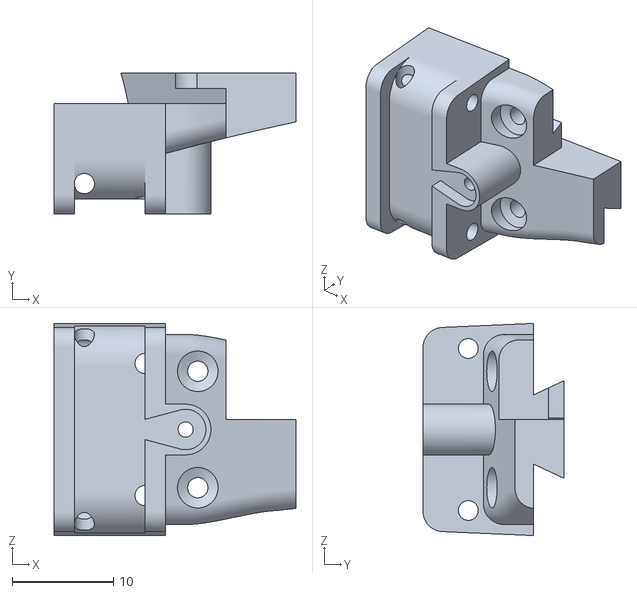
[picture p341: CAD file, 2025-05-09]
提交附件/打印文件/fingers-thumb/index/INDEX_Bulk_Cap.stl
23.9 x 13.9 x 21.0
