18871379330/mydexhand/提交附件/打印文件/fingers-thumb/pinky/PINKY_Tip.stl

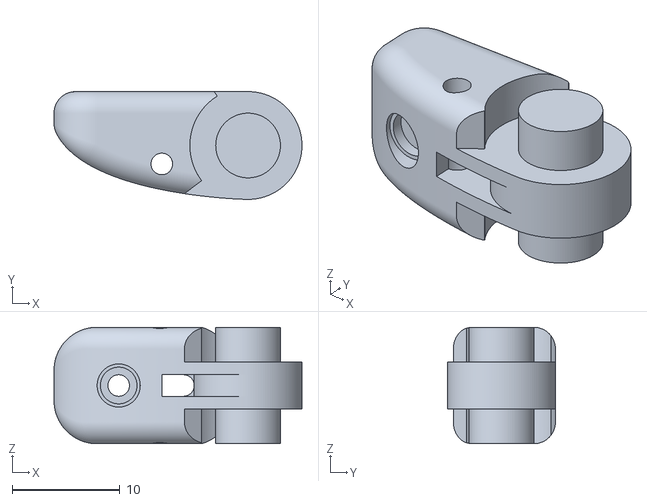
[picture p342: CAD file, 2025-05-09]
提交附件/打印文件/fingers-thumb/pinky/PINKY_Tip.stl
23.0 x 10.0 x 10.8
