18871379330/mydexhand/提交附件/打印文件/fingers-thumb/ring/RING_MLP.stl

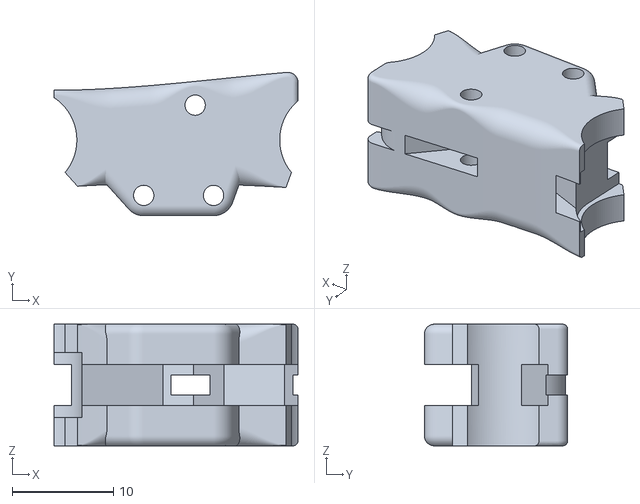
[picture p343: CAD file, 2025-05-09]
提交附件/打印文件/fingers-thumb/ring/RING_MLP.stl
24.1 x 14.1 x 12.0
