18871379330/mydexhand/提交附件/打印文件/fingers-thumb/thumb/THUMB_MLP.stl

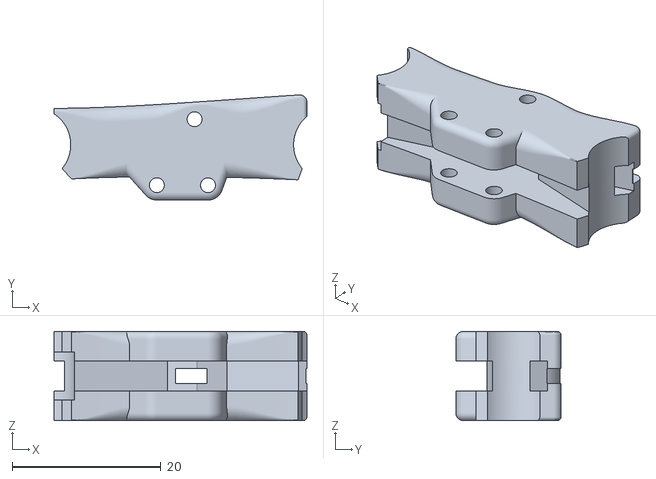
[picture p344: CAD file, 2025-05-09]
提交附件/打印文件/fingers-thumb/thumb/THUMB_MLP.stl
34.0 x 14.2 x 12.0
