18871379330/mydexhand/提交附件/打印文件/forearm/手臂2.STL

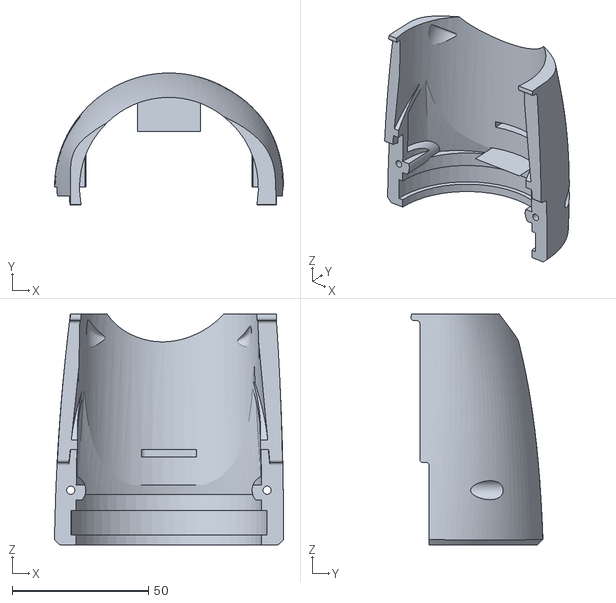
[picture p345: CAD file, 2025-05-09]
提交附件/打印文件/forearm/手臂2.STL
84.0 x 48.4 x 84.5
