18871379330/mydexhand/提交附件/打印文件/wrist/Wrist_Proximal_Upper.stl

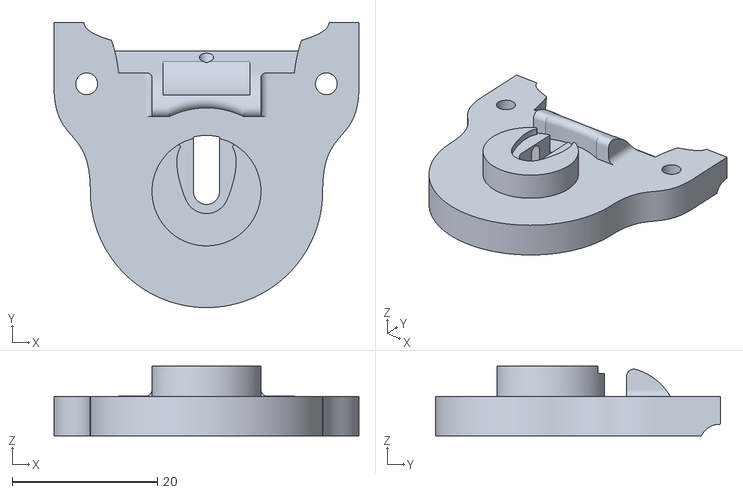
[picture p346: CAD file, 2025-05-09]
提交附件/打印文件/wrist/Wrist_Proximal_Upper.stl
42.0 x 39.3 x 9.60
