18871379330/mydexhand/食指/摆动绳右.SLDPRT

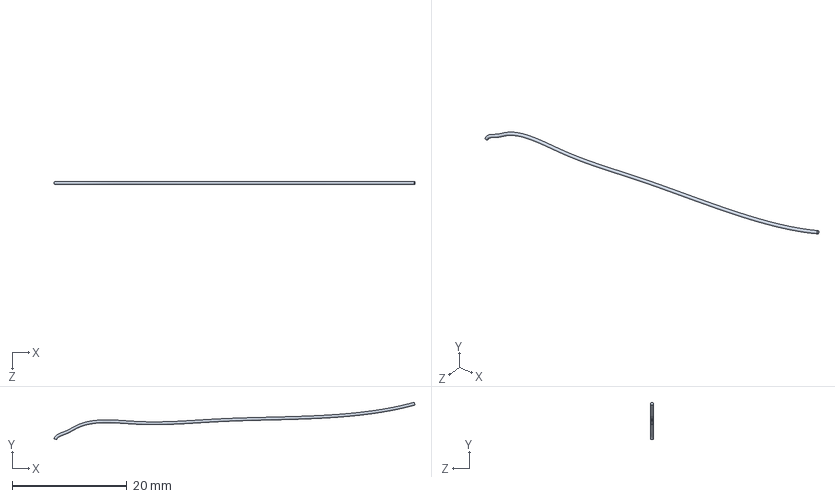
[picture p347: CAD file, 2025-05-09]
食指/摆动绳右.SLDPRT
62.9 x 6.52 x 0.5 mm
