18871379330/mydexhand/中指/6x10x3轴承.SLDPRT

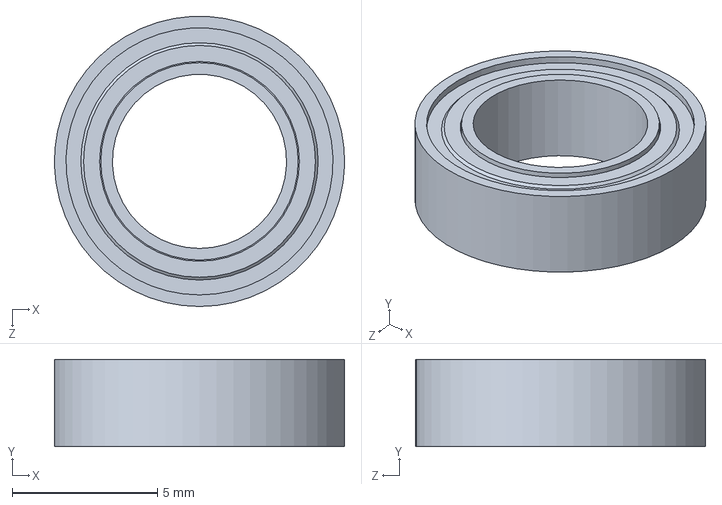
[picture p348: CAD file, 2025-02-11]
中指/6x10x3轴承.SLDPRT
10.00 x 3.00 x 9.99 mm
