18871379330/mydexhand/手/手腕驱动绳.SLDPRT

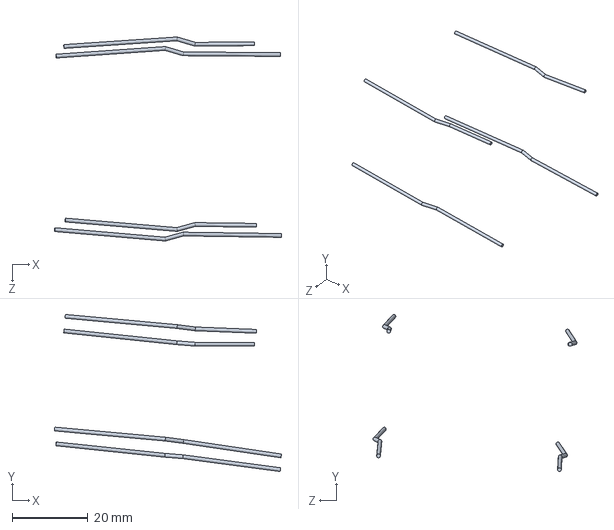
[picture p349: CAD file, 2025-05-09]
手/手腕驱动绳.SLDPRT
60.0 x 41.5 x 53.9 mm
