18871379330/mydexhand/手腕/手上腕.SLDPRT

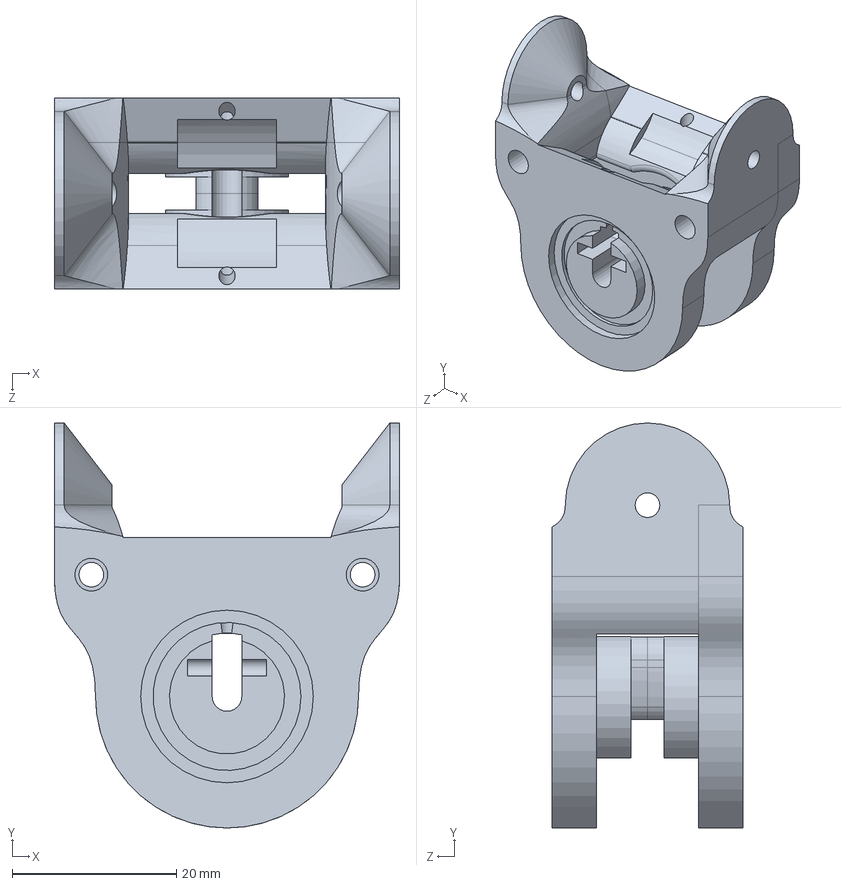
[picture p350: CAD file, 2025-02-11]
手腕/手上腕.SLDPRT
42.0 x 49.3 x 23.2 mm
