18871379330/mydexhand/打印文件/fingers-thumb/middle/MIDDLE_MLP.stl

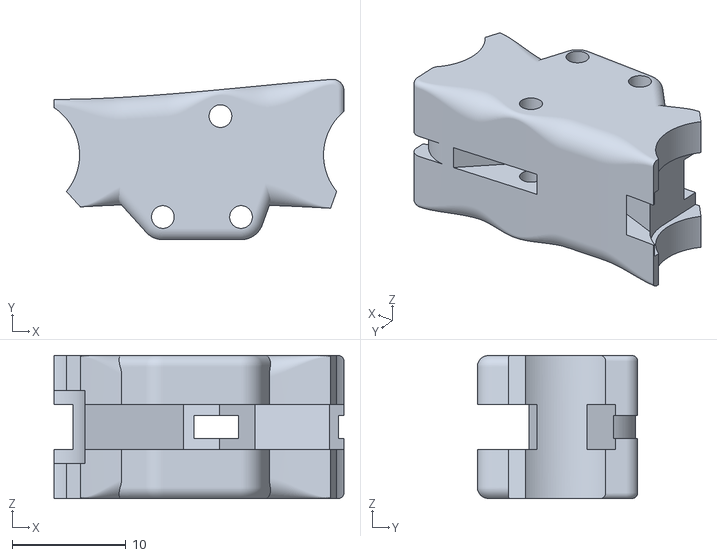
[picture p351: CAD file, 2025-05-09]
打印文件/fingers-thumb/middle/MIDDLE_MLP.stl
25.6 x 14.1 x 12.6
