18871379330/mydexhand/打印文件/tendon-spools/Tendon_Spool_Small v7.step

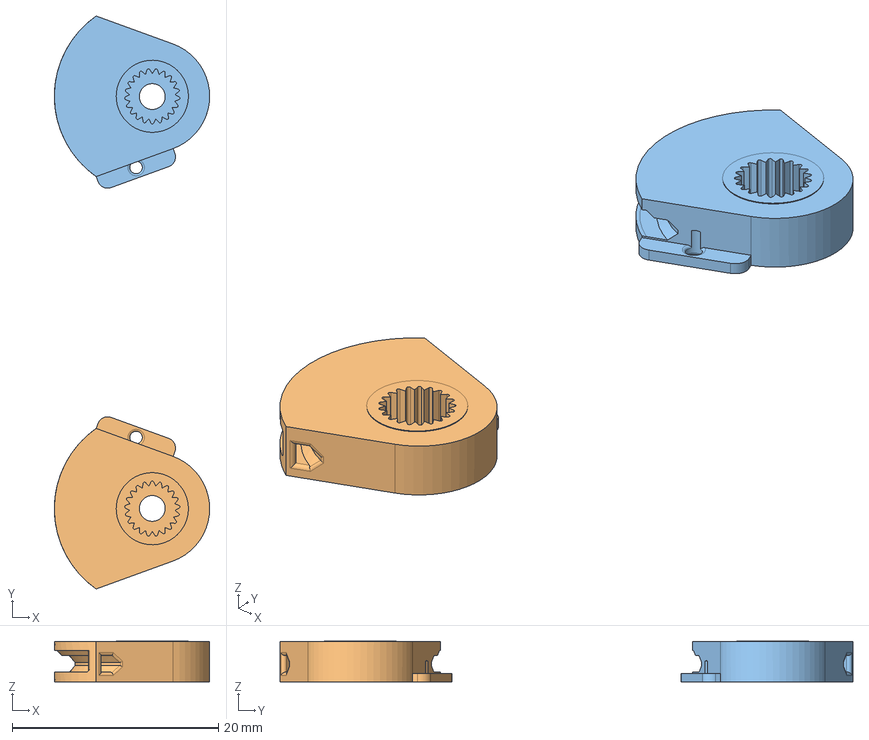
[picture p352: CAD file, 2025-05-09]
打印文件/tendon-spools/Tendon_Spool_Small v7.step
15.1 x 55.6 x 3.95 mm
AVE_RENDER x 8
AVE_GLOBAL
