18871379330/mydexhand/食指/应变片.SLDPRT

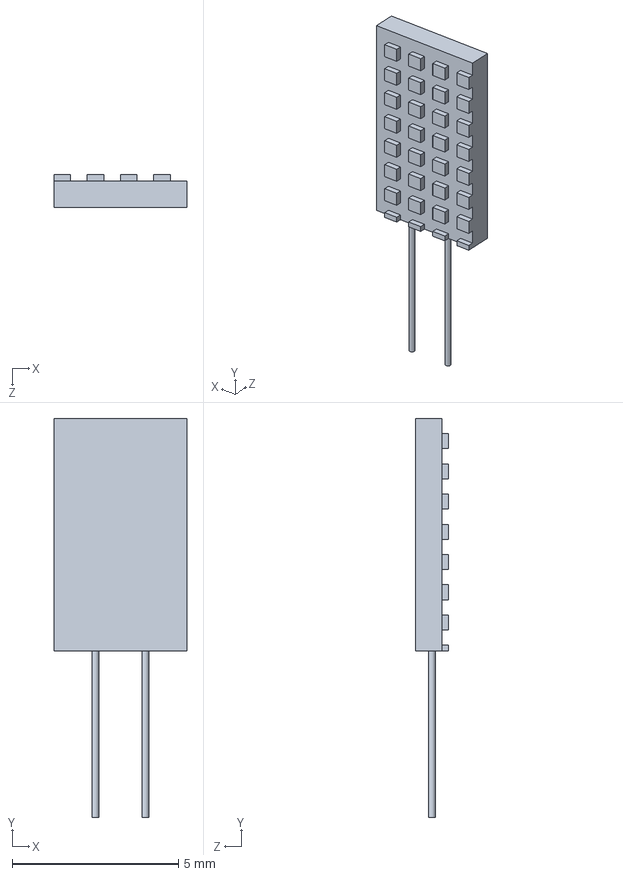
[picture p353: CAD file, 2025-05-09]
食指/应变片.SLDPRT
4.00 x 12.0 x 1.00 mm
