18871379330/mydexhand/手/手腕8字绳1.SLDPRT

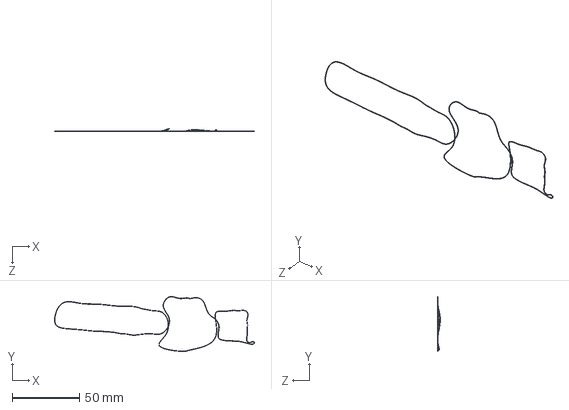
[picture p354: CAD file, 2025-05-09]
手/手腕8字绳1.SLDPRT
148.3 x 40.8 x 2.10 mm
