18871379330/mydexhand/手腕/15x21x4轴承.SLDPRT

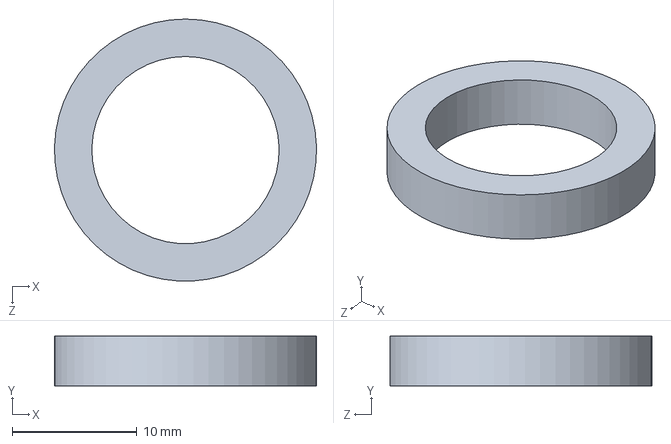
[picture p355: CAD file, 2025-02-11]
手腕/15x21x4轴承.SLDPRT
21.0 x 4.00 x 21.0 mm
