18871379330/mydexhand/大拇指/大拇指.SLDASM

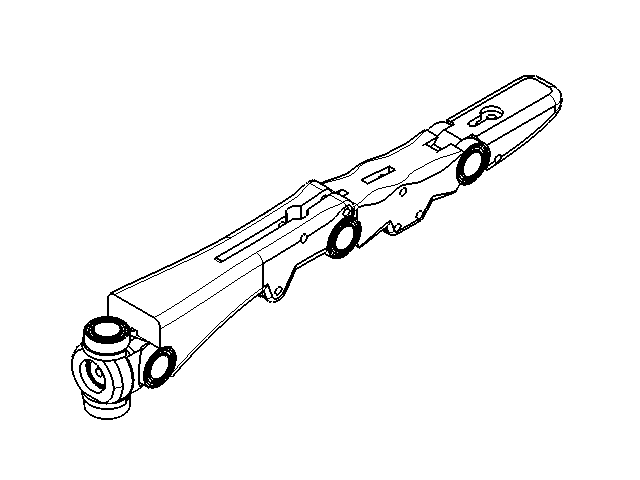
[picture p356: CAD file, 2025-06-29]
大拇指/大拇指.SLDASM
大拇指尖
大拇指中
大拇指腹
大拇指上底
大拇指下底
6x10x3 x 9
