18871379330/mydexhand/手腕/手腕.SLDASM

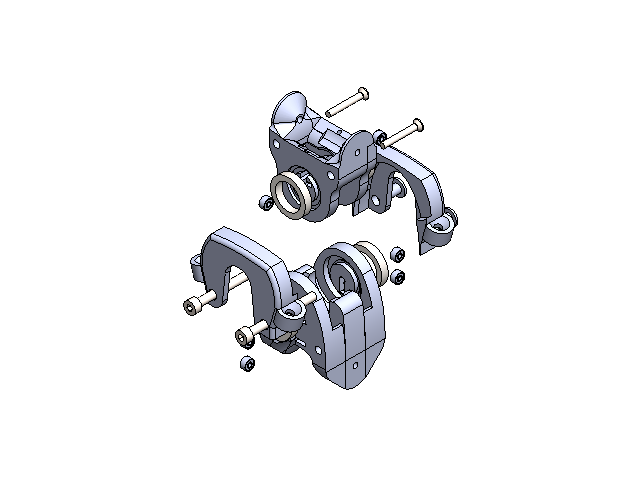
[picture p357: CAD file, 2025-06-29]
手腕/手腕.SLDASM
M3螺丝 x 2
M4螺丝 x 2
手上腕
手下腕
2x6x3 x 6
15x21x4 x 4
套筒螺母 x 2
手腕壳 x 2
