18871379330/mydexhand/手/手固定绳.SLDASM

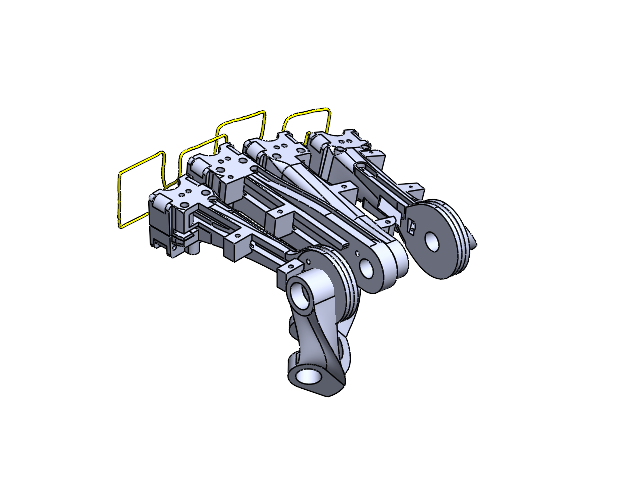
[picture p358: CAD file, 2025-05-09]
手/手固定绳.SLDASM
食指掌
无名指掌
小指掌
中指掌
掌固定绳
