18871379330/mydexhand/(list of files, cad)

Other CAD files:
大拇指/大拇指尖.SLDPRT
打印文件/fingers-thumb/ring/RING_Tip.stl
打印文件/wrist/Distal-Wrist-Clip-Top.stl
提交附件/打印文件/fingers-thumb/ring/RING_PLP.stl
中指/中指腹.SLDPRT
小指/输出近端.SLDPRT
提交附件/打印文件/fingers-thumb/ring/RING_Tip.stl
模具/模具2.SLDPRT
中指/Emax舵机.SLDPRT
大拇指/大拇指下底.SLDPRT
手/大拇指弹簧件.SLDPRT
打印文件/fingers-thumb/pinky/PINKY_PLP.stl
打印文件/fingers-thumb/ring/RING_PLP.stl
无名指/无名指尖.SLDPRT
小指/Emax舵机.SLDPRT
提交附件/打印文件/fingers-thumb/pinky/PINKY_PLP.stl
提交附件/打印文件/fingers-thumb/ring/RING_Bulk_Cover.stl
无名指/无名指腹.SLDPRT
中指/输出近端.SLDPRT
大拇指/大拇指中.SLDPRT
中指/中指中.SLDPRT
中指/中指尖.SLDPRT
中指/中指底.SLDPRT
大拇指/大拇指上底.SLDPRT
小指/小指尖.SLDPRT
小指/小指底.SLDPRT
手/384轴承.SLDPRT
手/Thumb_Tendon_Hanger_03a.SLDPRT
手/被抓件.SLDPRT
手腕/2x6x3轴承.SLDPRT
手腕/M4螺丝.SLDPRT
手腕/套筒螺母.SLDPRT
打印文件/fingers-thumb/index/INDEX_Bulk.stl
打印文件/fingers-thumb/pinky/PINKY_MLP.stl
打印文件/fingers-thumb/ring/RING_Bulk_Cover.stl
打印文件/tendon-spools/SPOOL_Large_Right_8个.stl
打印文件/tendon-spools/SPOOL_Wrist_01_2个.stl
打印文件/wrist/Distal_Wrist_Top.stl
提交附件/打印文件/fingers-thumb/index/INDEX_Bulk.stl
提交附件/打印文件/fingers-thumb/pinky/PINKY_MLP.stl
提交附件/打印文件/tendon-spools/SPOOL_Large_Right_8个.stl
提交附件/打印文件/tendon-spools/SPOOL_Wrist_01_2个.stl
提交附件/打印文件/wrist/Distal-Wrist-Clip-Top.stl
提交附件/打印文件/wrist/Distal_Wrist_Top.stl
无名指/Emax舵机.SLDPRT
无名指/无名指中.SLDPRT
无名指/输出近端.SLDPRT
模具/模具2.STL
食指/2_12.SLDPRT
食指/8字绳.SLDPRT
食指/Emax舵机.SLDPRT
食指/PVDF.SLDPRT
食指/弹簧固定线.SLDPRT
食指/手指牵引绳.SLDPRT
食指/拇指悬挂件.SLDPRT
食指/输出近端.SLDPRT
食指/食指中.SLDPRT
食指/食指尖.SLDPRT
食指/食指底.SLDPRT
食指/食指掌.SLDPRT
食指/食指腹.SLDPRT
