18871379330/mydexhand/STS3032舵机资料/2-调试软件、助手、例程/舵机十六进制指令-串口调试助手/电位器SCS-十六进制指令生成表_220402.xlsx

 |  | 将以下生成十六进制指令复制出来到TXT文档中清除格式，然后再复制到串口助手发送
 |  | PING 总线上舵机指令生成
 |  |  |  |  |  |  | 输入范围
PING ID |  |  |  | 输入控制参数 |  | 十进制输入 | SCS
 |  |  |  | ID号 |  | 1 | 0-253
 |  |  |  | PING指令 |  | 1
 |  | SCS系列 | 包头 |  | ID号 | 指令包数据长度 | 指令 | 校验码
 |  | 十六进制 | FF | FF | 01 | 02 | 01 | FB
 |  | 十进制 | 255 | 255 | 1 | 2 | 1 | 251
 |  | 生成十六进制指令 | FF FF 01 02 01 FB
修改ID | 第一步 | 修改ID前需要发此解锁指令，否则ID号掉电不保存
 |  |  |  |  |  |  | 输入范围
 |  |  |  | 输入控制参数 |  | 十进制输入
 |  |  |  | ID号 |  | 1 | 0-254 | 广播ID为254
 |  |  |  | 写指令 |  | 3
 |  |  |  | 锁标志首地址 |  | 48 | 上锁 | 解锁
 |  |  |  | 写入数值 |  | 0 | 1 | 0
 |  | 修改ID解锁写指令
 |  | SCS系列 | 包头 |  | ID号 | 指令包数据长度 | 指令 | 写入首地址 | 写入数值 | 校验码
 |  | 十六进制 | FF | FF | 01 | 04 | 03 | 30 | 00 | C7
 |  | 十进制 | 255 | 255 | 1 | 4 | 3 | 48 | 0 | 199
 |  | 生成十六进制指令 | FF FF 01 04 03 30 00 C7
 | 第二步 | 修改ID号指令生成
 |  |  |  | 修改ID号指令 |  |  | 输入范围
 |  |  |  | 输入控制参数 |  | 十进制输入
 |  |  |  | ID号 |  | 1 | 0-254 | 广播ID为254
 |  |  |  | 写指令 |  | 3
 |  |  |  | ID首地址 |  | 5
 |  |  |  | 写入数值 |  | 2 | 0-253
 |  | 修改ID号写指令
 |  | SCS系列 | 包头 |  | ID号 | 指令包数据长度 | 指令 | 写入首地址 | 写入数值 | 校验码
 |  | 十六进制 | FF | FF | 01 | 04 | 03 | 05 | 02 | F0
 |  | 十进制 | 255 | 255 | 1 | 4 | 3 | 5 | 2 | 240
 |  | 生成十六进制指令 | FF FF 01 04 03 05 02 F0
控制位置 | 第一步 | 位置模式控制转动指令(无加速度)
 |  |  |  |  |  |  | 输入范围
 |  |  |  | 输入控制参数 |  | 十进制输入 | SCS系列
 |  |  |  | ID号 |  | 2 | 0-253
 |  |  |  | 写指令 |  | 3 |  | 单位(Unit)
 |  |  |  | 目标位置 |  | 1000 | 0-1023 | 0.3125
 |  |  |  | 时间 |  | 0 | 0-5000 | 1ms |  | PWM模式
 |  |  |  | 目标速度 |  | 1000 | 0-2300 | 1000=52rpm | 1000 | 312.5 | 52.08333333 | rpm
 |  | SCS系列 | 包头 |  | ID号 | 指令包数据长度 | 指令 | 写入首地址 | 位置高字节 | 位置低字节 | 时间高字节 | 时间低字节 | 速度高字节 | 速度低字节 | 校验码
 |  | 十六进制 | FF | FF | 02 | 09 | 03 | 2A | 03 | E8 | 00 | 00 | 03 | E8 | F1
 |  | 十进制 | 255 | 255 | 2 | 9 | 3 | 42 | 3 | 232 | 0 | 0 | 3 | 232 | 241
 |  | 生成十六进制指令 | FF FF 02 09 03 2A 03 E8 00 00 03 E8 F1
读取位置 | 第二步 | 发送读位置指令
 |  |  |  |  |  |  | 输入范围
 |  |  |  | 输入控制参数 |  | 十进制输入 | SCS
 |  |  |  | ID号 |  | 2 | 0-254
 |  |  |  | 读指令 |  | 2
 |  |  |  | 首地址 |  | 56
 |  |  |  | 字节数 |  | 2
 |  | 读位置指令
 |  | SCS系列 | 包头 |  | ID号 | 指令包数据长度 | 指令 | 写入首地址 | 字节数 | 校验码
 |  | 十六进制 | FF | FF | 02 | 04 | 02 | 38 | 02 | BD
 |  | 十进制 | 255 | 255 | 2 | 4 | 2 | 56 | 2 | 189
 |  | 生成十六进制指令 | FF FF 02 04 02 38 02 BD
电机模式 | 第一步 | 电机模式需要修改最小角度限制为0
 |  |  |  |  |  |  | 输入范围
 |  |  |  | 输入控制参数 |  | 十进制输入 | SCS
 |  |  |  | ID号 |  | 2 | 0-254
 |  |  |  | 写指令 |  | 3
 |  |  |  | 首地址 |  | 9
 |  |  |  | 最大角度限制 |  | 0 | 0-1022
 |  | 修改最小角度限制为0写指令
 |  | SCS系列 | 包头 |  | ID号 | 指令包数据长度 | 指令 | 写入首地址 | 高字节 | 低字节 | 校验码
 |  | 十六进制 | FF | FF | 02 | 05 | 03 | 09 | 00 | 00 | EC
 |  | 十进制 | 255 | 255 | 2 | 5 | 3 | 9 | 0 | 0 | 236
 |  | 生成十六进制指令 | FF FF 02 05 03 09 00 00 EC
 | 第二步 | 电机模式需要修改最大角度限制为0
 |  |  |  |  |  |  | 输入范围
 |  |  |  | 输入控制参数 |  | 十进制输入 | SCS
 |  |  |  | ID号 |  | 2 | 0-254
 |  |  |  | 写指令 |  | 3
 |  |  |  | 首地址 |  | 11
 |  |  |  | 最大角度限制 |  | 0 | 0-1023
 |  | 修改最大角度限制为0写指令
 |  | SCS系列 | 包头 |  | ID号 | 指令包数据长度 | 指令 | 写入首地址 | 高字节 | 低字节 | 校验码
 |  | 十六进制 | FF | FF | 02 | 05 | 03 | 0B | 00 | 00 | EA
 |  | 十进制 | 255 | 255 | 2 | 5 | 3 | 11 | 0 | 0 | 234
 |  | 生成十六进制指令 | FF FF 02 05 03 0B 00 00 EA
 | 第三步 | 发送正反转速度指令生成
 | 重复 |  |  |  |  |  | 输入范围
 |  |  |  | 输入控制参数 |  | 十进制输入 | SCS
 |  |  |  | ID号 |  | 2 | 0-254
 |  |  |  | 写指令 |  | 3
 |  |  |  | 首地址 |  | 44 | 正转 | 反转 |  | 停止
 |  |  |  | 最大角度限制 |  | 1 | 10-1000 | （10-1000）+1024 |  | 0
 |  | SCS系列 | 包头 |  | ID号 | 指令包数据长度 | 指令 | 写入首地址 | 高字节 | 低字节 | 校验码
 |  | 十六进制 | FF | FF | 02 | 05 | 03 | 2C | 00 | 01 | C8
 |  | 十进制 | 255 | 255 | 2 | 5 | 3 | 44 | 0 | 1 | 200
 |  | 生成十六进制指令 | FF FF 02 05 03 2C 00 01 C8
同步写 |  | 位置模式同步写位置转动指令
 |  |  |  | 输入控制参数 |  | 十进制输入 |  |  | I
 |  |  |  | 同步写ID号 |  | 254
 |  |  |  | 同步写指令 |  | 131
 |  |  |  | 同步写首地址 |  | 42
 |  |  |  | 同步写字节数 |  | 6
 |  |  |  |  |  |  | 舵机ID1 | 舵机ID2 | 舵机ID3 | 舵机ID4
 |  |  |  |  | 舵机ID |  | 1 | 11 | 12 | 13
 |  |  |  |  | 目标位置 |  | 1000 | 100 | 511 | 511
 |  |  |  |  | 时间 |  | 0 | 0 | 0 | 0
 |  |  |  |  | 目标速度 |  | 1000 | 1000 | 1000 | 1000
 |  | SCS系列 | 包头 |  | ID号 | 指令包数据长度 | 指令 | 写入首地址 | 写字节数 | 舵机ID | 位置高字节 | 位置低字节 | 时间高字节 | 时间低字节 | 速度高字节 | 速度低字节 | 校验码
 |  | 十六进制 | FF | FF | FE | 20 | 83 | 2A | 06 | 01 | 03 | E8 | 00 | 00 | 03 | E8 | 0E
 |  | 十进制 | 255 | 255 | 254 | 32 | 131 | 42 | 6 | 1 | 3 | 232 | 0 | 0 | 3 | 232 | 14
 |  |  |  |  |  |  |  |  | 十六进制 | 0B | 00 | 64 | 00 | 00 | 03 | E8
 |  |  |  |  |  |  |  |  | 十进制 | 11 | 0 | 100 | 0 | 0 | 3 | 232
 |  |  |  |  |  |  |  |  | 十六进制 | 0C | 01 | FF | 00 | 00 | 03 | E8
 |  |  |  |  |  |  |  |  | 十进制 | 12 | 1 | 255 | 0 | 0 | 3 | 232
 |  |  |  |  |  |  |  |  | 十六进制 | 0D | 01 | FF | 00 | 00 | 03 | E8
 |  |  |  |  |  |  |  |  | 十进制 | 13 | 1 | 255 | 0 | 0 | 3 | 232
 |  | 生成十六进制指令 | FF FF FE 20 83 2A 06 01 03 E8 00 00 03 E8 0B 00 64 00 00 03 E8 0C 01 FF 00 00 03 E8 0D 01 FF 00 00 03 E8 0E
