18871379330/mydexhand/毕业材料/系统外查重报告.pdf

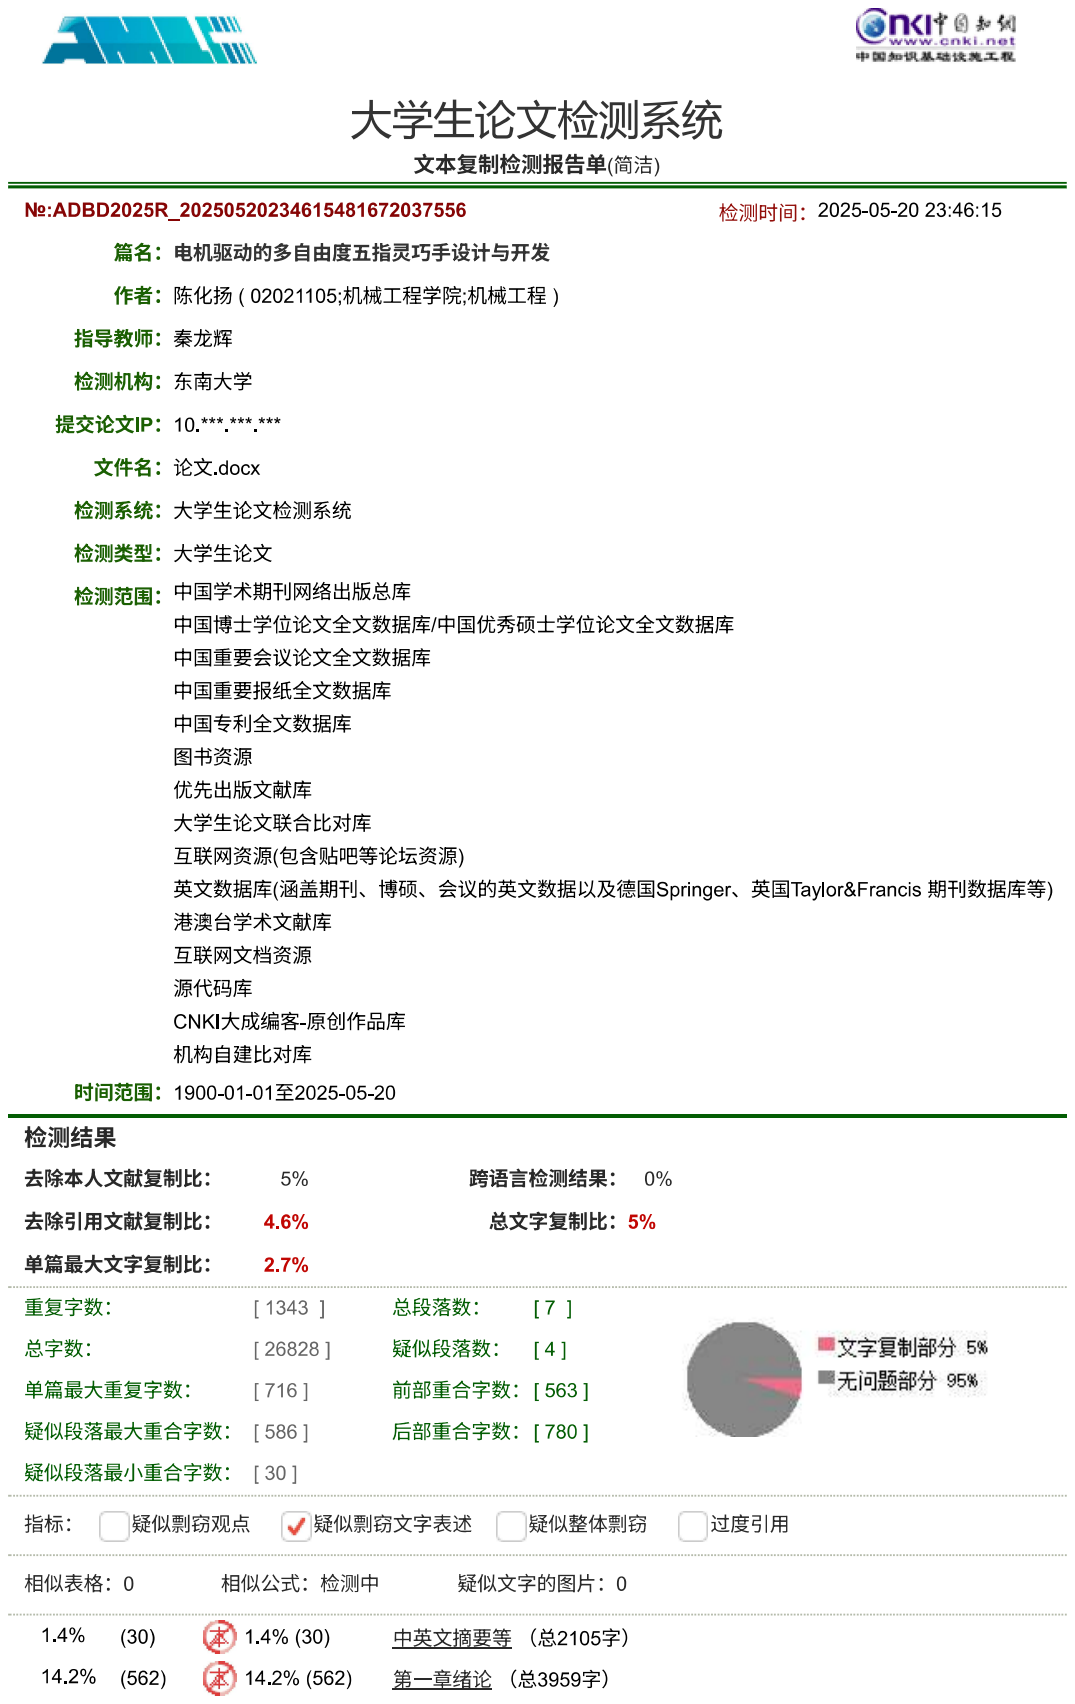
[picture p359: page 1]

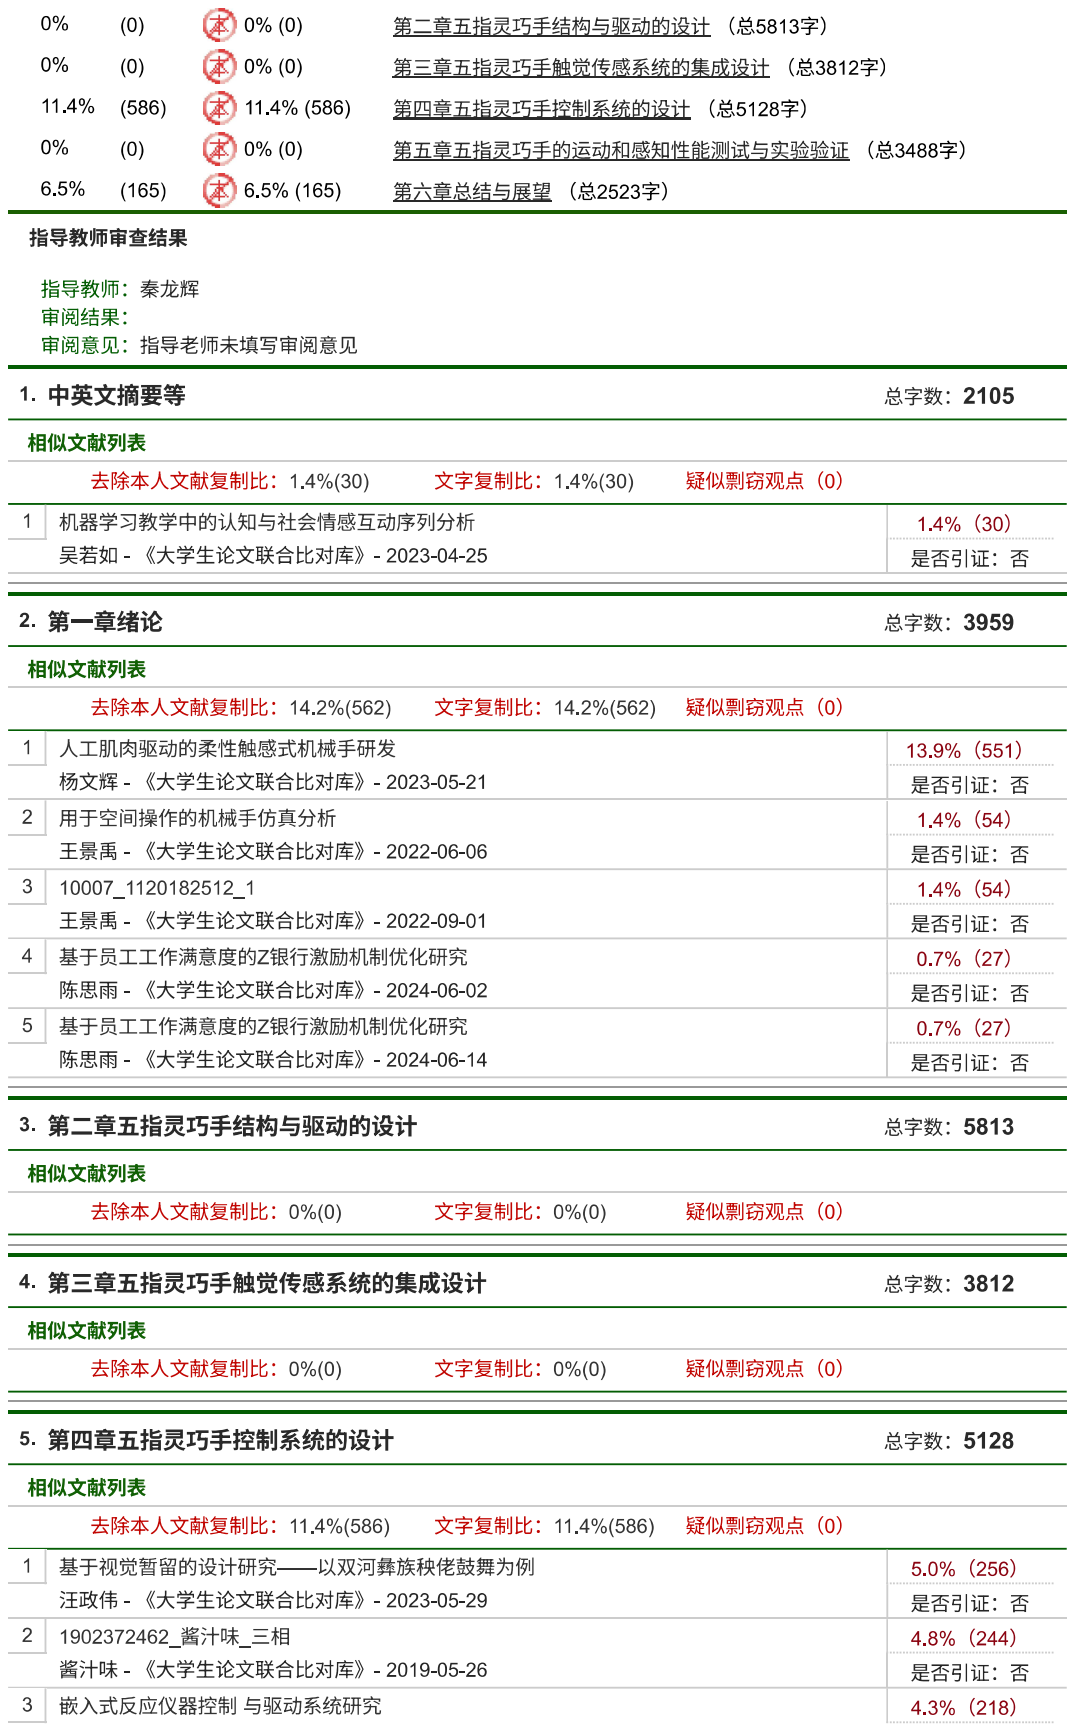
[picture p360: page 2]

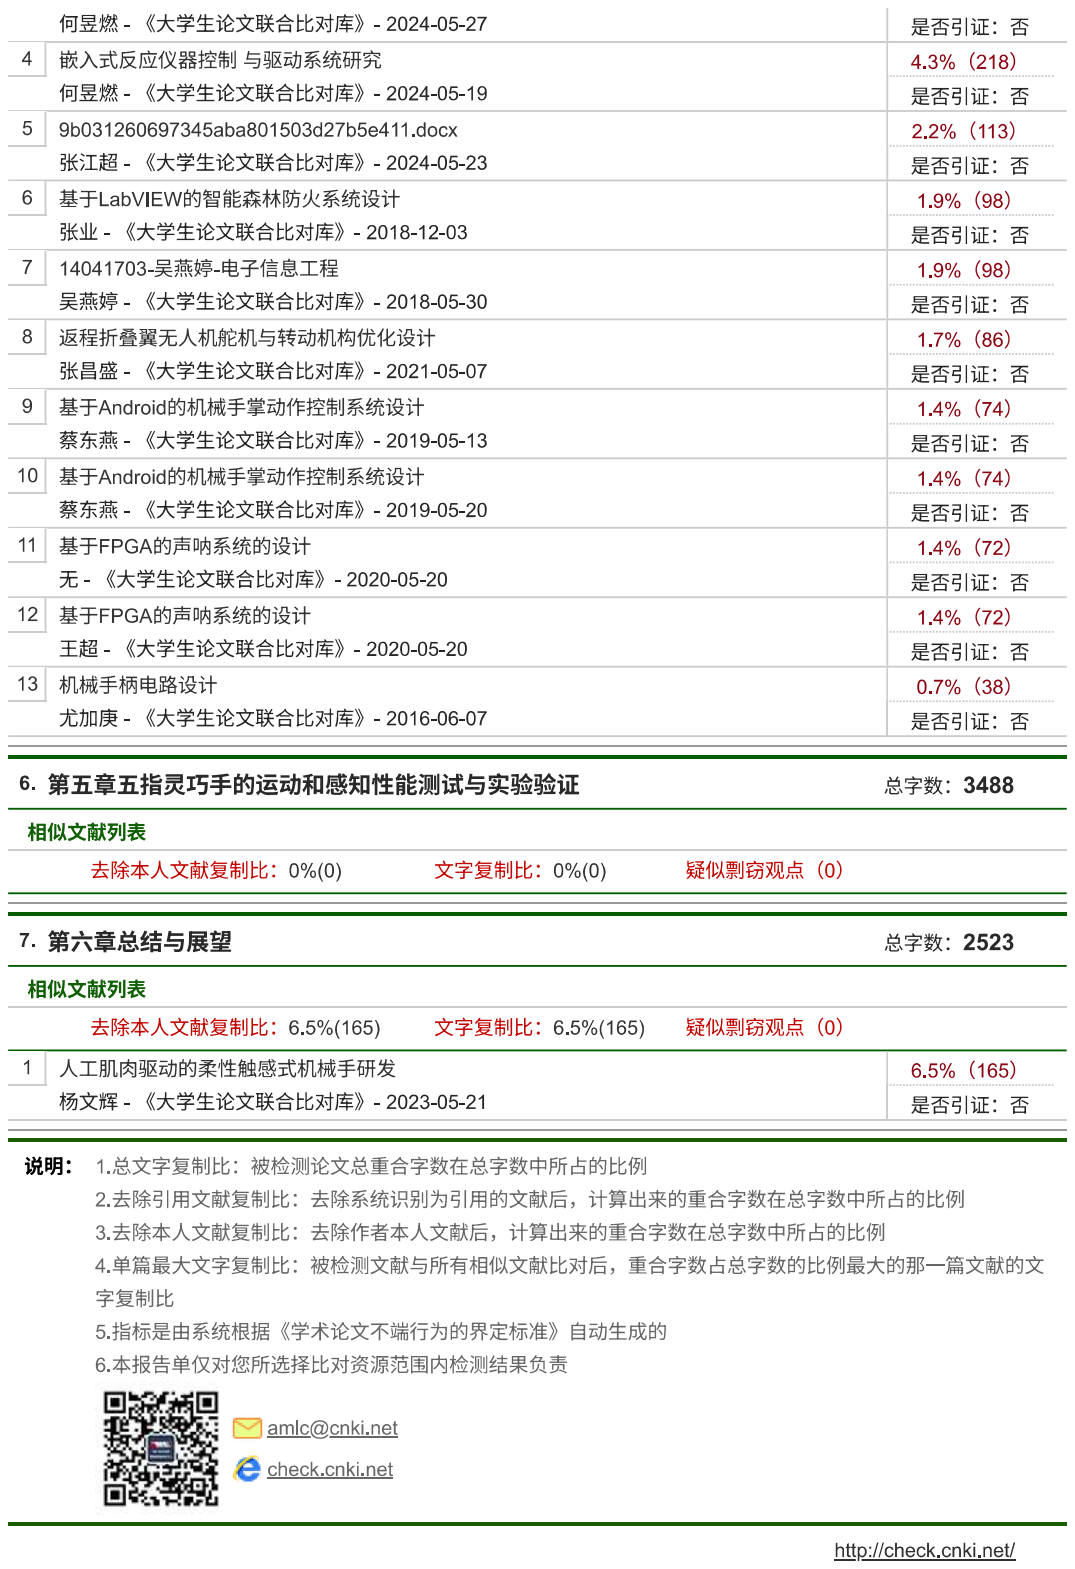
[picture p361: page 3]
