18871379330/mydexhand/报销/毕设/毕设报销单.pdf

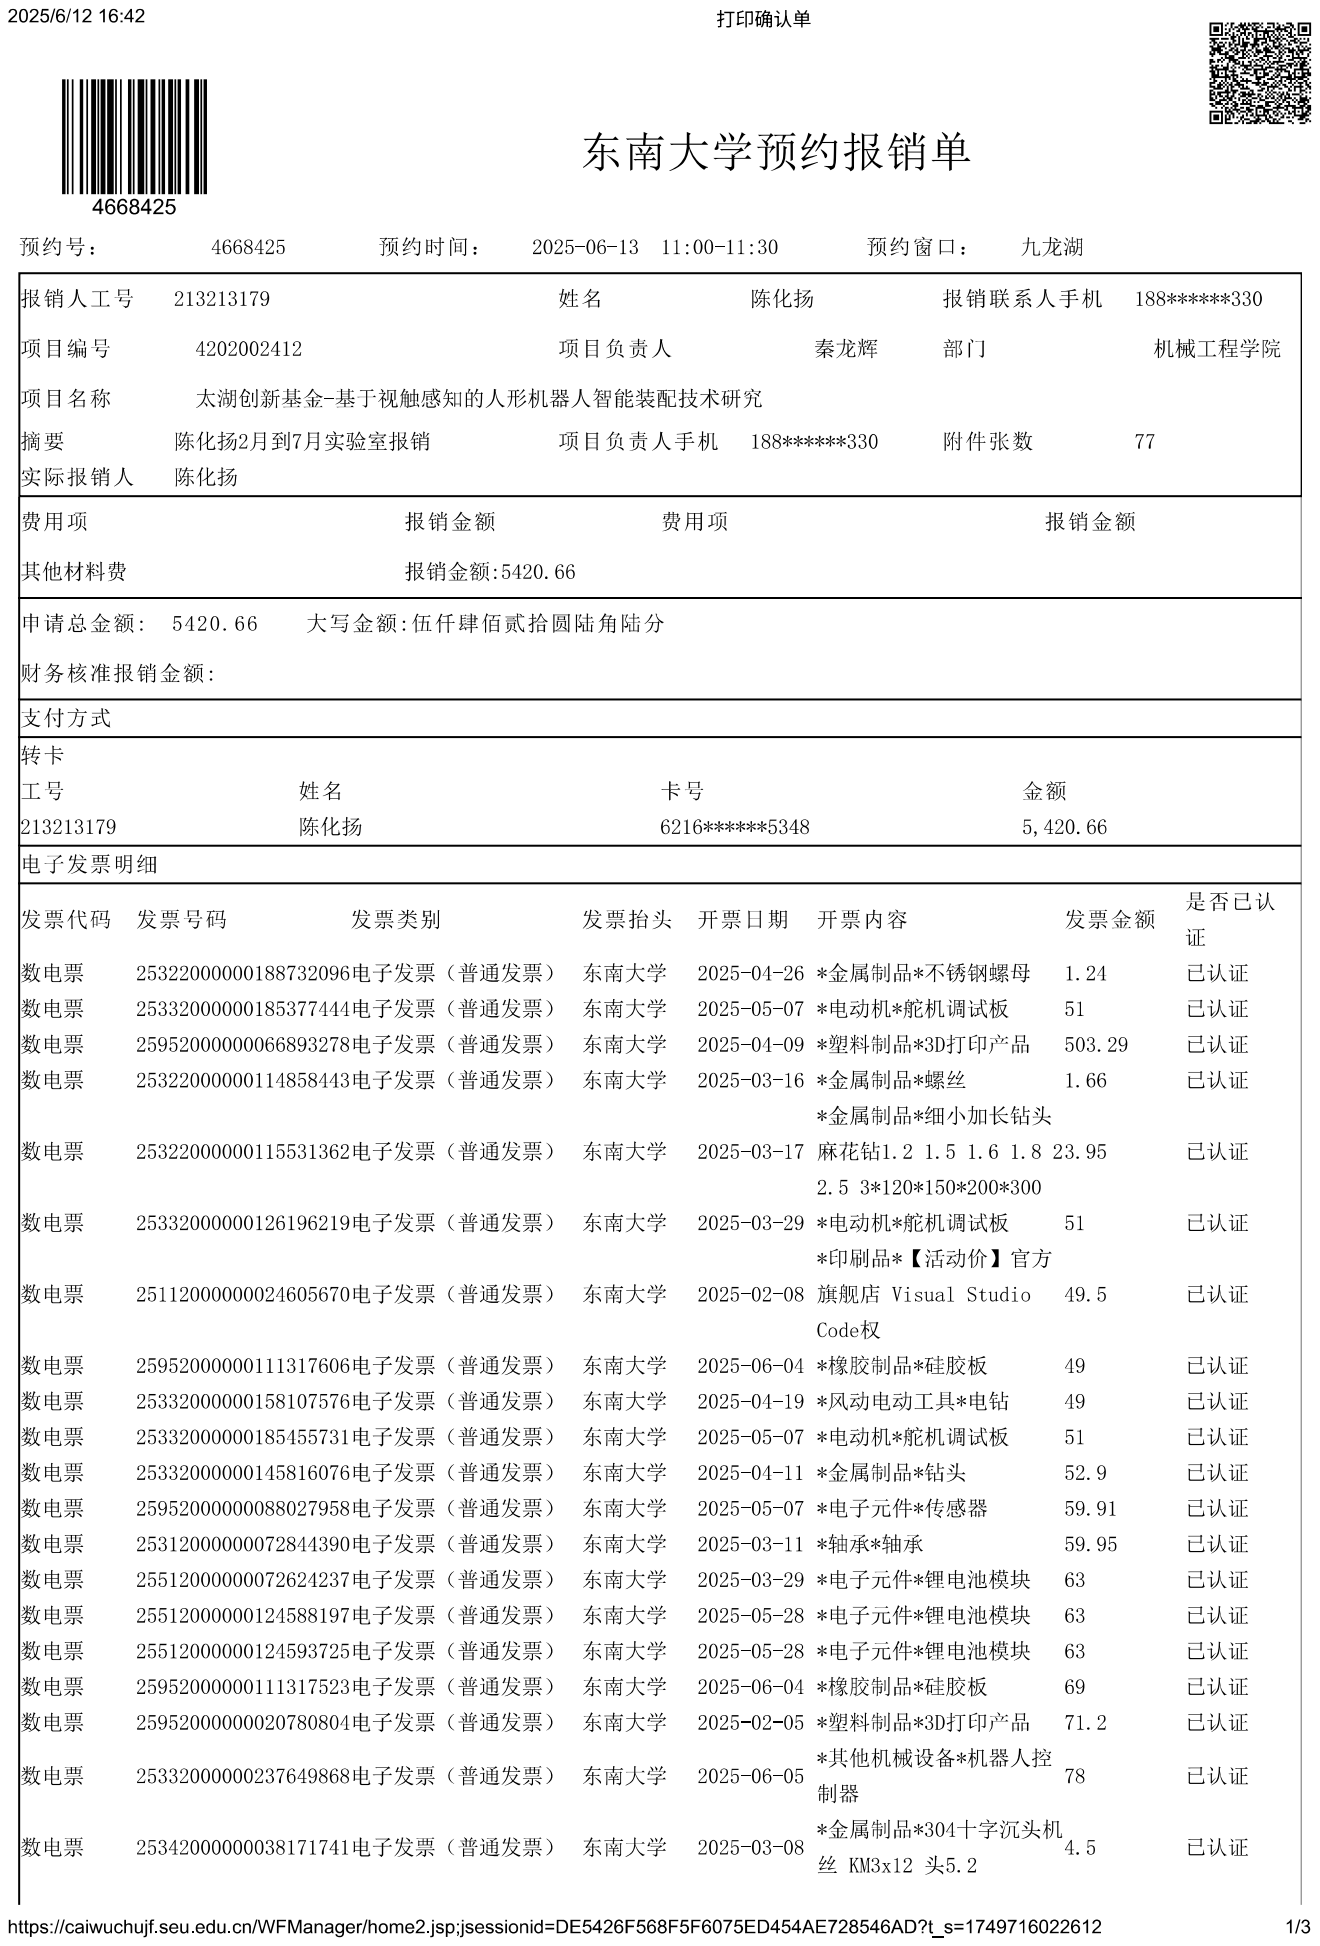
[picture p362: page 1]
契约锁

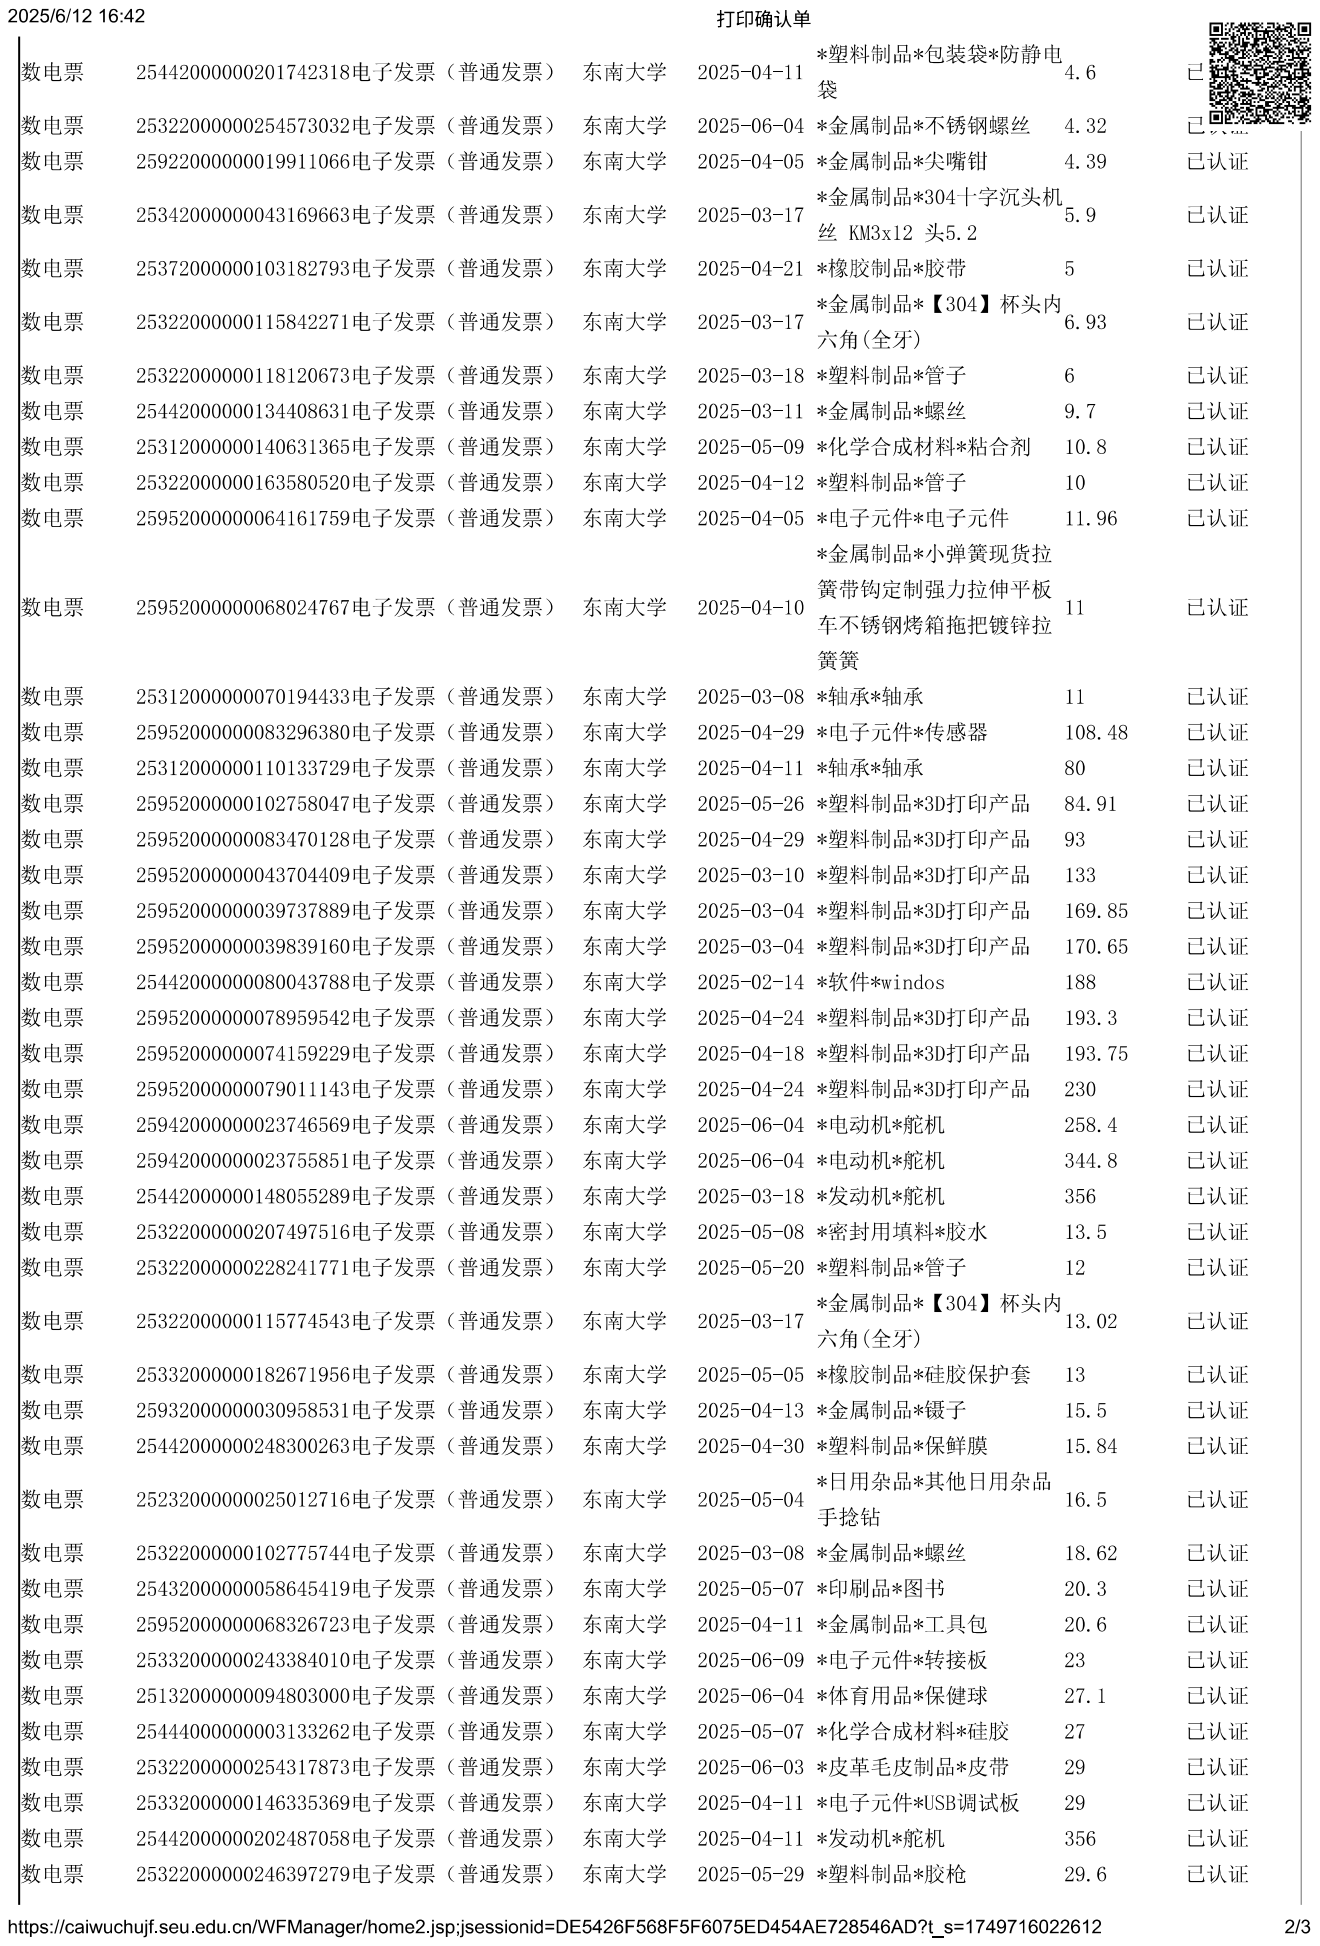
[picture p363: page 2]

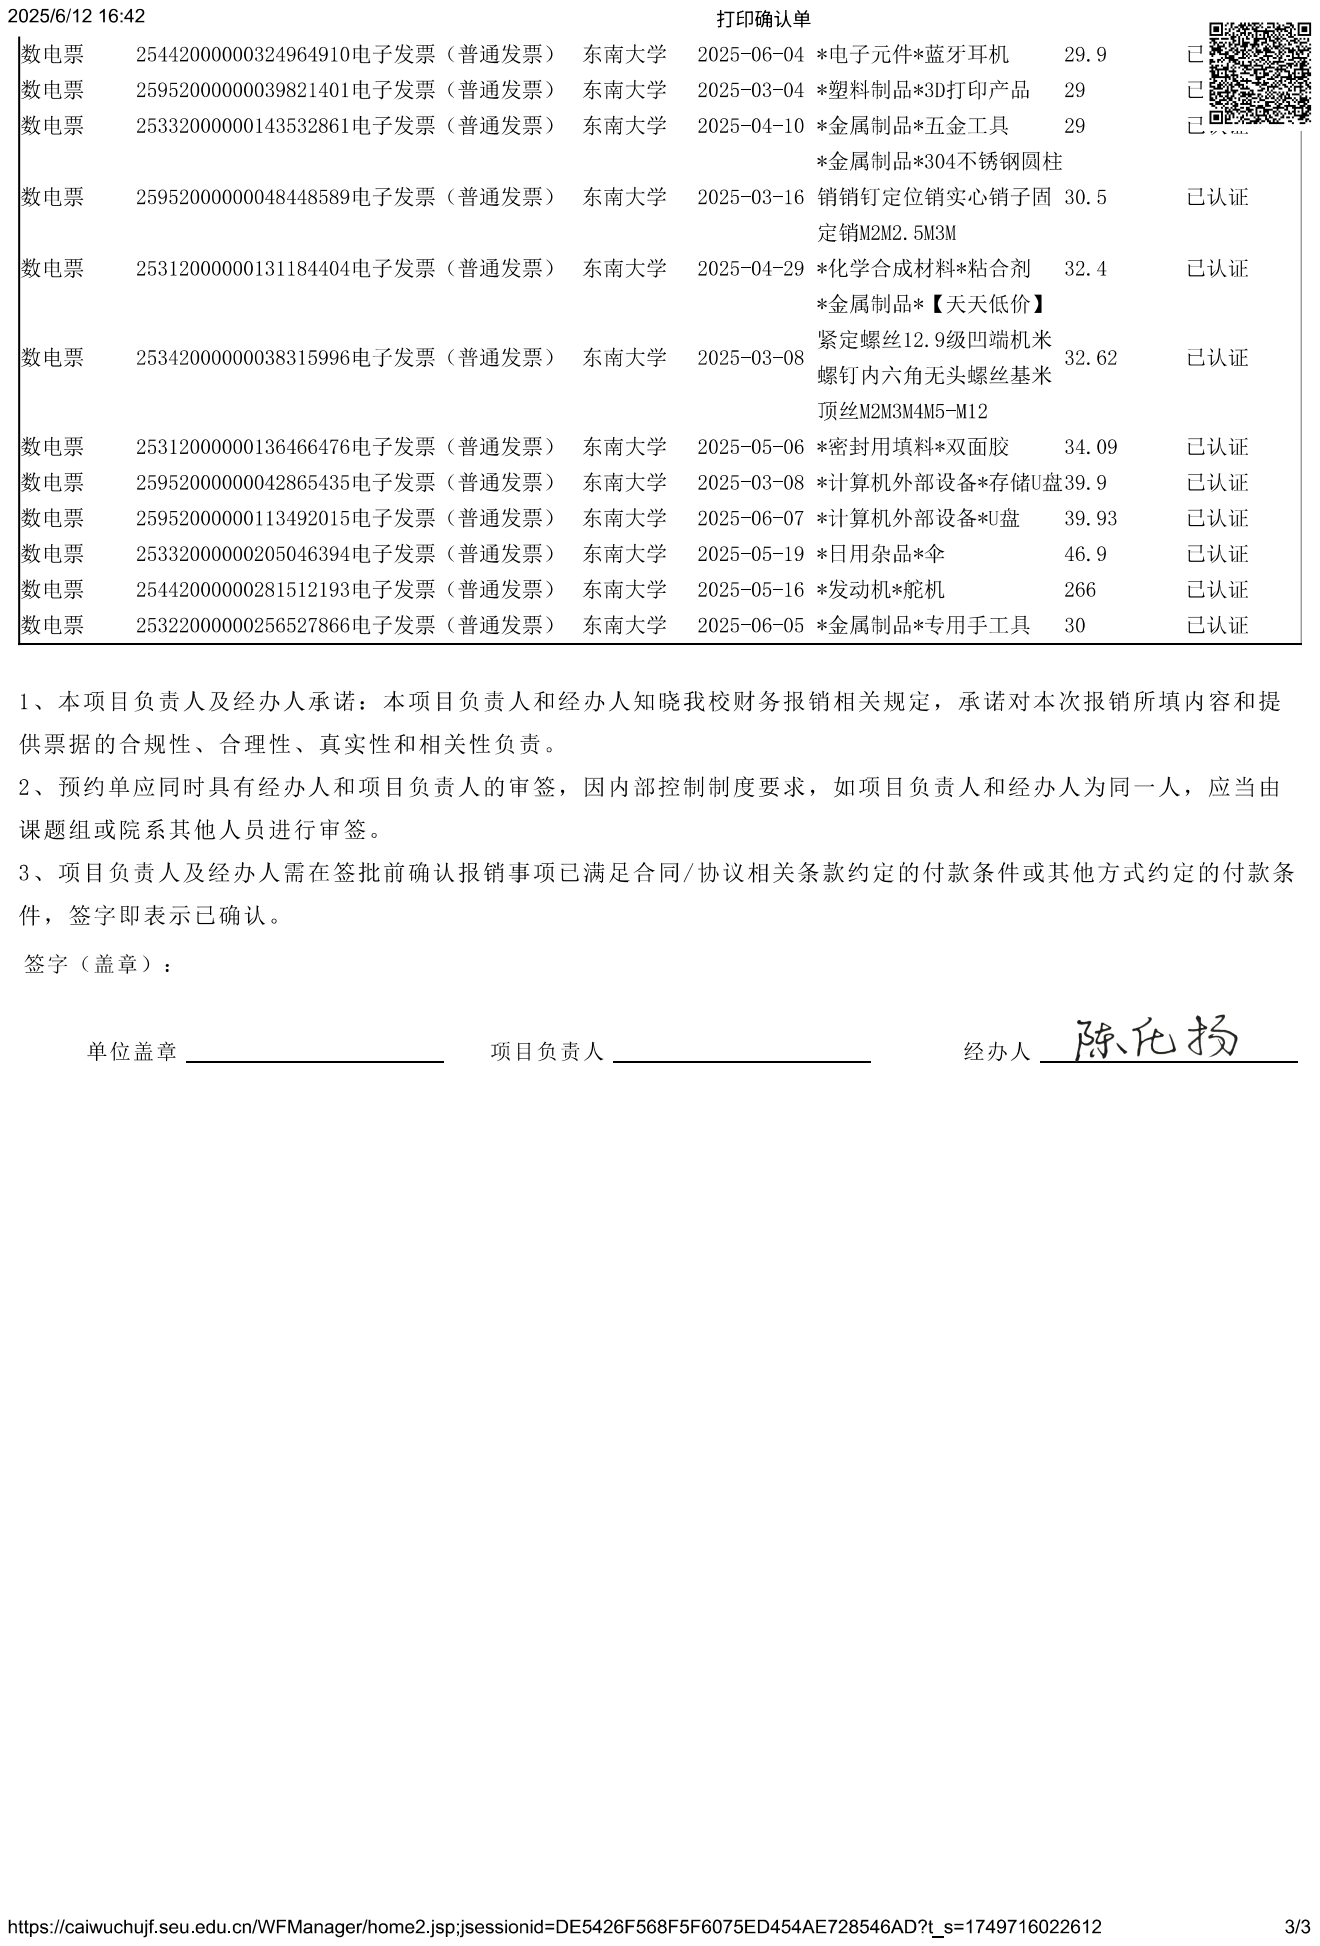
[picture p364: page 3]
