18871379330/mydexhand/(commit log)

2025-02-11 my first commit in 2025/2/11/12:31
    [15x21x4轴承.SLDPRT, 2x6x3轴承.SLDPRT, 384轴承.SLDPRT, 6x10x3轴承.SLDPRT, Emax舵机.SLDPRT, M3螺丝.SLDPRT, M4螺丝.SLDPRT, 中指.SLDASM]
2025-02-11 grasp action
    [中指.SLDASM, 大拇指.SLDASM, 小指.SLDASM, 手.SLDASM, 手腕.SLDASM, 无名指.SLDASM, 被抓件.SLDPRT, 食指.SLDASM]
2025-02-11 手模型更新2025/2/11/20:33
    [中指.SLDASM, 小指.SLDASM, 手.SLDASM, 无名指.SLDASM, 食指.SLDASM]
2025-02-15 ppt和报告
2025-02-16 还没做完
2025-02-18 修改ppt
2025-02-19 又一次ppt修改
2025-02-20 开题前一晚修改
    [中指.SLDASM, 大拇指.SLDASM, 小指.SLDASM, 手.SLDASM, 无名指.SLDASM, 食指.SLDASM]
2025-02-20 开题答辩当天提交
2025-03-30 3.3014.25提交
    [Thumb_Tendon_Hanger_03a.SLDPRT, UartAssist.cfg, 大拇指弹簧件.SLDPRT, 大拇指弹簧件.STL, 手.SLDASM, 手腕底.STL, 电位器SCS-内存表解析_220402.xlsx, 电位器SCS-十六进制指令生成表_220402.xlsx]
2025-05-09 论文初稿写完了
    [2_12.SLDPRT, 8字绳.SLDPRT, Back_of_Hand_23a（带）.STL, Distal-Wrist-Clip-Bot.stl, Distal-Wrist-Clip-Top.stl, Distal_Wrist_Bot.stl, Distal_Wrist_Top.stl, Emax_23mm_03舵机.SLDPRT]
2025-05-21 2025/5/21提交
2025-06-29 6\29专利修改
    [大拇指.SLDASM, 手腕.SLDASM, 手臂装配体.SLDASM]
2025-07-20 7：20
